ripclap/rm520n-carrier/manufacturing/rev-a/requirements/FAB_CURRENT_HOLE_COVER_REQUIREMENTS1248.txt

RM520N Carrier Rev A — fabrication/assembly requirements for the current physical board

Physical PCB SHA256: 1e1c08f8d13c7cdec4f65c9a95c2adc67a2a7758db29563f2e71c7588dd6bd23
Source: hardware/rev-a/carrier.kicad_pro
Use FAB_ALL1161_HOLE_SITE_SCHEDULE1243.csv, factory-site-schedule1248.json and mask-cover-owner1248.json with the matching Gerbers, drills, stack, assembly outputs and exact BOM. These are requested job/CAM acceptance conditions. No supplier has accepted the complete job. Final source-policy, finished-copper power and commissioning sign-off are separate from this physical schedule.

1. Actual drilling and covering
The current board contains 1,161 drilled sites: 1,124 vias, 24 solderable component PTHs, nine NPTHs, and four U10 EP49 thermal PTHs. The vias comprise 158 Type VII nonconductive filled holes with copper caps on both faces and 966 ordinary unfilled/uncapped continuous bilateral soldermask tents. The four U10 thermal PTHs separately require Type VII closed bilateral caps, 625 µm lands/300 µm nominal holes, their existing front EP49 solder interface, closed back mask and no back paste. KiCad pad metadata does not encode the thermal PTH fill/cap process. Do not treat component slots or NPTHs as ordinary vias, or resize/shift any site without a reviewed job revision.

2. Site-specific finished bores
The 81 nominal 150 µm vias are differentiated: 25 have 400 µm lands and requested finished bores 70–170 µm; 55 have 460 µm lands and 70–230 µm; one OE site has a 450 µm land and 70–220 µm. Retain the named ordinary 450/200 µm site profiles of finished 120–220 µm in the schedule. The sole new direct-V12 550/200 µm site 9ee37410-49af-5bbc-b978-d716eac22bde at (52.7,46.0) mm requests finished 120–280 µm. That bound does not apply to other nominal 200 µm sites.
For sites without a separately qualified interval, propose and record an exact compatible finished-bore, drilling, registration, etch and plating recipe. The public nominal ±80 µm values and the calculated 26 µm radial etch/35 µm registration corners are diagnostics, not an accepted blanket process or simultaneous supplier guarantee. Require actual finished annulus at least 50 µm on every copper layer, no breakout, and minimum LOCAL barrel plating wall 20 µm. Average wall thickness is insufficient. The electrical 18 µm sensitivity calculation is not the default fabrication requirement. Use representative microsections/coupons and complete electrical test. Preserve actual source conductors and return/reference planes when compensating artwork.

3. Coupled U4 VIN pair — mandatory exact local CAM recipe
Both sites remain Type VII filled and capped. First: 0b2860c5-bf78-44cb-b484-aeb19c71f110 at (60.20,72.85) mm, 450 µm land/200 µm nominal drill, requested finished 120–220 µm. Second: 1fd58c91-691e-4cd1-8f90-30b6df1de5e5 at (60.70,72.75) mm, 400 µm land/150 µm nominal drill, requested finished 70–170 µm.
The engineering coupled process witness requests each drill-position error ≤30 µm independently in X/Y, raw before-plating maximum diameters 250/200 µm respectively, and minimum local wall 20 µm. Achieved finished maximum diameters are then 210/160 µm, inside the requested intervals. Worst relative centre spacing is 441.815 µm; subtracting 225 µm raw radii leaves 216.815 µm raw web, above the 206 µm local guard. Obtain explicit supplier CAM/coupon acceptance of this complete coupled box and all-six-layer measured annuli. Generic doubled raw-tool envelopes overlap this pair and remain diagnostic; they are not the accepted witness. Preserve the U4 VIN6 front mask/paste interface and no back paste. TI RPU0010A has no positive minimum A1 standoff; qualify actual flat-cap solder seal, mask and underside seating rather than assuming 45 µm package clearance.

4. Actual mask, paste and underside interfaces
The four actual exported mask/paste layers are checked for all 1,124 vias. The 966 ordinary lands are nominally closed on both faces and paste-free. The 158 capped sites allow only their listed exact same-net owner-terminal apertures; there are no standalone via stencil windows or unowned apertures. Keep all existing solderable component apertures. Nominal Gerber closure is not proof of sealed covering after actual registration and reflow.
Type VII caps must be bilaterally closed, with qualified flatness/proudness at most 10 µm. Ordinary mask peaks and mask above caps must be at most 25 µm above the corresponding adjacent finished copper/cap. For a listed underbody cover, retain at least 10 µm actual clearance to the cover; an unknown/zero-standoff non-owner body requires measured underside clearance of at least 35 µm for ordinary mask or 45 µm for a 10 µm cap plus 25 µm mask. An actual solder-owner terminal instead requires its exact qualified flat-cap/solder-seal/stencil/seating contract, including the U4 pair above. Confirm actual front/back plastic, leads, seating and mask integrity. A body/courtyard projection is not itself a foreign-metal collision; mask or caps cannot waive foreign pad/copper/raw-bore gaps, annuli or source/reference conditions.

5. Ordinary large bores and raw-tool diagnostics
Exactly 155 of the original 166 prelisted ordinary Type VI fallback sites remain on this board; eleven were retired. All Type VI overrides remain INACTIVE. Accept ordinary tenting only with documented continuous bilateral cover under the actual bore, land, registration and reflow conditions. If the selected supplier cannot qualify a listed ordinary site, only an explicitly recorded UUID/job change may activate its nonconductive fill plus bilateral mask fallback; it does not add copper caps. Record the exact process/metadata change, preserve all physical/source constraints, re-export/review mask and paste, and verify flatness/underside seating. The original special large-bore Type VII sites retain their caps.
The seven ancestral special doubled raw-growth diagnostic pairs are listed in seven-raw-tool-rebind1248.json. Rebind their exact unchanged site/neighbor geometry to this board. Their nominal bores are distinct; the conservative envelope result is not a measured fabricated defect. Obtain actual correlated raw-drill/web and annular CAM/microsection acceptance. Covering does not remove this requirement. The U4 coupled pair has the separate explicit local recipe in section 3. Do not use the seven-row list as a census of every possible whole-board raw-tool diagnostic.

6. Meaningful retained copper and the two native warnings
Preserve all seven reinstated 1.5 mm In2 V12 force tracks from (40.75,44.25) through the existing chain to (11.15,45.9) mm. They maintain the required finished-copper input path under etch/bore limits; nominal connectivity through other layers does not replace that low-loss path.
The current native board has two warnings and zero errors/opens. The PASSIVE_BUCK_IN track 25bdecc5-6998-5fe8-9286-4277a934723d remains a real R727 damping collector. Its nominal hole-clipped overlap with the R727.1 PTH annulus is 0.301931584 mm², with two retained backbone contacts. The endpoint-centre warning is not an open circuit. Preserve its exact collector and the qualified R727 pulse/RC/hot-case commissioning requirements.
The second warning is an attached B.Cu OOB_VDD_SPI cleft near (76.316229,9.139837) mm, guarded by the exact three conductors in warning-dispositions1248.json. It is not a detached copper fragment or demonstrated limiting neck. Review final CAM/AOI for an unintended bridged cleft or foreign short, and test flash startup/ripple/firmware. Do not delete a relied conductor or treat the nominal geometry assessment as supplier etch acceptance.

7. Stack, controlled geometry and first article
Use the specified JLC06161H-3313 six-layer nominal 1.6 mm ENIG stack, preserving layer separation and actual reference planes. Main outer-layer geometry is USB 90 Ω width/gap 0.136/0.150 mm; PCIe/REFCLK 85 Ω 0.154/0.150 mm; MDI 100 Ω 0.104/0.150 mm. The exact CABLE48 cohort uses 0.2906 mm front-source width and 0.4483 mm inner/J1-terminal width with 0.5999 mm gap, assigned to its reviewed layers/groups. Keep actual launch and transition geometries. Requested ±10% impedance-coupon acceptance is not a current supplier guarantee. Do not substitute a stack or compensate geometry without review.
Use the matching FABRICATION_AND_ASSEMBLY and FIRST_ARTICLE_TEST instructions for exact fitted MPNs, H1/mechanical assembly, the passive-input contract, power/current/RMS/thermal qualification, modem recovery, USB/2.5G Ethernet/RF tests and firmware. Native DRC, nominal/reference continuity and qualified package spacing do not establish impedance/eye/BER/compliance, dynamic modem voltage, factory process capability or final functional survival.
