ripclap/rm520n-carrier/manufacturing/rev-a/assembly/Factory-BOM-unpriced.csv

MPN | Manufacturer | Qty per board | Design value | References | Side | Assembly | Native footprint | LCSC in design
GRM155R71C104KA88D | Murata | 5 | 100nF 16V X7R 10% | C36, C38, C42, C101, C102 | B, F | SMT | Capacitor_SMD:C_0402_1005Metric
CL10B225KP8NNNC | Samsung Electro-Mechanics | 18 | 2.2uF10V X7R10% | C32, C37, C39, C44, C45, C46, C47, C48, C49, C50, C51, C52, C54, C55, C56, C118, C119, C210 | B, F | SMT | Capacitor_SMD:C_0603_1608Metric; carrier:Samsung_CL10_0603_Dense100_50_890 | C100082
GRM1555C1H270JA01D | Murata | 2 | 27pF 50V C0G 5% | C40, C41 | F | SMT | Capacitor_SMD:C_0402_1005Metric
C0402C391J5GACTU | KEMET | 1 | 390pF 50V C0G 5% | C58 | B | SMT | Capacitor_SMD:C_0402_1005Metric
C0805C102JAGACTU | KEMET | 2 | 1nF250V C0G5% | C59, C414 | B, F | SMT | Capacitor_SMD:C_0805_2012Metric
RHA0J471MCN1GS | Nichicon | 1 | 470uF 6.3V polymer | C100 | F | SMT | carrier:Nichicon_RHA_8x6.7_FPCAP
25SVPK82M | Panasonic | 1 | 82uF 25V polymer | C201 | F | SMT | Capacitor_SMD:CP_Elec_6.3x5.9
CL21B105KBFNNNF | Samsung Electro-Mechanics | 4 | 1uF50V10%X7R | C203, C710, C713, C986 | F | SMT | Capacitor_SMD:C_0805_2012Metric | C16195091
C0805C103K1RACTU | KEMET | 2 | 10nF 100V X7R 10% | C202, C205 | B, F | SMT | Capacitor_SMD:C_0805_2012Metric; carrier:C_0805_2012Metric_DenseRevA_C205
C0402C102K5RACTU | KEMET | 2 | 1nF 50V X7R 10% | C206, C987 | B, F | SMT | Capacitor_SMD:C_0402_1005Metric
C0402C332K5RACTU | KEMET | 1 | 3.3nF 50V X7R 10% | C207 | F | SMT | Capacitor_SMD:C_0402_1005Metric
C0402C222K5RACTU | KEMET | 1 | 2.2nF 50V X7R 10% | C208 | F | SMT | Capacitor_SMD:C_0402_1005Metric
CL32B106KBJZW6E | Samsung Electro-Mechanics | 2 | 10uF 50V | C217, C218 | B | SMT | Capacitor_SMD:C_1210_3225Metric
CL32B476KPJNNWE | Samsung Electro-Mechanics | 2 | 47uF10V X7R10% | C219, C983 | B | SMT | Capacitor_SMD:C_1210_3225Metric; carrier:RevA_Dense100_50_C983
C0603C224K4RACTU | KEMET | 1 | 220nF 16V X7R 10% | C221 | B | SMT | Capacitor_SMD:C_0603_1608Metric
C0402C330J5GACTU | KEMET | 1 | 33pF 50V C0G 5% | C222 | F | SMT | Capacitor_SMD:C_0402_1005Metric
C0805C223K1RACTU | KEMET / YAGEO | 4 | 22nF 100V X7R 10% | C410, C411, C412, C413 | B | SMT | Capacitor_SMD:C_0805_2012Metric | C2178056
GRM188R72A104KA35D | Murata | 3 | 100nF100V | C541, C560, C720 | B, F | SMT | Capacitor_SMD:C_0603_1608Metric
GRM155R71E222KA01D | Murata | 3 | 2.2nF 25V | C19, C25, C563 | B, F | SMT | Capacitor_SMD:C_0402_1005Metric
CGA6N3X7R2A225K230AB | TDK | 6 | 2.2uF100V X7R10% | C700, C701, C702, C703, C704, C718 | B, F | SMT | Capacitor_SMD:C_1210_3225Metric
CL32B226KAJNNNE | Samsung Electro-Mechanics | 25 | 22uF25V X7R10% | C18, C22, C23, C24, C28, C29, C30, C31, C33, C43, C53, C57, C220, C223, C550, C551, C553, C554, C555, C561, C705, C706, C707, C708, C709 | B, F | SMT | Capacitor_SMD:C_1210_3225Metric | C309062
C0805C475K4RACTU | KEMET | 2 | 4.7uF16V10%X7R | C711, C982 | B, F | SMT | Capacitor_SMD:C_0805_2012Metric
C0402C220J5GACTU | KEMET | 1 | 22pF50V5%C0G | C716 | F | SMT | Capacitor_SMD:C_0402_1005Metric
GRM31C5C1H224JE02L | Murata | 1 | 220nF50VC0G5% | C721 | F | SMT | Input187:C1206
UHW2A330MPD | Nichicon | 1 | 33uF100V20%950mArms | C725 | F | THT | carrier:Nichicon_UHW2A330MPD_Radial_D8_P3.5
885012206026 | Wurth Elektronik | 3 | 1uF 10V X7R | C800, C805, C808 | B | SMT | Capacitor_SMD:C_0603_1608Metric
885012207026 | Wurth Elektronik | 3 | 10uF 10V X7R | C558, C806, C810 | B, F | SMT | Capacitor_SMD:C_0805_2012Metric
CL05B104KB5NNNC | Samsung Electro-Mechanics | 59 | 100nF 50V X7R10% | C20, C21, C26, C27, C34, C35, C110, C114, C115, C116, C117, C120, C121, C122, C123, C124, C125, C204, C209, C216, C225, C226, C552, C712, C741, C742, C745, C746, C747, C750, C751, C753, C760, C761, C762, C763, C764, C765, C766, C767, C801, C802, C803, C804, C807, C809, C811, C812, C813, C814, C817, C840, C902, C903, C906, C908, C984, C985, C989 | B, F | SMT | Capacitor_SMD:C_0402_1005Metric; carrier:C_0402_1005Metric_DenseRevA_C809; carrier:RevA_Dense100_50_C120 | C960916
KGM05ACG1H150FH | KYOCERA AVX | 2 | 15pF C0G 1% | C815, C816 | B | SMT | Capacitor_SMD:C_0402_1005Metric
GRM31C5C2A683JA01L | Murata | 1 | 68nF100VC0G5% | C988 | B | SMT | Input187:C1206
DABS2100-13 | Diodes Incorporated | 2 | DABS2100-13 100V2A Schottkybridge | D1, D2 | B | SMT | carrier:Diodes_DABS2100_ABS_4_SMD
SMBJ13A | Littelfuse | 1 | SMBJ13A | D6 | F | SMT | Diode_SMD:D_SMB
LTST-C190KGKT | Lite-On | 2 | LTST-C190KGKT green | D7, D210 | B, F | SMT | LED_SMD:LED_0603_1608Metric
MMSZ5240B-7-F | Diodes Incorporated | 1 | 10V gate clamp | D80 | F | SMT | Diode_SMD:D_SOD-123
LTST-C190KSKT | Lite-On | 1 | LTST-C190KSKT yellow | D211 | B | SMT | LED_SMD:LED_0603_1608Metric
SMCJ51A-E3/57T | Vishay | 2 | SMCJ51A51Vstandoff1500Wpulse | D700, D706 | B | SMT | Diode_SMD:D_SMC
BZT52C6V2-7-F | Diodes Incorporated | 1 | 6.2V Zener500mW | D701 | F | SMT | Diode_SMD:D_SOD-123
TVS0500DRVR | Texas Instruments | 1 | 5Vfloatinggate-sourceclamp | D704 | F | SMT | Input187:TI_DRV0006A_TVS0500_PRIMARY
S1B-13-F | Diodes Incorporated | 1 | 100V1AsiliconOUTnegativeclamp | D705 | F | SMT | carrier:Diodes_S1B_SMA_PRIMARY
F1206HI4000V032TM | AEM | 1 | 4A 32VDC high-inrush fuse | F1 | F | SMT | carrier:AEM_F1206HI_1206 | C246771
0451002.MRL | Littelfuse | 1 | 2A125V fast fuse | F700 | F | SMT | carrier:Littelfuse_451_6.1x2.69
BLM18PG330SN1D | Murata | 1 | 33R@100MHz 3A | FB1 | B | SMT | Inductor_SMD:L_0603_1608Metric
9774025243R | Würth Elektronik | 1 | M2 SMT support 2.5mm 9774025243R | H1 | F | SMT | carrier:Wurth_9774025243R_M2_H2p5
SS-7188S-A-NF | Stewart Connector / Cinch Connectivity Solutions | 1 | SS-7188S-A-NF shielded8P8C Cat5e | J1 | F | THT | carrier:Stewart_SS_7188S_A_NF_ComponentSideCorrected
B2B-XH-A(LF)(SN) | JST | 1 | DC 12V +/-5% 3A | J2 | F | THT | Connector_JST:JST_XH_B2B-XH-A_1x02_P2.50mm_Vertical
123A-42B02 | ATTEND Technology | 1 | 123A-42B02 KeyB4.2mm1A | J3 | F | SMT | carrier:M2_ATTEND_123A_42B02_CardMinusY
SIM8066-6-1-14-01-A | GCT | 1 | SIM8066-6-1-14-01-A | J4 | B | SMT | carrier:nanoSIM_GCT_SIM8066-6-1-14-01-A_RevB
TYPE-C-31-M-12 | HRO | 1 | TYPE-C-31-M-12 | J5 | F | SMT | carrier:USB_C_HRO_TYPE-C-31-M-12_20201208
U.FL-R-SMT-1(80) | Hirose | 1 | 915MHz antenna | J801 | F | SMT | carrier:UFL_HIROSE_DenseRevA_J801
DLW5BTM102TQ2L | Murata | 1 | DLW5BTM102TQ2L100V2Ahot | L700 | F | SMT | carrier:Murata_DLW5BTM102TQ2L_4_SMD
SRP1265A-220M | Bourns | 1 | 22uH20% shielded9Arms12AIsat | L701 | F | SMT | carrier:BOURNS_SRP1265A_LEAD_FRAME
SRP5030TA-2R2M | Bourns | 4 | 2.2uH 5.5A | L3, L4, L520, L702 | F | SMT | Inductor_SMD:L_Bourns_SRP5030T
LQW15AN24NH00D | Murata | 1 | 24nH ±3% | L800 | B | SMT | carrier:Murata_LQW15AN_0402_Manufacturer_DenseRevA_L800
SRP6030CA-2R2M | Bourns | 1 | 2.2uH 20% | L981 | B | SMT | carrier:RevA_Dense100_50_L981
DMPH3010LK3-13 | Diodes Incorporated | 1 | DMPH3010LK3-13 | Q1 | F | SMT | carrier:Diodes_TO252_DMPH3010LK3
PSMN015-100YLX | Nexperia | 1 | 100V5VlogicSOA_LFPAK56 | Q702 | F | SMT | Input187:NEXPERIA_LFPAK56_PRIMARY_AUDITED
NX3008NBK,215 | Nexperia | 3 | NX3008NBK,215 | Q740, Q742, Q746 | B | SMT | Package_TO_SOT_SMD:SOT-23; carrier:SOT-23_DenseRevA_Q746
RG1608N-682-W-T1 | Susumu | 1 | 6.8k 0.05% 10ppm | R18 | B | SMT | Resistor_SMD:R_0603_1608Metric
RN73R1ETTP9650B25 | KOA Speer Electronics | 1 | 965R 0.1% | R22 | B | SMT | Resistor_SMD:R_0402_1005Metric
TNPW04024K87BEED | Vishay | 1 | 4.87k 0.1% | R23 | B | SMT | Resistor_SMD:R_0402_1005Metric
CRCW0402100KFKED | Vishay | 17 | 100k | R24, R25, R39, R111, R118, R135, R231, R735, R736, R746, R750, R757, R777, R778, R808, R811, R812 | B, F | SMT | Resistor_SMD:R_0402_1005Metric
CRCW04021K00FKED | Vishay | 11 | 1k | R28, R40, R221, R740, R744, R766, R779, R780, R783, R840, R841 | B, F | SMT | Resistor_SMD:R_0402_1005Metric; carrier:RevA_Dense100_50_R779
CRCW040220K0FKED | Vishay | 3 | 20k | R32, R36, R800 | B, F | SMT | Resistor_SMD:R_0402_1005Metric
CRCW04025K10FKED | Vishay | 2 | 5.1k | R37, R38 | F | SMT | Resistor_SMD:R_0402_1005Metric
CRCW040215K0FKED | Vishay | 1 | 15k | R41 | B | SMT | Resistor_SMD:R_0402_1005Metric
CRCW04024K70FKED | Vishay | 4 | 4.7k | R42, R43, R44, R50 | F | SMT | Resistor_SMD:R_0402_1005Metric
CRCW0402510RFKED | Vishay | 2 | 510R | R47, R48 | B | SMT | Resistor_SMD:R_0402_1005Metric
RC1206FR-071ML | Yageo | 1 | 1M | R49 | F | SMT | Resistor_SMD:R_1206_3216Metric | C108083
RT0402BRD0711K3L | YAGEO | 1 | 11.3k0.1%25ppm | R112 | B | SMT | Resistor_SMD:R_0402_1005Metric
CRCW040210K0FKED | Vishay | 27 | 10k 1% | R26, R110, R116, R117, R126, R127, R128, R130, R131, R132, R136, R227, R228, R565, R566, R741, R745, R752, R755, R784, R801, R803, R804, R805, R806, R807, R809 | B, F | SMT | Resistor_SMD:R_0402_1005Metric; carrier:R_0402_1005Metric_DenseRevA_R784
RT0402BRD0764K9L | YAGEO | 1 | 64.9k 0.1% 25ppm | R119 | F | SMT | Resistor_SMD:R_0402_1005Metric | C852880
TNPW040210K0BEED | Vishay | 18 | 10k 0.1% | R21, R113, R120, R203, R205, R207, R210, R212, R214, R223, R552, R564, R761, R763, R765, R769, R781, R782 | B, F | SMT | Resistor_SMD:R_0402_1005Metric; carrier:RevA_Dense100_50_R769
CRCW04020000Z0ED | Vishay | 6 | 0R | R46, R121, R122, R123, R124, R125 | B, F | SMT | Resistor_SMD:R_0402_1005Metric
RC0402FR-073K6L | YAGEO | 1 | 3.6k 1% | R129 | B | SMT | Resistor_SMD:R_0402_1005Metric | C137990
RC0402FR-07130KL | YAGEO | 1 | 130k 1% | R134 | B | SMT | Resistor_SMD:R_0402_1005Metric | C93946
RT0402BRD07107KL | YAGEO | 2 | 107k 0.1% | R204, R211 | F | SMT | Resistor_SMD:R_0402_1005Metric
RT0402BRD0780K6L | YAGEO | 2 | 80.6k0.1%25ppm | R202, R206 | F | SMT | Resistor_SMD:R_0402_1005Metric; carrier:R_0402_1005Metric_DenseRevA_R206
RT0603BRD07953RL | YAGEO | 2 | 953ohm0.1%25ppm | R208, R747 | B, F | SMT | Resistor_SMD:R_0603_1608Metric; carrier:RevA_Dense100_50_R747
RT0402BRD0776K8L | YAGEO | 3 | 76.8k0.1%25ppm | R209, R213, R572 | B, F | SMT | Resistor_SMD:R_0402_1005Metric | C852913
TNPW04021K24BEED | Vishay | 1 | 1.24k 0.1% | R215 | F | SMT | Resistor_SMD:R_0402_1005Metric
RG1608N-392-W-T1 | Susumu | 1 | 3.9k 0.05% 10ppm | R216 | F | SMT | Resistor_SMD:R_0603_1608Metric
RG1608N-222-W-T1 | Susumu | 2 | 2.2k 0.05% 10ppm | R19, R217 | B, F | SMT | Resistor_SMD:R_0603_1608Metric
RC0402FR-07240RL | YAGEO | 1 | 240ohm 1% | R218 | B | SMT | Resistor_SMD:R_0402_1005Metric
CRCW04021M00FKED | Vishay | 2 | 1M 1% | R220, R756 | B, F | SMT | Resistor_SMD:R_0402_1005Metric
RT0402BRD0757K6L | YAGEO | 1 | 57.6k 0.1% 25ppm | R222 | F | SMT | Resistor_SMD:R_0402_1005Metric
CRCW040218K2FKED | Vishay | 2 | 18.2k 1% | R225, R226 | B, F | SMT | Resistor_SMD:R_0402_1005Metric
CRCW0402150KFKED | Vishay | 1 | 150k 1% | R229 | F | SMT | Resistor_SMD:R_0402_1005Metric
CRCW080575R0FKEA | Vishay | 4 | 75R 1% | R410, R411, R412, R413 | B | SMT | Resistor_SMD:R_0805_2012Metric
RT0402BRD0717K4L | YAGEO | 1 | 17.4k 0.1% 25ppm | R551 | B | SMT | Resistor_SMD:R_0402_1005Metric
RT0603BRD072K26L | YAGEO | 1 | 2.26k0.1%25ppm | R553 | B | SMT | Resistor_SMD:R_0603_1608Metric
RC0603FR-0718K2L | YAGEO | 1 | 18.2k 1% | R560 | B | SMT | Resistor_SMD:R_0603_1608Metric
RC0603FR-071KL | YAGEO | 1 | 1k1% | R700 | F | SMT | Resistor_SMD:R_0603_1608Metric
RC0603FR-0716KL | YAGEO | 1 | 16k1%100ppm | R702 | F | SMT | Resistor_SMD:R_0603_1608Metric
RT0603BRD07140KL | YAGEO | 1 | 140k0.1%25ppm | R703 | F | SMT | Resistor_SMD:R_0603_1608Metric
RT0603BRD0793K1L | YAGEO | 1 | 93.1k0.1%25ppm | R708 | F | SMT | Resistor_SMD:R_0603_1608Metric
RT0603BRD074K99L | YAGEO | 1 | 4.99k0.1%25ppm | R709 | F | SMT | Resistor_SMD:R_0603_1608Metric
L4CL1206LR050DNR-A | Littelfuse | 1 | 50mOhm0.5%four-terminal1206 | R720 | B | SMT | carrier:Littelfuse_L4CL1206_A_PRIMARY
RT0603BRD0768KL | YAGEO | 1 | 68k0.1%25ppm | R721 | F | SMT | Resistor_SMD:R_0603_1608Metric
RT0402BRD07301RL | YAGEO | 1 | 301ohm0.1%25ppm | R722 | F | SMT | Resistor_SMD:R_0402_1005Metric
TNPW0603100KBEEA | Vishay | 1 | 100k0.1%25ppm75V | R723 | B | SMT | Resistor_SMD:R_0603_1608Metric
RT0402BRD071KL | YAGEO | 1 | 1k0.1%25ppm | R724 | F | SMT | Resistor_SMD:R_0402_1005Metric
RT0603BRD0710KL | YAGEO | 3 | 10k0.1%25ppm | R562, R704, R725 | B, F | SMT | Resistor_SMD:R_0603_1608Metric
RC0603FR-0710RL | YAGEO | 1 | 10ohm1% | R726 | F | SMT | Resistor_SMD:R_0603_1608Metric
AC01000004708JA100 | Vishay | 1 | 4.7ohm5%1Wpulsewirewound | R727 | F | THT | carrier:Vishay_AC01_P17_8_PRIMARY
RT0603BRD0732K4L | YAGEO | 2 | 32.4k0.1%25ppm | R561, R730 | B, F | SMT | Resistor_SMD:R_0603_1608Metric | C861323
CRCW0402100RFKED | Vishay | 4 | 100ohm1% | R731, R767, R786, R987 | B, F | SMT | Resistor_SMD:R_0402_1005Metric; carrier:R_0402_1005Metric_DenseRevA_R731; carrier:RevA_Dense100_50_R786; carrier:RevA_Dense100_50_R987
RC0603FR-0710KL | YAGEO | 4 | 10k 1% | R554, R563, R573, R734 | B, F | SMT | Resistor_SMD:R_0603_1608Metric
CRCW12063K30FKEAHP | Vishay | 1 | 3.3k1%HP1206 | R737 | B | SMT | Input187:R1206
RT0402BRD0782K5L | YAGEO | 2 | 82.5k0.1%25ppm | R20, R754 | B | SMT | Resistor_SMD:R_0402_1005Metric
TNPW0402100KBEED | Vishay | 3 | 100k | R760, R762, R764 | B, F | SMT | Resistor_SMD:R_0402_1005Metric
RT0603BRD0727KL | YAGEO | 1 | 27k 0.1% 25ppm | R768 | B | SMT | carrier:RevA_Dense100_50_R768
CRCW04022K49FKED | Vishay | 3 | 2.49k 1% 0402 | R45, R775, R776 | B | SMT | Resistor_SMD:R_0402_1005Metric
CRCW0402499RFKED | Vishay | 1 | 499 | R802 | B | SMT | Resistor_SMD:R_0402_1005Metric
RC0402FR-071K8L | Yageo | 1 | 1.8k 1% | R814 | B | SMT | Resistor_SMD:R_0402_1005Metric | C163481
CRCW0402150RFKED | Vishay Dale | 1 | 150ohm 1% 100ppm MISO source damping | R825 | B | SMT | Resistor_SMD:R_0402_1005Metric
CRCW040222R0FKED | Vishay | 9 | 22R | R29, R30, R31, R33, R34, R35, R826, R827, R828 | B, F | SMT | Resistor_SMD:R_0402_1005Metric; carrier:R_0402_1005Metric_DenseRevA_R34; carrier:RevA_DensePrimary100_PIN50_R826
B3U-1000P | Omron | 2 | RESET 400ms | SW1, SW2 | F | SMT | Button_Switch_SMD:SW_SPST_B3U-1000P
MP4583GQVE-Z | Monolithic Power Systems | 1 | MP4583GQVE-Z 100V 3A synchronous 12V buck | U1 | F | SMT | carrier:MPS_MP4583_QFN19_3x5_PRIMARY
MP2329GG-P | Monolithic Power Systems | 1 | MP2329GG-P 24V 6.5A buck, 4.056V REG | U3 | B | SMT | carrier:MPS_MP2386_QFN11_2x2
TPS62912RPUR | Texas Instruments | 3 | TPS62912RPUR | U4, U5, U520 | F | SMT | carrier:TI_RPU0010A_TPS62912
TPD4E1U06DBVR | Texas Instruments | 1 | TPD4E1U06DBVR | U7 | B | SMT | Package_TO_SOT_SMD:SOT-23-6
ST4SI3M004600HFW | STMicroelectronics | 1 | ST4SIM-300M SGP.32 experimental population | U8 | F | SMT | carrier:ST_ST4SI3M004600HFW_MFF2_ETSI
USBLC6-2P6 | STMicroelectronics | 1 | USBLC6-2P6 | U9 | F | SMT | carrier:USBLC6-2P6_ST_SOT666 | C15999
RTL8125BG-CG | Realtek | 1 | RTL8125BG-CG | U10 | F | SMT | carrier:TQFN-48_L6.0-W6.0-P0.40-BL-EP4.5_RevA_EP625_890_Heatsink1090 | C3013605
TPS3808G01DBVR | Texas Instruments | 2 | TPS3808G01DBVR | U12, U16 | B | SMT | Package_TO_SOT_SMD:SOT-23-6
AT93C46DN-SH-T | Microchip | 1 | AT93C46DN-SH-T | U13 | F | SMT | Package_SO:SOIC-8_3.9x4.9mm_P1.27mm
SN74LVC1G97DBVR | Texas Instruments | 3 | SN74LVC1G97DBVR | U15, U26, U33 | B, F | SMT | Package_TO_SOT_SMD:SOT-23-6
SN74LVC1G08DBVR | Texas Instruments | 2 | SN74LVC1G08DBVR | U17, U36 | B, F | SMT | Package_TO_SOT_SMD:SOT-23-5
TPD1E05U06DPYR | Texas Instruments | 3 | TPD1E05U06DPYR | U14, U19, U20 | B, F | SMT | Package_SON:Texas_DPY0002A_0.6x1mm_P0.65mm
TPS259474LRPWR | Texas Instruments | 2 | TPS259474LRPWR | U21, U986 | B, F | SMT | carrier:TI_RPW0010A_TPS25947
TPS259474ARPWR | Texas Instruments | 1 | TPS259474ARPWR | U22 | F | SMT | carrier:TI_RPW0010A_TPS25947
TPS389001DSER | Texas Instruments | 1 | TPS389001DSER | U29 | F | SMT | carrier:TI_DSE6_TPS3890_1p5x1p5_Manufacturer
SN74AUP1G17DBVR | Texas Instruments | 1 | SN74AUP1G17DBVR | U30 | F | SMT | Package_TO_SOT_SMD:SOT-23-5
TPS7A2033PDBVR | Texas Instruments | 1 | TPS7A2033PDBVR | U31 | B | SMT | Package_TO_SOT_SMD:SOT-23-5
TMUX1511PWR | Texas Instruments | 3 | TMUX1511PWR | U32, U34, U748 | B, F | SMT | Package_SO:TSSOP-14_4.4x5mm_P0.65mm
TLV7011DBVR | Texas Instruments | 1 | TLV7011DBVR | U35 | B | SMT | Package_TO_SOT_SMD:SOT-23-5
H2414QR | E-NETTR (Dongguan Xiangxing Electronics) | 1 | H2414QR 2.5/5G 1A PoE capability, engineering prototype | U40 | F | SMT | carrier:ENETTR_H2414QR_24_SMD_Manufacturer | C4155001
TPS2553DBVR-1 | Texas Instruments | 1 | TPS2553DBVR-1 latched radio power | U523 | B | SMT | Package_TO_SOT_SMD:SOT-23-6 | C111738
TPS2490DGSR | Texas Instruments | 1 | TPS2490 latched high-voltage hot-swap | U700 | F | SMT | carrier:TI_DGS0010A_TPS2490_PRIMARY
SN74LVC1G00DBVR | Texas Instruments | 2 | SN74LVC1G00DBVR radio OE guard | U742, U774 | B | SMT | Package_TO_SOT_SMD:SOT-23-5 | C7826
SN74LVC3G17DCUR | Texas Instruments | 1 | SN74LVC3G17DCUR | U749 | B | SMT | carrier:TI_DCU8_LVC3G17
TMP102AIDRLR | Texas Instruments | 1 | TMP102AIDRLR | U752 | B | SMT | carrier:SOT563_TMP102
TPS3808G33DBVR | Texas Instruments | 1 | TPS3808G33DBVR radio PG | U756 | B | SMT | Package_TO_SOT_SMD:SOT-23-6 | C43698
SN74LVC1G04DBVR | Texas Instruments | 1 | SN74LVC1G04DBVR | U770 | B | SMT | Package_TO_SOT_SMD:SOT-23-5
SN74LVC1G11DBVR | Texas Instruments | 3 | SN74LVC1G11DBVR | U522, U531, U771 | B | SMT | Package_TO_SOT_SMD:SOT-23-6
SN74LVC1G32DBVR | Texas Instruments | 1 | SN74LVC1G32DBVR | U776 | B | SMT | Package_TO_SOT_SMD:SOT-23-5
ESP32-S3FN8 | Espressif | 1 | ESP32-S3FN8 USB FS host | U800 | B | SMT | carrier:ESP32_S3FN8_QFN56
E22-900MM22S | Chengdu Ebyte Electronic Technology | 1 | E22-900MM22S SPI 850-930MHz crystal | U801 | F | SMT | carrier:Ebyte_E22_900MM22S_10x10_20Pad_DenseRevA_U801 | C5333985
SN74AXC8T245PWR | Texas Instruments | 1 | SN74AXC8T245PWR dual-rail radio isolation | U802 | F | SMT | carrier:RevA_DensePrimary100_PIN50_Flash_U802 | C882718
FSUSB42UMX | onsemi | 1 | FSUSB42UMX USB2 service/OOB ownership mux | U803 | B | SMT | carrier:FSUSB42_UQFN10_1p4x1p8 | C11145
TPS3435CAKAGDDFR | Texas Instruments | 1 | Independent1.6s watchdog200msreset | U804 | B | SMT | carrier:TI_DDF8_TPS3435 | C6339182
SN74LVC2G125DCUR | Texas Instruments | 1 | OOB UART powered-off-safe dual buffer | U805 | B | SMT | carrier:TI_DCU8_LVC2G125
NCA9536DQJ | Nexperia | 1 | NCA9536DQJ I2C status | U840 | B | SMT | carrier:Nexperia_SOT505_3_Primary
TPS3700DDCR | Texas Instruments | 1 | Precise UV/OV window detector | U987 | F | SMT | carrier:TI_DDC0006A_PRIMARY | C33002
ABM8-25.000MHZ-D1X-T | Abracon | 1 | 25MHz CL18pF 10/20ppm | Y1 | F | SMT | carrier:Crystal_ABM8_Abracon_3.2x2.5
ABM8-40.000MHZ-10-D1G-T | Abracon | 1 | 40MHz CL10pF35ohm | Y800 | B | SMT | carrier:Abracon_ABM8_3225_DenseRevA_Y800 | C1986736
