ripclap/rm520n-carrier/manufacturing/rev-a/requirements/FAB_ALL1161_HOLE_SITE_SCHEDULE1243.csv

UUID | kind | Ref | Pin | Net | X_mm | Y_mm | Nominal_hole_x_mm | Nominal_hole_y_mm | Land_x_mm | Land_y_mm | Plated | Default_cover | Native_front_tent | Native_back_tent | Native_fill | Native_cap | Exact_named_finished_bounds_mm | Finished_bounds_basis | All_six_measured_annulus_min_um | Minimum_local_plated_wall_um | TypeVI_fallback_eligible | TypeVI_override_active | Cap_or_fill_proudness_max_um | Mask_peak_above_copper_or_cap_max_um | Required_actual_underside_above_adjacentCu_um | Required_remaining_underside_gap_um | Actual_mask_owner_and_stencil_requirements | Factory_accepted
000fbebc-b84a-4751-981c-541ab52dd05d | VIA |  |  | GND | 20.25 | 72.625 | 0.3 | 0.3 | 0.55 | 0.55 | True | Ordinary_continuous_bilateral_soldermask_tent_unfilled_uncapped | yes | yes | no | no |  | No blanket selected job; supplier must propose compatible exact finished-bore/ring/web profile and obtain recorded job acceptance | 50 | 20 | True | False | 10 | 25 | 35 | 10 | Final actual four mask/paste exports; closed bore seal required, no independent via stencil; only exact qualified same-terminal apertures may overlap TypeVII caps | False
001c628c-2e7e-5275-b3de-595716c1cfc6 | VIA |  |  | GND | 64.5 | 68.85 | 0.4 | 0.4 | 0.8 | 0.8 | True | Ordinary_continuous_bilateral_soldermask_tent_unfilled_uncapped | yes | yes | no | no |  | No blanket selected job; supplier must propose compatible exact finished-bore/ring/web profile and obtain recorded job acceptance | 50 | 20 | True | False | 10 | 25 | 35 | 10 | Final actual four mask/paste exports; closed bore seal required, no independent via stencil; only exact qualified same-terminal apertures may overlap TypeVII caps | False
0047f12d-db32-5cc8-8f5d-c2d3e408a79c | VIA |  |  | OOB_USB_MUX_DISABLE | 5.55 | 69.6 | 0.15 | 0.15 | 0.46 | 0.46 | True | Ordinary_continuous_bilateral_soldermask_tent_unfilled_uncapped | yes | yes | no | no | [0.07,0.23] | Actual81 differentiated nominal150 cohort: land400 max170, land460 max230, OE450 max220; measured all-six ring/no breakout and exact CAM acceptance required | 50 | 20 | False | False |  | 25 |  |  | Final actual four mask/paste exports; closed bore seal required, no independent via stencil; only exact qualified same-terminal apertures may overlap TypeVII caps | False
0090d851-3b8d-5924-b448-6feb09b4d793 | VIA |  |  | GND | 56.95 | 38.74 | 0.2 | 0.2 | 0.45 | 0.45 | True | Ordinary_continuous_bilateral_soldermask_tent_unfilled_uncapped | yes | yes | no | no |  | No blanket selected job; supplier must propose compatible exact finished-bore/ring/web profile and obtain recorded job acceptance | 50 | 20 | False | False |  | 25 | 35 | 10 | Final actual four mask/paste exports; closed bore seal required, no independent via stencil; only exact qualified same-terminal apertures may overlap TypeVII caps | False
01783f63-f96d-5b7b-ab28-b04bfb808d14 | VIA |  |  | GND | 70.51 | 48.7 | 0.3 | 0.3 | 0.6 | 0.6 | True | Ordinary_continuous_bilateral_soldermask_tent_unfilled_uncapped | yes | yes | no | no |  | No blanket selected job; supplier must propose compatible exact finished-bore/ring/web profile and obtain recorded job acceptance | 50 | 20 | True | False | 10 | 25 | 35 | 10 | Final actual four mask/paste exports; closed bore seal required, no independent via stencil; only exact qualified same-terminal apertures may overlap TypeVII caps | False
01a03bb2-a3cd-5df0-bf77-50cff7916a8c | VIA |  |  | GND | 60.725 | 60.75 | 0.3 | 0.3 | 0.6 | 0.6 | True | Ordinary_continuous_bilateral_soldermask_tent_unfilled_uncapped | yes | yes | no | no |  | No blanket selected job; supplier must propose compatible exact finished-bore/ring/web profile and obtain recorded job acceptance | 50 | 20 | False | False |  | 25 |  |  | Final actual four mask/paste exports; closed bore seal required, no independent via stencil; only exact qualified same-terminal apertures may overlap TypeVII caps | False
01af4902-4b6b-56b5-a70c-650402054faa | VIA |  |  | EE_VDD | 57.18 | 69.52 | 0.2 | 0.2 | 0.45 | 0.45 | True | Ordinary_continuous_bilateral_soldermask_tent_unfilled_uncapped | yes | yes | no | no | [0.12,0.22] | Retained discrete bounded ordinary200 profile: EE717; fab acceptance required | 50 | 20 | False | False |  | 25 | 35 | 10 | Final actual four mask/paste exports; closed bore seal required, no independent via stencil; only exact qualified same-terminal apertures may overlap TypeVII caps | False
01bad5a4-8d41-5af8-8fc7-c24572d932ab | VIA |  |  | OOB_USB_SESSION_VALID | 22.0278 | 86.0153 | 0.2 | 0.2 | 0.45 | 0.45 | True | Ordinary_continuous_bilateral_soldermask_tent_unfilled_uncapped | yes | yes | no | no |  | No blanket selected job; supplier must propose compatible exact finished-bore/ring/web profile and obtain recorded job acceptance | 50 | 20 | False | False |  | 25 |  |  | Final actual four mask/paste exports; closed bore seal required, no independent via stencil; only exact qualified same-terminal apertures may overlap TypeVII caps | False
02a1a064-2da4-4691-9920-c1c9ad54220f | VIA |  |  | VDC_IN | 51.65 | 8.199999 | 0.25 | 0.25 | 0.5 | 0.5 | True | Ordinary_continuous_bilateral_soldermask_tent_unfilled_uncapped | yes | yes | no | no |  | No blanket selected job; supplier must propose compatible exact finished-bore/ring/web profile and obtain recorded job acceptance | 50 | 20 | True | False | 10 | 25 |  |  | Final actual four mask/paste exports; closed bore seal required, no independent via stencil; only exact qualified same-terminal apertures may overlap TypeVII caps | False
02f0de56-3f43-5857-9972-8bf27dbf8ea5 | VIA |  |  | OOB_AUX12_SCALED | 55.45 | 30.4 | 0.2 | 0.2 | 0.45 | 0.45 | True | Ordinary_continuous_bilateral_soldermask_tent_unfilled_uncapped | yes | yes | no | no |  | No blanket selected job; supplier must propose compatible exact finished-bore/ring/web profile and obtain recorded job acceptance | 50 | 20 | False | False |  | 25 |  |  | Final actual four mask/paste exports; closed bore seal required, no independent via stencil; only exact qualified same-terminal apertures may overlap TypeVII caps | False
031433fb-306b-5dfb-b312-501556b445ec | VIA |  |  | OOB_USB_MUX_SELECT | 38.35 | 63.9 | 0.3 | 0.3 | 0.625 | 0.625 | True | Ordinary_continuous_bilateral_soldermask_tent_unfilled_uncapped | yes | yes | no | no |  | No blanket selected job; supplier must propose compatible exact finished-bore/ring/web profile and obtain recorded job acceptance | 50 | 20 | False | False |  | 25 |  |  | Final actual four mask/paste exports; closed bore seal required, no independent via stencil; only exact qualified same-terminal apertures may overlap TypeVII caps | False
03199b17-0a25-5950-9f69-e2742c3602d5 | VIA |  |  | BUCK_UVLO | 81.5 | 60.0 | 0.2 | 0.2 | 0.4 | 0.4 | True | Ordinary_continuous_bilateral_soldermask_tent_unfilled_uncapped | yes | yes | no | no |  | No blanket selected job; supplier must propose compatible exact finished-bore/ring/web profile and obtain recorded job acceptance | 50 | 20 | False | False |  | 25 | 35 | 10 | Final actual four mask/paste exports; closed bore seal required, no independent via stencil; only exact qualified same-terminal apertures may overlap TypeVII caps | False
0369a606-4dd3-556d-83ab-7a7463615342 | VIA |  |  | EE_CS | 40.4427 | 54.4314 | 0.2 | 0.2 | 0.45 | 0.45 | True | Ordinary_continuous_bilateral_soldermask_tent_unfilled_uncapped | yes | yes | no | no |  | No blanket selected job; supplier must propose compatible exact finished-bore/ring/web profile and obtain recorded job acceptance | 50 | 20 | False | False |  | 25 | 35 | 10 | Final actual four mask/paste exports; closed bore seal required, no independent via stencil; only exact qualified same-terminal apertures may overlap TypeVII caps | False
038179bd-7378-5e60-95e8-40223a4c6c5c | VIA |  |  | BUCK_UVLO | 80.1 | 40.1 | 0.2 | 0.2 | 0.4 | 0.4 | True | Ordinary_continuous_bilateral_soldermask_tent_unfilled_uncapped | yes | yes | no | no |  | No blanket selected job; supplier must propose compatible exact finished-bore/ring/web profile and obtain recorded job acceptance | 50 | 20 | False | False |  | 25 |  |  | Final actual four mask/paste exports; closed bore seal required, no independent via stencil; only exact qualified same-terminal apertures may overlap TypeVII caps | False
03ac9e27-e8ac-5740-a422-52281d2affb4 | VIA |  |  | VC4 | 101.2 | 88.0 | 0.2 | 0.2 | 0.45 | 0.45 | True | Ordinary_continuous_bilateral_soldermask_tent_unfilled_uncapped | yes | yes | no | no |  | No blanket selected job; supplier must propose compatible exact finished-bore/ring/web profile and obtain recorded job acceptance | 50 | 20 | False | False |  | 25 | 35 | 10 | Final actual four mask/paste exports; closed bore seal required, no independent via stencil; only exact qualified same-terminal apertures may overlap TypeVII caps | False
03f21859-37f8-5d06-b794-a7ffc21a5aa4 | VIA |  |  | RTL_TX_N | 49.4 | 84.5 | 0.2 | 0.2 | 0.4 | 0.4 | True | Ordinary_continuous_bilateral_soldermask_tent_unfilled_uncapped | yes | yes | no | no |  | No blanket selected job; supplier must propose compatible exact finished-bore/ring/web profile and obtain recorded job acceptance | 50 | 20 | False | False |  | 25 |  |  | Final actual four mask/paste exports; closed bore seal required, no independent via stencil; only exact qualified same-terminal apertures may overlap TypeVII caps | False
041c7147-62e9-5025-92ad-6fe28042242a | VIA |  |  | LEDY_K | 63.8 | 57.0 | 0.2 | 0.2 | 0.45 | 0.45 | True | Ordinary_continuous_bilateral_soldermask_tent_unfilled_uncapped | yes | yes | no | no |  | No blanket selected job; supplier must propose compatible exact finished-bore/ring/web profile and obtain recorded job acceptance | 50 | 20 | False | False |  | 25 |  |  | Final actual four mask/paste exports; closed bore seal required, no independent via stencil; only exact qualified same-terminal apertures may overlap TypeVII caps | False
045577a4-2745-424b-899e-bc0574867567 | VIA |  |  | GND | 60.537219 | 74.764702 | 0.3 | 0.3 | 0.55 | 0.55 | True | Ordinary_continuous_bilateral_soldermask_tent_unfilled_uncapped | yes | yes | no | no |  | No blanket selected job; supplier must propose compatible exact finished-bore/ring/web profile and obtain recorded job acceptance | 50 | 20 | True | False | 10 | 25 | 35 | 10 | Final actual four mask/paste exports; closed bore seal required, no independent via stencil; only exact qualified same-terminal apertures may overlap TypeVII caps | False
047bf3af-5124-5f20-bb47-56d08c69e3ec | VIA |  |  | VC1 | 100.2 | 76.6 | 0.2 | 0.2 | 0.45 | 0.45 | True | Ordinary_continuous_bilateral_soldermask_tent_unfilled_uncapped | yes | yes | no | no |  | No blanket selected job; supplier must propose compatible exact finished-bore/ring/web profile and obtain recorded job acceptance | 50 | 20 | False | False |  | 25 |  |  | Final actual four mask/paste exports; closed bore seal required, no independent via stencil; only exact qualified same-terminal apertures may overlap TypeVII caps | False
049c253f-943d-512e-bc24-b7981480242d | VIA |  |  | AON_PG | 104.45 | 24.525 | 0.2 | 0.2 | 0.45 | 0.45 | True | Ordinary_continuous_bilateral_soldermask_tent_unfilled_uncapped | yes | yes | no | no |  | No blanket selected job; supplier must propose compatible exact finished-bore/ring/web profile and obtain recorded job acceptance | 50 | 20 | False | False |  | 25 | 35 | 10 | Final actual four mask/paste exports; closed bore seal required, no independent via stencil; only exact qualified same-terminal apertures may overlap TypeVII caps | False
04a52fc2-15aa-575d-bfb1-0087f74d8f26 | VIA |  |  | OOB_ADC_MODEM_VCC | 56.4625 | 33.65 | 0.2 | 0.2 | 0.45 | 0.45 | True | Ordinary_continuous_bilateral_soldermask_tent_unfilled_uncapped | yes | yes | no | no |  | No blanket selected job; supplier must propose compatible exact finished-bore/ring/web profile and obtain recorded job acceptance | 50 | 20 | False | False |  | 25 |  |  | Final actual four mask/paste exports; closed bore seal required, no independent via stencil; only exact qualified same-terminal apertures may overlap TypeVII caps | False
04e6464d-af7d-432a-9115-3a876301ad81 | VIA |  |  | EE_VDD | 54.45 | 66.344999 | 0.3 | 0.3 | 0.55 | 0.55 | True | Ordinary_continuous_bilateral_soldermask_tent_unfilled_uncapped | yes | yes | no | no |  | No blanket selected job; supplier must propose compatible exact finished-bore/ring/web profile and obtain recorded job acceptance | 50 | 20 | True | False | 10 | 25 | 35 | 10 | Final actual four mask/paste exports; closed bore seal required, no independent via stencil; only exact qualified same-terminal apertures may overlap TypeVII caps | False
0566482a-63c2-5bdf-947b-8090f8628a66 | VIA |  |  | MODEM_PG | 13.6 | 60.95 | 0.2 | 0.2 | 0.55 | 0.55 | True | Ordinary_continuous_bilateral_soldermask_tent_unfilled_uncapped | yes | yes | no | no |  | No blanket selected job; supplier must propose compatible exact finished-bore/ring/web profile and obtain recorded job acceptance | 50 | 20 | False | False |  | 25 |  |  | Final actual four mask/paste exports; closed bore seal required, no independent via stencil; only exact qualified same-terminal apertures may overlap TypeVII caps | False
05829d2f-a3e7-5ed1-9371-f316fa358817 | VIA |  |  | PCIE_TX_N | 24.5 | 75.7 | 0.2 | 0.2 | 0.45 | 0.45 | True | Ordinary_continuous_bilateral_soldermask_tent_unfilled_uncapped | yes | yes | no | no |  | No blanket selected job; supplier must propose compatible exact finished-bore/ring/web profile and obtain recorded job acceptance | 50 | 20 | False | False |  | 25 |  |  | Final actual four mask/paste exports; closed bore seal required, no independent via stencil; only exact qualified same-terminal apertures may overlap TypeVII caps | False
05fe3131-5799-5107-a974-3c80ecdea752 | VIA |  |  | POWER_OK | 19.3 | 12.3 | 0.2 | 0.2 | 0.45 | 0.45 | True | Ordinary_continuous_bilateral_soldermask_tent_unfilled_uncapped | yes | yes | no | no | [0.12,0.22] | Exact five POWER976 ordinary450/200 profile: finished120..220um/localwall20um; selected factory CAM/coupon acceptance required, not a blanket200 profile | 50 | 20 | False | False |  | 25 | 35 | 10 | Final actual four mask/paste exports; closed bore seal required, no independent via stencil; only exact qualified same-terminal apertures may overlap TypeVII caps | False
06fba0d0-480a-5a7d-919c-f9b28ba410c2 | VIA |  |  | OOB_SCONF | 105.9 | 21.9 | 0.2 | 0.2 | 0.4 | 0.4 | True | TypeVII_full_nonconductive_fill_bilateral_copper_cap | inherit | inherit | yes | yes |  | No blanket selected job; supplier must propose compatible exact finished-bore/ring/web profile and obtain recorded job acceptance | 50 | 20 | False | False | 10 | 25 | 45 | 10 | Final actual four mask/paste exports; closed bore seal required, no independent via stencil; only exact qualified same-terminal apertures may overlap TypeVII caps | False
07465415-783a-5368-b702-76ea3a53af33 | VIA |  |  | GND | 4.7 | 52.7 | 0.3 | 0.3 | 0.6 | 0.6 | True | Ordinary_continuous_bilateral_soldermask_tent_unfilled_uncapped | yes | yes | no | no |  | No blanket selected job; supplier must propose compatible exact finished-bore/ring/web profile and obtain recorded job acceptance | 50 | 20 | True | False | 10 | 25 | 35 | 10 | Final actual four mask/paste exports; closed bore seal required, no independent via stencil; only exact qualified same-terminal apertures may overlap TypeVII caps | False
0750ba48-38fb-5c64-b5b4-323b617d3f4b | VIA |  |  | CABLE_PWR_N | 98.43 | 88.16 | 0.3 | 0.3 | 0.6 | 0.6 | True | Ordinary_continuous_bilateral_soldermask_tent_unfilled_uncapped | yes | yes | no | no |  | No blanket selected job; supplier must propose compatible exact finished-bore/ring/web profile and obtain recorded job acceptance | 50 | 20 | True | False | 10 | 25 | 35 | 10 | Final actual four mask/paste exports; closed bore seal required, no independent via stencil; only exact qualified same-terminal apertures may overlap TypeVII caps | False
0766acd2-add2-5a9f-93e9-1d00d3c39772 | VIA |  |  | MODEM_EFUSE_DVDT | 14.5 | 63.7 | 0.15 | 0.15 | 0.4 | 0.4 | True | TypeVII_full_nonconductive_fill_bilateral_copper_cap | inherit | inherit | yes | yes | [0.07,0.17] | Actual81 differentiated nominal150 cohort: land400 max170, land460 max230, OE450 max220; measured all-six ring/no breakout and exact CAM acceptance required | 50 | 20 | False | False | 10 | 25 | 45 | 10 | Final actual four mask/paste exports; closed bore seal required, no independent via stencil; only exact qualified same-terminal apertures may overlap TypeVII caps | False
0794cc06-0eec-43dc-bcc1-8e98aafe907c | VIA |  |  | GND | 58.11 | 80.55 | 0.2 | 0.2 | 0.4 | 0.4 | True | TypeVII_full_nonconductive_fill_bilateral_copper_cap | inherit | inherit | yes | yes |  | No blanket selected job; supplier must propose compatible exact finished-bore/ring/web profile and obtain recorded job acceptance | 50 | 20 | False | False | 10 | 25 | 45 | 10 | Final actual four mask/paste exports; closed bore seal required, no independent via stencil; only exact qualified same-terminal apertures may overlap TypeVII caps | False
07cdb2e4-9146-5839-bdb8-a2f4ec83a37e | VIA |  |  | RTL_ISOLATE | 49.8 | 94.3 | 0.2 | 0.2 | 0.45 | 0.45 | True | Ordinary_continuous_bilateral_soldermask_tent_unfilled_uncapped | yes | yes | no | no |  | No blanket selected job; supplier must propose compatible exact finished-bore/ring/web profile and obtain recorded job acceptance | 50 | 20 | False | False |  | 25 |  |  | Final actual four mask/paste exports; closed bore seal required, no independent via stencil; only exact qualified same-terminal apertures may overlap TypeVII caps | False
07fff03d-2256-5b98-bfa2-9ce441caac32 | VIA |  |  | GND | 20.45 | 43.55 | 0.2 | 0.2 | 0.45 | 0.45 | True | Ordinary_continuous_bilateral_soldermask_tent_unfilled_uncapped | yes | yes | no | no |  | No blanket selected job; supplier must propose compatible exact finished-bore/ring/web profile and obtain recorded job acceptance | 50 | 20 | False | False |  | 25 |  |  | Final actual four mask/paste exports; closed bore seal required, no independent via stencil; only exact qualified same-terminal apertures may overlap TypeVII caps | False
080ee3f5-e24b-5bf7-8051-7f002d848847 | VIA |  |  | GND | 96.95 | 51.0 | 0.2 | 0.2 | 0.4 | 0.4 | True | Ordinary_continuous_bilateral_soldermask_tent_unfilled_uncapped | yes | yes | no | no |  | No blanket selected job; supplier must propose compatible exact finished-bore/ring/web profile and obtain recorded job acceptance | 50 | 20 | False | False |  | 25 |  |  | Final actual four mask/paste exports; closed bore seal required, no independent via stencil; only exact qualified same-terminal apertures may overlap TypeVII caps | False
081a5e56-2964-59b1-bc9a-1c3c6aebc5dd | VIA |  |  | GND | 84.5 | 51.75 | 0.3 | 0.3 | 0.6 | 0.6 | True | Ordinary_continuous_bilateral_soldermask_tent_unfilled_uncapped | yes | yes | no | no |  | No blanket selected job; supplier must propose compatible exact finished-bore/ring/web profile and obtain recorded job acceptance | 50 | 20 | False | False |  | 25 |  |  | Final actual four mask/paste exports; closed bore seal required, no independent via stencil; only exact qualified same-terminal apertures may overlap TypeVII caps | False
0888120d-e241-547b-9a9f-a1dc399b6287 | VIA |  |  | OOB_USB_MUX_DISABLE | 10.015192 | 81.806352 | 0.15 | 0.15 | 0.45 | 0.45 | True | TypeVII_full_nonconductive_fill_bilateral_copper_cap | yes | yes | yes | yes | [0.07,0.22] | Actual81 differentiated nominal150 cohort: land400 max170, land460 max230, OE450 max220; measured all-six ring/no breakout and exact CAM acceptance required | 50 | 20 | False | False | 10 | 25 | 45 | 10 | Final actual four mask/paste exports; closed bore seal required, no independent via stencil; only exact qualified same-terminal apertures may overlap TypeVII caps | False
08fb2d65-c74b-50d6-85d5-287d7a14f4a0 | VIA |  |  | OOB_USB_MUX_SELECT | 17.95 | 78.8 | 0.3 | 0.3 | 0.625 | 0.625 | True | Ordinary_continuous_bilateral_soldermask_tent_unfilled_uncapped | yes | yes | no | no |  | No blanket selected job; supplier must propose compatible exact finished-bore/ring/web profile and obtain recorded job acceptance | 50 | 20 | False | False |  | 25 |  |  | Final actual four mask/paste exports; closed bore seal required, no independent via stencil; only exact qualified same-terminal apertures may overlap TypeVII caps | False
09380c88-f114-5bff-afd0-f513397e73db | VIA |  |  | MODEM_START_OK | 19.1014 | 84.9424 | 0.2 | 0.2 | 0.45 | 0.45 | True | Ordinary_continuous_bilateral_soldermask_tent_unfilled_uncapped | yes | yes | no | no |  | No blanket selected job; supplier must propose compatible exact finished-bore/ring/web profile and obtain recorded job acceptance | 50 | 20 | False | False |  | 25 | 35 | 10 | Final actual four mask/paste exports; closed bore seal required, no independent via stencil; only exact qualified same-terminal apertures may overlap TypeVII caps | False
0950afe1-eff5-553e-a456-1f054bdb19e5 | VIA |  |  | UIM1_RST | 19.9382 | 44.1452 | 0.2 | 0.2 | 0.45 | 0.45 | True | Ordinary_continuous_bilateral_soldermask_tent_unfilled_uncapped | yes | yes | no | no |  | No blanket selected job; supplier must propose compatible exact finished-bore/ring/web profile and obtain recorded job acceptance | 50 | 20 | False | False |  | 25 |  |  | Final actual four mask/paste exports; closed bore seal required, no independent via stencil; only exact qualified same-terminal apertures may overlap TypeVII caps | False
098a9b96-60dc-4e5a-9920-48d857960f9b | VIA |  |  | GND | 52.8 | 39.0 | 0.2 | 0.2 | 0.8 | 0.8 | True | TypeVII_full_nonconductive_fill_bilateral_copper_cap | inherit | inherit | yes | yes |  | No blanket selected job; supplier must propose compatible exact finished-bore/ring/web profile and obtain recorded job acceptance | 50 | 20 | False | False | 10 | 25 | 45 | 10 | Final actual four mask/paste exports; closed bore seal required, no independent via stencil; only exact qualified same-terminal apertures may overlap TypeVII caps | False
0a381bb9-644e-5d84-9565-12702b14232d | VIA |  |  | GND | 15.4 | 47.15 | 0.3 | 0.3 | 0.6 | 0.6 | True | Ordinary_continuous_bilateral_soldermask_tent_unfilled_uncapped | yes | yes | no | no |  | No blanket selected job; supplier must propose compatible exact finished-bore/ring/web profile and obtain recorded job acceptance | 50 | 20 | False | False |  | 25 | 35 | 10 | Final actual four mask/paste exports; closed bore seal required, no independent via stencil; only exact qualified same-terminal apertures may overlap TypeVII caps | False
0acfe5b2-3fc1-5fae-ab40-59380ba157cd | VIA |  |  | OOB_RADIO_SCK_MCU_DRV | 70.2 | 7.85 | 0.2 | 0.2 | 0.45 | 0.45 | True | Ordinary_continuous_bilateral_soldermask_tent_unfilled_uncapped | yes | yes | no | no |  | No blanket selected job; supplier must propose compatible exact finished-bore/ring/web profile and obtain recorded job acceptance | 50 | 20 | False | False |  | 25 |  |  | Final actual four mask/paste exports; closed bore seal required, no independent via stencil; only exact qualified same-terminal apertures may overlap TypeVII caps | False
0ad16fdb-119e-53ae-93e4-4d6b61a21ca8 | VIA |  |  | PASSIVE_FILTER_P | 75.8 | 65.5 | 0.3 | 0.3 | 0.625 | 0.625 | True | Ordinary_continuous_bilateral_soldermask_tent_unfilled_uncapped | yes | yes | no | no |  | No blanket selected job; supplier must propose compatible exact finished-bore/ring/web profile and obtain recorded job acceptance | 50 | 20 | False | False |  | 25 |  |  | Final actual four mask/paste exports; closed bore seal required, no independent via stencil; only exact qualified same-terminal apertures may overlap TypeVII caps | False
0ad4064f-2770-456d-a51e-8a80ab52b29e | VIA |  |  | GND | 53.11 | 5.8 | 0.2 | 0.2 | 0.4 | 0.4 | True | TypeVII_full_nonconductive_fill_bilateral_copper_cap | inherit | inherit | yes | yes |  | No blanket selected job; supplier must propose compatible exact finished-bore/ring/web profile and obtain recorded job acceptance | 50 | 20 | False | False | 10 | 25 | 45 | 10 | Final actual four mask/paste exports; closed bore seal required, no independent via stencil; only exact qualified same-terminal apertures may overlap TypeVII caps | False
0b2860c5-bf78-44cb-b484-aeb19c71f110 | VIA |  |  | V12 | 60.2 | 72.85 | 0.2 | 0.2 | 0.45 | 0.45 | True | TypeVII_full_nonconductive_fill_bilateral_copper_cap | inherit | inherit | yes | yes | [0.12,0.22] | Exact coupled U4 pair1190: first450/200 finished120..220 and second400/150 finished70..170, with narrower coupled-tool witness achieved210/160 maxima; local20um wall/ring50 and source-owner flat-cap acceptance remain mandatory | 50 | 20 | False | False | 10 | 25 |  |  | Final actual four mask/paste exports; closed bore seal required, no independent via stencil; only exact qualified same-terminal apertures may overlap TypeVII caps | False
0bb48f7d-95ad-5e1d-9b30-46245a6c434c | VIA |  |  | OOB_AON_EN | 87.9376 | 28.9662 | 0.2 | 0.2 | 0.45 | 0.45 | True | Ordinary_continuous_bilateral_soldermask_tent_unfilled_uncapped | yes | yes | no | no |  | No blanket selected job; supplier must propose compatible exact finished-bore/ring/web profile and obtain recorded job acceptance | 50 | 20 | False | False |  | 25 |  |  | Final actual four mask/paste exports; closed bore seal required, no independent via stencil; only exact qualified same-terminal apertures may overlap TypeVII caps | False
0c0f8f66-0e6c-5a28-9cf5-b766abe444a1 | VIA |  |  | AON_3V3 | 61.65 | 12.35 | 0.2 | 0.2 | 0.4 | 0.4 | True | Ordinary_continuous_bilateral_soldermask_tent_unfilled_uncapped | yes | yes | no | no |  | No blanket selected job; supplier must propose compatible exact finished-bore/ring/web profile and obtain recorded job acceptance | 50 | 20 | False | False |  | 25 | 35 | 10 | Final actual four mask/paste exports; closed bore seal required, no independent via stencil; only exact qualified same-terminal apertures may overlap TypeVII caps | False
0c143368-d946-4f90-962d-b3e13c35691a | VIA |  |  | VDC_IN | 49.85 | 7.9 | 0.4 | 0.4 | 0.8 | 0.8 | True | Ordinary_continuous_bilateral_soldermask_tent_unfilled_uncapped | yes | yes | no | no |  | No blanket selected job; supplier must propose compatible exact finished-bore/ring/web profile and obtain recorded job acceptance | 50 | 20 | True | False | 10 | 25 | 35 | 10 | Final actual four mask/paste exports; closed bore seal required, no independent via stencil; only exact qualified same-terminal apertures may overlap TypeVII caps | False
0c1a5fdf-71ba-4e00-9383-145917d8b4a1 | VIA |  |  | RTL_GPI | 38.1844 | 83.3154 | 0.2 | 0.2 | 0.45 | 0.45 | True | Ordinary_continuous_bilateral_soldermask_tent_unfilled_uncapped | yes | yes | no | no |  | No blanket selected job; supplier must propose compatible exact finished-bore/ring/web profile and obtain recorded job acceptance | 50 | 20 | False | False |  | 25 | 35 | 10 | Final actual four mask/paste exports; closed bore seal required, no independent via stencil; only exact qualified same-terminal apertures may overlap TypeVII caps | False
0c402a12-73ab-5415-adee-145ab9778f6e | VIA |  |  | GND | 108.1 | 9.45 | 0.3 | 0.3 | 0.625 | 0.625 | True | Ordinary_continuous_bilateral_soldermask_tent_unfilled_uncapped | yes | yes | no | no |  | No blanket selected job; supplier must propose compatible exact finished-bore/ring/web profile and obtain recorded job acceptance | 50 | 20 | True | False | 10 | 25 |  |  | Final actual four mask/paste exports; closed bore seal required, no independent via stencil; only exact qualified same-terminal apertures may overlap TypeVII caps | False
0c791e6a-51f9-5553-9b3e-4dd036b6cfb5 | VIA |  |  | AON_3V3 | 73.525 | 14.575 | 0.15 | 0.15 | 0.4 | 0.4 | True | TypeVII_full_nonconductive_fill_bilateral_copper_cap | yes | yes | yes | yes | [0.07,0.17] | Actual81 differentiated nominal150 cohort: land400 max170, land460 max230, OE450 max220; measured all-six ring/no breakout and exact CAM acceptance required | 50 | 20 | False | False | 10 | 25 | 45 | 10 | Final actual four mask/paste exports; closed bore seal required, no independent via stencil; only exact qualified same-terminal apertures may overlap TypeVII caps | False
0ce73c86-0275-5c2b-8c8e-49873afeaf28 | VIA |  |  | V0V95 | 55.0 | 82.3 | 0.2 | 0.2 | 0.45 | 0.45 | True | Ordinary_continuous_bilateral_soldermask_tent_unfilled_uncapped | yes | yes | no | no |  | No blanket selected job; supplier must propose compatible exact finished-bore/ring/web profile and obtain recorded job acceptance | 50 | 20 | False | False |  | 25 | 35 | 10 | Final actual four mask/paste exports; closed bore seal required, no independent via stencil; only exact qualified same-terminal apertures may overlap TypeVII caps | False
0cfa7115-85c5-52fb-a3df-8631b60c6be3 | VIA |  |  | AON_3V3 | 71.173883 | 27.183883 | 0.3 | 0.3 | 0.625 | 0.625 | True | Ordinary_continuous_bilateral_soldermask_tent_unfilled_uncapped | yes | yes | no | no |  | No blanket selected job; supplier must propose compatible exact finished-bore/ring/web profile and obtain recorded job acceptance | 50 | 20 | True | False | 10 | 25 |  |  | Final actual four mask/paste exports; closed bore seal required, no independent via stencil; only exact qualified same-terminal apertures may overlap TypeVII caps | False
0d168bdc-47f2-5cfc-8128-fc7289c17931 | VIA |  |  | GND | 3.7 | 75.12 | 0.2 | 0.2 | 0.4 | 0.4 | True | Ordinary_continuous_bilateral_soldermask_tent_unfilled_uncapped | yes | yes | no | no |  | No blanket selected job; supplier must propose compatible exact finished-bore/ring/web profile and obtain recorded job acceptance | 50 | 20 | False | False |  | 25 |  |  | Final actual four mask/paste exports; closed bore seal required, no independent via stencil; only exact qualified same-terminal apertures may overlap TypeVII caps | False
0d259e39-66af-57a6-9a79-ce8460c38630 | VIA |  |  | PASSIVE_PWR | 80.4 | 58.3 | 0.2 | 0.2 | 0.45 | 0.45 | True | Ordinary_continuous_bilateral_soldermask_tent_unfilled_uncapped | yes | yes | no | no |  | No blanket selected job; supplier must propose compatible exact finished-bore/ring/web profile and obtain recorded job acceptance | 50 | 20 | False | False |  | 25 |  |  | Final actual four mask/paste exports; closed bore seal required, no independent via stencil; only exact qualified same-terminal apertures may overlap TypeVII caps | False
0dadbc0a-ed60-4b55-bb0f-5039b954c65f | VIA |  |  | GND | 4.609999 | 88.4 | 0.3 | 0.3 | 0.55 | 0.55 | True | Ordinary_continuous_bilateral_soldermask_tent_unfilled_uncapped | yes | yes | no | no |  | No blanket selected job; supplier must propose compatible exact finished-bore/ring/web profile and obtain recorded job acceptance | 50 | 20 | True | False | 10 | 25 | 35 | 10 | Final actual four mask/paste exports; closed bore seal required, no independent via stencil; only exact qualified same-terminal apertures may overlap TypeVII caps | False
0de16782-4533-552f-bbf6-98a071b86d6e | VIA |  |  | GND | 16.0 | 46.5 | 0.3 | 0.3 | 0.6 | 0.6 | True | Ordinary_continuous_bilateral_soldermask_tent_unfilled_uncapped | yes | yes | no | no |  | No blanket selected job; supplier must propose compatible exact finished-bore/ring/web profile and obtain recorded job acceptance | 50 | 20 | False | False |  | 25 |  |  | Final actual four mask/paste exports; closed bore seal required, no independent via stencil; only exact qualified same-terminal apertures may overlap TypeVII caps | False
0de94cde-c6a2-5383-bcd0-b521a436ec8d | VIA |  |  | OOB_BOOT_N | 66.2634 | 8.7534 | 0.2 | 0.2 | 0.45 | 0.45 | True | Ordinary_continuous_bilateral_soldermask_tent_unfilled_uncapped | yes | yes | no | no |  | No blanket selected job; supplier must propose compatible exact finished-bore/ring/web profile and obtain recorded job acceptance | 50 | 20 | False | False |  | 25 |  |  | Final actual four mask/paste exports; closed bore seal required, no independent via stencil; only exact qualified same-terminal apertures may overlap TypeVII caps | False
0dee0d1f-54a8-51a7-8200-679277fc5826 | VIA |  |  | UIM1_CLK | 27.6491 | 50.6292 | 0.2 | 0.2 | 0.45 | 0.45 | True | Ordinary_continuous_bilateral_soldermask_tent_unfilled_uncapped | yes | yes | no | no |  | No blanket selected job; supplier must propose compatible exact finished-bore/ring/web profile and obtain recorded job acceptance | 50 | 20 | False | False |  | 25 |  |  | Final actual four mask/paste exports; closed bore seal required, no independent via stencil; only exact qualified same-terminal apertures may overlap TypeVII caps | False
0df26ac5-f09b-5176-9123-6e583b3b7c4c | VIA |  |  | GND | 72.22 | 30.3 | 0.2 | 0.2 | 0.45 | 0.45 | True | Ordinary_continuous_bilateral_soldermask_tent_unfilled_uncapped | yes | yes | no | no |  | No blanket selected job; supplier must propose compatible exact finished-bore/ring/web profile and obtain recorded job acceptance | 50 | 20 | False | False |  | 25 | 35 | 10 | Final actual four mask/paste exports; closed bore seal required, no independent via stencil; only exact qualified same-terminal apertures may overlap TypeVII caps | False
0e193ae2-c176-5b73-ba20-2613e0daa912 | VIA |  |  | EE_SK | 64.7739 | 53.6313 | 0.2 | 0.2 | 0.45 | 0.45 | True | Ordinary_continuous_bilateral_soldermask_tent_unfilled_uncapped | yes | yes | no | no |  | No blanket selected job; supplier must propose compatible exact finished-bore/ring/web profile and obtain recorded job acceptance | 50 | 20 | False | False |  | 25 | 35 | 10 | Final actual four mask/paste exports; closed bore seal required, no independent via stencil; only exact qualified same-terminal apertures may overlap TypeVII caps | False
0e420c64-a579-470b-802a-d84eb32d1a27 | VIA |  |  | GND | 26.25 | 74.925 | 0.3 | 0.3 | 0.55 | 0.55 | True | Ordinary_continuous_bilateral_soldermask_tent_unfilled_uncapped | yes | yes | no | no |  | No blanket selected job; supplier must propose compatible exact finished-bore/ring/web profile and obtain recorded job acceptance | 50 | 20 | True | False | 10 | 25 | 35 | 10 | Final actual four mask/paste exports; closed bore seal required, no independent via stencil; only exact qualified same-terminal apertures may overlap TypeVII caps | False
0e618dd3-e5a6-5c05-a47c-a3714f7139f7 | VIA |  |  | AON_3V3 | 46.842215 | 67.219414 | 0.2 | 0.2 | 0.45 | 0.45 | True | Ordinary_continuous_bilateral_soldermask_tent_unfilled_uncapped | yes | yes | no | no |  | No blanket selected job; supplier must propose compatible exact finished-bore/ring/web profile and obtain recorded job acceptance | 50 | 20 | False | False |  | 25 | 35 | 10 | Final actual four mask/paste exports; closed bore seal required, no independent via stencil; only exact qualified same-terminal apertures may overlap TypeVII caps | False
0e704e86-8cca-4923-9b9d-69b62a618c0d | VIA |  |  | u21_PGTH | 64.65 | 30.85 | 0.2 | 0.2 | 0.4 | 0.4 | True | TypeVII_full_nonconductive_fill_bilateral_copper_cap | inherit | inherit | yes | yes |  | No blanket selected job; supplier must propose compatible exact finished-bore/ring/web profile and obtain recorded job acceptance | 50 | 20 | False | False | 10 | 25 | 45 | 10 | Final actual four mask/paste exports; closed bore seal required, no independent via stencil; only exact qualified same-terminal apertures may overlap TypeVII caps | False
0e720492-3d44-4a1c-b6df-ecd8711f3b4c | VIA |  |  | RTL_SWR_EN | 45.9799 | 83.6405 | 0.2 | 0.2 | 0.45 | 0.45 | True | Ordinary_continuous_bilateral_soldermask_tent_unfilled_uncapped | yes | yes | no | no |  | No blanket selected job; supplier must propose compatible exact finished-bore/ring/web profile and obtain recorded job acceptance | 50 | 20 | False | False |  | 25 |  |  | Final actual four mask/paste exports; closed bore seal required, no independent via stencil; only exact qualified same-terminal apertures may overlap TypeVII caps | False
0f1e68e2-3e5b-5409-a0c3-c3fde0b4c1d2 | VIA |  |  | OOB_ADC_AUX12 | 57.05 | 14.8 | 0.2 | 0.2 | 0.45 | 0.45 | True | Ordinary_continuous_bilateral_soldermask_tent_unfilled_uncapped | yes | yes | no | no |  | No blanket selected job; supplier must propose compatible exact finished-bore/ring/web profile and obtain recorded job acceptance | 50 | 20 | False | False |  | 25 |  |  | Final actual four mask/paste exports; closed bore seal required, no independent via stencil; only exact qualified same-terminal apertures may overlap TypeVII caps | False
0f590886-f724-5bd1-83c7-158e0d49d1e5 | VIA |  |  | GND | 69.583883 | 24.858883 | 0.3 | 0.3 | 0.6 | 0.6 | True | Ordinary_continuous_bilateral_soldermask_tent_unfilled_uncapped | yes | yes | no | no |  | No blanket selected job; supplier must propose compatible exact finished-bore/ring/web profile and obtain recorded job acceptance | 50 | 20 | True | False | 10 | 25 | 35 | 10 | Final actual four mask/paste exports; closed bore seal required, no independent via stencil; only exact qualified same-terminal apertures may overlap TypeVII caps | False
0fd16c1b-f053-53e9-a4ea-2ad2699198d8 | VIA |  |  | AON_3V3 | 62.0 | 9.0 | 0.2 | 0.2 | 0.4 | 0.4 | True | Ordinary_continuous_bilateral_soldermask_tent_unfilled_uncapped | yes | yes | no | no |  | No blanket selected job; supplier must propose compatible exact finished-bore/ring/web profile and obtain recorded job acceptance | 50 | 20 | False | False |  | 25 | 35 | 10 | Final actual four mask/paste exports; closed bore seal required, no independent via stencil; only exact qualified same-terminal apertures may overlap TypeVII caps | False
0fda90c9-400c-4d95-960b-660b35bb9504 | VIA |  |  | FCPO_CTRL_N | 23.7 | 54.75 | 0.2 | 0.2 | 0.4 | 0.4 | True | Ordinary_continuous_bilateral_soldermask_tent_unfilled_uncapped | yes | yes | no | no |  | No blanket selected job; supplier must propose compatible exact finished-bore/ring/web profile and obtain recorded job acceptance | 50 | 20 | False | False |  | 25 | 35 | 10 | Final actual four mask/paste exports; closed bore seal required, no independent via stencil; only exact qualified same-terminal apertures may overlap TypeVII caps | False
10066077-71fa-5cc5-a4ef-7758a6ec861f | VIA |  |  | GND | 46.7 | 66.12 | 0.2 | 0.2 | 0.55 | 0.55 | True | Ordinary_continuous_bilateral_soldermask_tent_unfilled_uncapped | yes | yes | no | no |  | No blanket selected job; supplier must propose compatible exact finished-bore/ring/web profile and obtain recorded job acceptance | 50 | 20 | False | False |  | 25 |  |  | Final actual four mask/paste exports; closed bore seal required, no independent via stencil; only exact qualified same-terminal apertures may overlap TypeVII caps | False
10790b1e-6e3d-55b6-b8bd-20a35d687d13 | VIA |  |  | OOB_ADC_MODEM_CURRENT | 57.799999 | 45.0 | 0.2 | 0.2 | 0.55 | 0.55 | True | Ordinary_continuous_bilateral_soldermask_tent_unfilled_uncapped | yes | yes | no | no |  | No blanket selected job; supplier must propose compatible exact finished-bore/ring/web profile and obtain recorded job acceptance | 50 | 20 | False | False |  | 25 |  |  | Final actual four mask/paste exports; closed bore seal required, no independent via stencil; only exact qualified same-terminal apertures may overlap TypeVII caps | False
109c6555-cc25-52be-acab-77c86aedadcc | VIA |  |  | GND | 63.6 | 12.25 | 0.2 | 0.2 | 0.4 | 0.4 | True | Ordinary_continuous_bilateral_soldermask_tent_unfilled_uncapped | yes | yes | no | no |  | No blanket selected job; supplier must propose compatible exact finished-bore/ring/web profile and obtain recorded job acceptance | 50 | 20 | False | False |  | 25 | 35 | 10 | Final actual four mask/paste exports; closed bore seal required, no independent via stencil; only exact qualified same-terminal apertures may overlap TypeVII caps | False
10a1dc40-5213-5ff8-b8e4-964aa5bb0dc8 | VIA |  |  | OOB_RADIO_MOSI_MCU | 73.7836 | 28.2094 | 0.2 | 0.2 | 0.45 | 0.45 | True | Ordinary_continuous_bilateral_soldermask_tent_unfilled_uncapped | yes | yes | no | no |  | No blanket selected job; supplier must propose compatible exact finished-bore/ring/web profile and obtain recorded job acceptance | 50 | 20 | False | False |  | 25 |  |  | Final actual four mask/paste exports; closed bore seal required, no independent via stencil; only exact qualified same-terminal apertures may overlap TypeVII caps | False
111add55-b9f5-5d15-a18a-3d12312afdb5 | VIA |  |  | OOB_RADIO_POWER_GOOD | 56.425 | 55.825 | 0.15 | 0.15 | 0.46 | 0.46 | True | Ordinary_continuous_bilateral_soldermask_tent_unfilled_uncapped | yes | yes | no | no | [0.07,0.23] | Actual81 differentiated nominal150 cohort: land400 max170, land460 max230, OE450 max220; measured all-six ring/no breakout and exact CAM acceptance required | 50 | 20 | False | False |  | 25 |  |  | Final actual four mask/paste exports; closed bore seal required, no independent via stencil; only exact qualified same-terminal apertures may overlap TypeVII caps | False
114e5308-c4b5-55de-937b-d51fa794382c | VIA |  |  | BUCK_UVLO | 72.3 | 57.8 | 0.2 | 0.2 | 0.45 | 0.45 | True | Ordinary_continuous_bilateral_soldermask_tent_unfilled_uncapped | yes | yes | no | no |  | No blanket selected job; supplier must propose compatible exact finished-bore/ring/web profile and obtain recorded job acceptance | 50 | 20 | False | False |  | 25 | 35 | 10 | Final actual four mask/paste exports; closed bore seal required, no independent via stencil; only exact qualified same-terminal apertures may overlap TypeVII caps | False
116ba58b-fb72-5da2-ac28-5c9a7e6e3f4c | VIA |  |  | M2_RESET_N | 16.0978 | 75.0977 | 0.2 | 0.2 | 0.45 | 0.45 | True | Ordinary_continuous_bilateral_soldermask_tent_unfilled_uncapped | yes | yes | no | no |  | No blanket selected job; supplier must propose compatible exact finished-bore/ring/web profile and obtain recorded job acceptance | 50 | 20 | False | False |  | 25 | 35 | 10 | Final actual four mask/paste exports; closed bore seal required, no independent via stencil; only exact qualified same-terminal apertures may overlap TypeVII caps | False
11907ba0-bfcb-5503-80ff-0dfa6d3771fd | VIA |  |  | OOB_RADIO_NSS_MCU | 69.2432 | 30.9464 | 0.2 | 0.2 | 0.45 | 0.45 | True | Ordinary_continuous_bilateral_soldermask_tent_unfilled_uncapped | yes | yes | no | no |  | No blanket selected job; supplier must propose compatible exact finished-bore/ring/web profile and obtain recorded job acceptance | 50 | 20 | False | False |  | 25 |  |  | Final actual four mask/paste exports; closed bore seal required, no independent via stencil; only exact qualified same-terminal apertures may overlap TypeVII caps | False
11f9da01-2b38-483f-be0c-b08158f5a005 | VIA |  |  | GND | 7.699999 | 87.39 | 0.3 | 0.3 | 0.55 | 0.55 | True | Ordinary_continuous_bilateral_soldermask_tent_unfilled_uncapped | yes | yes | no | no |  | No blanket selected job; supplier must propose compatible exact finished-bore/ring/web profile and obtain recorded job acceptance | 50 | 20 | True | False | 10 | 25 |  |  | Final actual four mask/paste exports; closed bore seal required, no independent via stencil; only exact qualified same-terminal apertures may overlap TypeVII caps | False
1284c2ae-f0ee-570a-acd0-2a9ad3cb4809 | VIA |  |  | OOB_I2C_SDA | 71.9 | 9.375 | 0.15 | 0.15 | 0.46 | 0.46 | True | TypeVII_full_nonconductive_fill_bilateral_copper_cap | yes | yes | yes | yes | [0.07,0.23] | Actual81 differentiated nominal150 cohort: land400 max170, land460 max230, OE450 max220; measured all-six ring/no breakout and exact CAM acceptance required | 50 | 20 | False | False | 10 | 25 | 45 | 10 | Final actual four mask/paste exports; closed bore seal required, no independent via stencil; only exact qualified same-terminal apertures may overlap TypeVII caps | False
12a00108-0df8-5f83-a225-58cff682c124 | VIA |  |  | PASSIVE_HS_OUT | 81.4 | 61.8 | 0.2 | 0.2 | 0.45 | 0.45 | True | TypeVII_full_nonconductive_fill_bilateral_copper_cap | yes | yes | yes | yes |  | No blanket selected job; supplier must propose compatible exact finished-bore/ring/web profile and obtain recorded job acceptance | 50 | 20 | False | False | 10 | 25 | 45 | 10 | Final actual four mask/paste exports; closed bore seal required, no independent via stencil; only exact qualified same-terminal apertures may overlap TypeVII caps | False
12a297c7-16f3-5b25-94f4-1e3c1b03165b | VIA |  |  | OOB_RADIO_NRESET | 89.95 | 17.0 | 0.2 | 0.2 | 0.45 | 0.45 | True | Ordinary_continuous_bilateral_soldermask_tent_unfilled_uncapped | yes | yes | no | no |  | No blanket selected job; supplier must propose compatible exact finished-bore/ring/web profile and obtain recorded job acceptance | 50 | 20 | False | False |  | 25 |  |  | Final actual four mask/paste exports; closed bore seal required, no independent via stencil; only exact qualified same-terminal apertures may overlap TypeVII caps | False
12afaf05-5f40-5dcb-b4c9-65728862d4f7 | VIA |  |  | OOB_RADIO_NSS | 78.25 | 23.5 | 0.2 | 0.2 | 0.45 | 0.45 | True | Ordinary_continuous_bilateral_soldermask_tent_unfilled_uncapped | yes | yes | no | no |  | No blanket selected job; supplier must propose compatible exact finished-bore/ring/web profile and obtain recorded job acceptance | 50 | 20 | False | False |  | 25 |  |  | Final actual four mask/paste exports; closed bore seal required, no independent via stencil; only exact qualified same-terminal apertures may overlap TypeVII caps | False
13370067-e4ae-4e40-a9ef-3d93fcaefecc | VIA |  |  | RTL_GPI | 51.3143 | 91.7679 | 0.2 | 0.2 | 0.45 | 0.45 | True | Ordinary_continuous_bilateral_soldermask_tent_unfilled_uncapped | yes | yes | no | no |  | No blanket selected job; supplier must propose compatible exact finished-bore/ring/web profile and obtain recorded job acceptance | 50 | 20 | False | False |  | 25 | 35 | 10 | Final actual four mask/paste exports; closed bore seal required, no independent via stencil; only exact qualified same-terminal apertures may overlap TypeVII caps | False
1362da6b-51b6-5d93-bfd2-29edb971566f | VIA |  |  | GND | 72.7 | 17.6 | 0.2 | 0.2 | 0.4 | 0.4 | True | Ordinary_continuous_bilateral_soldermask_tent_unfilled_uncapped | yes | yes | no | no |  | No blanket selected job; supplier must propose compatible exact finished-bore/ring/web profile and obtain recorded job acceptance | 50 | 20 | False | False |  | 25 |  |  | Final actual four mask/paste exports; closed bore seal required, no independent via stencil; only exact qualified same-terminal apertures may overlap TypeVII caps | False
13633a1c-2aa5-5387-9d79-caecc8430249 | VIA |  |  | V3V3 | 57.8423 | 85.8244 | 0.2 | 0.2 | 0.45 | 0.45 | True | Ordinary_continuous_bilateral_soldermask_tent_unfilled_uncapped | yes | yes | no | no |  | No blanket selected job; supplier must propose compatible exact finished-bore/ring/web profile and obtain recorded job acceptance | 50 | 20 | False | False |  | 25 | 35 | 10 | Final actual four mask/paste exports; closed bore seal required, no independent via stencil; only exact qualified same-terminal apertures may overlap TypeVII caps | False
140bf97a-547c-448b-b52b-173af3ec4f5c | VIA |  |  | GND | 45.905025 | 88.045025 | 0.2 | 0.2 | 0.4 | 0.4 | True | Ordinary_continuous_bilateral_soldermask_tent_unfilled_uncapped | yes | yes | no | no |  | No blanket selected job; supplier must propose compatible exact finished-bore/ring/web profile and obtain recorded job acceptance | 50 | 20 | False | False |  | 25 |  |  | Final actual four mask/paste exports; closed bore seal required, no independent via stencil; only exact qualified same-terminal apertures may overlap TypeVII caps | False
1423ddd8-cc93-5ae4-84a3-471bfc0ae0aa | VIA |  |  | AON_3V3 | 53.57798 | 16.560307 | 0.2 | 0.2 | 0.45 | 0.45 | True | Ordinary_continuous_bilateral_soldermask_tent_unfilled_uncapped | yes | yes | no | no |  | No blanket selected job; supplier must propose compatible exact finished-bore/ring/web profile and obtain recorded job acceptance | 50 | 20 | False | False |  | 25 |  |  | Final actual four mask/paste exports; closed bore seal required, no independent via stencil; only exact qualified same-terminal apertures may overlap TypeVII caps | False
1502351c-f9df-55c2-a22a-9c105798df2d | VIA |  |  | V3V7 | 23.737437 | 68.712437 | 0.4 | 0.4 | 0.8 | 0.8 | True | TypeVII_full_nonconductive_fill_bilateral_copper_cap | yes | yes | yes | yes |  | No blanket selected job; supplier must propose compatible exact finished-bore/ring/web profile and obtain recorded job acceptance | 50 | 20 | False | False | 10 | 25 | 45 | 10 | Final actual four mask/paste exports; closed bore seal required, no independent via stencil; only exact qualified same-terminal apertures may overlap TypeVII caps | False
1511ac38-9c72-5e6a-b1a1-4d0fe957f5e4 | VIA |  |  | OOB_I2C_SCL | 62.1 | 46.7 | 0.2 | 0.2 | 0.45 | 0.45 | True | Ordinary_continuous_bilateral_soldermask_tent_unfilled_uncapped | yes | yes | no | no |  | No blanket selected job; supplier must propose compatible exact finished-bore/ring/web profile and obtain recorded job acceptance | 50 | 20 | False | False |  | 25 |  |  | Final actual four mask/paste exports; closed bore seal required, no independent via stencil; only exact qualified same-terminal apertures may overlap TypeVII caps | False
153526d9-e26a-51c2-a491-85fe08f4e7b5 | VIA |  |  | M2_WDIS1_N | 22.7225 | 57.737 | 0.2 | 0.2 | 0.45 | 0.45 | True | Ordinary_continuous_bilateral_soldermask_tent_unfilled_uncapped | yes | yes | no | no |  | No blanket selected job; supplier must propose compatible exact finished-bore/ring/web profile and obtain recorded job acceptance | 50 | 20 | False | False |  | 25 | 35 | 10 | Final actual four mask/paste exports; closed bore seal required, no independent via stencil; only exact qualified same-terminal apertures may overlap TypeVII caps | False
15ae37b1-74db-5f22-9c71-551e72746c8f | VIA |  |  | VPOE_P | 87.4 | 68.2 | 0.3 | 0.3 | 0.93 | 0.93 | True | Ordinary_continuous_bilateral_soldermask_tent_unfilled_uncapped | yes | yes | no | no |  | No blanket selected job; supplier must propose compatible exact finished-bore/ring/web profile and obtain recorded job acceptance | 50 | 20 | True | False | 10 | 25 |  |  | Final actual four mask/paste exports; closed bore seal required, no independent via stencil; only exact qualified same-terminal apertures may overlap TypeVII caps | False
15c05133-4c32-4ba5-a1f4-e4df5733bc95 | VIA |  |  | GND | 18.5 | 82.65 | 0.2 | 0.2 | 0.4 | 0.4 | True | Ordinary_continuous_bilateral_soldermask_tent_unfilled_uncapped | yes | yes | no | no |  | No blanket selected job; supplier must propose compatible exact finished-bore/ring/web profile and obtain recorded job acceptance | 50 | 20 | False | False |  | 25 | 35 | 10 | Final actual four mask/paste exports; closed bore seal required, no independent via stencil; only exact qualified same-terminal apertures may overlap TypeVII caps | False
160c4588-bdbf-52a4-a237-b78a69b9988c | VIA |  |  | GND | 16.0 | 45.7 | 0.3 | 0.3 | 0.6 | 0.6 | True | Ordinary_continuous_bilateral_soldermask_tent_unfilled_uncapped | yes | yes | no | no |  | No blanket selected job; supplier must propose compatible exact finished-bore/ring/web profile and obtain recorded job acceptance | 50 | 20 | False | False |  | 25 | 35 | 10 | Final actual four mask/paste exports; closed bore seal required, no independent via stencil; only exact qualified same-terminal apertures may overlap TypeVII caps | False
1628608b-4d82-4400-b1ed-b532f18033f4 | VIA |  |  | GND | 30.45 | 55.7375 | 0.3 | 0.3 | 0.55 | 0.55 | True | TypeVII_full_nonconductive_fill_bilateral_copper_cap | yes | yes | yes | yes |  | No blanket selected job; supplier must propose compatible exact finished-bore/ring/web profile and obtain recorded job acceptance | 50 | 20 | False | False | 10 | 25 | 45 | 10 | Final actual four mask/paste exports; closed bore seal required, no independent via stencil; only exact qualified same-terminal apertures may overlap TypeVII caps | False
168061c3-d984-4a96-8642-3fe1376ef331 | VIA |  |  | GND | 61.07362 | 50.740455 | 0.2 | 0.2 | 0.4 | 0.4 | True | Ordinary_continuous_bilateral_soldermask_tent_unfilled_uncapped | yes | yes | no | no |  | No blanket selected job; supplier must propose compatible exact finished-bore/ring/web profile and obtain recorded job acceptance | 50 | 20 | False | False |  | 25 |  |  | Final actual four mask/paste exports; closed bore seal required, no independent via stencil; only exact qualified same-terminal apertures may overlap TypeVII caps | False
168e8014-ab2c-5444-9745-fc5b93016d55 | VIA |  |  | V0V95 | 54.45 | 89.75 | 0.2 | 0.2 | 0.45 | 0.45 | True | Ordinary_continuous_bilateral_soldermask_tent_unfilled_uncapped | yes | yes | no | no |  | No blanket selected job; supplier must propose compatible exact finished-bore/ring/web profile and obtain recorded job acceptance | 50 | 20 | False | False |  | 25 | 35 | 10 | Final actual four mask/paste exports; closed bore seal required, no independent via stencil; only exact qualified same-terminal apertures may overlap TypeVII caps | False
1692f8e6-e869-5005-8690-3dd30b2bbad6 | VIA |  |  | VC1 | 81.2 | 89.445 | 0.3 | 0.3 | 0.93 | 0.93 | True | Ordinary_continuous_bilateral_soldermask_tent_unfilled_uncapped | yes | yes | no | no |  | No blanket selected job; supplier must propose compatible exact finished-bore/ring/web profile and obtain recorded job acceptance | 50 | 20 | True | False | 10 | 25 | 35 | 10 | Final actual four mask/paste exports; closed bore seal required, no independent via stencil; only exact qualified same-terminal apertures may overlap TypeVII caps | False
16bd0438-e513-594f-b4af-9adb911eafed | VIA |  |  | OOB_WATCHDOG_WDI | 76.45 | 12.0 | 0.2 | 0.2 | 0.45 | 0.45 | True | Ordinary_continuous_bilateral_soldermask_tent_unfilled_uncapped | yes | yes | no | no |  | No blanket selected job; supplier must propose compatible exact finished-bore/ring/web profile and obtain recorded job acceptance | 50 | 20 | False | False |  | 25 |  |  | Final actual four mask/paste exports; closed bore seal required, no independent via stencil; only exact qualified same-terminal apertures may overlap TypeVII caps | False
16c4bd19-6d9a-587b-9421-3f270d989e67 | VIA |  |  | PCIE_TX_N | 49.3 | 85.8 | 0.2 | 0.2 | 0.4 | 0.4 | True | Ordinary_continuous_bilateral_soldermask_tent_unfilled_uncapped | yes | yes | no | no |  | No blanket selected job; supplier must propose compatible exact finished-bore/ring/web profile and obtain recorded job acceptance | 50 | 20 | False | False |  | 25 |  |  | Final actual four mask/paste exports; closed bore seal required, no independent via stencil; only exact qualified same-terminal apertures may overlap TypeVII caps | False
17278383-6dac-594d-b473-2cb75ab87ae3 | VIA |  |  | GND | 62.6 | 61.35 | 0.2 | 0.2 | 0.4 | 0.4 | True | Ordinary_continuous_bilateral_soldermask_tent_unfilled_uncapped | yes | yes | no | no |  | No blanket selected job; supplier must propose compatible exact finished-bore/ring/web profile and obtain recorded job acceptance | 50 | 20 | False | False |  | 25 |  |  | Final actual four mask/paste exports; closed bore seal required, no independent via stencil; only exact qualified same-terminal apertures may overlap TypeVII caps | False
1787a2cc-1ff1-5979-8c51-31c16b7254e4 | VIA |  |  | OOB_MODEM_VCC_SCALED | 57.2061 | 42.9612 | 0.2 | 0.2 | 0.45 | 0.45 | True | Ordinary_continuous_bilateral_soldermask_tent_unfilled_uncapped | yes | yes | no | no |  | No blanket selected job; supplier must propose compatible exact finished-bore/ring/web profile and obtain recorded job acceptance | 50 | 20 | False | False |  | 25 | 35 | 10 | Final actual four mask/paste exports; closed bore seal required, no independent via stencil; only exact qualified same-terminal apertures may overlap TypeVII caps | False
17b7cdb1-9f3d-4097-8342-17554535cc6b | VIA |  |  | V3V3 | 61.9 | 43.0 | 0.3 | 0.3 | 0.55 | 0.55 | True | TypeVII_full_nonconductive_fill_bilateral_copper_cap | yes | yes | yes | yes |  | No blanket selected job; supplier must propose compatible exact finished-bore/ring/web profile and obtain recorded job acceptance | 50 | 20 | False | False | 10 | 25 | 45 | 10 | Final actual four mask/paste exports; closed bore seal required, no independent via stencil; only exact qualified same-terminal apertures may overlap TypeVII caps | False
17bfc5b4-934a-5951-86be-a2d175c694f3 | VIA |  |  | OOB_RADIO_NRESET | 98.3 | 25.3 | 0.2 | 0.2 | 0.45 | 0.45 | True | Ordinary_continuous_bilateral_soldermask_tent_unfilled_uncapped | yes | yes | no | no |  | No blanket selected job; supplier must propose compatible exact finished-bore/ring/web profile and obtain recorded job acceptance | 50 | 20 | False | False |  | 25 |  |  | Final actual four mask/paste exports; closed bore seal required, no independent via stencil; only exact qualified same-terminal apertures may overlap TypeVII caps | False
17f5210a-6720-4036-b7c2-46b760a302f7 | VIA |  |  | GND | 13.75 | 45.86 | 0.3 | 0.3 | 0.55 | 0.55 | True | Ordinary_continuous_bilateral_soldermask_tent_unfilled_uncapped | yes | yes | no | no |  | No blanket selected job; supplier must propose compatible exact finished-bore/ring/web profile and obtain recorded job acceptance | 50 | 20 | True | False | 10 | 25 |  |  | Final actual four mask/paste exports; closed bore seal required, no independent via stencil; only exact qualified same-terminal apertures may overlap TypeVII caps | False
180ee5e1-f44c-52e8-894a-bce95e927e83 | VIA |  |  | OOB_I2C_SCL | 59.075 | 35.525 | 0.15 | 0.15 | 0.46 | 0.46 | True | Ordinary_continuous_bilateral_soldermask_tent_unfilled_uncapped | yes | yes | no | no | [0.07,0.23] | Actual81 differentiated nominal150 cohort: land400 max170, land460 max230, OE450 max220; measured all-six ring/no breakout and exact CAM acceptance required | 50 | 20 | False | False |  | 25 |  |  | Final actual four mask/paste exports; closed bore seal required, no independent via stencil; only exact qualified same-terminal apertures may overlap TypeVII caps | False
181a332d-adc4-59b2-a38d-2dae2a9a2fd4 | VIA |  |  | OOB_ADC_MODEM_CURRENT | 45.299999 | 66.7 | 0.2 | 0.2 | 0.55 | 0.55 | True | Ordinary_continuous_bilateral_soldermask_tent_unfilled_uncapped | yes | yes | no | no |  | No blanket selected job; supplier must propose compatible exact finished-bore/ring/web profile and obtain recorded job acceptance | 50 | 20 | False | False |  | 25 |  |  | Final actual four mask/paste exports; closed bore seal required, no independent via stencil; only exact qualified same-terminal apertures may overlap TypeVII caps | False
184af288-398d-5593-9171-e69a973b048b | VIA |  |  | OOB_USB_DP | 9.476446 | 76.272678 | 0.2 | 0.2 | 0.45 | 0.45 | True | Ordinary_continuous_bilateral_soldermask_tent_unfilled_uncapped | yes | yes | no | no |  | No blanket selected job; supplier must propose compatible exact finished-bore/ring/web profile and obtain recorded job acceptance | 50 | 20 | False | False |  | 25 |  |  | Final actual four mask/paste exports; closed bore seal required, no independent via stencil; only exact qualified same-terminal apertures may overlap TypeVII caps | False
18544279-5917-541e-9dad-e21ce2b3ad2e | VIA |  |  | CABLE0_N | 83.4 | 90.595 | 0.4 | 0.4 | 0.9 | 0.9 | True | Ordinary_continuous_bilateral_soldermask_tent_unfilled_uncapped | yes | yes | no | no |  | No blanket selected job; supplier must propose compatible exact finished-bore/ring/web profile and obtain recorded job acceptance | 50 | 20 | False | False |  | 25 | 35 | 10 | Final actual four mask/paste exports; closed bore seal required, no independent via stencil; only exact qualified same-terminal apertures may overlap TypeVII caps | False
187d0e64-02e8-5e12-96a3-299007887374 | VIA |  |  | UIM1_DATA | 25.5 | 49.4 | 0.2 | 0.2 | 0.45 | 0.45 | True | Ordinary_continuous_bilateral_soldermask_tent_unfilled_uncapped | yes | yes | no | no |  | No blanket selected job; supplier must propose compatible exact finished-bore/ring/web profile and obtain recorded job acceptance | 50 | 20 | False | False |  | 25 |  |  | Final actual four mask/paste exports; closed bore seal required, no independent via stencil; only exact qualified same-terminal apertures may overlap TypeVII caps | False
18a95275-8a92-5e30-8370-c24b59285f7c | VIA |  |  | GND | 90.5 | 58.0 | 0.4 | 0.4 | 0.8 | 0.8 | True | Ordinary_continuous_bilateral_soldermask_tent_unfilled_uncapped | yes | yes | no | no |  | No blanket selected job; supplier must propose compatible exact finished-bore/ring/web profile and obtain recorded job acceptance | 50 | 20 | False | False |  | 25 | 35 | 10 | Final actual four mask/paste exports; closed bore seal required, no independent via stencil; only exact qualified same-terminal apertures may overlap TypeVII caps | False
18e294ac-90be-5a97-b32f-f87aae117413 | VIA |  |  | AON_3V3 | 68.1 | 15.4 | 0.2 | 0.2 | 0.4 | 0.4 | True | Ordinary_continuous_bilateral_soldermask_tent_unfilled_uncapped | yes | yes | no | no |  | No blanket selected job; supplier must propose compatible exact finished-bore/ring/web profile and obtain recorded job acceptance | 50 | 20 | False | False |  | 25 | 35 | 10 | Final actual four mask/paste exports; closed bore seal required, no independent via stencil; only exact qualified same-terminal apertures may overlap TypeVII caps | False
1937c92d-4523-56ae-ab99-b1a56ae67ec8 | VIA |  |  | GND | 93.9 | 21.1 | 0.3 | 0.3 | 0.625 | 0.625 | True | Ordinary_continuous_bilateral_soldermask_tent_unfilled_uncapped | yes | yes | no | no |  | No blanket selected job; supplier must propose compatible exact finished-bore/ring/web profile and obtain recorded job acceptance | 50 | 20 | True | False | 10 | 25 |  |  | Final actual four mask/paste exports; closed bore seal required, no independent via stencil; only exact qualified same-terminal apertures may overlap TypeVII caps | False
19898a4c-7ef0-479a-bef3-e5b14f5e5b60 | VIA |  |  | GND | 22.0 | 78.6 | 0.2 | 0.2 | 0.4 | 0.4 | True | Ordinary_continuous_bilateral_soldermask_tent_unfilled_uncapped | yes | yes | no | no |  | No blanket selected job; supplier must propose compatible exact finished-bore/ring/web profile and obtain recorded job acceptance | 50 | 20 | False | False |  | 25 |  |  | Final actual four mask/paste exports; closed bore seal required, no independent via stencil; only exact qualified same-terminal apertures may overlap TypeVII caps | False
19abed6a-0016-4e94-8d6e-59431d4ded63 | VIA |  |  | V3V3 | 19.23 | 13.25 | 0.3 | 0.3 | 0.55 | 0.55 | True | Ordinary_continuous_bilateral_soldermask_tent_unfilled_uncapped | yes | yes | no | no |  | No blanket selected job; supplier must propose compatible exact finished-bore/ring/web profile and obtain recorded job acceptance | 50 | 20 | True | False | 10 | 25 | 35 | 10 | Final actual four mask/paste exports; closed bore seal required, no independent via stencil; only exact qualified same-terminal apertures may overlap TypeVII caps | False
1a931362-b535-55f7-86e1-803fedc8c58e | VIA |  |  | USB_DN | 16.0 | 81.5 | 0.2 | 0.2 | 0.45 | 0.45 | True | Ordinary_continuous_bilateral_soldermask_tent_unfilled_uncapped | yes | yes | no | no |  | No blanket selected job; supplier must propose compatible exact finished-bore/ring/web profile and obtain recorded job acceptance | 50 | 20 | False | False |  | 25 |  |  | Final actual four mask/paste exports; closed bore seal required, no independent via stencil; only exact qualified same-terminal apertures may overlap TypeVII caps | False
1a97581b-b6fe-5b80-925d-5580a75b248e | VIA |  |  | GND | 24.9 | 11.55 | 0.2 | 0.2 | 0.45 | 0.45 | True | Ordinary_continuous_bilateral_soldermask_tent_unfilled_uncapped | yes | yes | no | no |  | No blanket selected job; supplier must propose compatible exact finished-bore/ring/web profile and obtain recorded job acceptance | 50 | 20 | False | False |  | 25 | 35 | 10 | Final actual four mask/paste exports; closed bore seal required, no independent via stencil; only exact qualified same-terminal apertures may overlap TypeVII caps | False
1ab8254f-0c04-59cb-8d1e-cbd6af2fea14 | VIA |  |  | u21_UV | 57.69 | 28.75 | 0.2 | 0.2 | 0.4 | 0.4 | True | Ordinary_continuous_bilateral_soldermask_tent_unfilled_uncapped | yes | yes | no | no |  | No blanket selected job; supplier must propose compatible exact finished-bore/ring/web profile and obtain recorded job acceptance | 50 | 20 | False | False |  | 25 | 35 | 10 | Final actual four mask/paste exports; closed bore seal required, no independent via stencil; only exact qualified same-terminal apertures may overlap TypeVII caps | False
1b580dd5-16e9-5e00-a5e3-b17e9d5c352d | VIA |  |  | POWER_OK | 64.9 | 56.6 | 0.2 | 0.2 | 0.45 | 0.45 | True | Ordinary_continuous_bilateral_soldermask_tent_unfilled_uncapped | yes | yes | no | no | [0.12,0.22] | Exact five POWER976 ordinary450/200 profile: finished120..220um/localwall20um; selected factory CAM/coupon acceptance required, not a blanket200 profile | 50 | 20 | False | False |  | 25 |  |  | Final actual four mask/paste exports; closed bore seal required, no independent via stencil; only exact qualified same-terminal apertures may overlap TypeVII caps | False
1b5f39a5-687c-5329-9f2f-0d4de276f5fb | VIA |  |  | V3V3 | 58.4473 | 59.636 | 0.2 | 0.2 | 0.45 | 0.45 | True | Ordinary_continuous_bilateral_soldermask_tent_unfilled_uncapped | yes | yes | no | no |  | No blanket selected job; supplier must propose compatible exact finished-bore/ring/web profile and obtain recorded job acceptance | 50 | 20 | False | False |  | 25 |  |  | Final actual four mask/paste exports; closed bore seal required, no independent via stencil; only exact qualified same-terminal apertures may overlap TypeVII caps | False
1b60e2a0-a864-5643-a388-ea6fe49097dd | VIA |  |  | OOB_USB_DP | 75.05 | 8.11 | 0.2 | 0.2 | 0.4 | 0.4 | True | Ordinary_continuous_bilateral_soldermask_tent_unfilled_uncapped | yes | yes | no | no |  | No blanket selected job; supplier must propose compatible exact finished-bore/ring/web profile and obtain recorded job acceptance | 50 | 20 | False | False |  | 25 | 35 | 10 | Final actual four mask/paste exports; closed bore seal required, no independent via stencil; only exact qualified same-terminal apertures may overlap TypeVII caps | False
1b793082-1b11-42ad-bc20-fb60d7ec9709 | VIA |  |  | GND | 16.153879 | 37.222684 | 0.3 | 0.3 | 0.55 | 0.55 | True | Ordinary_continuous_bilateral_soldermask_tent_unfilled_uncapped | yes | yes | no | no |  | No blanket selected job; supplier must propose compatible exact finished-bore/ring/web profile and obtain recorded job acceptance | 50 | 20 | True | False | 10 | 25 | 35 | 10 | Final actual four mask/paste exports; closed bore seal required, no independent via stencil; only exact qualified same-terminal apertures may overlap TypeVII caps | False
1b8a9364-0530-5b75-8ca8-a1a4bfba4738 | VIA |  |  | AON_3V3 | 76.85 | 14.925 | 0.2 | 0.2 | 0.45 | 0.45 | True | Ordinary_continuous_bilateral_soldermask_tent_unfilled_uncapped | yes | yes | no | no |  | No blanket selected job; supplier must propose compatible exact finished-bore/ring/web profile and obtain recorded job acceptance | 50 | 20 | False | False |  | 25 |  |  | Final actual four mask/paste exports; closed bore seal required, no independent via stencil; only exact qualified same-terminal apertures may overlap TypeVII caps | False
1bf84e18-0c24-549a-8d43-79d6ccab4142 | VIA |  |  | V3V7 | 43.2 | 59.51 | 0.2 | 0.2 | 0.45 | 0.45 | True | Ordinary_continuous_bilateral_soldermask_tent_unfilled_uncapped | yes | yes | no | no |  | No blanket selected job; supplier must propose compatible exact finished-bore/ring/web profile and obtain recorded job acceptance | 50 | 20 | False | False |  | 25 |  |  | Final actual four mask/paste exports; closed bore seal required, no independent via stencil; only exact qualified same-terminal apertures may overlap TypeVII caps | False
1c2ebff6-95f2-5f84-877a-7df4fcddd666 | VIA |  |  | ESIM_RST | 36.0686 | 61.154 | 0.2 | 0.2 | 0.45 | 0.45 | True | Ordinary_continuous_bilateral_soldermask_tent_unfilled_uncapped | yes | yes | no | no |  | No blanket selected job; supplier must propose compatible exact finished-bore/ring/web profile and obtain recorded job acceptance | 50 | 20 | False | False |  | 25 | 35 | 10 | Final actual four mask/paste exports; closed bore seal required, no independent via stencil; only exact qualified same-terminal apertures may overlap TypeVII caps | False
1c3b611b-ccde-529c-8f1f-fd6e7aecb6fc | VIA |  |  | OOB_RADIO_RUN_ALLOWED | 92.4 | 34.8 | 0.2 | 0.2 | 0.45 | 0.45 | True | Ordinary_continuous_bilateral_soldermask_tent_unfilled_uncapped | yes | yes | no | no |  | No blanket selected job; supplier must propose compatible exact finished-bore/ring/web profile and obtain recorded job acceptance | 50 | 20 | False | False |  | 25 |  |  | Final actual four mask/paste exports; closed bore seal required, no independent via stencil; only exact qualified same-terminal apertures may overlap TypeVII caps | False
1ca1e756-b39f-5b41-b389-3f41aa5c802a | VIA |  |  | OOB_I2C_SDA | 43.975 | 40.875 | 0.15 | 0.15 | 0.46 | 0.46 | True | Ordinary_continuous_bilateral_soldermask_tent_unfilled_uncapped | yes | yes | no | no | [0.07,0.23] | Actual81 differentiated nominal150 cohort: land400 max170, land460 max230, OE450 max220; measured all-six ring/no breakout and exact CAM acceptance required | 50 | 20 | False | False |  | 25 |  |  | Final actual four mask/paste exports; closed bore seal required, no independent via stencil; only exact qualified same-terminal apertures may overlap TypeVII caps | False
1d441493-b9d3-41a5-a790-5170e82651c6 | VIA |  |  | GND | 11.3 | 74.9 | 0.3 | 0.3 | 0.55 | 0.55 | True | Ordinary_continuous_bilateral_soldermask_tent_unfilled_uncapped | yes | yes | no | no |  | No blanket selected job; supplier must propose compatible exact finished-bore/ring/web profile and obtain recorded job acceptance | 50 | 20 | True | False | 10 | 25 | 35 | 10 | Final actual four mask/paste exports; closed bore seal required, no independent via stencil; only exact qualified same-terminal apertures may overlap TypeVII caps | False
1d5fb954-8426-54c7-83e4-d23dc4bc0e2d | VIA |  |  | V0V95 | 50.375 | 88.225 | 0.2 | 0.2 | 0.45 | 0.45 | True | Ordinary_continuous_bilateral_soldermask_tent_unfilled_uncapped | yes | yes | no | no |  | No blanket selected job; supplier must propose compatible exact finished-bore/ring/web profile and obtain recorded job acceptance | 50 | 20 | False | False |  | 25 | 35 | 10 | Final actual four mask/paste exports; closed bore seal required, no independent via stencil; only exact qualified same-terminal apertures may overlap TypeVII caps | False
1d63094a-282d-4952-8de2-8a54fdc933b1 | VIA |  |  | GND | 84.025 | 24.5 | 0.2 | 0.2 | 0.8 | 0.8 | True | Ordinary_continuous_bilateral_soldermask_tent_unfilled_uncapped | yes | yes | no | no |  | No blanket selected job; supplier must propose compatible exact finished-bore/ring/web profile and obtain recorded job acceptance | 50 | 20 | False | False |  | 25 |  |  | Final actual four mask/paste exports; closed bore seal required, no independent via stencil; only exact qualified same-terminal apertures may overlap TypeVII caps | False
1dd25574-30e4-588e-a4c8-977b9b7c5c2e | VIA |  |  | OOB_AON_EN | 51.1731 | 34.8285 | 0.2 | 0.2 | 0.45 | 0.45 | True | Ordinary_continuous_bilateral_soldermask_tent_unfilled_uncapped | yes | yes | no | no |  | No blanket selected job; supplier must propose compatible exact finished-bore/ring/web profile and obtain recorded job acceptance | 50 | 20 | False | False |  | 25 | 35 | 10 | Final actual four mask/paste exports; closed bore seal required, no independent via stencil; only exact qualified same-terminal apertures may overlap TypeVII caps | False
1ddc7b0d-5f34-4ce8-b2f1-81e1d25d8a8e | VIA |  |  | MODEM_ENABLE_MR | 28.05 | 54.226 | 0.2 | 0.2 | 0.4 | 0.4 | True | TypeVII_full_nonconductive_fill_bilateral_copper_cap | inherit | inherit | yes | yes |  | No blanket selected job; supplier must propose compatible exact finished-bore/ring/web profile and obtain recorded job acceptance | 50 | 20 | False | False | 10 | 25 | 45 | 10 | Final actual four mask/paste exports; closed bore seal required, no independent via stencil; only exact qualified same-terminal apertures may overlap TypeVII caps | False
1e0bf675-1040-4b95-bd85-73c69c506e1b | VIA |  |  | GND | 18.731255 | 87.200521 | 0.2 | 0.2 | 0.4 | 0.4 | True | TypeVII_full_nonconductive_fill_bilateral_copper_cap | yes | yes | yes | yes |  | No blanket selected job; supplier must propose compatible exact finished-bore/ring/web profile and obtain recorded job acceptance | 50 | 20 | False | False | 10 | 25 | 45 | 10 | Final actual four mask/paste exports; closed bore seal required, no independent via stencil; only exact qualified same-terminal apertures may overlap TypeVII caps | False
1e41c040-1342-503f-b5c6-37e912caccaa | VIA |  |  | OOB_RADIO_SCK_MCU | 67.1475 | 5.0796 | 0.2 | 0.2 | 0.45 | 0.45 | True | Ordinary_continuous_bilateral_soldermask_tent_unfilled_uncapped | yes | yes | no | no |  | No blanket selected job; supplier must propose compatible exact finished-bore/ring/web profile and obtain recorded job acceptance | 50 | 20 | False | False |  | 25 |  |  | Final actual four mask/paste exports; closed bore seal required, no independent via stencil; only exact qualified same-terminal apertures may overlap TypeVII caps | False
1e56959e-b07d-57da-82a3-035b2f2dd54c | VIA |  |  | V12 | 45.75 | 48.25 | 0.3 | 0.3 | 0.6 | 0.6 | True | Ordinary_continuous_bilateral_soldermask_tent_unfilled_uncapped | yes | yes | no | no |  | No blanket selected job; supplier must propose compatible exact finished-bore/ring/web profile and obtain recorded job acceptance | 50 | 20 | True | False | 10 | 25 |  |  | Final actual four mask/paste exports; closed bore seal required, no independent via stencil; only exact qualified same-terminal apertures may overlap TypeVII caps | False
1eae87cd-e106-5e64-88a8-e65d26c16e9d | VIA |  |  | OOB_USB_MUX_DISABLE | 61.6436 | 22.9485 | 0.2 | 0.2 | 0.45 | 0.45 | True | Ordinary_continuous_bilateral_soldermask_tent_unfilled_uncapped | yes | yes | no | no |  | No blanket selected job; supplier must propose compatible exact finished-bore/ring/web profile and obtain recorded job acceptance | 50 | 20 | False | False |  | 25 |  |  | Final actual four mask/paste exports; closed bore seal required, no independent via stencil; only exact qualified same-terminal apertures may overlap TypeVII caps | False
1ec9f73c-1a89-5161-85f0-f7b69e00fadf | VIA |  |  | GND | 5.0 | 84.3 | 0.2 | 0.2 | 0.45 | 0.45 | True | Ordinary_continuous_bilateral_soldermask_tent_unfilled_uncapped | yes | yes | no | no |  | No blanket selected job; supplier must propose compatible exact finished-bore/ring/web profile and obtain recorded job acceptance | 50 | 20 | False | False |  | 25 |  |  | Final actual four mask/paste exports; closed bore seal required, no independent via stencil; only exact qualified same-terminal apertures may overlap TypeVII caps | False
1ed3d3d7-4798-5664-b59c-b6ce7a8e2b47 | VIA |  |  | GND | 82.9 | 51.75 | 0.3 | 0.3 | 0.6 | 0.6 | True | Ordinary_continuous_bilateral_soldermask_tent_unfilled_uncapped | yes | yes | no | no |  | No blanket selected job; supplier must propose compatible exact finished-bore/ring/web profile and obtain recorded job acceptance | 50 | 20 | False | False |  | 25 |  |  | Final actual four mask/paste exports; closed bore seal required, no independent via stencil; only exact qualified same-terminal apertures may overlap TypeVII caps | False
1ef9b5ac-b361-4616-a9c1-11578a469840 | VIA |  |  | V3V3 | 51.0 | 64.06 | 0.3 | 0.3 | 0.55 | 0.55 | True | Ordinary_continuous_bilateral_soldermask_tent_unfilled_uncapped | yes | yes | no | no |  | No blanket selected job; supplier must propose compatible exact finished-bore/ring/web profile and obtain recorded job acceptance | 50 | 20 | True | False | 10 | 25 |  |  | Final actual four mask/paste exports; closed bore seal required, no independent via stencil; only exact qualified same-terminal apertures may overlap TypeVII caps | False
1f0a10a0-7762-59dd-8fd8-55ded5c2bfd9 | VIA |  |  | POWER_OK | 48.9 | 47.8 | 0.2 | 0.2 | 0.45 | 0.45 | True | Ordinary_continuous_bilateral_soldermask_tent_unfilled_uncapped | yes | yes | no | no | [0.12,0.22] | Exact five POWER976 ordinary450/200 profile: finished120..220um/localwall20um; selected factory CAM/coupon acceptance required, not a blanket200 profile | 50 | 20 | False | False |  | 25 |  |  | Final actual four mask/paste exports; closed bore seal required, no independent via stencil; only exact qualified same-terminal apertures may overlap TypeVII caps | False
1f0a37b9-a5bf-55a1-afe7-a268fd6a27bc | VIA |  |  | GND | 61.0 | 80.8 | 0.2 | 0.2 | 0.45 | 0.45 | True | Ordinary_continuous_bilateral_soldermask_tent_unfilled_uncapped | yes | yes | no | no |  | No blanket selected job; supplier must propose compatible exact finished-bore/ring/web profile and obtain recorded job acceptance | 50 | 20 | False | False |  | 25 |  |  | Final actual four mask/paste exports; closed bore seal required, no independent via stencil; only exact qualified same-terminal apertures may overlap TypeVII caps | False
1f176a88-986d-5985-bd0e-5cd01065effe | VIA |  |  | OOB_ADC_MODEM_CURRENT | 32.999999 | 76.9 | 0.2 | 0.2 | 0.55 | 0.55 | True | Ordinary_continuous_bilateral_soldermask_tent_unfilled_uncapped | yes | yes | no | no |  | No blanket selected job; supplier must propose compatible exact finished-bore/ring/web profile and obtain recorded job acceptance | 50 | 20 | False | False |  | 25 |  |  | Final actual four mask/paste exports; closed bore seal required, no independent via stencil; only exact qualified same-terminal apertures may overlap TypeVII caps | False
1f33d82d-f329-5047-ad68-7c516bb51ca2 | VIA |  |  | GND | 16.8 | 45.7 | 0.3 | 0.3 | 0.6 | 0.6 | True | Ordinary_continuous_bilateral_soldermask_tent_unfilled_uncapped | yes | yes | no | no |  | No blanket selected job; supplier must propose compatible exact finished-bore/ring/web profile and obtain recorded job acceptance | 50 | 20 | False | False |  | 25 |  |  | Final actual four mask/paste exports; closed bore seal required, no independent via stencil; only exact qualified same-terminal apertures may overlap TypeVII caps | False
1f3fddfd-7630-5181-ba0c-09a7e39d1adb | VIA |  |  | OOB_USB_SESSION_VALID | 47.2009 | 28.3661 | 0.2 | 0.2 | 0.45 | 0.45 | True | Ordinary_continuous_bilateral_soldermask_tent_unfilled_uncapped | yes | yes | no | no |  | No blanket selected job; supplier must propose compatible exact finished-bore/ring/web profile and obtain recorded job acceptance | 50 | 20 | False | False |  | 25 | 35 | 10 | Final actual four mask/paste exports; closed bore seal required, no independent via stencil; only exact qualified same-terminal apertures may overlap TypeVII caps | False
1f8f1bb5-0857-5bec-a0cd-89e412a4f8ca | VIA |  |  | EN_3V3 | 58.3 | 76.25 | 0.15 | 0.15 | 0.4 | 0.4 | True | TypeVII_full_nonconductive_fill_bilateral_copper_cap | inherit | inherit | yes | yes | [0.07,0.17] | Actual81 differentiated nominal150 cohort: land400 max170, land460 max230, OE450 max220; measured all-six ring/no breakout and exact CAM acceptance required | 50 | 20 | False | False | 10 | 25 | 45 | 10 | Final actual four mask/paste exports; closed bore seal required, no independent via stencil; only exact qualified same-terminal apertures may overlap TypeVII caps | False
1fd58c91-691e-4cd1-8f90-30b6df1de5e5 | VIA |  |  | V12 | 60.7 | 72.75 | 0.15 | 0.15 | 0.4 | 0.4 | True | TypeVII_full_nonconductive_fill_bilateral_copper_cap | inherit | inherit | yes | yes | [0.07,0.17] | Exact coupled U4 pair1190: first450/200 finished120..220 and second400/150 finished70..170, with narrower coupled-tool witness achieved210/160 maxima; local20um wall/ring50 and source-owner flat-cap acceptance remain mandatory | 50 | 20 | False | False | 10 | 25 |  |  | Final actual four mask/paste exports; closed bore seal required, no independent via stencil; only exact qualified same-terminal apertures may overlap TypeVII caps | False
1fd750ad-17ab-5ee6-b7df-3d5b12ff9017 | VIA |  |  | OOB_MODEM_STOP | 56.4162 | 27.3914 | 0.2 | 0.2 | 0.45 | 0.45 | True | Ordinary_continuous_bilateral_soldermask_tent_unfilled_uncapped | yes | yes | no | no |  | No blanket selected job; supplier must propose compatible exact finished-bore/ring/web profile and obtain recorded job acceptance | 50 | 20 | False | False |  | 25 |  |  | Final actual four mask/paste exports; closed bore seal required, no independent via stencil; only exact qualified same-terminal apertures may overlap TypeVII caps | False
1fe42f0e-cf1b-5e81-a633-7904ab08ac33 | VIA |  |  | GND | 101.875 | 21.8 | 0.3 | 0.3 | 0.625 | 0.625 | True | Ordinary_continuous_bilateral_soldermask_tent_unfilled_uncapped | yes | yes | no | no |  | No blanket selected job; supplier must propose compatible exact finished-bore/ring/web profile and obtain recorded job acceptance | 50 | 20 | True | False | 10 | 25 |  |  | Final actual four mask/paste exports; closed bore seal required, no independent via stencil; only exact qualified same-terminal apertures may overlap TypeVII caps | False
2010784d-01db-5fa2-ae2b-126b0ca75bfc | VIA |  |  | LEDY_A | 69.7605 | 78.0576 | 0.2 | 0.2 | 0.45 | 0.45 | True | Ordinary_continuous_bilateral_soldermask_tent_unfilled_uncapped | yes | yes | no | no |  | No blanket selected job; supplier must propose compatible exact finished-bore/ring/web profile and obtain recorded job acceptance | 50 | 20 | False | False |  | 25 | 35 | 10 | Final actual four mask/paste exports; closed bore seal required, no independent via stencil; only exact qualified same-terminal apertures may overlap TypeVII caps | False
2010d364-bbb8-406c-8f23-335c31f15245 | VIA |  |  | V0V95 | 38.8 | 87.5 | 0.3 | 0.3 | 0.55 | 0.55 | True | TypeVII_full_nonconductive_fill_bilateral_copper_cap | yes | yes | yes | yes |  | No blanket selected job; supplier must propose compatible exact finished-bore/ring/web profile and obtain recorded job acceptance | 50 | 20 | False | False | 10 | 25 | 45 | 10 | Final actual four mask/paste exports; closed bore seal required, no independent via stencil; only exact qualified same-terminal apertures may overlap TypeVII caps | False
2051ec2c-915a-4229-bd88-436f3afbf693 | VIA |  |  | PCIE_WAKE_N | 33.8176 | 77.0064 | 0.2 | 0.2 | 0.45 | 0.45 | True | Ordinary_continuous_bilateral_soldermask_tent_unfilled_uncapped | yes | yes | no | no |  | No blanket selected job; supplier must propose compatible exact finished-bore/ring/web profile and obtain recorded job acceptance | 50 | 20 | False | False |  | 25 | 35 | 10 | Final actual four mask/paste exports; closed bore seal required, no independent via stencil; only exact qualified same-terminal apertures may overlap TypeVII caps | False
20b3cdac-aeb4-58a1-8bf9-550c7475c5c8 | VIA |  |  | AON_3V3 | 73.540586 | 29.742215 | 0.2 | 0.2 | 0.45 | 0.45 | True | Ordinary_continuous_bilateral_soldermask_tent_unfilled_uncapped | yes | yes | no | no |  | No blanket selected job; supplier must propose compatible exact finished-bore/ring/web profile and obtain recorded job acceptance | 50 | 20 | False | False |  | 25 | 35 | 10 | Final actual four mask/paste exports; closed bore seal required, no independent via stencil; only exact qualified same-terminal apertures may overlap TypeVII caps | False
20d2fcd8-3d9a-4bac-bc2e-223b17a65448 | VIA |  |  | u5_FB | 46.75 | 79.55 | 0.2 | 0.2 | 0.4 | 0.4 | True | TypeVII_full_nonconductive_fill_bilateral_copper_cap | yes | yes | yes | yes |  | No blanket selected job; supplier must propose compatible exact finished-bore/ring/web profile and obtain recorded job acceptance | 50 | 20 | False | False | 10 | 25 | 45 | 10 | Final actual four mask/paste exports; closed bore seal required, no independent via stencil; only exact qualified same-terminal apertures may overlap TypeVII caps | False
2134c9cf-7212-508d-9b57-fb7878ce8bd7 | VIA |  |  | V3V3 | 61.7946 | 74.3033 | 0.2 | 0.2 | 0.45 | 0.45 | True | Ordinary_continuous_bilateral_soldermask_tent_unfilled_uncapped | yes | yes | no | no |  | No blanket selected job; supplier must propose compatible exact finished-bore/ring/web profile and obtain recorded job acceptance | 50 | 20 | False | False |  | 25 | 35 | 10 | Final actual four mask/paste exports; closed bore seal required, no independent via stencil; only exact qualified same-terminal apertures may overlap TypeVII caps | False
21363af1-da8e-4000-943a-7e7e94129762 | VIA |  |  | GND | 55.55 | 9.29 | 0.2 | 0.2 | 0.4 | 0.4 | True | TypeVII_full_nonconductive_fill_bilateral_copper_cap | inherit | inherit | yes | yes |  | No blanket selected job; supplier must propose compatible exact finished-bore/ring/web profile and obtain recorded job acceptance | 50 | 20 | False | False | 10 | 25 | 45 | 10 | Final actual four mask/paste exports; closed bore seal required, no independent via stencil; only exact qualified same-terminal apertures may overlap TypeVII caps | False
216a0935-5096-5868-89cb-5083d0f928d6 | VIA |  |  | USB_PORT_DP | 6.7 | 86.7 | 0.2 | 0.2 | 0.45 | 0.45 | True | Ordinary_continuous_bilateral_soldermask_tent_unfilled_uncapped | yes | yes | no | no |  | No blanket selected job; supplier must propose compatible exact finished-bore/ring/web profile and obtain recorded job acceptance | 50 | 20 | False | False |  | 25 | 35 | 10 | Final actual four mask/paste exports; closed bore seal required, no independent via stencil; only exact qualified same-terminal apertures may overlap TypeVII caps | False
21fc0c0a-54f7-406f-9837-f2a58e4c0c7a | VIA |  |  | GND | 22.15 | 76.05 | 0.2 | 0.2 | 0.4 | 0.4 | True | Ordinary_continuous_bilateral_soldermask_tent_unfilled_uncapped | yes | yes | no | no |  | No blanket selected job; supplier must propose compatible exact finished-bore/ring/web profile and obtain recorded job acceptance | 50 | 20 | False | False |  | 25 |  |  | Final actual four mask/paste exports; closed bore seal required, no independent via stencil; only exact qualified same-terminal apertures may overlap TypeVII caps | False
2200b8ab-08f1-5066-b670-d32ed2d1dece | VIA |  |  | AON_PG | 86.068 | 31.7723 | 0.2 | 0.2 | 0.45 | 0.45 | True | Ordinary_continuous_bilateral_soldermask_tent_unfilled_uncapped | yes | yes | no | no |  | No blanket selected job; supplier must propose compatible exact finished-bore/ring/web profile and obtain recorded job acceptance | 50 | 20 | False | False |  | 25 | 35 | 10 | Final actual four mask/paste exports; closed bore seal required, no independent via stencil; only exact qualified same-terminal apertures may overlap TypeVII caps | False
22011d48-1590-41b3-a82d-074ccc0a592b | VIA |  |  | VDC_IN | 52.5 | 12.5 | 0.2 | 0.2 | 0.4 | 0.4 | True | TypeVII_full_nonconductive_fill_bilateral_copper_cap | inherit | inherit | yes | yes |  | No blanket selected job; supplier must propose compatible exact finished-bore/ring/web profile and obtain recorded job acceptance | 50 | 20 | False | False | 10 | 25 | 45 | 10 | Final actual four mask/paste exports; closed bore seal required, no independent via stencil; only exact qualified same-terminal apertures may overlap TypeVII caps | False
2240f818-d9da-5903-a785-b5bfa94a5b7a | VIA |  |  | M2_RESET_N | 4.2545 | 81.9 | 0.2 | 0.2 | 0.45 | 0.45 | True | Ordinary_continuous_bilateral_soldermask_tent_unfilled_uncapped | yes | yes | no | no |  | No blanket selected job; supplier must propose compatible exact finished-bore/ring/web profile and obtain recorded job acceptance | 50 | 20 | False | False |  | 25 | 35 | 10 | Final actual four mask/paste exports; closed bore seal required, no independent via stencil; only exact qualified same-terminal apertures may overlap TypeVII caps | False
22456255-d321-548b-902d-a6841a5573e0 | VIA |  |  | PCIE_REFCLK_P | 46.4 | 89.4 | 0.2 | 0.2 | 0.45 | 0.45 | True | Ordinary_continuous_bilateral_soldermask_tent_unfilled_uncapped | yes | yes | no | no |  | No blanket selected job; supplier must propose compatible exact finished-bore/ring/web profile and obtain recorded job acceptance | 50 | 20 | False | False |  | 25 | 35 | 10 | Final actual four mask/paste exports; closed bore seal required, no independent via stencil; only exact qualified same-terminal apertures may overlap TypeVII caps | False
225f78b5-afec-5225-a3f5-ced53fbca7f0 | VIA |  |  | PCIE_RESET_MR | 65.4 | 77.7 | 0.2 | 0.2 | 0.45 | 0.45 | True | Ordinary_continuous_bilateral_soldermask_tent_unfilled_uncapped | yes | yes | no | no |  | No blanket selected job; supplier must propose compatible exact finished-bore/ring/web profile and obtain recorded job acceptance | 50 | 20 | False | False |  | 25 |  |  | Final actual four mask/paste exports; closed bore seal required, no independent via stencil; only exact qualified same-terminal apertures may overlap TypeVII caps | False
227ac79d-fcf2-49d2-a581-9ca5381b28e6 | VIA |  |  | V0V95 | 38.45 | 81.0 | 0.3 | 0.3 | 0.6 | 0.6 | True | TypeVII_full_nonconductive_fill_bilateral_copper_cap | inherit | inherit | yes | yes |  | No blanket selected job; supplier must propose compatible exact finished-bore/ring/web profile and obtain recorded job acceptance | 50 | 20 | False | False | 10 | 25 | 45 | 10 | Final actual four mask/paste exports; closed bore seal required, no independent via stencil; only exact qualified same-terminal apertures may overlap TypeVII caps | False
22a6c90d-8dff-5444-89db-378760317517 | VIA |  |  | GND | 80.55 | 38.3 | 0.2 | 0.2 | 0.4 | 0.4 | True | Ordinary_continuous_bilateral_soldermask_tent_unfilled_uncapped | yes | yes | no | no |  | No blanket selected job; supplier must propose compatible exact finished-bore/ring/web profile and obtain recorded job acceptance | 50 | 20 | False | False |  | 25 |  |  | Final actual four mask/paste exports; closed bore seal required, no independent via stencil; only exact qualified same-terminal apertures may overlap TypeVII caps | False
22ca3af7-c4e9-5c77-bfb3-7fa394062d96 | VIA |  |  | GND | 89.95 | 18.05 | 0.2 | 0.2 | 0.45 | 0.45 | True | Ordinary_continuous_bilateral_soldermask_tent_unfilled_uncapped | yes | yes | no | no |  | No blanket selected job; supplier must propose compatible exact finished-bore/ring/web profile and obtain recorded job acceptance | 50 | 20 | False | False |  | 25 |  |  | Final actual four mask/paste exports; closed bore seal required, no independent via stencil; only exact qualified same-terminal apertures may overlap TypeVII caps | False
22f8f6ca-97b9-5e20-a6cd-943ec51b36df | VIA |  |  | GND | 108.575 | 18.5 | 0.3 | 0.3 | 0.6 | 0.6 | True | TypeVII_full_nonconductive_fill_bilateral_copper_cap | inherit | inherit | yes | yes |  | No blanket selected job; supplier must propose compatible exact finished-bore/ring/web profile and obtain recorded job acceptance | 50 | 20 | False | False | 10 | 25 | 45 | 10 | Final actual four mask/paste exports; closed bore seal required, no independent via stencil; only exact qualified same-terminal apertures may overlap TypeVII caps | False
2321c706-5fae-5402-b91e-7c8c0ca20154 | VIA |  |  | OOB_I2C_SDA | 46.975 | 32.775 | 0.15 | 0.15 | 0.46 | 0.46 | True | Ordinary_continuous_bilateral_soldermask_tent_unfilled_uncapped | yes | yes | no | no | [0.07,0.23] | Actual81 differentiated nominal150 cohort: land400 max170, land460 max230, OE450 max220; measured all-six ring/no breakout and exact CAM acceptance required | 50 | 20 | False | False |  | 25 |  |  | Final actual four mask/paste exports; closed bore seal required, no independent via stencil; only exact qualified same-terminal apertures may overlap TypeVII caps | False
2359b6e5-5c14-54d2-995e-6842fa13bea2 | VIA |  |  | OOB_RADIO_BUSY | 76.9 | 14.14 | 0.2 | 0.2 | 0.45 | 0.45 | True | Ordinary_continuous_bilateral_soldermask_tent_unfilled_uncapped | yes | yes | no | no |  | No blanket selected job; supplier must propose compatible exact finished-bore/ring/web profile and obtain recorded job acceptance | 50 | 20 | False | False |  | 25 |  |  | Final actual four mask/paste exports; closed bore seal required, no independent via stencil; only exact qualified same-terminal apertures may overlap TypeVII caps | False
23cc3744-4173-583c-9289-a3f9e033717a | VIA |  |  | V3V3_PLL | 58.9 | 87.3 | 0.2 | 0.2 | 0.45 | 0.45 | True | Ordinary_continuous_bilateral_soldermask_tent_unfilled_uncapped | yes | yes | no | no |  | No blanket selected job; supplier must propose compatible exact finished-bore/ring/web profile and obtain recorded job acceptance | 50 | 20 | False | False |  | 25 |  |  | Final actual four mask/paste exports; closed bore seal required, no independent via stencil; only exact qualified same-terminal apertures may overlap TypeVII caps | False
256dfb0a-2bce-4d66-9201-ff14d598e6bc | VIA |  |  | GND | 56.06 | 14.25 | 0.2 | 0.2 | 0.4 | 0.4 | True | TypeVII_full_nonconductive_fill_bilateral_copper_cap | inherit | inherit | yes | yes |  | No blanket selected job; supplier must propose compatible exact finished-bore/ring/web profile and obtain recorded job acceptance | 50 | 20 | False | False | 10 | 25 | 45 | 10 | Final actual four mask/paste exports; closed bore seal required, no independent via stencil; only exact qualified same-terminal apertures may overlap TypeVII caps | False
259bc01b-eeab-5625-a489-d6ae120af85f | VIA |  |  | PASSIVE_HS_OUT | 79.575 | 52.0 | 0.2 | 0.2 | 0.4 | 0.4 | True | Ordinary_continuous_bilateral_soldermask_tent_unfilled_uncapped | yes | yes | no | no |  | No blanket selected job; supplier must propose compatible exact finished-bore/ring/web profile and obtain recorded job acceptance | 50 | 20 | False | False |  | 25 |  |  | Final actual four mask/paste exports; closed bore seal required, no independent via stencil; only exact qualified same-terminal apertures may overlap TypeVII caps | False
25d4dcda-d2fd-5be3-9a17-9f99fc5fd87e | VIA |  |  | GND | 80.4 | 34.6 | 0.2 | 0.2 | 0.45 | 0.45 | True | Ordinary_continuous_bilateral_soldermask_tent_unfilled_uncapped | yes | yes | no | no |  | No blanket selected job; supplier must propose compatible exact finished-bore/ring/web profile and obtain recorded job acceptance | 50 | 20 | False | False |  | 25 |  |  | Final actual four mask/paste exports; closed bore seal required, no independent via stencil; only exact qualified same-terminal apertures may overlap TypeVII caps | False
25d6a054-7bfb-5396-b52d-cac5644754f1 | VIA |  |  | CABLE0_P | 83.4 | 92.104999 | 0.4 | 0.4 | 0.9 | 0.9 | True | Ordinary_continuous_bilateral_soldermask_tent_unfilled_uncapped | yes | yes | no | no |  | No blanket selected job; supplier must propose compatible exact finished-bore/ring/web profile and obtain recorded job acceptance | 50 | 20 | False | False |  | 25 | 35 | 10 | Final actual four mask/paste exports; closed bore seal required, no independent via stencil; only exact qualified same-terminal apertures may overlap TypeVII caps | False
2606826a-59f8-5a3c-b731-7581c0430c86 | VIA |  |  | OOB_RADIO_BUSY | 80.15 | 23.1 | 0.2 | 0.2 | 0.45 | 0.45 | True | Ordinary_continuous_bilateral_soldermask_tent_unfilled_uncapped | yes | yes | no | no |  | No blanket selected job; supplier must propose compatible exact finished-bore/ring/web profile and obtain recorded job acceptance | 50 | 20 | False | False |  | 25 |  |  | Final actual four mask/paste exports; closed bore seal required, no independent via stencil; only exact qualified same-terminal apertures may overlap TypeVII caps | False
26cd8c3a-bf5f-5b1b-ae77-2a01e6cb1625 | VIA |  |  | GND | 87.4 | 22.9 | 0.2 | 0.2 | 0.45 | 0.45 | True | Ordinary_continuous_bilateral_soldermask_tent_unfilled_uncapped | yes | yes | no | no |  | No blanket selected job; supplier must propose compatible exact finished-bore/ring/web profile and obtain recorded job acceptance | 50 | 20 | False | False |  | 25 |  |  | Final actual four mask/paste exports; closed bore seal required, no independent via stencil; only exact qualified same-terminal apertures may overlap TypeVII caps | False
26de92cd-c5cd-5b75-b6b0-f5c3fb7ea6a6 | VIA |  |  | GND | 65.65 | 13.925 | 0.2 | 0.2 | 0.4 | 0.4 | True | Ordinary_continuous_bilateral_soldermask_tent_unfilled_uncapped | yes | yes | no | no |  | No blanket selected job; supplier must propose compatible exact finished-bore/ring/web profile and obtain recorded job acceptance | 50 | 20 | False | False |  | 25 |  |  | Final actual four mask/paste exports; closed bore seal required, no independent via stencil; only exact qualified same-terminal apertures may overlap TypeVII caps | False
2728c675-848a-58b6-9805-bc03752fe071 | VIA |  |  | GND | 102.021611 | 34.310583 | 0.3 | 0.3 | 0.55 | 0.55 | True | Ordinary_continuous_bilateral_soldermask_tent_unfilled_uncapped | yes | yes | no | no |  | No blanket selected job; supplier must propose compatible exact finished-bore/ring/web profile and obtain recorded job acceptance | 50 | 20 | True | False | 10 | 25 |  |  | Final actual four mask/paste exports; closed bore seal required, no independent via stencil; only exact qualified same-terminal apertures may overlap TypeVII caps | False
274c1bce-2578-43e5-bd7c-42148a156eb9 | VIA |  |  | UIM1_VDD | 17.4424 | 39.4744 | 0.2 | 0.2 | 0.4 | 0.4 | True | Ordinary_continuous_bilateral_soldermask_tent_unfilled_uncapped | yes | yes | no | no |  | No blanket selected job; supplier must propose compatible exact finished-bore/ring/web profile and obtain recorded job acceptance | 50 | 20 | False | False |  | 25 | 35 | 10 | Final actual four mask/paste exports; closed bore seal required, no independent via stencil; only exact qualified same-terminal apertures may overlap TypeVII caps | False
275e1369-7b98-533f-9445-891aaee4d958 | VIA |  |  | GND | 46.25 | 32.1 | 0.2 | 0.2 | 0.45 | 0.45 | True | Ordinary_continuous_bilateral_soldermask_tent_unfilled_uncapped | yes | yes | no | no | [0.12,0.22] | Retained discrete bounded ordinary200 profile: C908OE1104; fab acceptance required | 50 | 20 | False | False |  | 25 |  |  | Final actual four mask/paste exports; closed bore seal required, no independent via stencil; only exact qualified same-terminal apertures may overlap TypeVII caps | False
280e509d-58bf-4720-b540-67375990efb8 | VIA |  |  | GND | 61.62 | 72.1 | 0.2 | 0.2 | 0.4 | 0.4 | True | TypeVII_full_nonconductive_fill_bilateral_copper_cap | inherit | inherit | yes | yes |  | No blanket selected job; supplier must propose compatible exact finished-bore/ring/web profile and obtain recorded job acceptance | 50 | 20 | False | False | 10 | 25 | 45 | 10 | Final actual four mask/paste exports; closed bore seal required, no independent via stencil; only exact qualified same-terminal apertures may overlap TypeVII caps | False
2810fd05-707c-4685-96c1-666c40c8dd0e | VIA |  |  | M2_LED_N | 26.3069 | 64.3088 | 0.2 | 0.2 | 0.45 | 0.45 | True | Ordinary_continuous_bilateral_soldermask_tent_unfilled_uncapped | yes | yes | no | no |  | No blanket selected job; supplier must propose compatible exact finished-bore/ring/web profile and obtain recorded job acceptance | 50 | 20 | False | False |  | 25 | 35 | 10 | Final actual four mask/paste exports; closed bore seal required, no independent via stencil; only exact qualified same-terminal apertures may overlap TypeVII caps | False
284ad3f6-e05d-5867-9457-871897249932 | VIA |  |  | AON_3V3 | 54.861081 | 50.767846 | 0.2 | 0.2 | 0.45 | 0.45 | True | Ordinary_continuous_bilateral_soldermask_tent_unfilled_uncapped | yes | yes | no | no |  | No blanket selected job; supplier must propose compatible exact finished-bore/ring/web profile and obtain recorded job acceptance | 50 | 20 | False | False |  | 25 |  |  | Final actual four mask/paste exports; closed bore seal required, no independent via stencil; only exact qualified same-terminal apertures may overlap TypeVII caps | False
284dc41c-31f1-5a86-9a69-837eebd04de9 | VIA |  |  | PCIE_PERST_N | 51.3279 | 77.6227 | 0.2 | 0.2 | 0.45 | 0.45 | True | Ordinary_continuous_bilateral_soldermask_tent_unfilled_uncapped | yes | yes | no | no |  | No blanket selected job; supplier must propose compatible exact finished-bore/ring/web profile and obtain recorded job acceptance | 50 | 20 | False | False |  | 25 | 35 | 10 | Final actual four mask/paste exports; closed bore seal required, no independent via stencil; only exact qualified same-terminal apertures may overlap TypeVII caps | False
28550044-8e69-5222-a7cf-265ce86671e0 | VIA |  |  | PCIE_PERST_N | 37.4913 | 49.8455 | 0.2 | 0.2 | 0.45 | 0.45 | True | Ordinary_continuous_bilateral_soldermask_tent_unfilled_uncapped | yes | yes | no | no |  | No blanket selected job; supplier must propose compatible exact finished-bore/ring/web profile and obtain recorded job acceptance | 50 | 20 | False | False |  | 25 | 35 | 10 | Final actual four mask/paste exports; closed bore seal required, no independent via stencil; only exact qualified same-terminal apertures may overlap TypeVII caps | False
289b01f8-f25f-51d6-8f4a-22448edd1f22 | VIA |  |  | AON_3V3 | 10.52 | 80.5 | 0.15 | 0.15 | 0.46 | 0.46 | True | TypeVII_full_nonconductive_fill_bilateral_copper_cap | yes | yes | yes | yes | [0.07,0.23] | Actual81 differentiated nominal150 cohort: land400 max170, land460 max230, OE450 max220; measured all-six ring/no breakout and exact CAM acceptance required | 50 | 20 | False | False | 10 | 25 | 45 | 10 | Final actual four mask/paste exports; closed bore seal required, no independent via stencil; only exact qualified same-terminal apertures may overlap TypeVII caps | False
29020bae-b559-50d3-b891-16e721d549ac | VIA |  |  | BUCK_PG | 82.8 | 38.2 | 0.2 | 0.2 | 0.4 | 0.4 | True | Ordinary_continuous_bilateral_soldermask_tent_unfilled_uncapped | yes | yes | no | no |  | No blanket selected job; supplier must propose compatible exact finished-bore/ring/web profile and obtain recorded job acceptance | 50 | 20 | False | False |  | 25 |  |  | Final actual four mask/paste exports; closed bore seal required, no independent via stencil; only exact qualified same-terminal apertures may overlap TypeVII caps | False
29384945-a176-593c-b019-316f4d845187 | VIA |  |  | OOB_USB_SELECT_INTERNAL | 76.55 | 4.3 | 0.15 | 0.15 | 0.46 | 0.46 | True | Ordinary_continuous_bilateral_soldermask_tent_unfilled_uncapped | yes | yes | no | no | [0.07,0.23] | Actual81 differentiated nominal150 cohort: land400 max170, land460 max230, OE450 max220; measured all-six ring/no breakout and exact CAM acceptance required | 50 | 20 | False | False |  | 25 |  |  | Final actual four mask/paste exports; closed bore seal required, no independent via stencil; only exact qualified same-terminal apertures may overlap TypeVII caps | False
293e91c9-833e-5bcc-86e0-3d304bc1b6d6 | VIA |  |  | AON_3V3 | 69.15 | 38.1125 | 0.3 | 0.3 | 0.6 | 0.6 | True | Ordinary_continuous_bilateral_soldermask_tent_unfilled_uncapped | yes | yes | no | no |  | No blanket selected job; supplier must propose compatible exact finished-bore/ring/web profile and obtain recorded job acceptance | 50 | 20 | True | False | 10 | 25 | 35 | 10 | Final actual four mask/paste exports; closed bore seal required, no independent via stencil; only exact qualified same-terminal apertures may overlap TypeVII caps | False
297904c7-d71f-5f6c-a189-926ecf3b20a2 | VIA |  |  | GND | 12.7 | 66.4 | 0.2 | 0.2 | 0.4 | 0.4 | True | TypeVII_full_nonconductive_fill_bilateral_copper_cap | yes | yes | yes | yes |  | No blanket selected job; supplier must propose compatible exact finished-bore/ring/web profile and obtain recorded job acceptance | 50 | 20 | False | False | 10 | 25 |  |  | Final actual four mask/paste exports; closed bore seal required, no independent via stencil; only exact qualified same-terminal apertures may overlap TypeVII caps | False
2a4b34b0-f7a2-59f4-807b-0e7fc686d662 | VIA |  |  | GND | 51.4375 | 41.3 | 0.3 | 0.3 | 0.6 | 0.6 | True | Ordinary_continuous_bilateral_soldermask_tent_unfilled_uncapped | yes | yes | no | no |  | No blanket selected job; supplier must propose compatible exact finished-bore/ring/web profile and obtain recorded job acceptance | 50 | 20 | True | False | 10 | 25 | 35 | 10 | Final actual four mask/paste exports; closed bore seal required, no independent via stencil; only exact qualified same-terminal apertures may overlap TypeVII caps | False
2a95aea8-bb95-5212-9d5f-808d154505e2 | VIA |  |  | GND | 68.7 | 8.15 | 0.2 | 0.2 | 0.45 | 0.45 | True | Ordinary_continuous_bilateral_soldermask_tent_unfilled_uncapped | yes | yes | no | no |  | No blanket selected job; supplier must propose compatible exact finished-bore/ring/web profile and obtain recorded job acceptance | 50 | 20 | False | False |  | 25 | 35 | 10 | Final actual four mask/paste exports; closed bore seal required, no independent via stencil; only exact qualified same-terminal apertures may overlap TypeVII caps | False
2b0cf7fa-3a5e-43c8-8b96-6c0117b8ecba | VIA |  |  | V3V3 | 32.862499 | 55.95 | 0.2 | 0.2 | 0.4 | 0.4 | True | TypeVII_full_nonconductive_fill_bilateral_copper_cap | inherit | inherit | yes | yes |  | No blanket selected job; supplier must propose compatible exact finished-bore/ring/web profile and obtain recorded job acceptance | 50 | 20 | False | False | 10 | 25 | 45 | 10 | Final actual four mask/paste exports; closed bore seal required, no independent via stencil; only exact qualified same-terminal apertures may overlap TypeVII caps | False
2b334a52-8e7a-5217-9e35-014938585d53 | VIA |  |  | MDI_CT | 71.365 | 77.5 | 0.2 | 0.2 | 0.5 | 0.5 | True | TypeVII_full_nonconductive_fill_bilateral_copper_cap | yes | yes | yes | yes |  | No blanket selected job; supplier must propose compatible exact finished-bore/ring/web profile and obtain recorded job acceptance | 50 | 20 | False | False | 10 | 25 | 45 | 10 | Final actual four mask/paste exports; closed bore seal required, no independent via stencil; only exact qualified same-terminal apertures may overlap TypeVII caps | False
2bf78789-54f3-5f5d-b4fb-d28e887b547c | VIA |  |  | GND | 45.3625 | 40.75 | 0.3 | 0.3 | 0.6 | 0.6 | True | Ordinary_continuous_bilateral_soldermask_tent_unfilled_uncapped | yes | yes | no | no |  | No blanket selected job; supplier must propose compatible exact finished-bore/ring/web profile and obtain recorded job acceptance | 50 | 20 | True | False | 10 | 25 |  |  | Final actual four mask/paste exports; closed bore seal required, no independent via stencil; only exact qualified same-terminal apertures may overlap TypeVII caps | False
2c14b2aa-2dbf-4c04-aae7-0c97c6f4b40d | VIA |  |  | V0V95 | 32.025 | 78.399999 | 0.3 | 0.3 | 0.6 | 0.6 | True | TypeVII_full_nonconductive_fill_bilateral_copper_cap | inherit | inherit | yes | yes |  | No blanket selected job; supplier must propose compatible exact finished-bore/ring/web profile and obtain recorded job acceptance | 50 | 20 | False | False | 10 | 25 | 45 | 10 | Final actual four mask/paste exports; closed bore seal required, no independent via stencil; only exact qualified same-terminal apertures may overlap TypeVII caps | False
2c2f65c6-7f63-5666-8cde-baeacd6f1617 | VIA |  |  | V12 | 49.5 | 60.0 | 0.2 | 0.2 | 0.4 | 0.4 | True | Ordinary_continuous_bilateral_soldermask_tent_unfilled_uncapped | yes | yes | no | no |  | No blanket selected job; supplier must propose compatible exact finished-bore/ring/web profile and obtain recorded job acceptance | 50 | 20 | False | False |  | 25 |  |  | Final actual four mask/paste exports; closed bore seal required, no independent via stencil; only exact qualified same-terminal apertures may overlap TypeVII caps | False
2c30b586-1975-5aed-a659-abf31e6a2391 | VIA |  |  | OOB_RADIO_RXEN_MCU | 104.9004 | 31.0507 | 0.2 | 0.2 | 0.45 | 0.45 | True | Ordinary_continuous_bilateral_soldermask_tent_unfilled_uncapped | yes | yes | no | no |  | No blanket selected job; supplier must propose compatible exact finished-bore/ring/web profile and obtain recorded job acceptance | 50 | 20 | False | False |  | 25 | 35 | 10 | Final actual four mask/paste exports; closed bore seal required, no independent via stencil; only exact qualified same-terminal apertures may overlap TypeVII caps | False
2ca4ec77-f0bb-5dde-88a1-440c0f08d9f4 | VIA |  |  | Q742_G | 56.268 | 29.7363 | 0.2 | 0.2 | 0.45 | 0.45 | True | Ordinary_continuous_bilateral_soldermask_tent_unfilled_uncapped | yes | yes | no | no |  | No blanket selected job; supplier must propose compatible exact finished-bore/ring/web profile and obtain recorded job acceptance | 50 | 20 | False | False |  | 25 | 35 | 10 | Final actual four mask/paste exports; closed bore seal required, no independent via stencil; only exact qualified same-terminal apertures may overlap TypeVII caps | False
2cfb9c6b-126e-59bd-8a65-aa985cda6593 | VIA |  |  | AON_3V3 | 102.4 | 12.75 | 0.3 | 0.3 | 0.6 | 0.6 | True | Ordinary_continuous_bilateral_soldermask_tent_unfilled_uncapped | yes | yes | no | no |  | No blanket selected job; supplier must propose compatible exact finished-bore/ring/web profile and obtain recorded job acceptance | 50 | 20 | True | False | 10 | 25 | 35 | 10 | Final actual four mask/paste exports; closed bore seal required, no independent via stencil; only exact qualified same-terminal apertures may overlap TypeVII caps | False
2cfe0936-0494-47ab-9458-357a75ed5330 | VIA |  |  | u22_DVDT | 54.2 | 11.0 | 0.2 | 0.2 | 0.4 | 0.4 | True | TypeVII_full_nonconductive_fill_bilateral_copper_cap | inherit | inherit | yes | yes |  | No blanket selected job; supplier must propose compatible exact finished-bore/ring/web profile and obtain recorded job acceptance | 50 | 20 | False | False | 10 | 25 | 45 | 10 | Final actual four mask/paste exports; closed bore seal required, no independent via stencil; only exact qualified same-terminal apertures may overlap TypeVII caps | False
2d08e422-1e5b-552e-bd5f-b8f74102adb5 | VIA |  |  | OOB_USB_DN | 75.05 | 7.46 | 0.2 | 0.2 | 0.4 | 0.4 | True | Ordinary_continuous_bilateral_soldermask_tent_unfilled_uncapped | yes | yes | no | no |  | No blanket selected job; supplier must propose compatible exact finished-bore/ring/web profile and obtain recorded job acceptance | 50 | 20 | False | False |  | 25 |  |  | Final actual four mask/paste exports; closed bore seal required, no independent via stencil; only exact qualified same-terminal apertures may overlap TypeVII caps | False
2db40a6a-2401-4421-a6f5-cd8469154790 | VIA |  |  | RTL_SWR_EN | 41.4896 | 86.3417 | 0.2 | 0.2 | 0.45 | 0.45 | True | Ordinary_continuous_bilateral_soldermask_tent_unfilled_uncapped | yes | yes | no | no |  | No blanket selected job; supplier must propose compatible exact finished-bore/ring/web profile and obtain recorded job acceptance | 50 | 20 | False | False |  | 25 |  |  | Final actual four mask/paste exports; closed bore seal required, no independent via stencil; only exact qualified same-terminal apertures may overlap TypeVII caps | False
2de78d7f-3831-5572-8946-1e6c891f3511 | VIA |  |  | OOB_UART_RXD | 71.25 | 16.4 | 0.2 | 0.2 | 0.45 | 0.45 | True | Ordinary_continuous_bilateral_soldermask_tent_unfilled_uncapped | yes | yes | no | no |  | No blanket selected job; supplier must propose compatible exact finished-bore/ring/web profile and obtain recorded job acceptance | 50 | 20 | False | False |  | 25 |  |  | Final actual four mask/paste exports; closed bore seal required, no independent via stencil; only exact qualified same-terminal apertures may overlap TypeVII caps | False
2e3b3609-c8dd-50ee-b4cb-4dccccd55d14 | VIA |  |  | OOB_ADC_MODEM_CURRENT | 67.9 | 29.9 | 0.2 | 0.2 | 0.55 | 0.55 | True | Ordinary_continuous_bilateral_soldermask_tent_unfilled_uncapped | yes | yes | no | no |  | No blanket selected job; supplier must propose compatible exact finished-bore/ring/web profile and obtain recorded job acceptance | 50 | 20 | False | False |  | 25 |  |  | Final actual four mask/paste exports; closed bore seal required, no independent via stencil; only exact qualified same-terminal apertures may overlap TypeVII caps | False
2e3d8be8-0ed4-5e76-b80d-c22f27413b21 | VIA |  |  | GND | 15.2 | 45.7 | 0.3 | 0.3 | 0.6 | 0.6 | True | Ordinary_continuous_bilateral_soldermask_tent_unfilled_uncapped | yes | yes | no | no |  | No blanket selected job; supplier must propose compatible exact finished-bore/ring/web profile and obtain recorded job acceptance | 50 | 20 | False | False |  | 25 | 35 | 10 | Final actual four mask/paste exports; closed bore seal required, no independent via stencil; only exact qualified same-terminal apertures may overlap TypeVII caps | False
2e4e13ee-f02c-55de-ac2c-12902a8e8a4b | VIA |  |  | OOB_USB_MUX_DISABLE | 56.9146 | 23.2348 | 0.2 | 0.2 | 0.45 | 0.45 | True | Ordinary_continuous_bilateral_soldermask_tent_unfilled_uncapped | yes | yes | no | no |  | No blanket selected job; supplier must propose compatible exact finished-bore/ring/web profile and obtain recorded job acceptance | 50 | 20 | False | False |  | 25 |  |  | Final actual four mask/paste exports; closed bore seal required, no independent via stencil; only exact qualified same-terminal apertures may overlap TypeVII caps | False
2ecc5a17-ff21-5152-af36-4feeb19290e6 | VIA |  |  | OOB_MODEM_RESET | 57.6 | 12.75 | 0.2 | 0.2 | 0.45 | 0.45 | True | Ordinary_continuous_bilateral_soldermask_tent_unfilled_uncapped | yes | yes | no | no |  | No blanket selected job; supplier must propose compatible exact finished-bore/ring/web profile and obtain recorded job acceptance | 50 | 20 | False | False |  | 25 |  |  | Final actual four mask/paste exports; closed bore seal required, no independent via stencil; only exact qualified same-terminal apertures may overlap TypeVII caps | False
2edf9c9b-6f18-4ab6-bebf-f6b3cc2bb14e | VIA |  |  | GND | 17.234702 | 72.42528 | 0.3 | 0.3 | 0.55 | 0.55 | True | Ordinary_continuous_bilateral_soldermask_tent_unfilled_uncapped | yes | yes | no | no |  | No blanket selected job; supplier must propose compatible exact finished-bore/ring/web profile and obtain recorded job acceptance | 50 | 20 | True | False | 10 | 25 | 35 | 10 | Final actual four mask/paste exports; closed bore seal required, no independent via stencil; only exact qualified same-terminal apertures may overlap TypeVII caps | False
2f1da0eb-8aff-46c6-b485-3bd6c15a3910 | VIA |  |  | FCPO_CTRL_N | 32.0 | 56.7375 | 0.2 | 0.2 | 0.4 | 0.4 | True | TypeVII_full_nonconductive_fill_bilateral_copper_cap | yes | yes | yes | yes |  | No blanket selected job; supplier must propose compatible exact finished-bore/ring/web profile and obtain recorded job acceptance | 50 | 20 | False | False | 10 | 25 | 45 | 10 | Final actual four mask/paste exports; closed bore seal required, no independent via stencil; only exact qualified same-terminal apertures may overlap TypeVII caps | False
2f58ecc0-ea32-465e-9f3f-e3a4391ff924 | VIA |  |  | GND | 46.471704 | 86.232121 | 0.2 | 0.2 | 0.4 | 0.4 | True | Ordinary_continuous_bilateral_soldermask_tent_unfilled_uncapped | yes | yes | no | no |  | No blanket selected job; supplier must propose compatible exact finished-bore/ring/web profile and obtain recorded job acceptance | 50 | 20 | False | False |  | 25 |  |  | Final actual four mask/paste exports; closed bore seal required, no independent via stencil; only exact qualified same-terminal apertures may overlap TypeVII caps | False
2f81326c-c49f-5092-bc04-7163e4c9d448 | VIA |  |  | V3V7 | 16.5 | 67.5 | 0.4 | 0.4 | 0.8 | 0.8 | True | Ordinary_continuous_bilateral_soldermask_tent_unfilled_uncapped | yes | yes | no | no |  | No blanket selected job; supplier must propose compatible exact finished-bore/ring/web profile and obtain recorded job acceptance | 50 | 20 | False | False |  | 25 | 35 | 10 | Final actual four mask/paste exports; closed bore seal required, no independent via stencil; only exact qualified same-terminal apertures may overlap TypeVII caps | False
2fa7dd70-6300-43d1-b4bb-fabb1d2e641a | VIA |  |  | UIM2_VDD | 33.7247 | 53.8163 | 0.2 | 0.2 | 0.45 | 0.45 | True | Ordinary_continuous_bilateral_soldermask_tent_unfilled_uncapped | yes | yes | no | no |  | No blanket selected job; supplier must propose compatible exact finished-bore/ring/web profile and obtain recorded job acceptance | 50 | 20 | False | False |  | 25 |  |  | Final actual four mask/paste exports; closed bore seal required, no independent via stencil; only exact qualified same-terminal apertures may overlap TypeVII caps | False
2fd0475b-5935-538e-ac8c-1873ea2b8c3e | VIA |  |  | GND | 16.8 | 46.5 | 0.3 | 0.3 | 0.6 | 0.6 | True | Ordinary_continuous_bilateral_soldermask_tent_unfilled_uncapped | yes | yes | no | no |  | No blanket selected job; supplier must propose compatible exact finished-bore/ring/web profile and obtain recorded job acceptance | 50 | 20 | False | False |  | 25 |  |  | Final actual four mask/paste exports; closed bore seal required, no independent via stencil; only exact qualified same-terminal apertures may overlap TypeVII caps | False
2fd1476d-95c5-59a6-992c-02ec1b3ad878 | VIA |  |  | OOB_USB_SESSION_VALID | 35.2178 | 45.958 | 0.2 | 0.2 | 0.45 | 0.45 | True | Ordinary_continuous_bilateral_soldermask_tent_unfilled_uncapped | yes | yes | no | no |  | No blanket selected job; supplier must propose compatible exact finished-bore/ring/web profile and obtain recorded job acceptance | 50 | 20 | False | False |  | 25 |  |  | Final actual four mask/paste exports; closed bore seal required, no independent via stencil; only exact qualified same-terminal apertures may overlap TypeVII caps | False
2fdf3f83-fb17-5c57-b8de-a33fd94cf98a | VIA |  |  | OOB_EN | 60.2297 | 8.4001 | 0.2 | 0.2 | 0.45 | 0.45 | True | Ordinary_continuous_bilateral_soldermask_tent_unfilled_uncapped | yes | yes | no | no |  | No blanket selected job; supplier must propose compatible exact finished-bore/ring/web profile and obtain recorded job acceptance | 50 | 20 | False | False |  | 25 | 35 | 10 | Final actual four mask/paste exports; closed bore seal required, no independent via stencil; only exact qualified same-terminal apertures may overlap TypeVII caps | False
2ff446af-17bc-58ba-b631-c4a140d1c8fe | VIA |  |  | USB_PROTECT_DP | 7.55 | 82.4 | 0.2 | 0.2 | 0.45 | 0.45 | True | Ordinary_continuous_bilateral_soldermask_tent_unfilled_uncapped | yes | yes | no | no |  | No blanket selected job; supplier must propose compatible exact finished-bore/ring/web profile and obtain recorded job acceptance | 50 | 20 | False | False |  | 25 | 35 | 10 | Final actual four mask/paste exports; closed bore seal required, no independent via stencil; only exact qualified same-terminal apertures may overlap TypeVII caps | False
302df963-93ab-5cbb-a308-ef6775691af5 | VIA |  |  | AON_3V3 | 106.1 | 19.9 | 0.3 | 0.3 | 0.6 | 0.6 | True | Ordinary_continuous_bilateral_soldermask_tent_unfilled_uncapped | yes | yes | no | no |  | No blanket selected job; supplier must propose compatible exact finished-bore/ring/web profile and obtain recorded job acceptance | 50 | 20 | True | False | 10 | 25 | 35 | 10 | Final actual four mask/paste exports; closed bore seal required, no independent via stencil; only exact qualified same-terminal apertures may overlap TypeVII caps | False
3035ab25-e149-4d20-8608-9e50faa17a0b | VIA |  |  | V0V95 | 55.8 | 89.9 | 0.2 | 0.2 | 0.45 | 0.45 | True | Ordinary_continuous_bilateral_soldermask_tent_unfilled_uncapped | yes | yes | no | no |  | No blanket selected job; supplier must propose compatible exact finished-bore/ring/web profile and obtain recorded job acceptance | 50 | 20 | False | False |  | 25 |  |  | Final actual four mask/paste exports; closed bore seal required, no independent via stencil; only exact qualified same-terminal apertures may overlap TypeVII caps | False
3069847d-50df-5be2-93a6-114df553da42 | VIA |  |  | AON_3V3 | 74.05 | 6.1 | 0.2 | 0.2 | 0.4 | 0.4 | True | Ordinary_continuous_bilateral_soldermask_tent_unfilled_uncapped | yes | yes | no | no |  | No blanket selected job; supplier must propose compatible exact finished-bore/ring/web profile and obtain recorded job acceptance | 50 | 20 | False | False |  | 25 | 35 | 10 | Final actual four mask/paste exports; closed bore seal required, no independent via stencil; only exact qualified same-terminal apertures may overlap TypeVII caps | False
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
