ripclap/rm520n-carrier/hardware/assembly-preview/models/37b74fdce2fc6bc4-37b74fdce2fc6bc4-LFPAK56.step

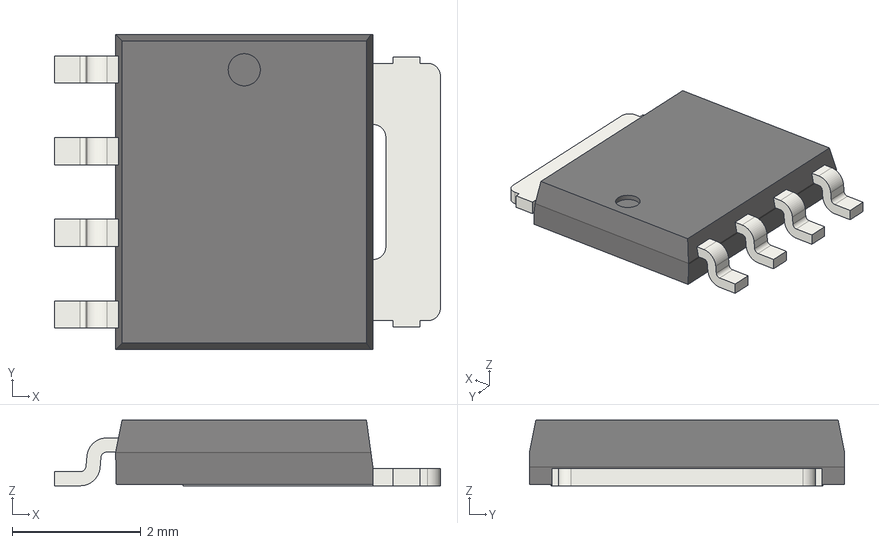
[picture p3: CAD file, 2026-10-13]
hardware/assembly-preview/models/37b74fdce2fc6bc4-37b74fdce2fc6bc4-LFPAK56.step
6.00 x 4.90 x 1.02 mm
adbeea53-9c39-11ed-93f0-dde97e994e83_part
adbeea54-9c39-11ed-93f0-dde97e994e83_part
adbeea55-9c39-11ed-93f0-dde97e994e83_part
