ripclap/rm520n-carrier/hardware/assembly-preview/models/f5d1ea5c47935091-f5d1ea5c47935091-R_1206_3216Metric.step

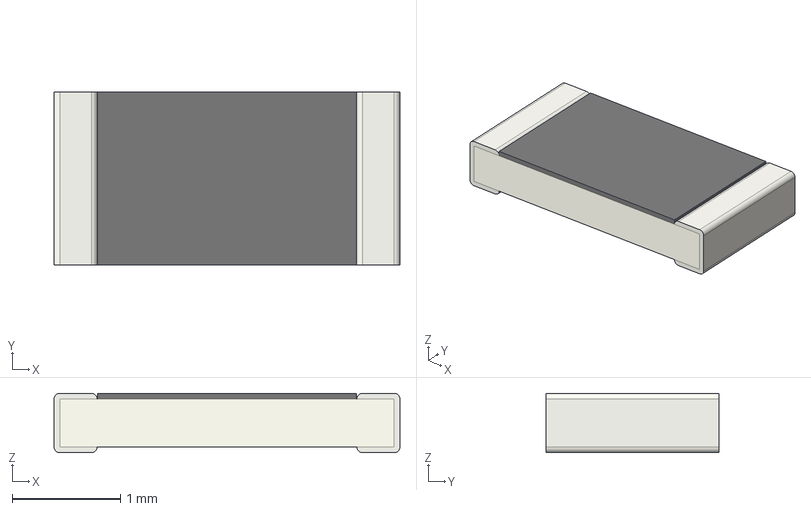
[picture p4: CAD file, 2026-10-13]
hardware/assembly-preview/models/f5d1ea5c47935091-f5d1ea5c47935091-R_1206_3216Metric.step
3.20 x 1.60 x 0.55 mm
