ripclap/rm520n-carrier/hardware/assembly-preview/models/9a669c1a2f1ea25b-9a669c1a2f1ea25b-9a669c1a2f1ea25b-9a669c1a2f1ea25b-9a669c1a2f1ea25b-9a669c1a2f1ea25b-9a669c1a2f1ea25b-C_0805_2012Metric.step

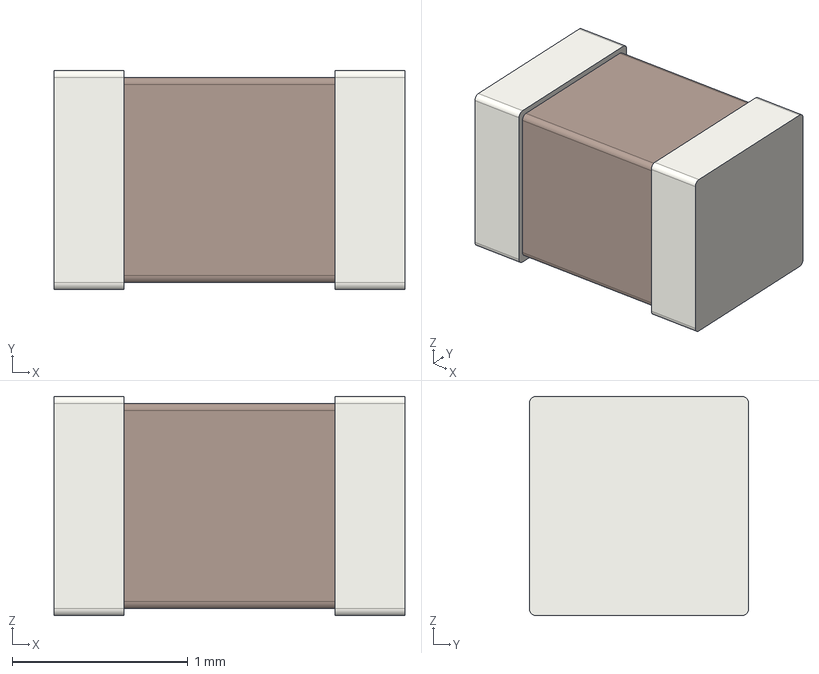
[picture p5: CAD file, 2026-10-13]
hardware/assembly-preview/models/9a669c1a2f1ea25b-9a669c1a2f1ea25b-9a669c1a2f1ea25b-9a669c1a2f1ea25b-9a669c1a2f1ea25b-9a669c1a2f1ea25b-9a669c1a2f1ea25b-C_0805_2012Metric.step
2.00 x 1.25 x 1.25 mm
