ripclap/rm520n-carrier/hardware/assembly-preview/models/b3dc4065573abc72-b3dc4065573abc72-b3dc4065573abc72-b3dc4065573abc72-b3dc4065573abc72-b3dc4065573abc72-b3dc4065573abc72-D_SOD-123.step

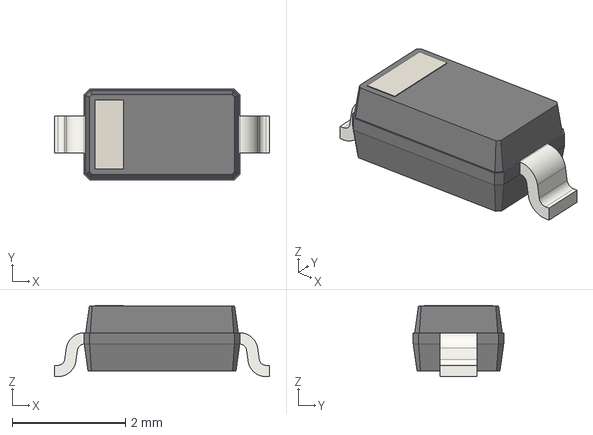
[picture p6: CAD file, 2026-10-13]
hardware/assembly-preview/models/b3dc4065573abc72-b3dc4065573abc72-b3dc4065573abc72-b3dc4065573abc72-b3dc4065573abc72-b3dc4065573abc72-b3dc4065573abc72-D_SOD-123.step
3.80 x 1.60 x 1.26 mm
