ripclap/rm520n-carrier/hardware/assembly-preview/models/30dab4c2e22239b7-30dab4c2e22239b7-30dab4c2e22239b7-30dab4c2e22239b7-30dab4c2e22239b7-30dab4c2e22239b7-30dab4c2e22239b7-D_SMC.step

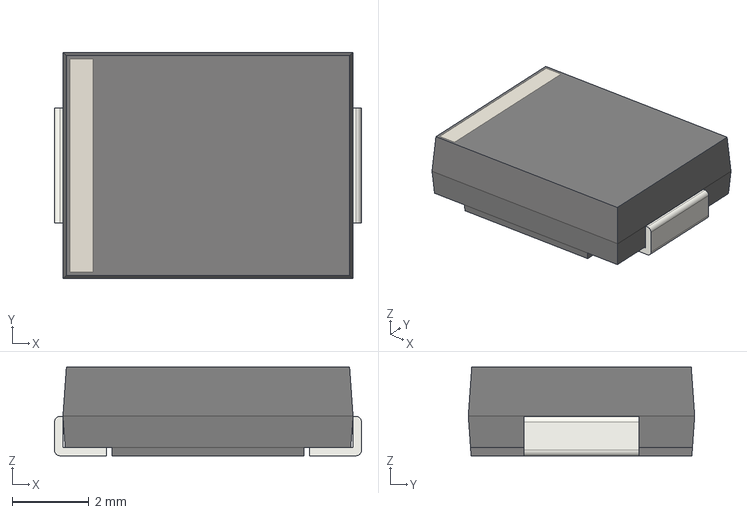
[picture p7: CAD file, 2026-10-13]
hardware/assembly-preview/models/30dab4c2e22239b7-30dab4c2e22239b7-30dab4c2e22239b7-30dab4c2e22239b7-30dab4c2e22239b7-30dab4c2e22239b7-30dab4c2e22239b7-D_SMC.step
8.00 x 5.90 x 2.31 mm
