ripclap/rm520n-carrier/hardware/assembly-preview/models/4b5ee4da023d7603-4b5ee4da023d7603-4b5ee4da023d7603-4b5ee4da023d7603-4b5ee4da023d7603-4b5ee4da023d7603-4b5ee4da023d7603-SW_SPST_B3U-1000P.step

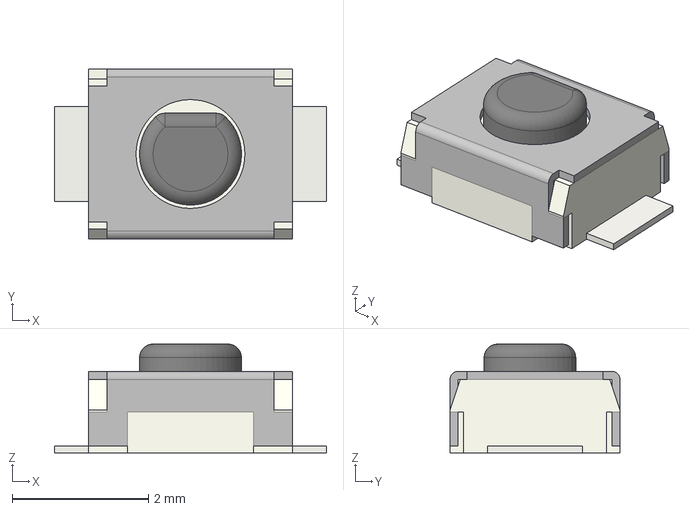
[picture p8: CAD file, 2026-10-13]
hardware/assembly-preview/models/4b5ee4da023d7603-4b5ee4da023d7603-4b5ee4da023d7603-4b5ee4da023d7603-4b5ee4da023d7603-4b5ee4da023d7603-4b5ee4da023d7603-SW_SPST_B3U-1000P.step
4.00 x 2.50 x 1.60 mm
