ripclap/rm520n-carrier/hardware/assembly-preview/models/db9f56772f8759b9-db9f56772f8759b9-db9f56772f8759b9-db9f56772f8759b9-db9f56772f8759b9-db9f56772f8759b9-db9f56772f8759b9-CP_Elec_6.3x5.9.step

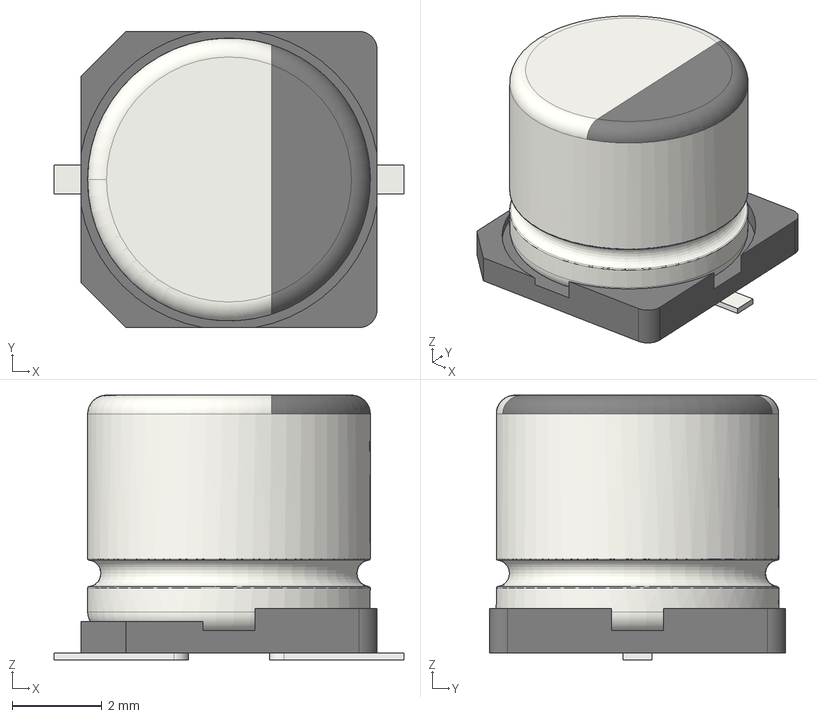
[picture p9: CAD file, 2026-10-13]
hardware/assembly-preview/models/db9f56772f8759b9-db9f56772f8759b9-db9f56772f8759b9-db9f56772f8759b9-db9f56772f8759b9-db9f56772f8759b9-db9f56772f8759b9-CP_Elec_6.3x5.9.step
7.80 x 6.60 x 5.90 mm
