ripclap/rm520n-carrier/hardware/assembly-preview/models/ded342cdb394fb45-ded342cdb394fb45-ded342cdb394fb45-ded342cdb394fb45-ded342cdb394fb45-ded342cdb394fb45-ded342cdb394fb45-R_0805_2012Metric.step

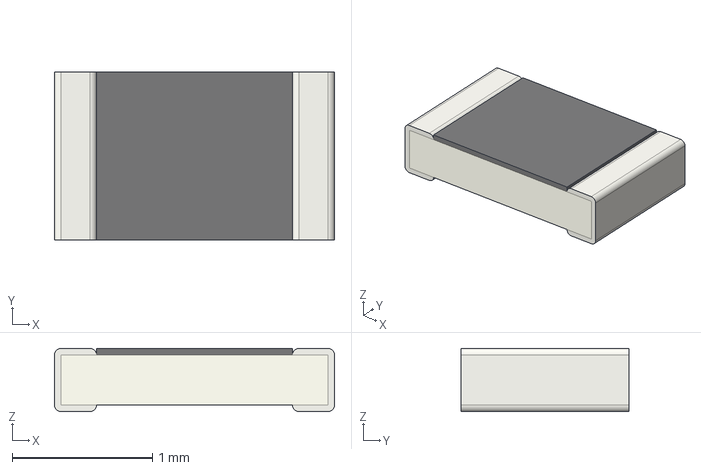
[picture p10: CAD file, 2026-10-13]
hardware/assembly-preview/models/ded342cdb394fb45-ded342cdb394fb45-ded342cdb394fb45-ded342cdb394fb45-ded342cdb394fb45-ded342cdb394fb45-ded342cdb394fb45-R_0805_2012Metric.step
2.00 x 1.20 x 0.45 mm
