ripclap/rm520n-carrier/hardware/assembly-preview/models/c9fe686b4d1b5692-c9fe686b4d1b5692-c9fe686b4d1b5692-c9fe686b4d1b5692-c9fe686b4d1b5692-c9fe686b4d1b5692-c9fe686b4d1b5692-SOT-23-6.step

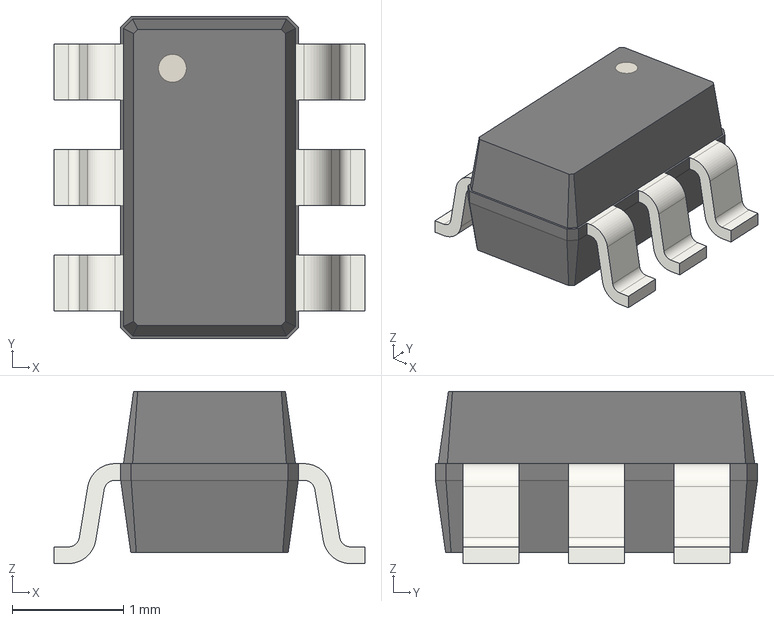
[picture p11: CAD file, 2026-10-13]
hardware/assembly-preview/models/c9fe686b4d1b5692-c9fe686b4d1b5692-c9fe686b4d1b5692-c9fe686b4d1b5692-c9fe686b4d1b5692-c9fe686b4d1b5692-c9fe686b4d1b5692-SOT-23-6.step
2.80 x 2.90 x 1.55 mm
