ripclap/rm520n-carrier/hardware/assembly-preview/models/03e44c4b2b727b8d-03e44c4b2b727b8d-03e44c4b2b727b8d-03e44c4b2b727b8d-03e44c4b2b727b8d-03e44c4b2b727b8d-03e44c4b2b727b8d-C_0402_1005Metric.step

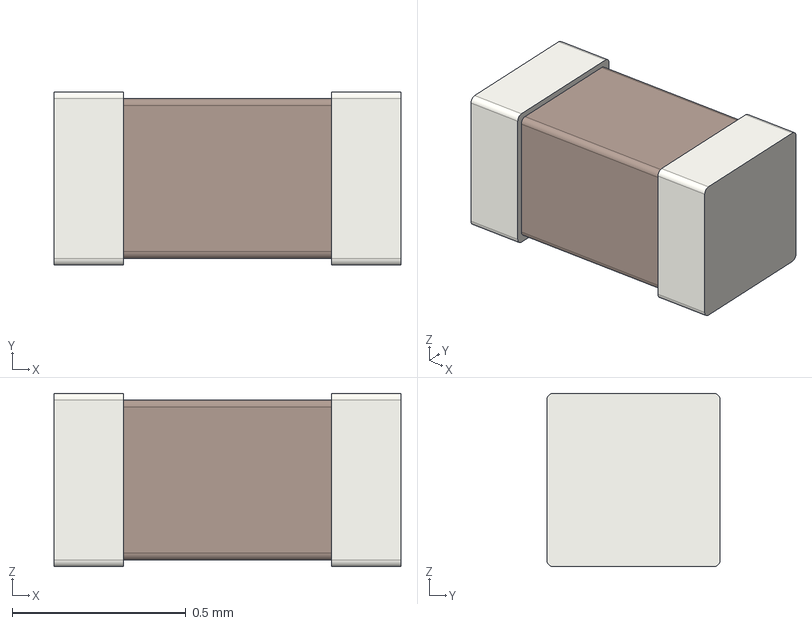
[picture p12: CAD file, 2026-10-13]
hardware/assembly-preview/models/03e44c4b2b727b8d-03e44c4b2b727b8d-03e44c4b2b727b8d-03e44c4b2b727b8d-03e44c4b2b727b8d-03e44c4b2b727b8d-03e44c4b2b727b8d-C_0402_1005Metric.step
1.00 x 0.5 x 0.5 mm
