ripclap/rm520n-carrier/hardware/assembly-preview/models/07f46cff378d30e6-07f46cff378d30e6-07f46cff378d30e6-07f46cff378d30e6-07f46cff378d30e6-07f46cff378d30e6-07f46cff378d30e6-SOIC-8_3.9x4.9mm_P1.27mm.step

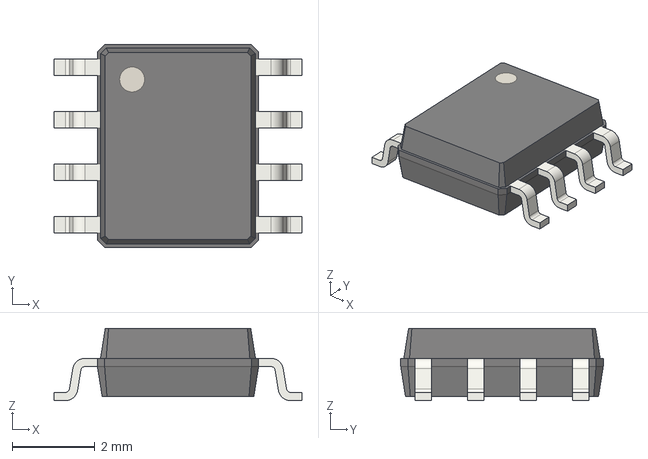
[picture p13: CAD file, 2026-10-13]
hardware/assembly-preview/models/07f46cff378d30e6-07f46cff378d30e6-07f46cff378d30e6-07f46cff378d30e6-07f46cff378d30e6-07f46cff378d30e6-07f46cff378d30e6-SOIC-8_3.9x4.9mm_P1.27mm.step
6.00 x 4.90 x 1.75 mm
