ripclap/rm520n-carrier/hardware/assembly-preview/models/ebf3894bb261351d-ebf3894bb261351d-ebf3894bb261351d-ebf3894bb261351d-ebf3894bb261351d-ebf3894bb261351d-ebf3894bb261351d-L_Bourns_SRP5030T.step

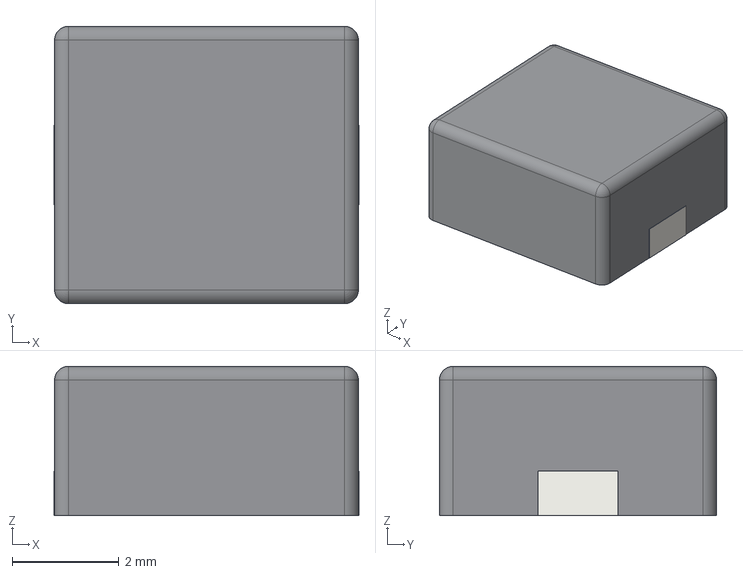
[picture p14: CAD file, 2026-10-13]
hardware/assembly-preview/models/ebf3894bb261351d-ebf3894bb261351d-ebf3894bb261351d-ebf3894bb261351d-ebf3894bb261351d-ebf3894bb261351d-ebf3894bb261351d-L_Bourns_SRP5030T.step
5.72 x 5.20 x 2.80 mm
