ripclap/rm520n-carrier/hardware/assembly-preview/models/29a492be6ffb3c44-29a492be6ffb3c44-29a492be6ffb3c44-29a492be6ffb3c44-29a492be6ffb3c44-29a492be6ffb3c44-29a492be6ffb3c44-Mounting_Wuerth_WA-SMSI-M2_H2.5mm_9774025243.step

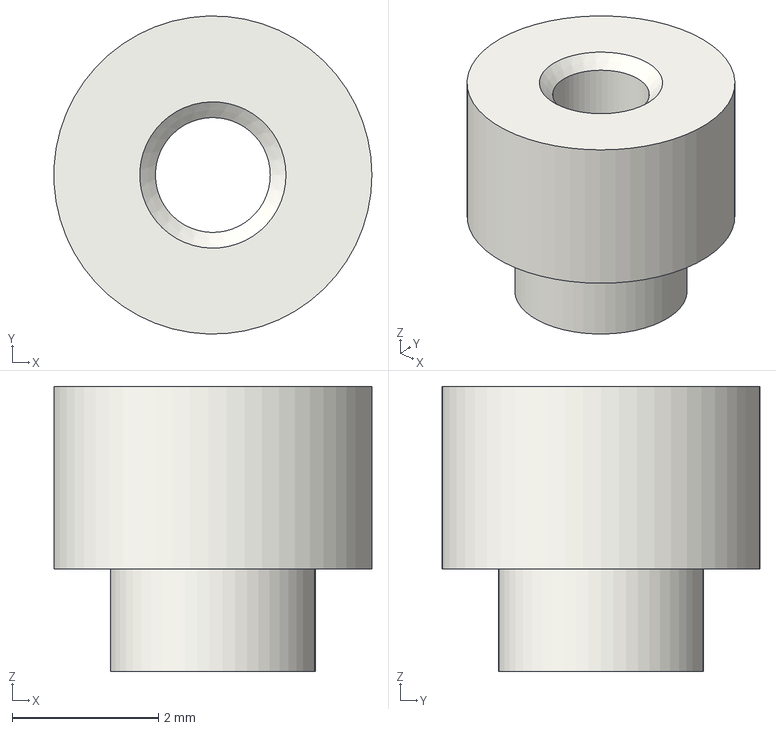
[picture p15: CAD file, 2026-10-13]
hardware/assembly-preview/models/29a492be6ffb3c44-29a492be6ffb3c44-29a492be6ffb3c44-29a492be6ffb3c44-29a492be6ffb3c44-29a492be6ffb3c44-29a492be6ffb3c44-Mounting_Wuerth_WA-SMSI-M2_H2.5mm_9774025243.st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
4.35 x 4.35 x 3.90 mm
