ripclap/rm520n-carrier/hardware/assembly-preview/models/bb861ac13b1fa370-bb861ac13b1fa370-bb861ac13b1fa370-bb861ac13b1fa370-bb861ac13b1fa370-bb861ac13b1fa370-bb861ac13b1fa370-U.FL_Hirose_U.FL-R-SMT-1_Vertical.step

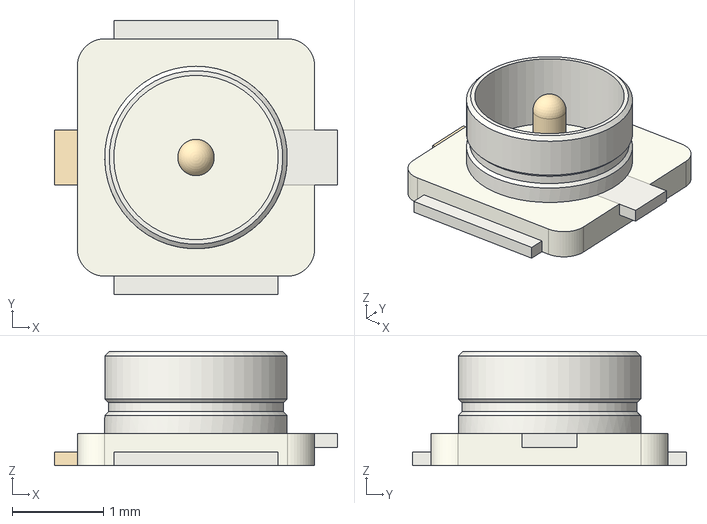
[picture p16: CAD file, 2026-10-13]
hardware/assembly-preview/models/bb861ac13b1fa370-bb861ac13b1fa370-bb861ac13b1fa370-bb861ac13b1fa370-bb861ac13b1fa370-bb861ac13b1fa370-bb861ac13b1fa370-U.FL_Hirose_U.FL-R-SMT-1_Vertical.step
3.10 x 3.00 x 1.25 mm
