ripclap/rm520n-carrier/hardware/assembly-preview/models/4857b3dc717675bf-4857b3dc717675bf-4857b3dc717675bf-4857b3dc717675bf-4857b3dc717675bf-4857b3dc717675bf-4857b3dc717675bf-C_0603_1608Metric.step

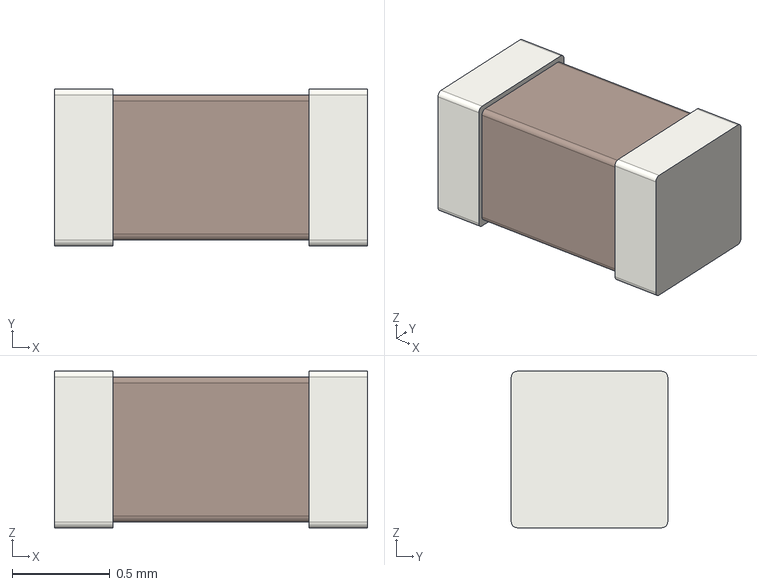
[picture p17: CAD file, 2026-10-13]
hardware/assembly-preview/models/4857b3dc717675bf-4857b3dc717675bf-4857b3dc717675bf-4857b3dc717675bf-4857b3dc717675bf-4857b3dc717675bf-4857b3dc717675bf-C_0603_1608Metric.step
1.60 x 0.8 x 0.8 mm
