ripclap/rm520n-carrier/hardware/assembly-preview/models/1a2107eecea604a6-1a2107eecea604a6-1a2107eecea604a6-1a2107eecea604a6-1a2107eecea604a6-1a2107eecea604a6-1a2107eecea604a6-CP_Elec_8x6.7.step

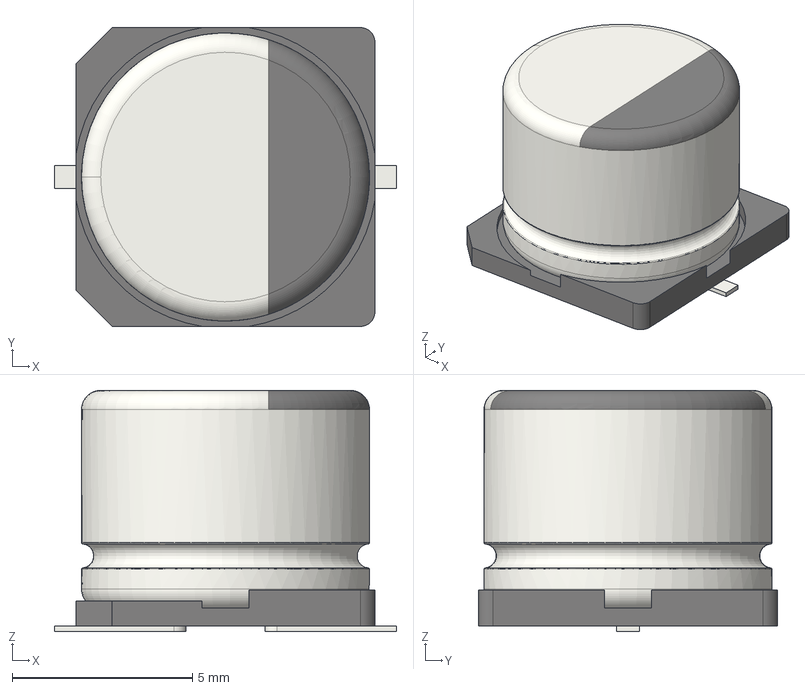
[picture p18: CAD file, 2026-10-13]
hardware/assembly-preview/models/1a2107eecea604a6-1a2107eecea604a6-1a2107eecea604a6-1a2107eecea604a6-1a2107eecea604a6-1a2107eecea604a6-1a2107eecea604a6-CP_Elec_8x6.7.step
9.50 x 8.30 x 6.70 mm
