ripclap/rm520n-carrier/hardware/assembly-preview/models/720a6eab0024069b-720a6eab0024069b-720a6eab0024069b-720a6eab0024069b-720a6eab0024069b-720a6eab0024069b-720a6eab0024069b-SOT-23-5.step

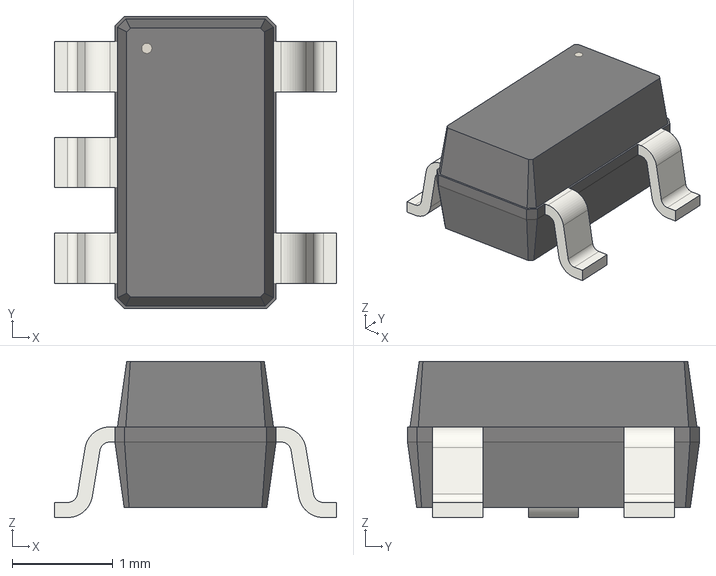
[picture p19: CAD file, 2026-10-13]
hardware/assembly-preview/models/720a6eab0024069b-720a6eab0024069b-720a6eab0024069b-720a6eab0024069b-720a6eab0024069b-720a6eab0024069b-720a6eab0024069b-SOT-23-5.step
2.80 x 2.90 x 1.55 mm
