ripclap/rm520n-carrier/hardware/assembly-preview/models/dd5d1711204e1d8d-dd5d1711204e1d8d-dd5d1711204e1d8d-dd5d1711204e1d8d-dd5d1711204e1d8d-dd5d1711204e1d8d-dd5d1711204e1d8d-SOT-23.step

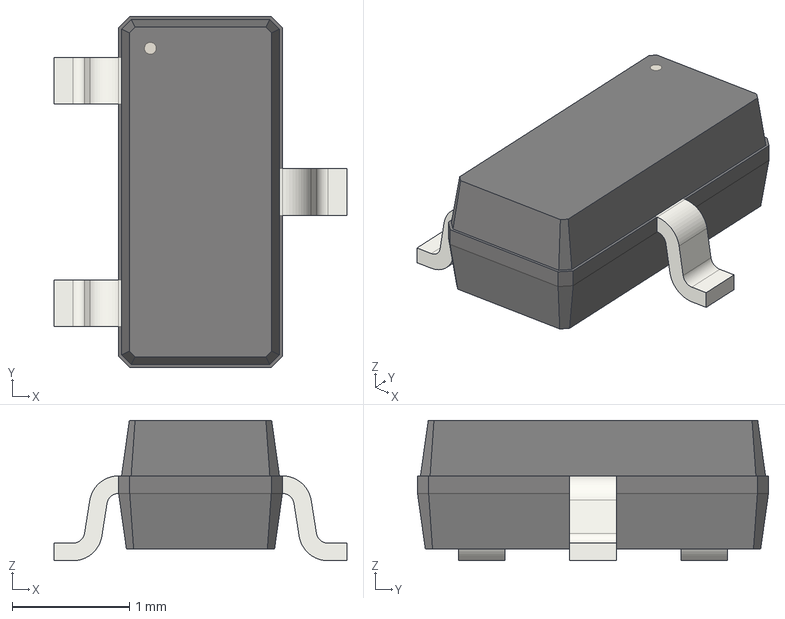
[picture p20: CAD file, 2026-10-13]
hardware/assembly-preview/models/dd5d1711204e1d8d-dd5d1711204e1d8d-dd5d1711204e1d8d-dd5d1711204e1d8d-dd5d1711204e1d8d-dd5d1711204e1d8d-dd5d1711204e1d8d-SOT-23.step
2.50 x 3.00 x 1.20 mm
