ripclap/rm520n-carrier/hardware/assembly-preview/models/cf28a51742b2e310-TSSOP-8_3x3mm_P0.65mm.step

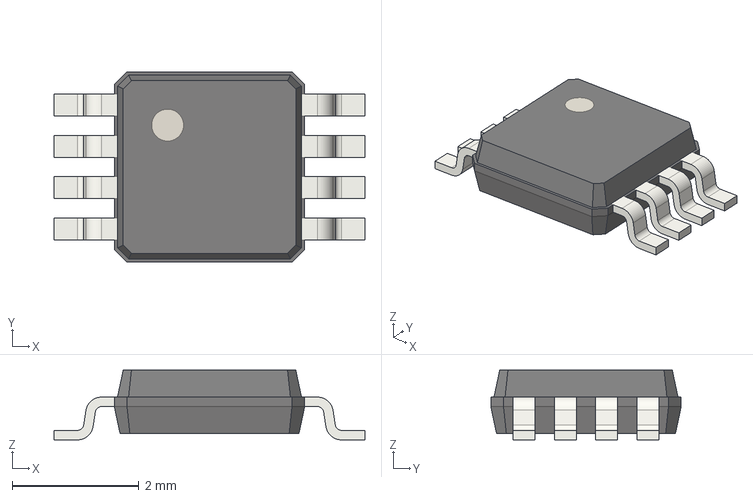
[picture p21: CAD file, 2026-10-13]
hardware/assembly-preview/models/cf28a51742b2e310-TSSOP-8_3x3mm_P0.65mm.step
4.90 x 3.00 x 1.10 mm
