ripclap/rm520n-carrier/hardware/assembly-preview/models/3ee5786aae561909-3ee5786aae561909-3ee5786aae561909-3ee5786aae561909-3ee5786aae561909-3ee5786aae561909-3ee5786aae561909-TSSOP-14_4.4x5mm_P0.65mm.step

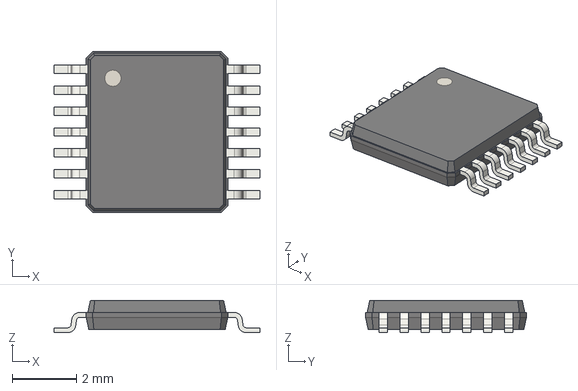
[picture p22: CAD file, 2026-10-13]
hardware/assembly-preview/models/3ee5786aae561909-3ee5786aae561909-3ee5786aae561909-3ee5786aae561909-3ee5786aae561909-3ee5786aae561909-3ee5786aae561909-TSSOP-14_4.4x5mm_P0.65mm.step
6.40 x 5.00 x 1.00 mm
