ripclap/rm520n-carrier/(list of files, cad)

Other CAD files:
hardware/assembly-preview/models/b0136ad7160588d2-b0136ad7160588d2-b0136ad7160588d2-b0136ad7160588d2-b0136ad7160588d2-b0136ad7160588d2-b0136ad7160588d2-L_0603_1608Metric.step
hardware/assembly-preview/models/029466277d91e9f5-029466277d91e9f5-029466277d91e9f5-029466277d91e9f5-029466277d91e9f5-029466277d91e9f5-029466277d91e9f5-D_SMB.step
hardware/assembly-preview/models/1875571c326d0d9e-1875571c326d0d9e-1875571c326d0d9e-1875571c326d0d9e-1875571c326d0d9e-1875571c326d0d9e-1875571c326d0d9e-R_0603_1608Metric.step
hardware/assembly-preview/models/1875571c326d0d9e-1875571c326d0d9e-R_0603_1608Metric.step
hardware/assembly-preview/models/1875571c326d0d9e-R_0603_1608Metric.step
hardware/assembly-preview/models/706322f42d9793eb-706322f42d9793eb-706322f42d9793eb-706322f42d9793eb-706322f42d9793eb-706322f42d9793eb-706322f42d9793eb-TSSOP-24_4.4x7.8mm_P0.65mm.step
hardware/assembly-preview/models/7287616fdad677e9-7287616fdad677e9-7287616fdad677e9-7287616fdad677e9-7287616fdad677e9-7287616fdad677e9-7287616fdad677e9-JST_XH_B2B-XH-A_1x02_P2.50mm_Vertical.step
hardware/assembly-preview/models/91507e5af4251cb4-91507e5af4251cb4-91507e5af4251cb4-91507e5af4251cb4-91507e5af4251cb4-91507e5af4251cb4-91507e5af4251cb4-R_0402_1005Metric.step
hardware/assembly-preview/models/91507e5af4251cb4-91507e5af4251cb4-91507e5af4251cb4-91507e5af4251cb4-91507e5af4251cb4-91507e5af4251cb4-R_0402_1005Metric.step
hardware/assembly-preview/models/91507e5af4251cb4-91507e5af4251cb4-R_0402_1005Metric.step
hardware/assembly-preview/models/91507e5af4251cb4-R_0402_1005Metric.step
hardware/assembly-preview/models/98343205ec260ec1-98343205ec260ec1-98343205ec260ec1-98343205ec260ec1-98343205ec260ec1-98343205ec260ec1-98343205ec260ec1-LED_0603_1608Metric.step
hardware/assembly-preview/models/f8510481c5044113-C_1210_3225Metric.step
