ripclap/rm520n-carrier/manufacturing/rev-a/fabrication/IPC356-net-name-map.csv

IPC-D-356 net token | Full native KiCad net name
(U749-3Y-PAD2) | unconnected-(U749-3Y-Pad2)
(U756-CT-PAD4) | unconnected-(U756-CT-Pad4)
(U770-NC-PAD1) | unconnected-(U770-NC-Pad1)
(U8-SWIO-PAD2) | unconnected-(U8-SWIO-Pad2)
(U801-NC-PAD4) | unconnected-(U801-NC-Pad4)
(U801-NC-PAD5) | unconnected-(U801-NC-Pad5)
(U801-NC-PAD8) | unconnected-(U801-NC-Pad8)
(U840-P2-PAD3) | unconnected-(U840-P2-Pad3)
-(U10-NC-PAD4) | unconnected-(U10-NC-Pad4)
-(U10-NC-PAD5) | unconnected-(U10-NC-Pad5)
-(U10-NC-PAD7) | unconnected-(U10-NC-Pad7)
-(U13-NC-PAD7) | unconnected-(U13-NC-Pad7)
-(U21-PG-PAD3) | unconnected-(U21-PG-Pad3)
-(U22-PG-PAD3) | unconnected-(U22-PG-Pad3)
-(U30-NC-PAD1) | unconnected-(U30-NC-Pad1)
-(U31-NC-PAD4) | unconnected-(U31-NC-Pad4)
-(U8-NC4-PAD4) | unconnected-(U8-NC4-Pad4)
-(U8-NC5-PAD5) | unconnected-(U8-NC5-Pad5)
-GPIO18-PAD24) | unconnected-(U800-GPIO18-Pad24)
-GPIO33-PAD38) | unconnected-(U800-GPIO33-Pad38)
-GPIO34-PAD39) | unconnected-(U800-GPIO34-Pad39)
-GPIO35-PAD40) | unconnected-(U800-GPIO35-Pad40)
-GPIO36-PAD41) | unconnected-(U800-GPIO36-Pad41)
-SPICSB-PAD26) | unconnected-(U10-SPICSB-Pad26)
0-GPIO6-PAD11) | unconnected-(U800-GPIO6-Pad11)
0-LNA_IN-PAD1) | unconnected-(U800-LNA_IN-Pad1)
00-GPIO3-PAD8) | unconnected-(U800-GPIO3-Pad8)
00-PIN_2-PAD2) | unconnected-(J800-Pin_2-Pad2)
01-DIO3-PAD18) | unconnected-(U801-DIO3-Pad18)
2_PCIE_PERST_N | M2_PCIE_PERST_N
4-C6_VPP-PAD6) | unconnected-(J4-C6_VPP-Pad6)
52-ALERT-PAD3) | unconnected-(U752-ALERT-Pad3)
AON_3V3 | AON_3V3
AON_PG | AON_PG
ASSIVE_BUCK_IN | PASSIVE_BUCK_IN
ASSIVE_FUSED_P | PASSIVE_FUSED_P
AUX_GATE | AUX_GATE
BS_BRANCH_1 | BS_BRANCH_1
BS_BRANCH_2 | BS_BRANCH_2
BS_BRANCH_3 | BS_BRANCH_3
BS_BRANCH_4 | BS_BRANCH_4
BS_STAR | BS_STAR
BUCK_BOOT_RC | BUCK_BOOT_RC
BUCK_FB | BUCK_FB
BUCK_MODE | BUCK_MODE
BUCK_PG | BUCK_PG
BUCK_SW | BUCK_SW
BUCK_UVLO | BUCK_UVLO
BUCK_VCC | BUCK_VCC
B_AUX12_SCALED | OOB_AUX12_SCALED
B_POE12_SCALED | OOB_POE12_SCALED
B_RADIO_NRESET | OOB_RADIO_NRESET
B_WATCHDOG_WDI | OOB_WATCHDOG_WDI
CABLE0_N | CABLE0_N
CABLE0_P | CABLE0_P
CABLE1_N | CABLE1_N
CABLE1_P | CABLE1_P
CABLE2_N | CABLE2_N
CABLE2_P | CABLE2_P
CABLE3_N | CABLE3_N
CABLE3_P | CABLE3_P
CABLE_PWR_N | CABLE_PWR_N
CORE_SENSE | CORE_SENSE
CTED-(J3-PAD1) | unconnected-(J3-Pad1)
D-(U1-TM-PAD5) | unconnected-(U1-TM-Pad5)
D-(U3-PG-PAD5) | unconnected-(U3-PG-Pad5)
D-(U7-NC-PAD5) | unconnected-(U7-NC-Pad5)
DEM_EFUSE_DVDT | MODEM_EFUSE_DVDT
DEM_EFUSE_ILIM | MODEM_EFUSE_ILIM
DEM_EFUSE_PGTH | MODEM_EFUSE_PGTH
DEM_EN_ALLOWED | MODEM_EN_ALLOWED
DEM_VCC_SCALED | OOB_MODEM_VCC_SCALED
DIO_IO_DISABLE | OOB_RADIO_IO_DISABLE
DIO_POWER_GOOD | OOB_RADIO_POWER_GOOD
EE_CS | EE_CS
EE_DI | EE_DI
EE_DO | EE_DO
EE_SK | EE_SK
EE_VDD | EE_VDD
ELECT_INTERNAL | OOB_USB_SELECT_INTERNAL
EN_3V3 | EN_3V3
ESIM_CLK | ESIM_CLK
ESIM_IO | ESIM_IO
ESIM_RST | ESIM_RST
E_SENSE_KELVIN | PASSIVE_SENSE_KELVIN
FCPO_CTRL_N | FCPO_CTRL_N
GND | GND
GRANT_CT | GRANT_CT
H}SPIHD-PAD30) | unconnected-(U800-GPIO27{slash}SPIHD-Pad30)
H}SPIWP-PAD31) | unconnected-(U800-GPIO28{slash}SPIWP-Pad31)
IO_RUN_ALLOWED | OOB_RADIO_RUN_ALLOWED
IO_SCK_MCU_DRV | OOB_RADIO_SCK_MCU_DRV
IVE_UV_DIV_TOP | PASSIVE_UV_DIV_TOP
J5-SBU1-PADA8) | unconnected-(J5-SBU1-PadA8)
J5-SBU2-PADB8) | unconnected-(J5-SBU2-PadB8)
LASH}INT-PAD5) | unconnected-(U840-P3{slash}INT-Pad5)
LEDG_A | LEDG_A
LEDG_K | LEDG_K
LEDY_A | LEDY_A
LEDY_K | LEDY_K
LED_WWAN_A | LED_WWAN_A
M2_FCPO_N | M2_FCPO_N
M2_LED_N | M2_LED_N
M2_PCIE_WAKE_N | M2_PCIE_WAKE_N
M2_RESET_N | M2_RESET_N
M2_WDIS1_N | M2_WDIS1_N
MAIN_FB_TOP | MAIN_FB_TOP
MDI0_N | MDI0_N
MDI0_P | MDI0_P
MDI1_N | MDI1_N
MDI1_P | MDI1_P
MDI2_N | MDI2_N
MDI2_P | MDI2_P
MDI3_N | MDI3_N
MDI3_P | MDI3_P
MDI_CT | MDI_CT
MODEM_CT | MODEM_CT
MODEM_PG | MODEM_PG
MODEM_SENSE | MODEM_SENSE
MODEM_START_OK | MODEM_START_OK
M_EFUSE_ITIMER | MODEM_EFUSE_ITIMER
N/C
OB_MODEM_RESET | OOB_MODEM_RESET
OB_MON_MAIN_IN | OOB_MON_MAIN_IN
ODEM_EFUSE_OVP | MODEM_EFUSE_OVP
ODEM_ENABLE_MR | MODEM_ENABLE_MR
ON_MODEM_PG_IN | OOB_MON_MODEM_PG_IN
ON_TO_ISOLATOR | MODEM_IMON_TO_ISOLATOR
OOB_915_ANT | OOB_915_ANT
OOB_ADC_AUX12 | OOB_ADC_AUX12
OOB_ADC_POE12 | OOB_ADC_POE12
OOB_ADC_V12 | OOB_ADC_V12
OOB_AON_EN | OOB_AON_EN
OOB_BOOT_N | OOB_BOOT_N
OOB_EN | OOB_EN
OOB_FB | OOB_FB
OOB_I2C_SCL | OOB_I2C_SCL
OOB_I2C_SDA | OOB_I2C_SDA
OOB_MAIN_OK | OOB_MAIN_OK
OOB_MODEM_OFF | OOB_MODEM_OFF
OOB_MODEM_PG | OOB_MODEM_PG
OOB_MODEM_RUN | OOB_MODEM_RUN
OOB_MODEM_STOP | OOB_MODEM_STOP
OOB_NRSS | OOB_NRSS
OOB_QUAL_REF | OOB_QUAL_REF
OOB_RADIO_3V3 | OOB_RADIO_3V3
OOB_RADIO_BUSY | OOB_RADIO_BUSY
OOB_RADIO_DIO1 | OOB_RADIO_DIO1
OOB_RADIO_ILM | OOB_RADIO_ILM
OOB_RADIO_MISO | OOB_RADIO_MISO
OOB_RADIO_MOSI | OOB_RADIO_MOSI
OOB_RADIO_NSS | OOB_RADIO_NSS
OOB_RADIO_RUN | OOB_RADIO_RUN
OOB_RADIO_RXEN | OOB_RADIO_RXEN
OOB_RADIO_SCK | OOB_RADIO_SCK
OOB_RADIO_TXEN | OOB_RADIO_TXEN
OOB_SCONF | OOB_SCONF
OOB_SW | OOB_SW
OOB_UART_RXD | OOB_UART_RXD
OOB_UART_TXD | OOB_UART_TXD
OOB_USB_DN | OOB_USB_DN
OOB_USB_DP | OOB_USB_DP
OOB_V12_SCALED | OOB_V12_SCALED
OOB_VDD_SPI | OOB_VDD_SPI
OOB_WD_ENABLE | OOB_WD_ENABLE
OOB_WD_RESET_N | OOB_WD_RESET_N
OOB_XTAL_N | OOB_XTAL_N
OOB_XTAL_P | OOB_XTAL_P
O_DIO1_MCU_DRV | OOB_RADIO_DIO1_MCU_DRV
O_RESET_ASSERT | OOB_RADIO_RESET_ASSERT
PASSIVE_EN | PASSIVE_EN
PASSIVE_GATE | PASSIVE_GATE
PASSIVE_HS_OUT | PASSIVE_HS_OUT
PASSIVE_OV | PASSIVE_OV
PASSIVE_PWR | PASSIVE_PWR
PASSIVE_SENSE | PASSIVE_SENSE
PASSIVE_TIMER | PASSIVE_TIMER
PASSIVE_UV | PASSIVE_UV
PASSIVE_VREF | PASSIVE_VREF
PCIE_CLKREQ_N | PCIE_CLKREQ_N
PCIE_CT | PCIE_CT
PCIE_PERST_N | PCIE_PERST_N
PCIE_QUAL_N | PCIE_QUAL_N
PCIE_RAILS_OK | PCIE_RAILS_OK
PCIE_REFCLK_N | PCIE_REFCLK_N
PCIE_REFCLK_P | PCIE_REFCLK_P
PCIE_RESET_MR | PCIE_RESET_MR
PCIE_RX_N | PCIE_RX_N
PCIE_RX_P | PCIE_RX_P
PCIE_TX_N | PCIE_TX_N
PCIE_TX_P | PCIE_TX_P
PCIE_WAKE_N | PCIE_WAKE_N
PERVISOR_SENSE | MAIN_SUPERVISOR_SENSE
POWER_ENABLE | POWER_ENABLE
POWER_OK | POWER_OK
Q740_G | Q740_G
Q742_G | Q742_G
RADIO_BUSY_MCU | OOB_RADIO_BUSY_MCU
RADIO_DIO1_MCU | OOB_RADIO_DIO1_MCU
RADIO_MISO_DRV | OOB_RADIO_MISO_DRV
RADIO_MISO_MCU | OOB_RADIO_MISO_MCU
RADIO_MOSI_MCU | OOB_RADIO_MOSI_MCU
RADIO_RXEN_MCU | OOB_RADIO_RXEN_MCU
RC_PERST_N | RC_PERST_N
RTL_3V3_PG | RTL_3V3_PG
RTL_CORE_PG | RTL_CORE_PG
RTL_EECS | RTL_EECS
RTL_EEDI | RTL_EEDI
RTL_EEDO | RTL_EEDO
RTL_EEPROM_SEL | RTL_EEPROM_SEL
RTL_GPI | RTL_GPI
RTL_ISOLATE | RTL_ISOLATE
RTL_RSET | RTL_RSET
RTL_SWR_EN | RTL_SWR_EN
RTL_TX_N | RTL_TX_N
RTL_TX_P | RTL_TX_P
RT_TX_BUFFERED | OOB_UART_TX_BUFFERED
SB_ISOLATED_DN | MODEM_USB_ISOLATED_DN
SB_ISOLATED_DP | MODEM_USB_ISOLATED_DP
SB_MUX_DISABLE | OOB_USB_MUX_DISABLE
SHIELD | SHIELD
SH}MTCK-PAD44) | unconnected-(U800-GPIO39{slash}MTCK-Pad44)
SH}MTDO-PAD45) | unconnected-(U800-GPIO40{slash}MTDO-Pad45)
SH}MTMS-PAD48) | unconnected-(U800-GPIO42{slash}MTMS-Pad48)
SH}SPID-PAD35) | unconnected-(U800-GPIO32{slash}SPID-Pad35)
SH}SPIQ-PAD34) | unconnected-(U800-GPIO31{slash}SPIQ-Pad34)
SIM1_CLK | SIM1_CLK
SIM1_IO | SIM1_IO
SIM1_RST | SIM1_RST
SIVE_GATE_RAMP | PASSIVE_GATE_RAMP
SSIVE_DAMP_CAP | PASSIVE_DAMP_CAP
SSIVE_FILTER_P | PASSIVE_FILTER_P
SSIVE_GATE_FET | PASSIVE_GATE_FET
TED-(J3-PAD20) | unconnected-(J3-Pad20)
TED-(J3-PAD21) | unconnected-(J3-Pad21)
TED-(J3-PAD22) | unconnected-(J3-Pad22)
TED-(J3-PAD23) | unconnected-(J3-Pad23)
TED-(J3-PAD24) | unconnected-(J3-Pad24)
TED-(J3-PAD25) | unconnected-(J3-Pad25)
TED-(J3-PAD26) | unconnected-(J3-Pad26)
TED-(J3-PAD28) | unconnected-(J3-Pad28)
TED-(J3-PAD29) | unconnected-(J3-Pad29)
TED-(J3-PAD31) | unconnected-(J3-Pad31)
TED-(J3-PAD35) | unconnected-(J3-Pad35)
TED-(J3-PAD37) | unconnected-(J3-Pad37)
TED-(J3-PAD38) | unconnected-(J3-Pad38)
TED-(J3-PAD40) | unconnected-(J3-Pad40)
TED-(J3-PAD56) | unconnected-(J3-Pad56)
TED-(J3-PAD58) | unconnected-(J3-Pad58)
TED-(J3-PAD59) | unconnected-(J3-Pad59)
TED-(J3-PAD60) | unconnected-(J3-Pad60)
TED-(J3-PAD61) | unconnected-(J3-Pad61)
TED-(J3-PAD62) | unconnected-(J3-Pad62)
TED-(J3-PAD63) | unconnected-(J3-Pad63)
TED-(J3-PAD64) | unconnected-(J3-Pad64)
TED-(J3-PAD65) | unconnected-(J3-Pad65)
TED-(J3-PAD68) | unconnected-(J3-Pad68)
TED-(J3-PAD69) | unconnected-(J3-Pad69)
TED-(J3-PAD75) | unconnected-(J3-Pad75)
U21_DVDT | u21_DVDT
U21_DVDT_RC | u21_DVDT_RC
U21_ILM | u21_ILM
U21_ITIMER | u21_ITIMER
U21_OV | u21_OV
U21_PGTH | u21_PGTH
U21_UV | u21_UV
U22_DVDT | u22_DVDT
U22_ILM | u22_ILM
U22_ITIMER | u22_ITIMER
U22_OV | u22_OV
U22_PGTH | u22_PGTH
U22_UV | u22_UV
U3_BST | u3_BST
U3_FB | u3_FB
U3_SW | u3_SW
U3_VCC | u3_VCC
U4_FB | u4_FB
U4_NRSS | u4_NRSS
U4_SCONF | u4_SCONF
U4_SW | u4_SW
U5_FB | u5_FB
U5_NRSS | u5_NRSS
U5_SCONF | u5_SCONF
U5_SW | u5_SW
U801-NC-PAD17) | unconnected-(U801-NC-Pad17)
U802-A8-PAD10) | unconnected-(U802-A8-Pad10)
UART_RX_HEADER | OOB_UART_RX_HEADER
UART_TX_HEADER | OOB_UART_TX_HEADER
UIM1_CLK | UIM1_CLK
UIM1_DATA | UIM1_DATA
UIM1_DET | UIM1_DET
UIM1_RST | UIM1_RST
UIM1_VDD | UIM1_VDD
UIM2_CLK | UIM2_CLK
UIM2_DATA | UIM2_DATA
UIM2_RST | UIM2_RST
UIM2_VDD | UIM2_VDD
USB_CC1 | USB_CC1
USB_CC2 | USB_CC2
USB_DN | USB_DN
USB_DP | USB_DP
USB_EXT_ABSENT | OOB_USB_EXT_ABSENT
USB_GATE | USB_GATE
USB_MUX_SELECT | OOB_USB_MUX_SELECT
USB_PORT_DN | USB_PORT_DN
USB_PORT_DP | USB_PORT_DP
USB_PROTECT_DN | USB_PROTECT_DN
USB_PROTECT_DP | USB_PROTECT_DP
USB_VBUS_SENSE | USB_VBUS_SENSE
V0V95 | V0V95
V12 | V12
V12_PD | V12_PD
V3V3 | V3V3
V3V3_IO | V3V3_IO
V3V3_PLL | V3V3_PLL
V3V7 | V3V7
V3V7_REG | V3V7_REG
VBUS_C | VBUS_C
VC1 | VC1
VC2 | VC2
VC3 | VC3
VC4 | VC4
VDC_FUSED | VDC_FUSED
VDC_IN | VDC_IN
VDC_RAW | VDC_RAW
VE_VREF_FILTER | PASSIVE_VREF_FILTER
VPOE_P | VPOE_P
XTAL_1 | XTAL_1
XTAL_2 | XTAL_2
XTAL_DRV2 | XTAL_DRV2
_ADC_MODEM_VCC | OOB_ADC_MODEM_VCC
_EFUSE_DVDT_RC | MODEM_EFUSE_DVDT_RC
_EFUSE_OVP_TOP | MODEM_EFUSE_OVP_TOP
_FILTER_KELVIN | PASSIVE_FILTER_KELVIN
_MODEM_CURRENT | OOB_ADC_MODEM_CURRENT
_PCIE_CLKREQ_N | M2_PCIE_CLKREQ_N
_RADIO_FAULT_N | OOB_RADIO_FAULT_N
_RADIO_NSS_MCU | OOB_RADIO_NSS_MCU
_RADIO_SCK_DRV | OOB_RADIO_SCK_DRV
_RADIO_SCK_MCU | OOB_RADIO_SCK_MCU
_SESSION_VALID | OOB_USB_SESSION_VALID
_USB_EXT_VALID | OOB_USB_EXT_VALID
_XTAL_P_FILTER | OOB_XTAL_P_FILTER
}SPICLK-PAD33) | unconnected-(U800-GPIO30{slash}SPICLK-Pad33)
}SPICS0-PAD32) | unconnected-(U800-GPIO29{slash}SPICS0-Pad32)
}SPICS1-PAD28) | unconnected-(U800-GPIO26{slash}SPICS1-Pad28)
