ripclap/rm520n-carrier/docs/schematic.pdf

1 | 2 | 3 | 4 | 5 | 6 | 7 | 8 | 9 | 10 | 11

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
## FGH Date: 2026-10-03

Size: A2 | Rev: A
KiCad E.D.A. 10.0.6 | Id: 1/10

# Title: RM520N-GL passive carrier with independent US915 OOB

## File: carrier.kicad_sch

## Sheet: /

## ENGINEERING PROTOTYPE - not a fabrication approval

## Validation: docs/validation.md; BOM and build files: manufacturing/rev-a/

Passive cable-power connections and protected auxiliary DC

File: power-input.kicad_sch | Protected 12 V bus and regulated low-voltage rails File: power-rails.kicad_sch | RM520N-GL primary / RM551E-GL compatible M.2 socket, SIM 1, eUICC (SIM 2), USB-C
File: modem-interfaces.kicad_sch 48 V passive input protection and 12 V synchronous buck File: class6-converter.kicad_sch | Modem current ceiling and always-on supply File: class6-grants.kicad_sch OOB monitoring, power control and modem recovery File: oob-management.kicad_sch | OOB USB ownership and reset fallback File: oob-usb-ownership.kicad_sch

RTL8125BG 2.5 GbE

File: ethernet.kicad_sch OOB controller, US915 radio and recovery interface

File: oob-controller-radio.kicad_sch

# RM520N-GL / RTL8125BG / independent US915 OOB prototype

48 V passive cable power -> protected buck 12 V -> modem / Ethernet rails Auxiliary DC, USB, modem coax and mounting share system GND; no power galvanic isolation. Supplier acceptance and hardware tests: docs/validation.md.

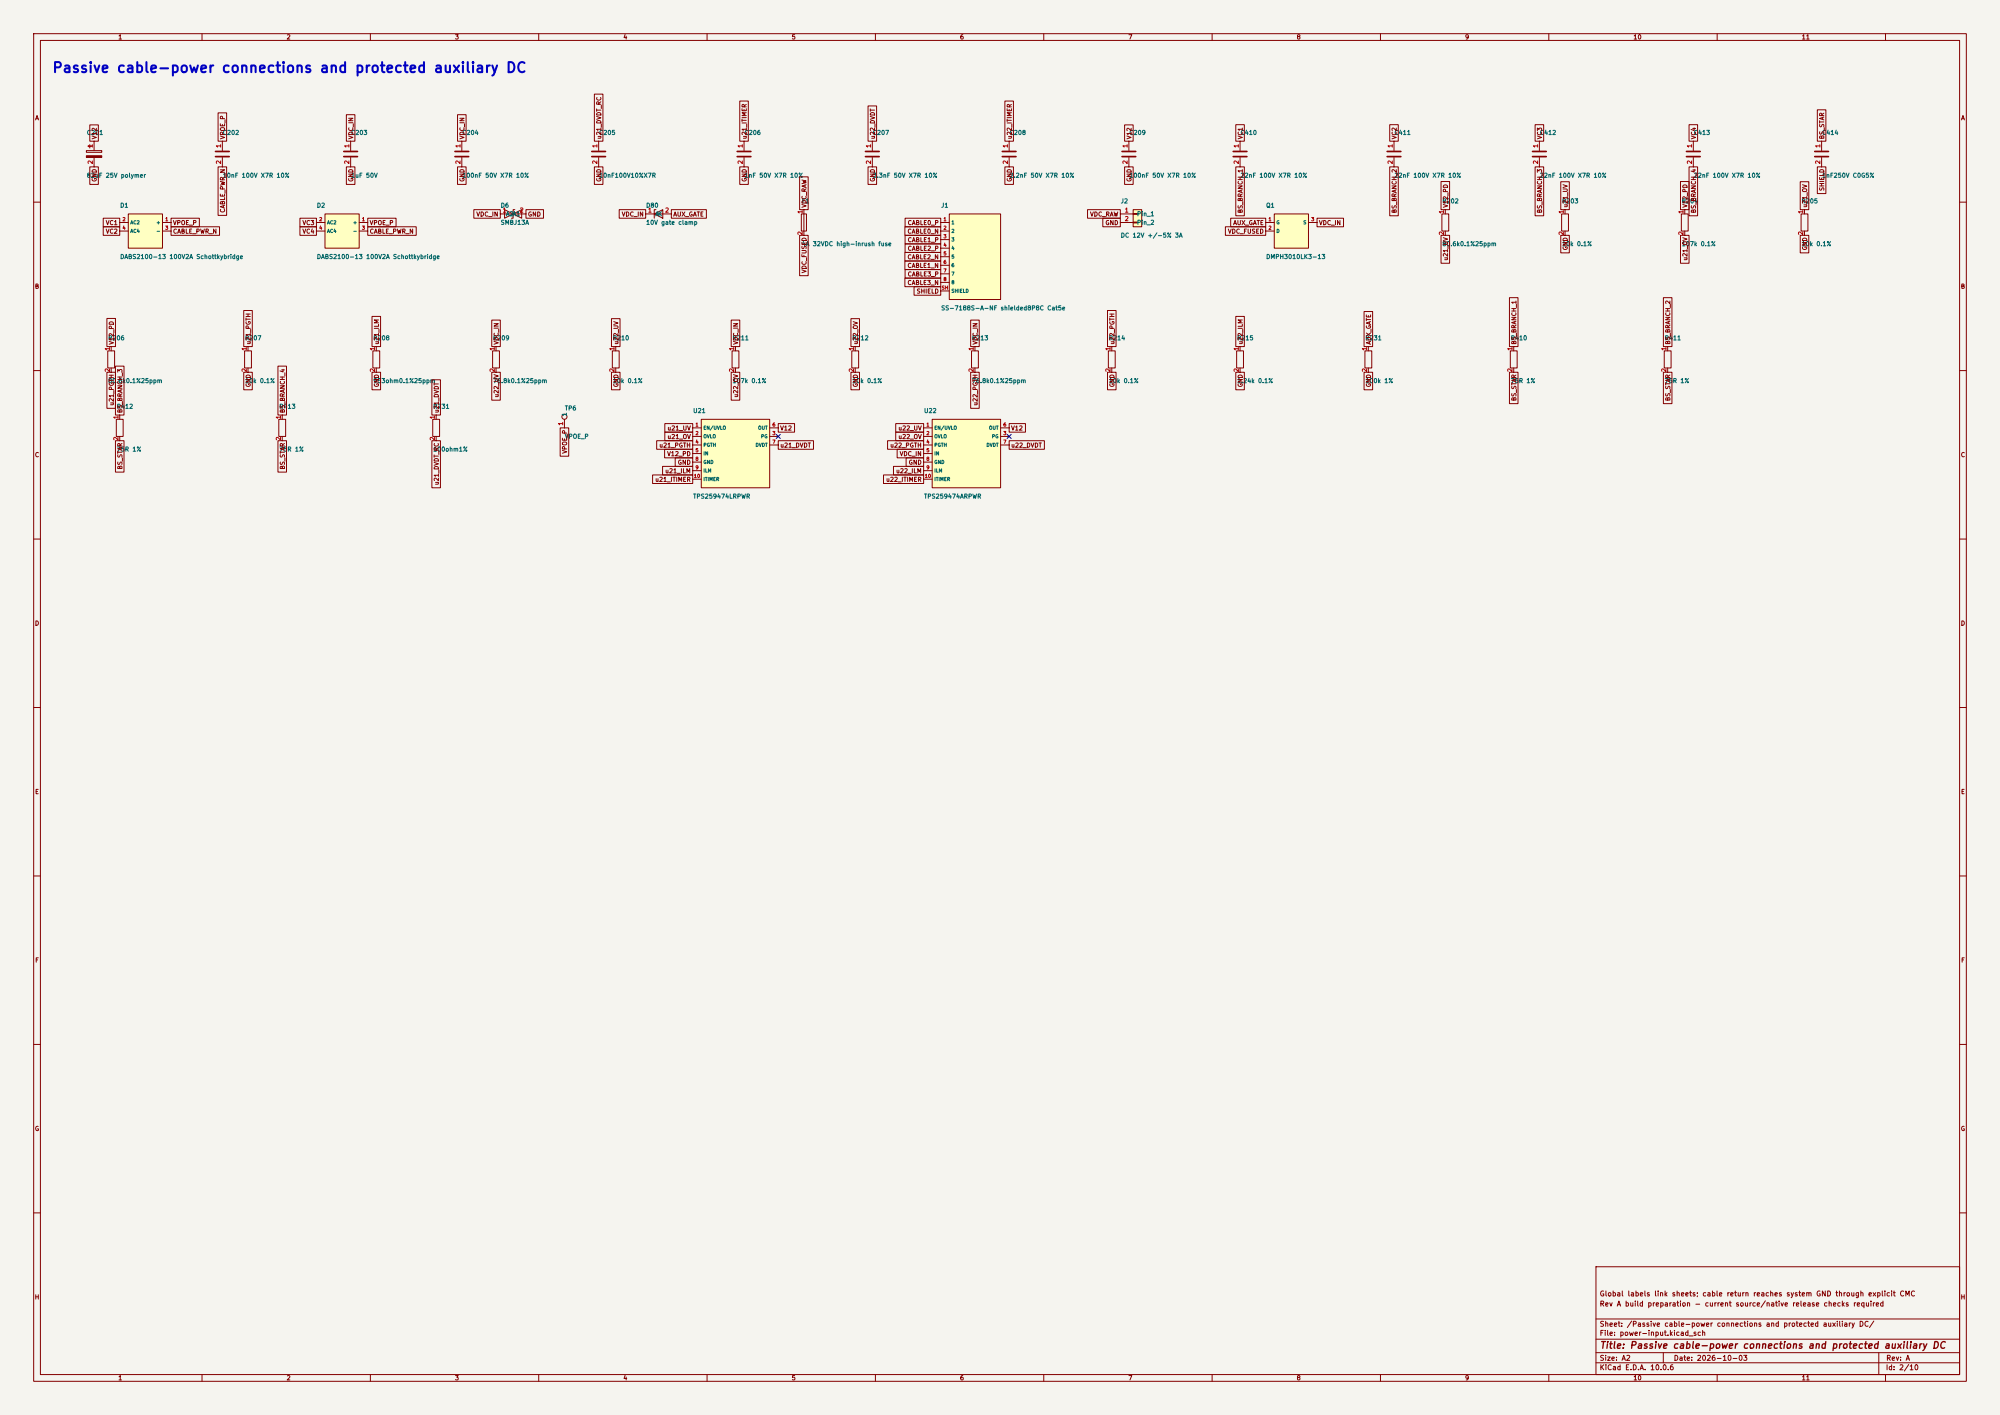
[picture p23: page 2]

Passive cable-power connections and protected auxiliary DC

Global labels link sheets; cable return reaches system GND through explicit CMC
Rev A build preparation - current source/native release checks required

Sheet: /Passive cable-power connections and protected auxiliary DC/
File: power-input.kicad_sch
Title: Passive cable-power connections and protected auxiliary DC

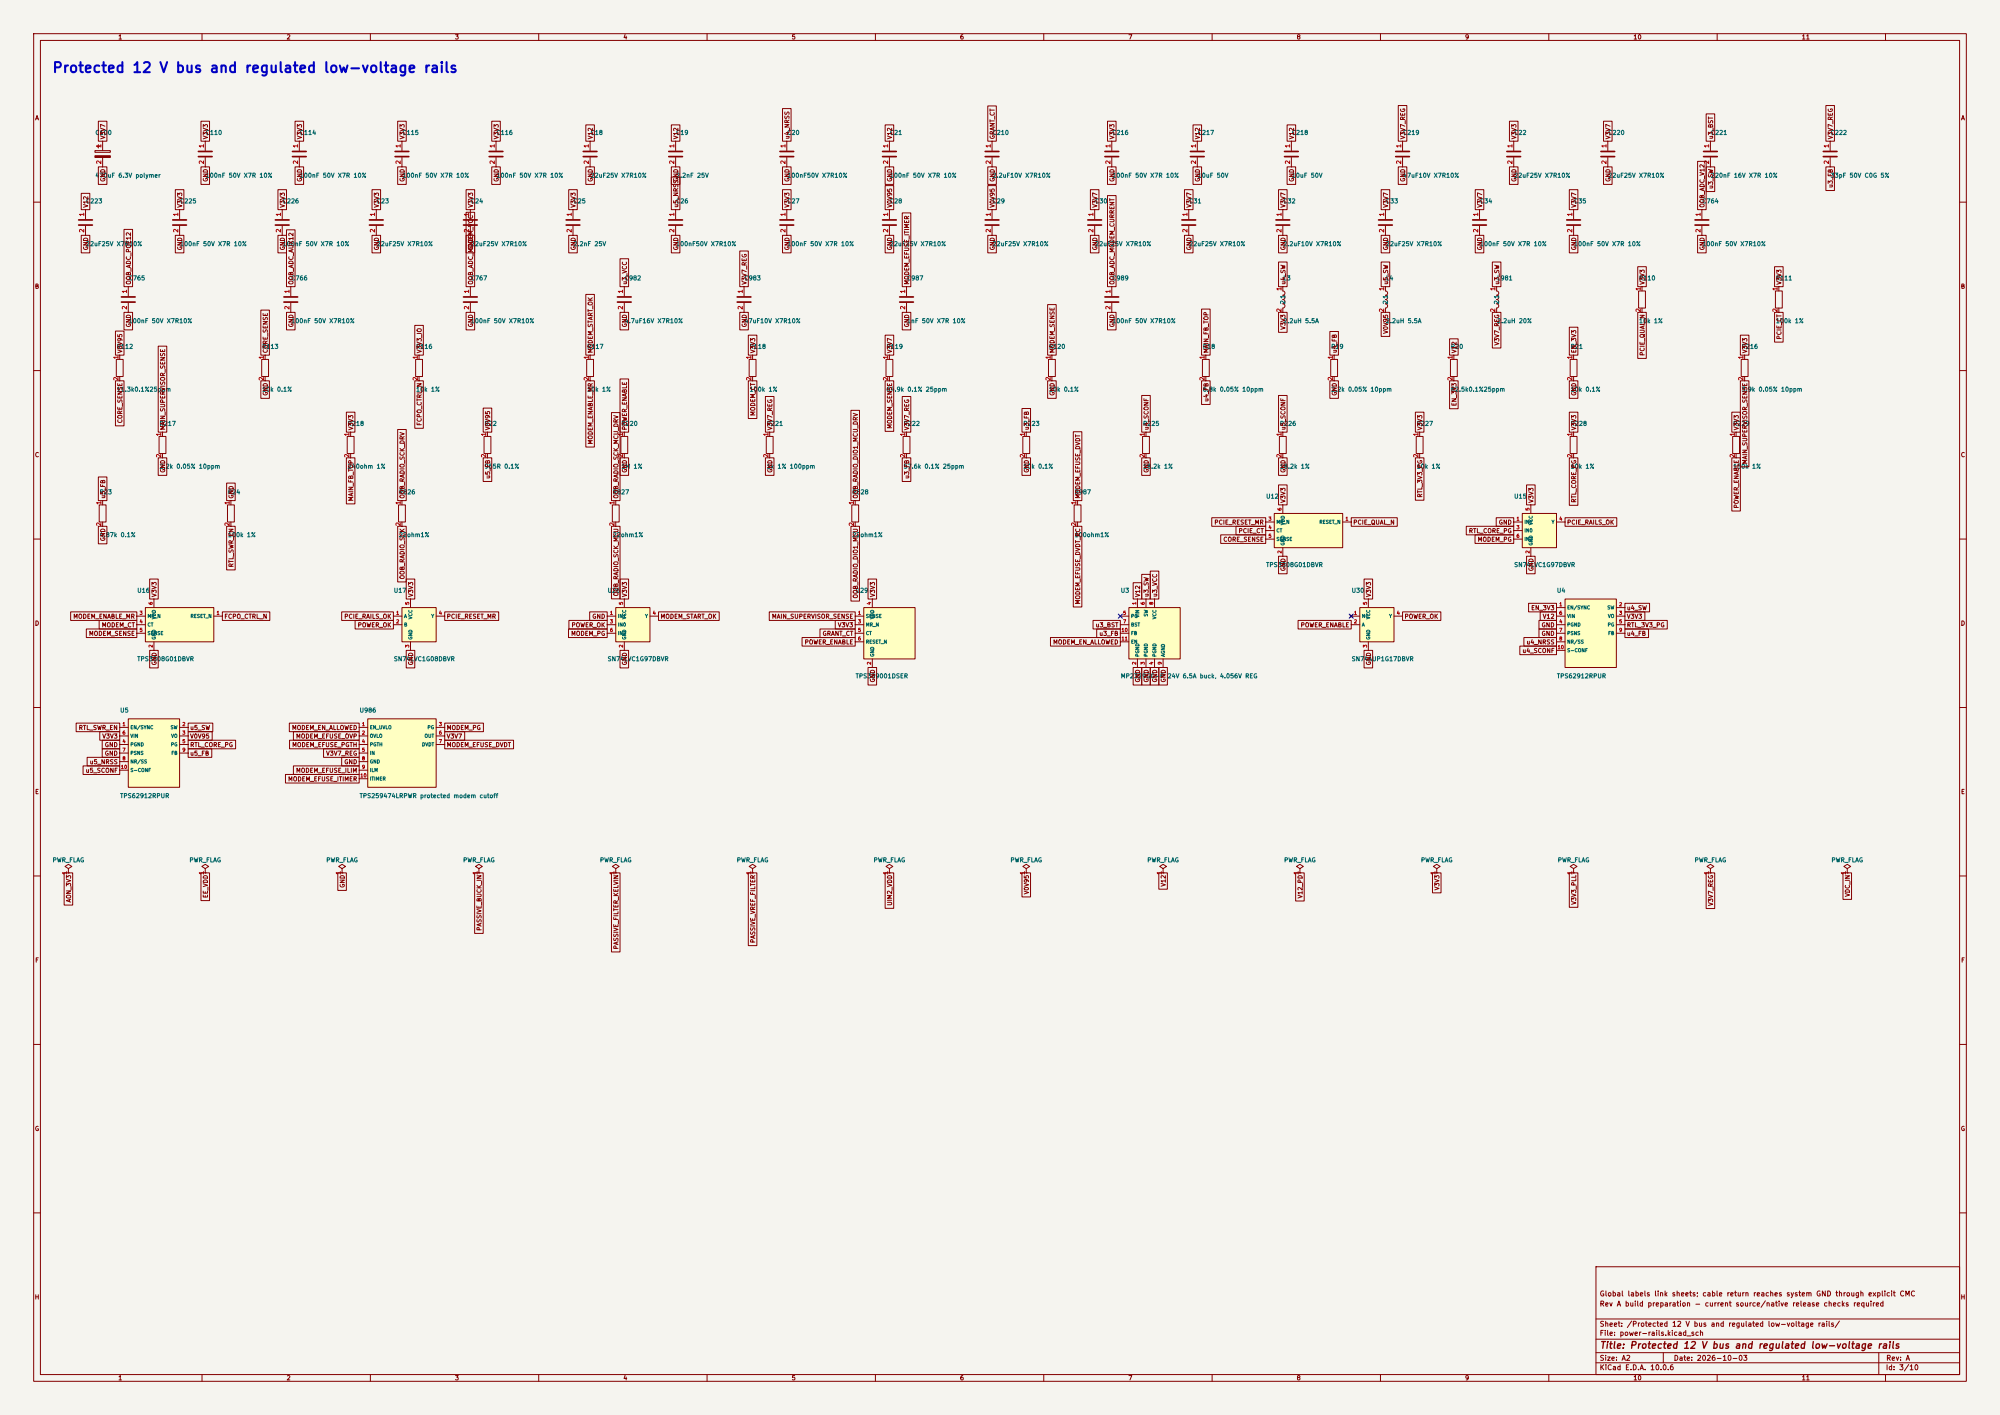
[picture p24: page 3]

Protected 12 V bus and regulated low-voltage rails
470uF 6.3V polymer 1 2 R112

Sheet: /Protected 12 V bus and regulated low-voltage rails/
File: power-rails.kicad_sch
Title: Protected 12 V bus and regulated low-voltage rails

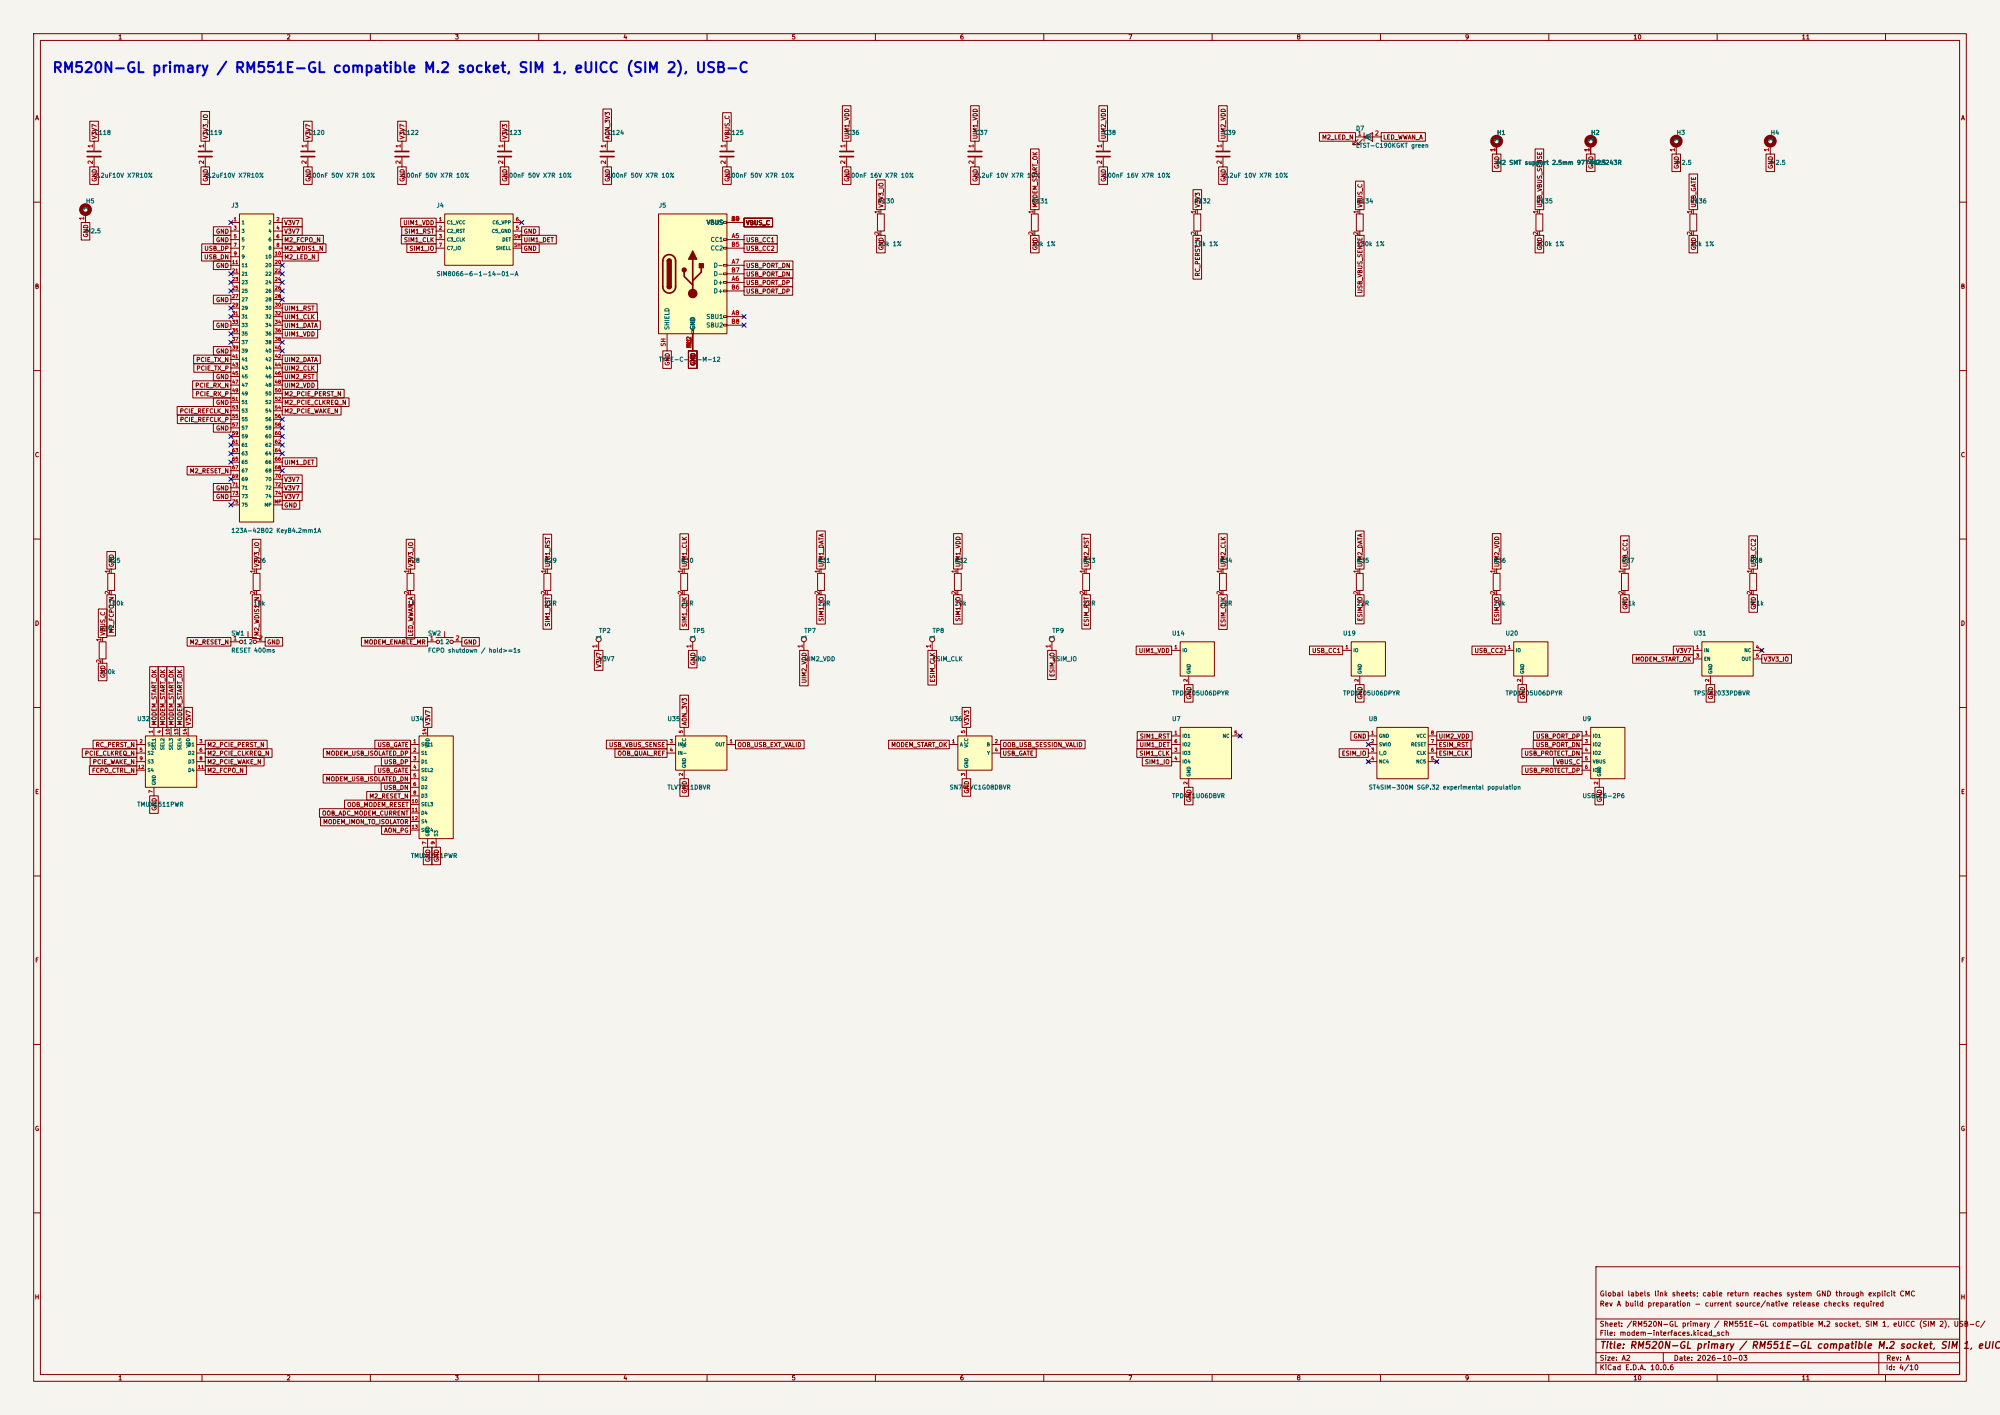
[picture p25: page 4]

GND RM520N-GL primary / RM551E-GL compatible M.2 socket, SIM 1, eUICC (SIM 2), USB-C

Sheet: /RM520N-GL primary / RM551E-GL compatible M.2 socket, SIM 1, eUICC (SIM 2), USB-C/
File: modem-interfaces.kicad_sch
Title: RM520N-GL primary / RM551E-GL compatible M.2 socket, SIM 1, eUICC (SIM 2), USB-C

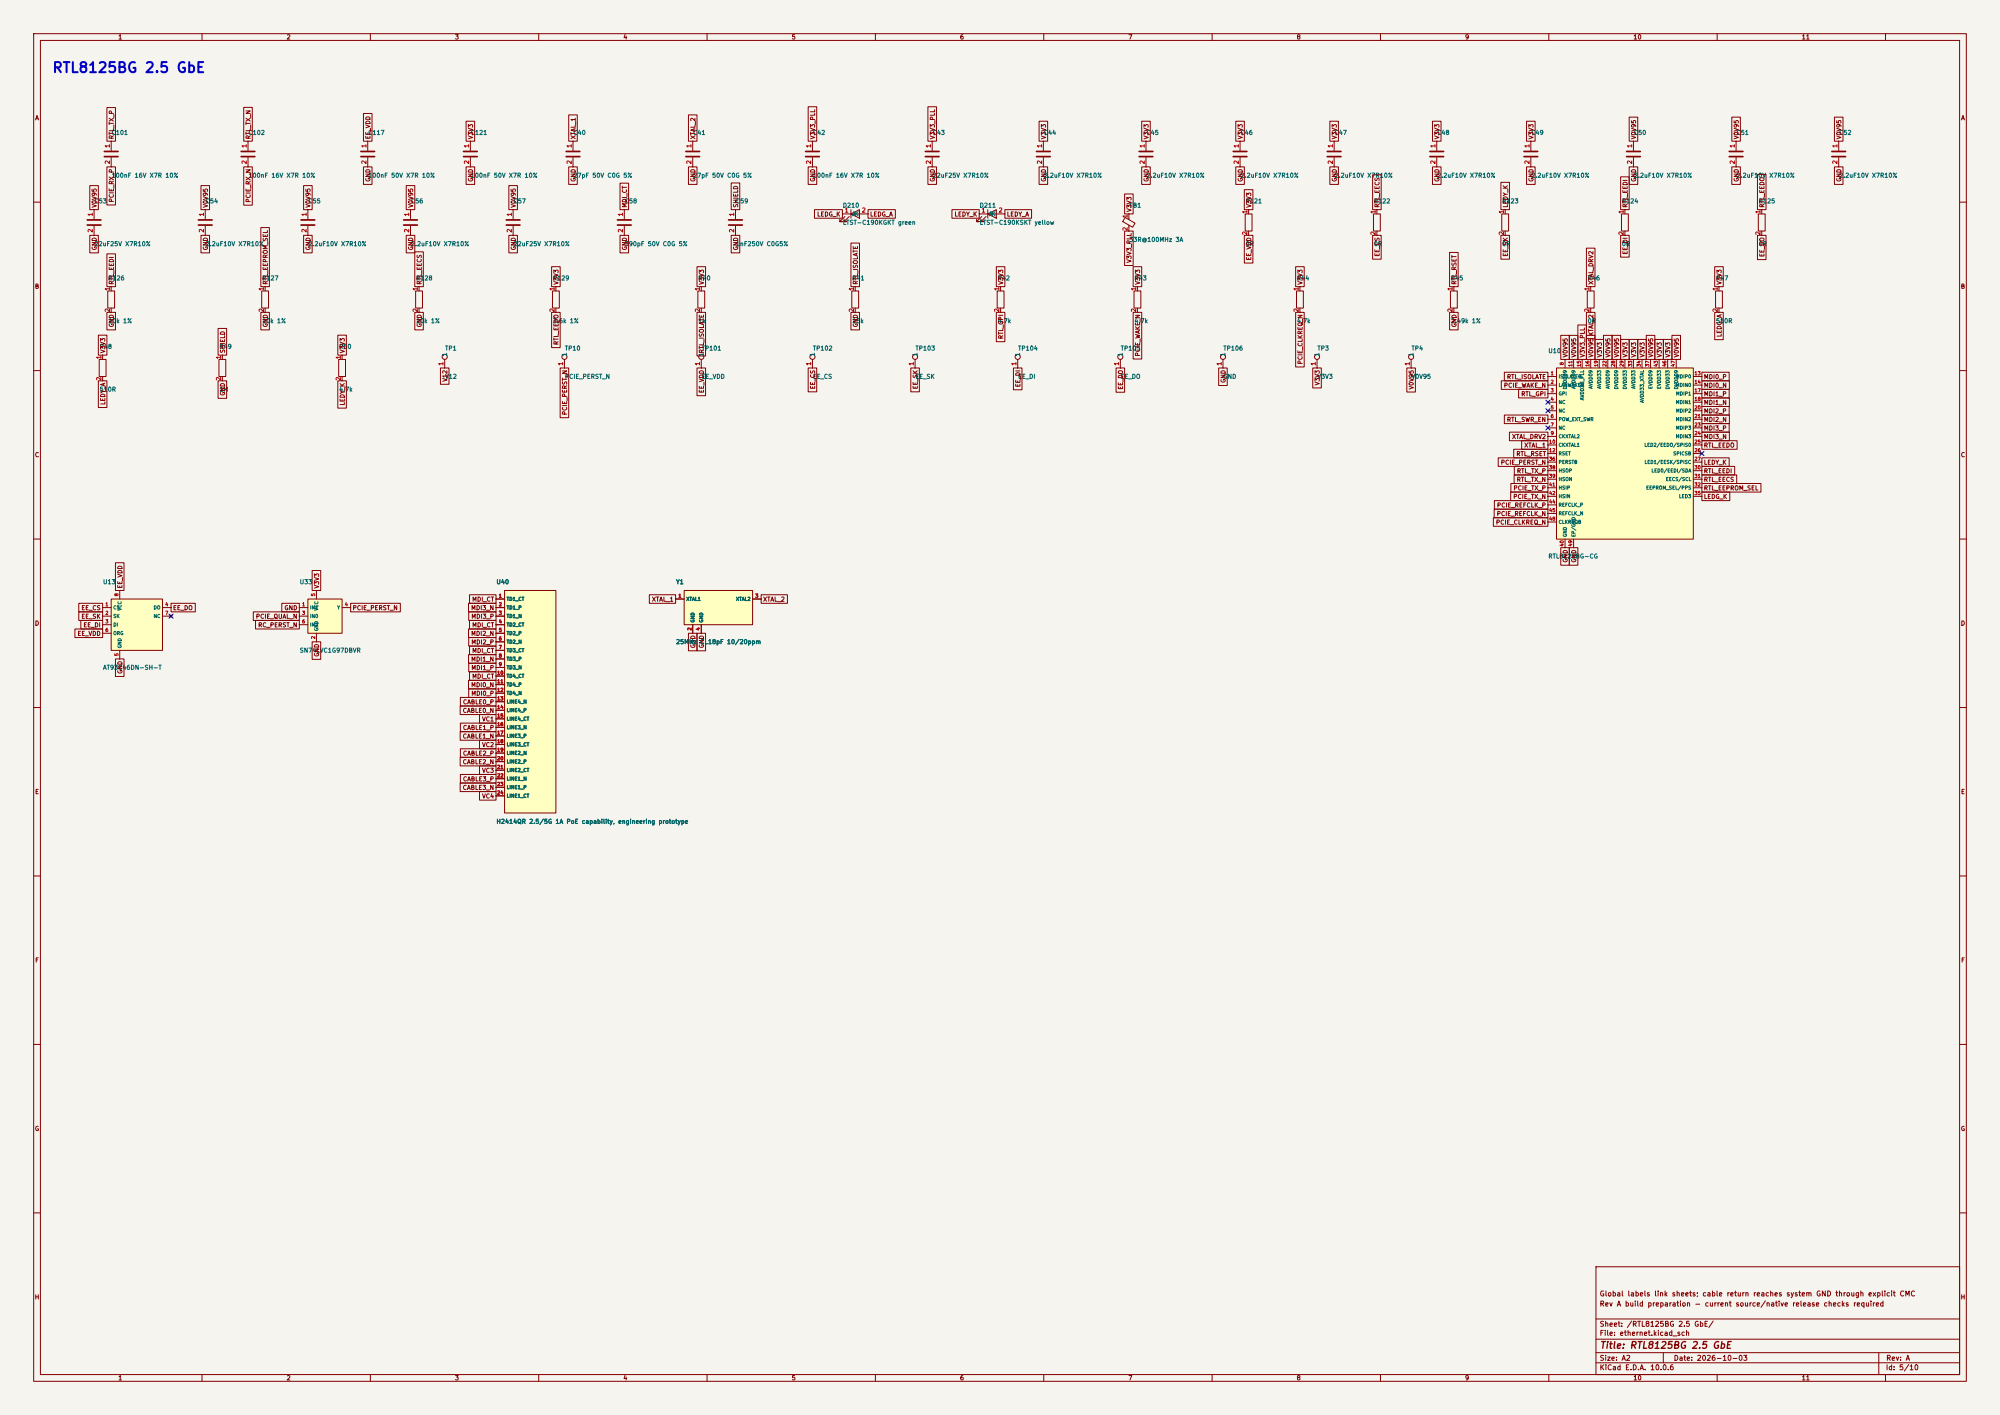
[picture p26: page 5]

LINE1_CT 24 U40 H2414QR 2.5/5G 1A PoE capability, engineering prototype

U40 H2414QR 2.5/5G 1A PoE capability, engineering prototype

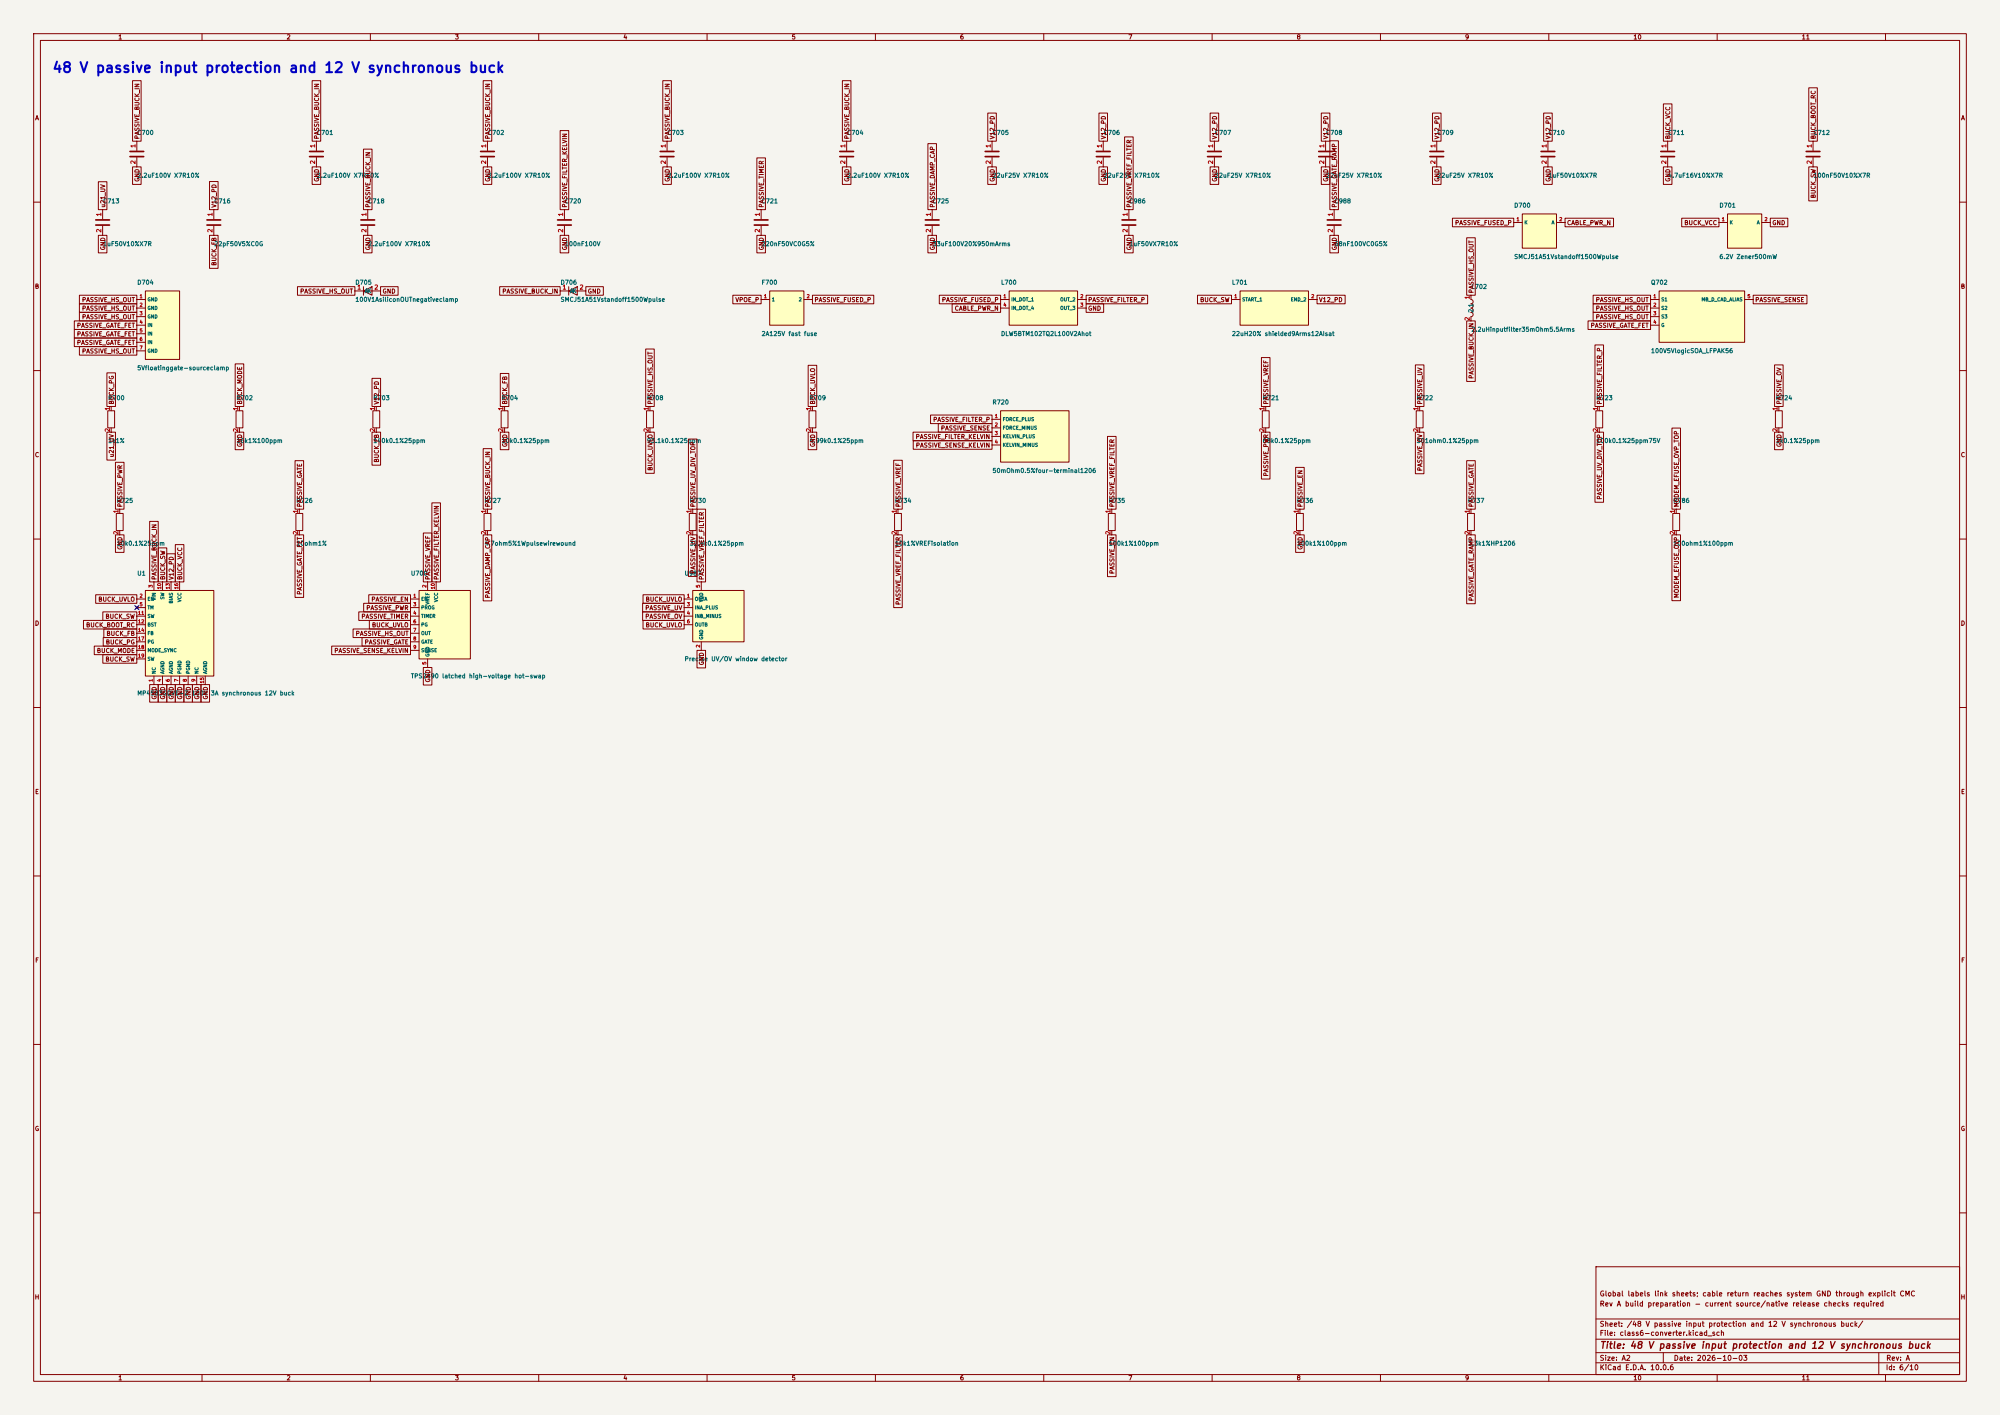
[picture p27: page 6]

48 V passive input protection and 12 V synchronous buck

TPS2490 latched high-voltage hot-swap 1 2 R727

5 OUTB 6U987 Precise UV/OV window detector EN 1 VREF 2 PROG 3

Sheet: /48 V passive input protection and 12 V synchronous buck/
File: class6-converter.kicad_sch
Title: 48 V passive input protection and 12 V synchronous buck

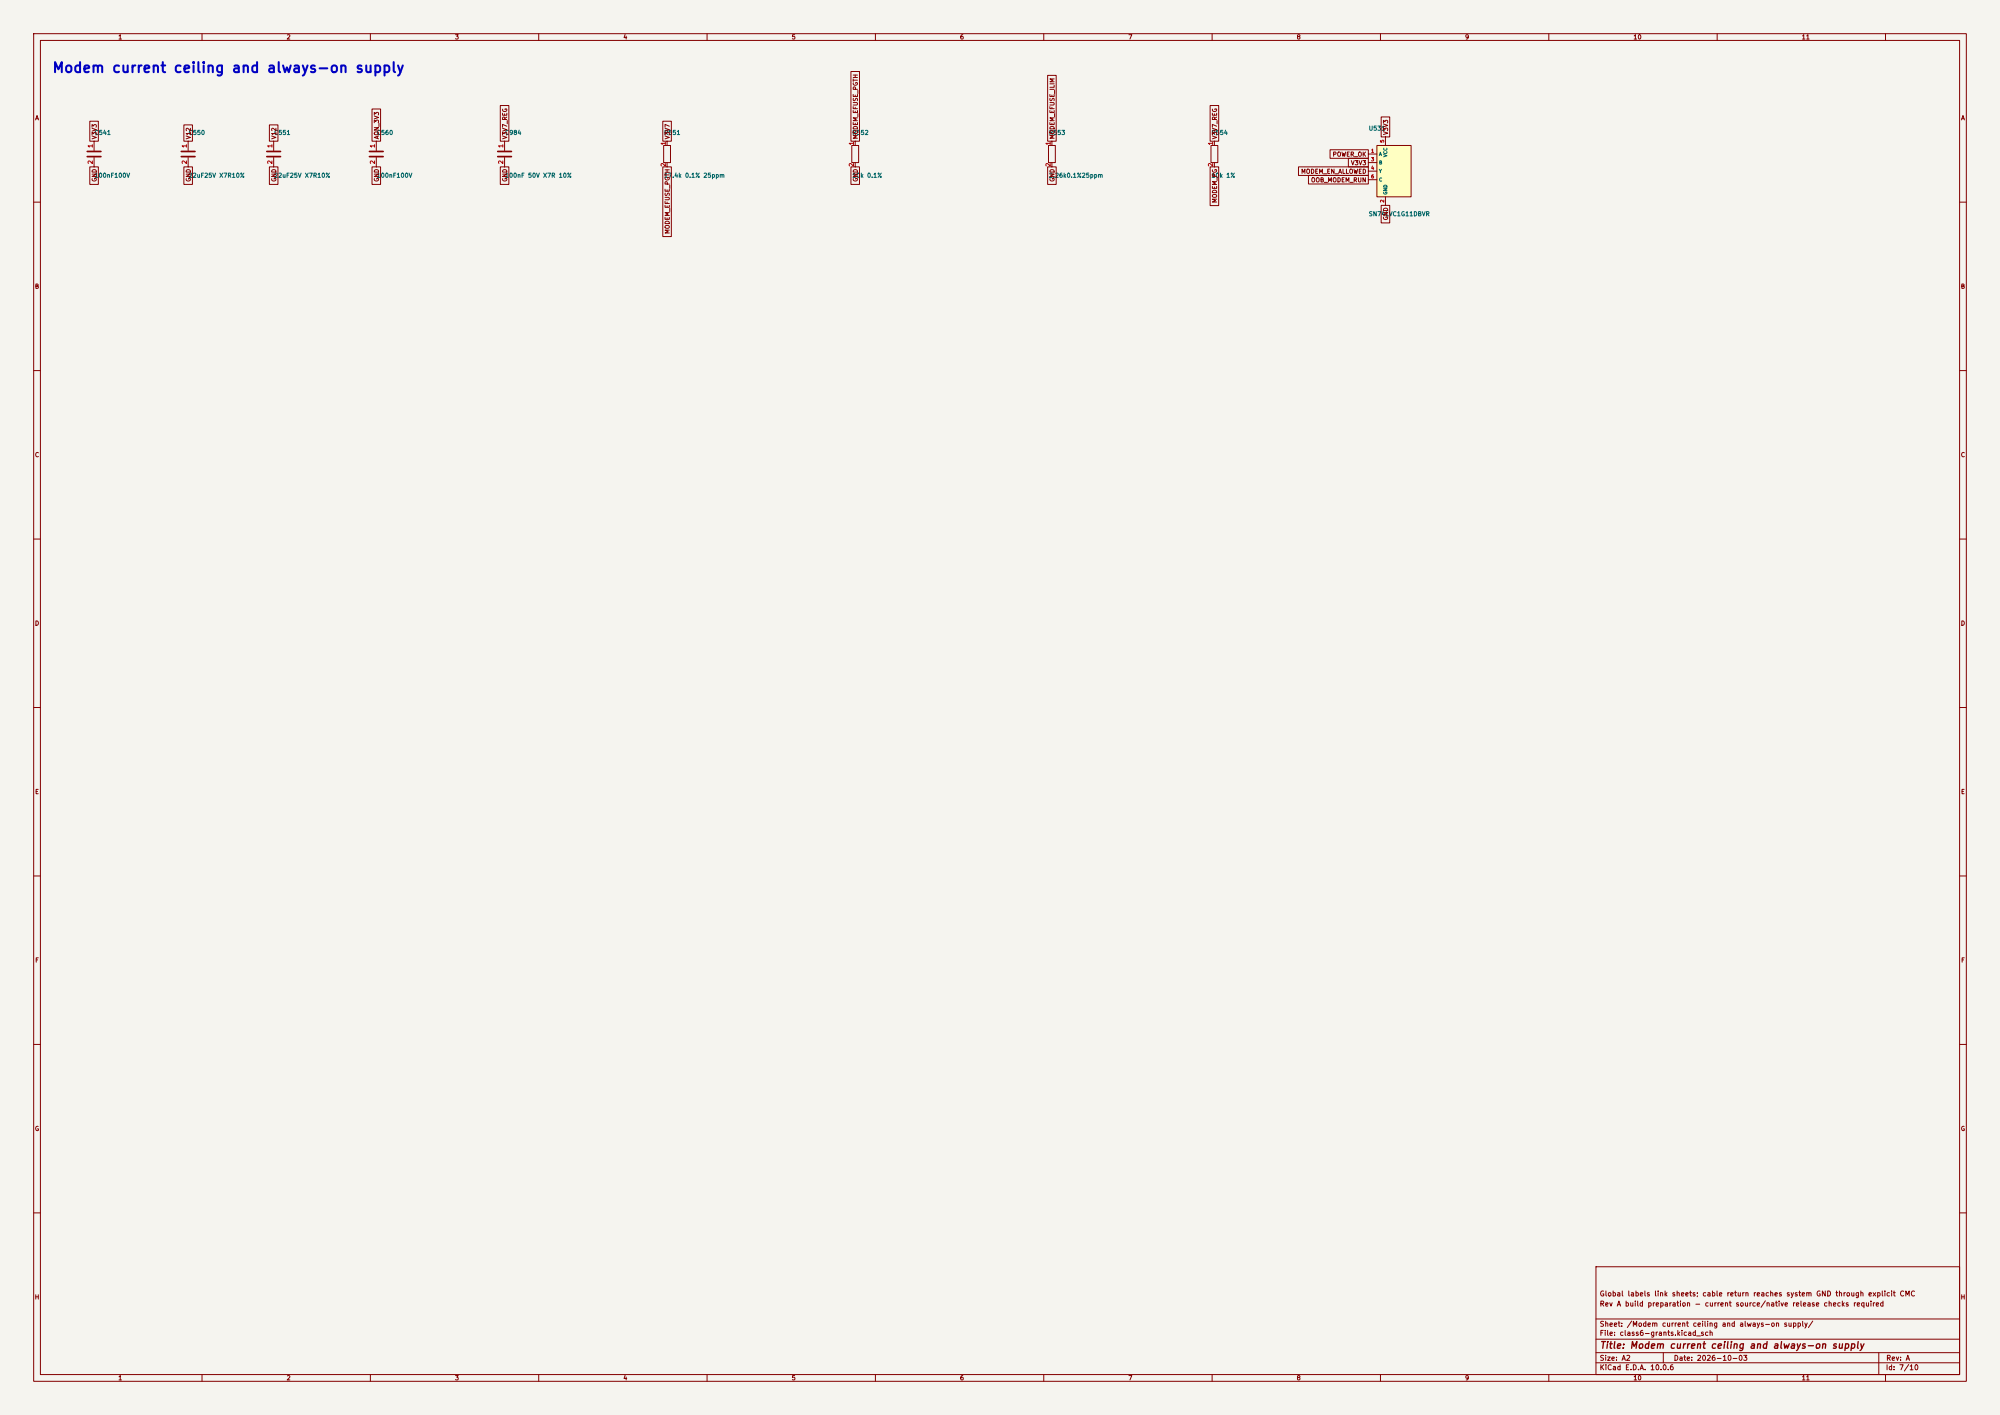
[picture p28: page 7]

Modem current ceiling and always-on supply

Sheet: /Modem current ceiling and always-on supply/
File: class6-grants.kicad_sch
Title: Modem current ceiling and always-on supply

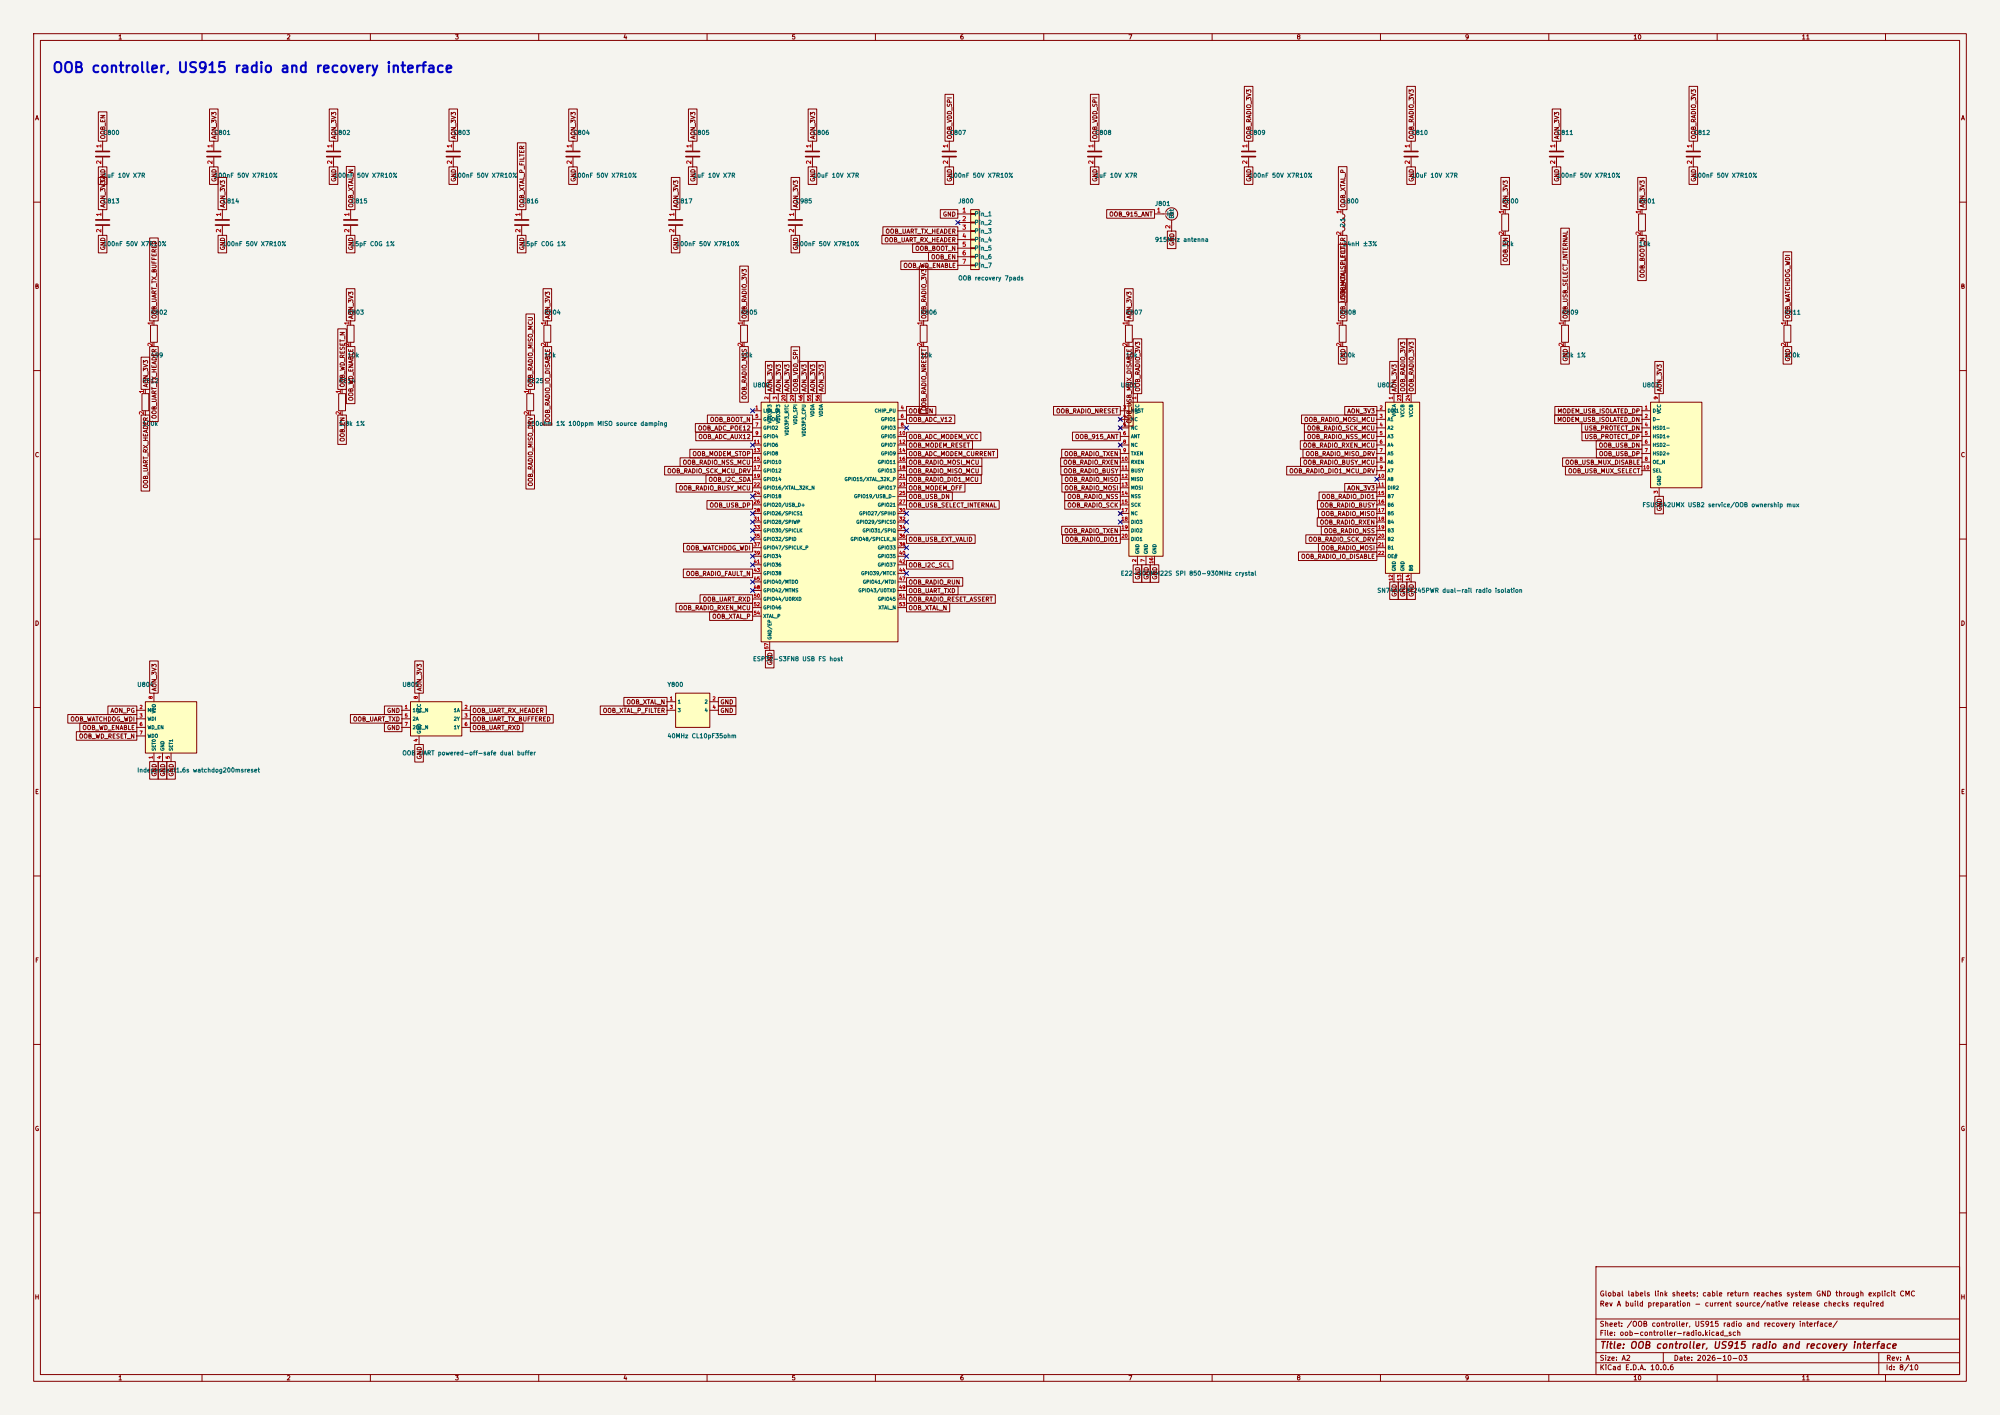
[picture p29: page 8]

OOB_USB_DN OOB controller, US915 radio and recovery interface

FSUSB42UMX USB2 service/OOB ownership mux 1 2 R811

3 CHIP_PU 4 GPIO0 5 GPIO1 6 GPIO2 7 GPIO3 8 GPIO4 9 GPIO5 10 GPIO6 11 GPIO7 12 GPIO8 13 GPIO9 14 GPIO10 15 GPIO11 16 GPIO12 17 GPIO13 18 GPIO14 19 VDD3P3_RTC 20 GPIO15/XTAL_32K_P 21 GPIO16/XTAL_32K_N 22 GPIO17 23 GPIO18 24 GPIO19/USB_D- 25 GPIO20/USB_D+ 26 GPIO21 27 GPIO26/SPICS1 28 VDD_SPI 29 GPIO27/SPIHD 30 GPIO28/SPIWP 31 GPIO29/SPICS0 32 GPIO30/SPICLK 33 GPIO31/SPIQ 34 GPIO32/SPID 35 GPIO48/SPICLK_N 36 GPIO47/SPICLK_P 37 GPIO33 38 GPIO34 39 GPIO35 40 GPIO36 41 GPIO37 42 GPIO38 43 GPIO39/MTCK 44 GPIO40/MTDO 45 VDD3P3_CPU 46 GPIO41/MTDI 47 GPIO42/MTMS 48 GPIO43/U0TXD 49 GPIO44/U0RXD 50 GPIO45 51 GPIO46 52 XTAL_N 53

1 GND
SN74AXC8T245PWR dual-rail radio isolation VCC

8 U805 OOB UART powered-off-safe dual buffer 1

Sheet: /OOB controller, US915 radio and recovery interface/
File: oob-controller-radio.kicad_sch
Title: OOB controller, US915 radio and recovery interface

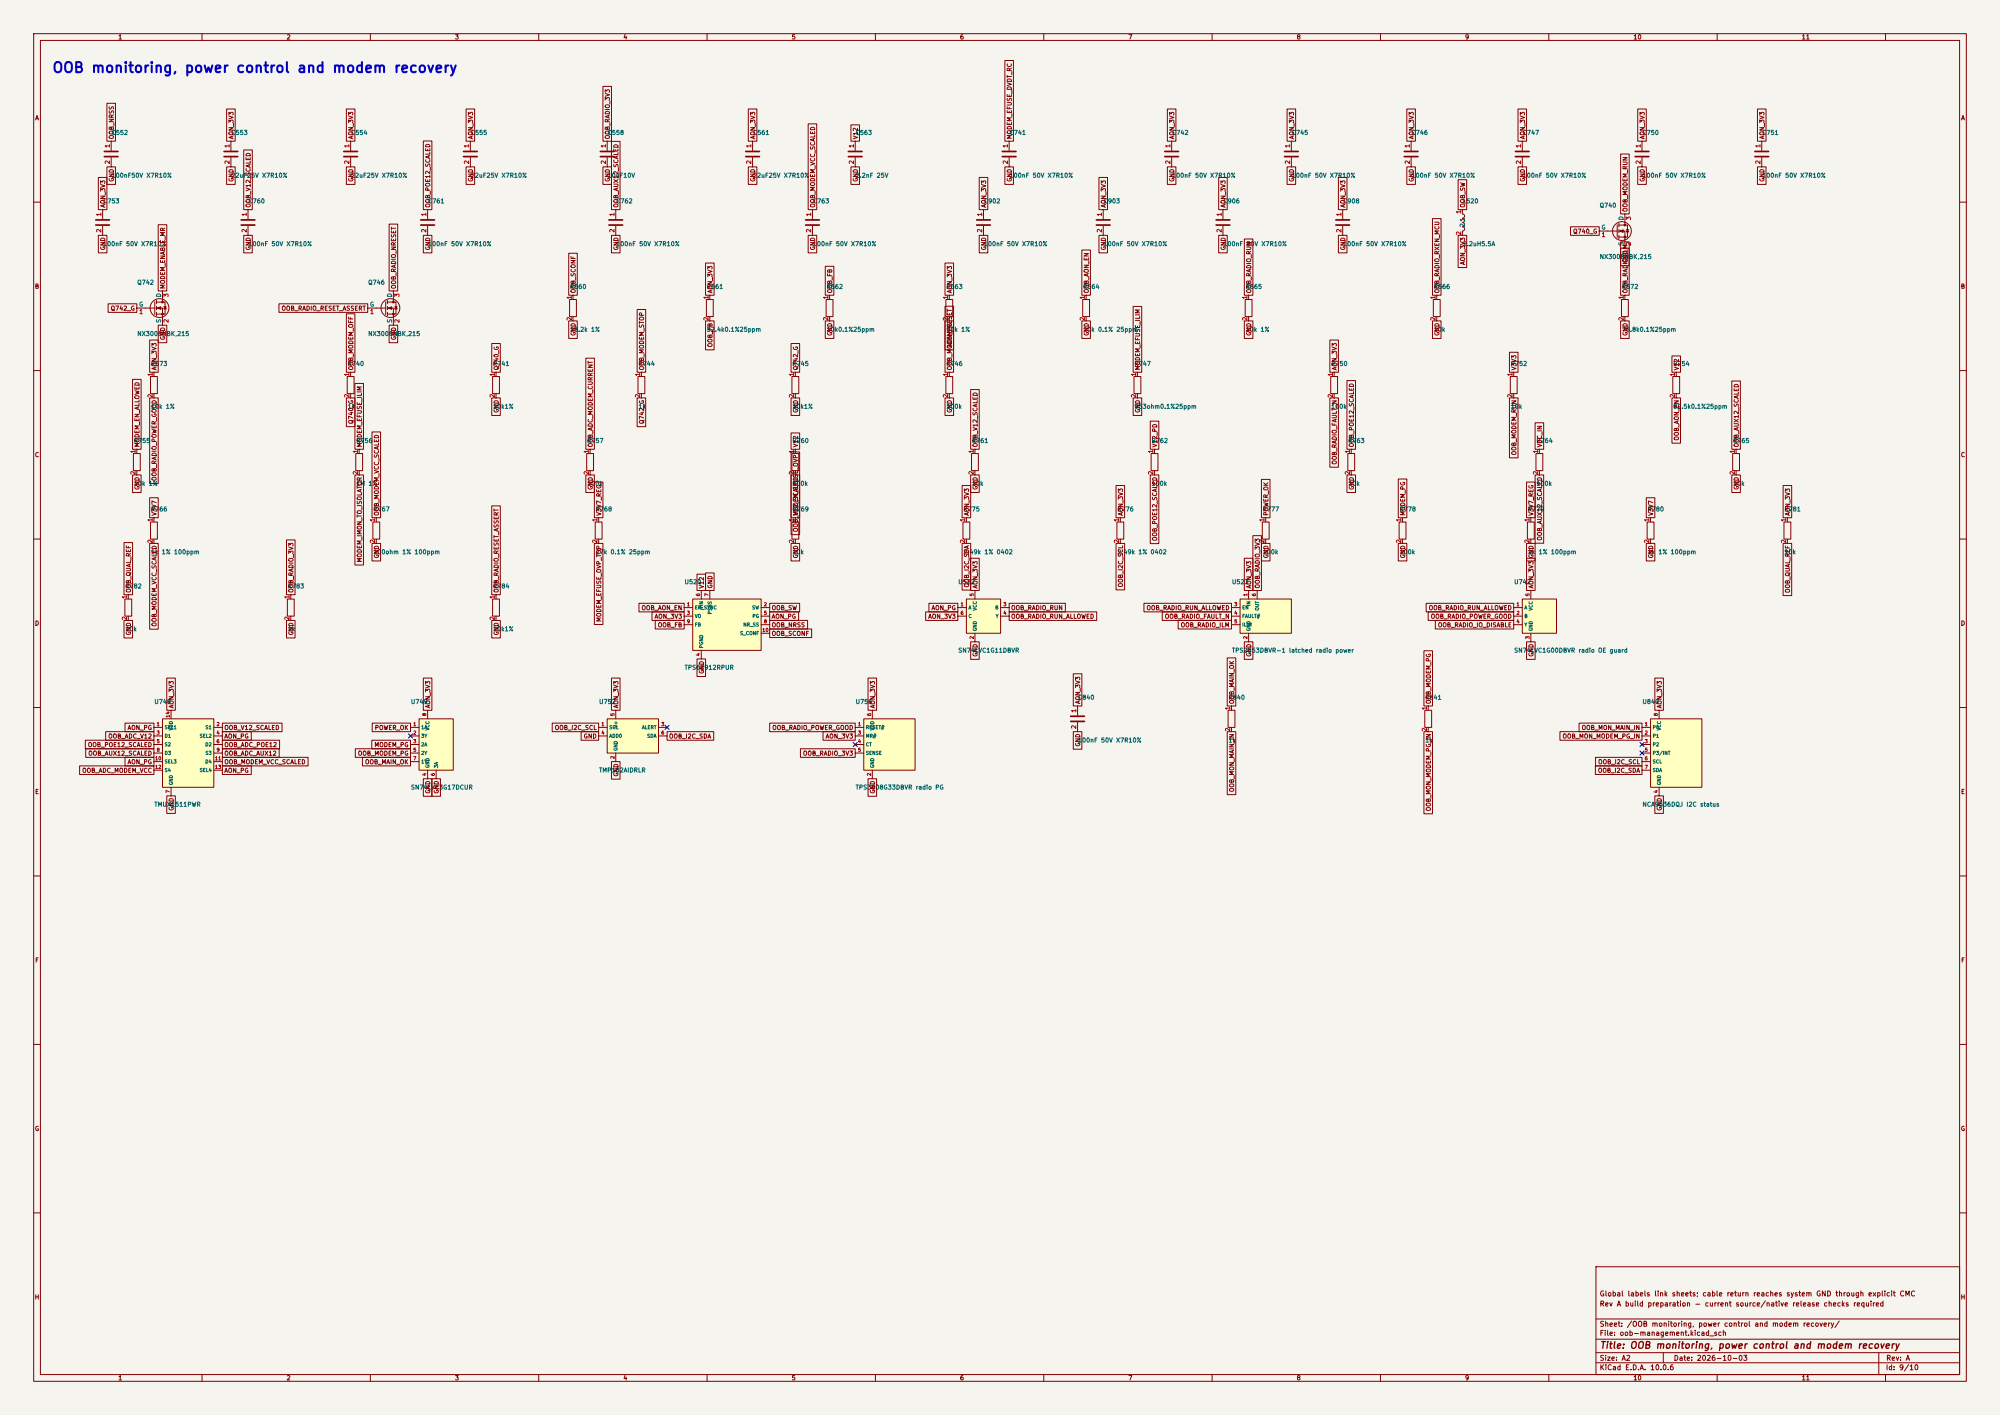
[picture p30: page 9]

OOB monitoring, power control and modem recovery

Sheet: /OOB monitoring, power control and modem recovery/
File: oob-management.kicad_sch
Title: OOB monitoring, power control and modem recovery

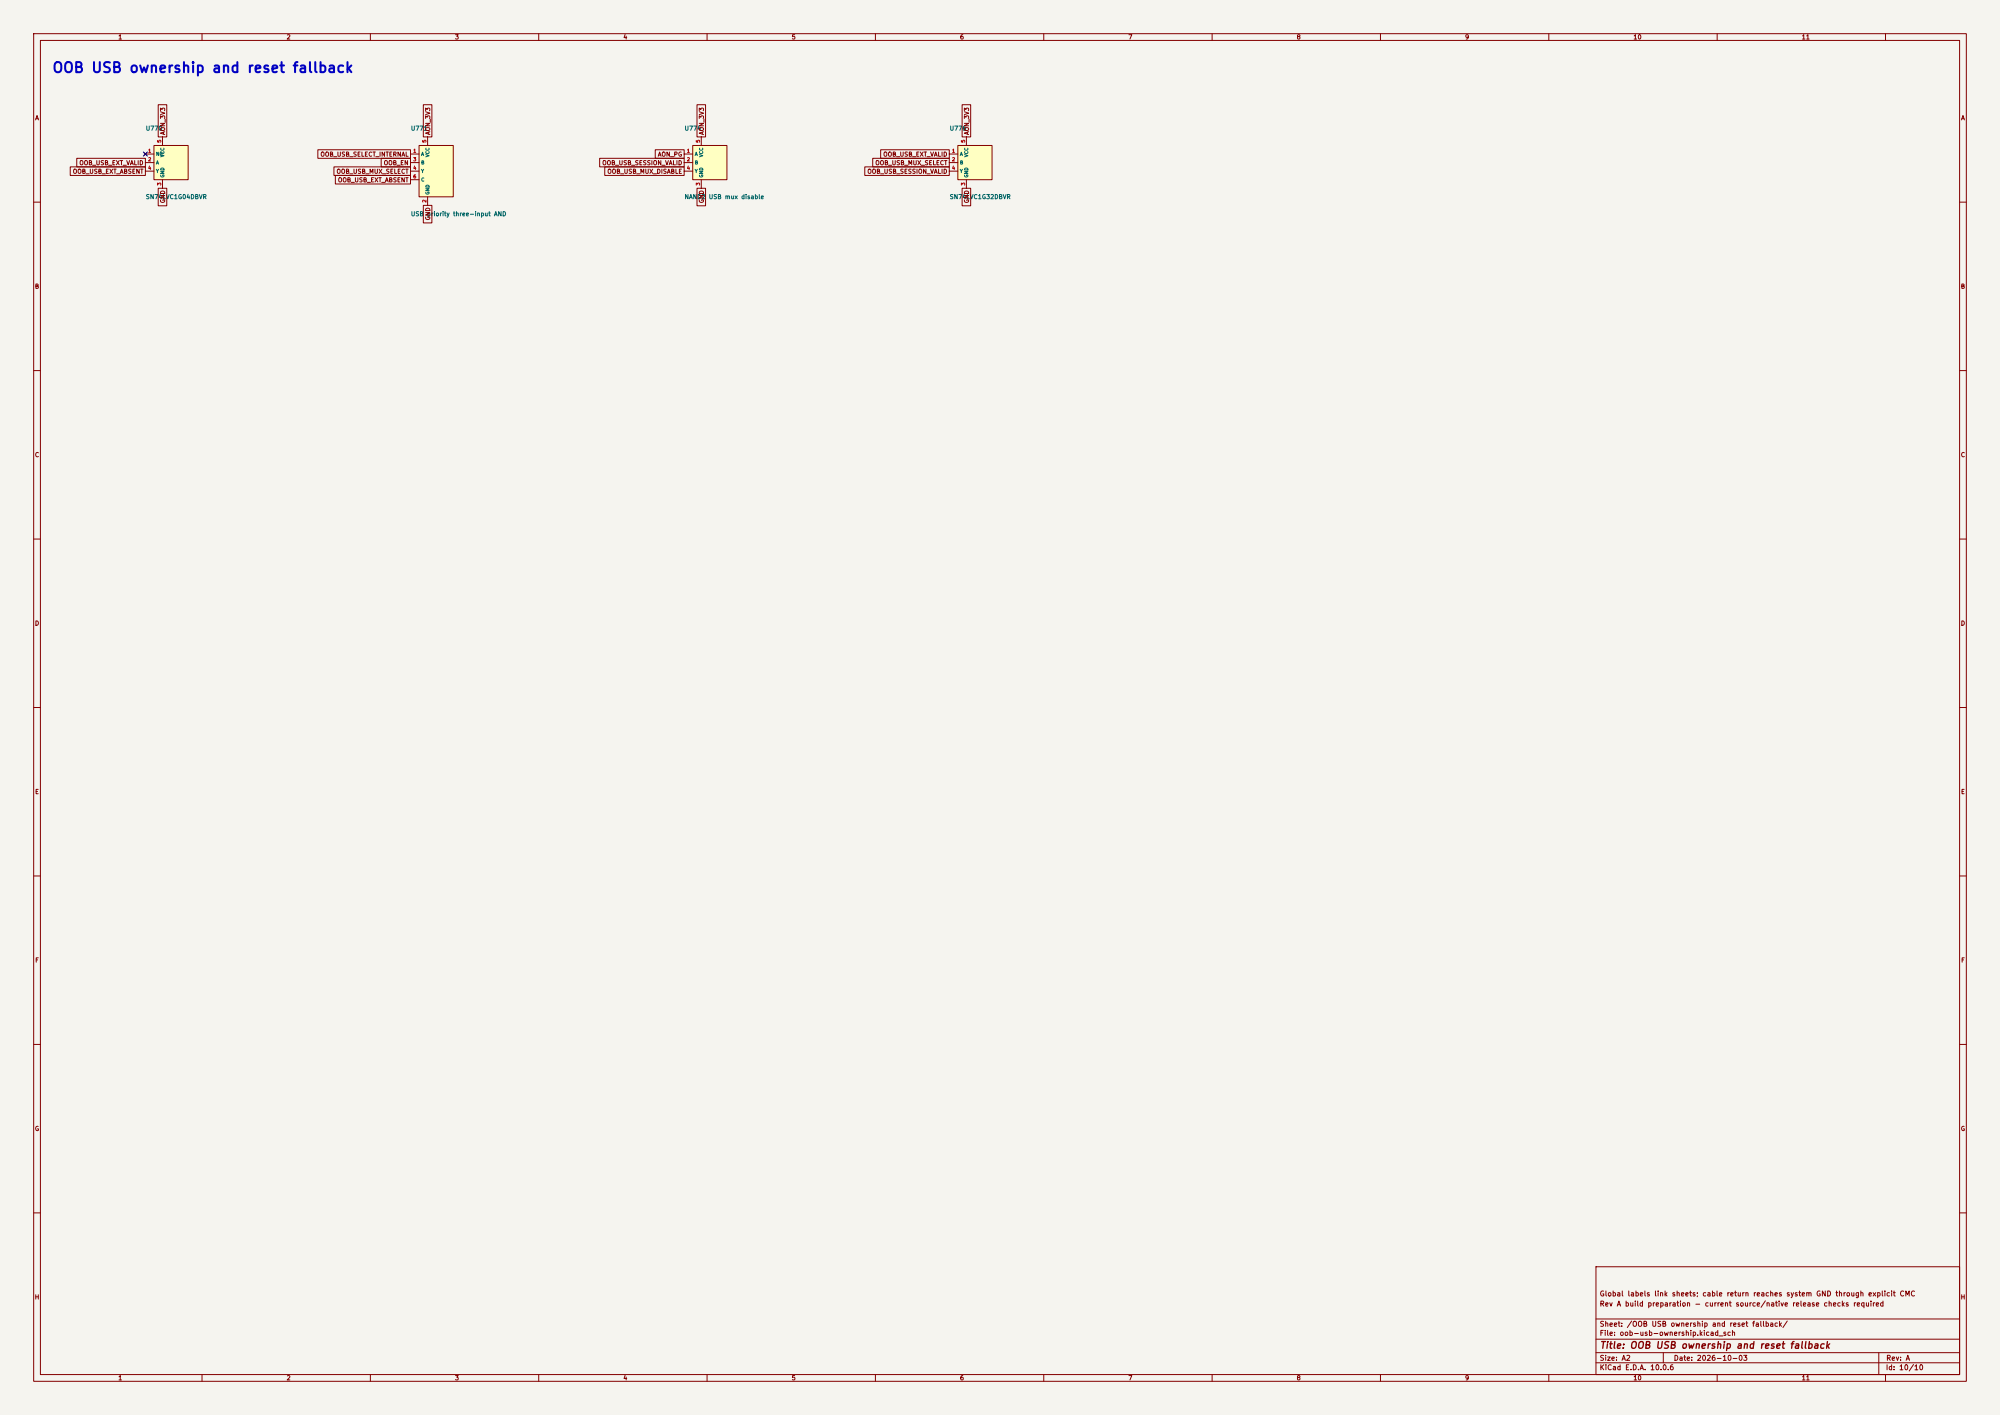
[picture p31: page 10]

Sheet: /OOB USB ownership and reset fallback/
File: oob-usb-ownership.kicad_sch
Title: OOB USB ownership and reset fallback
