ripclap/rm520n-carrier/manufacturing/rev-a/assembly/back.pdf

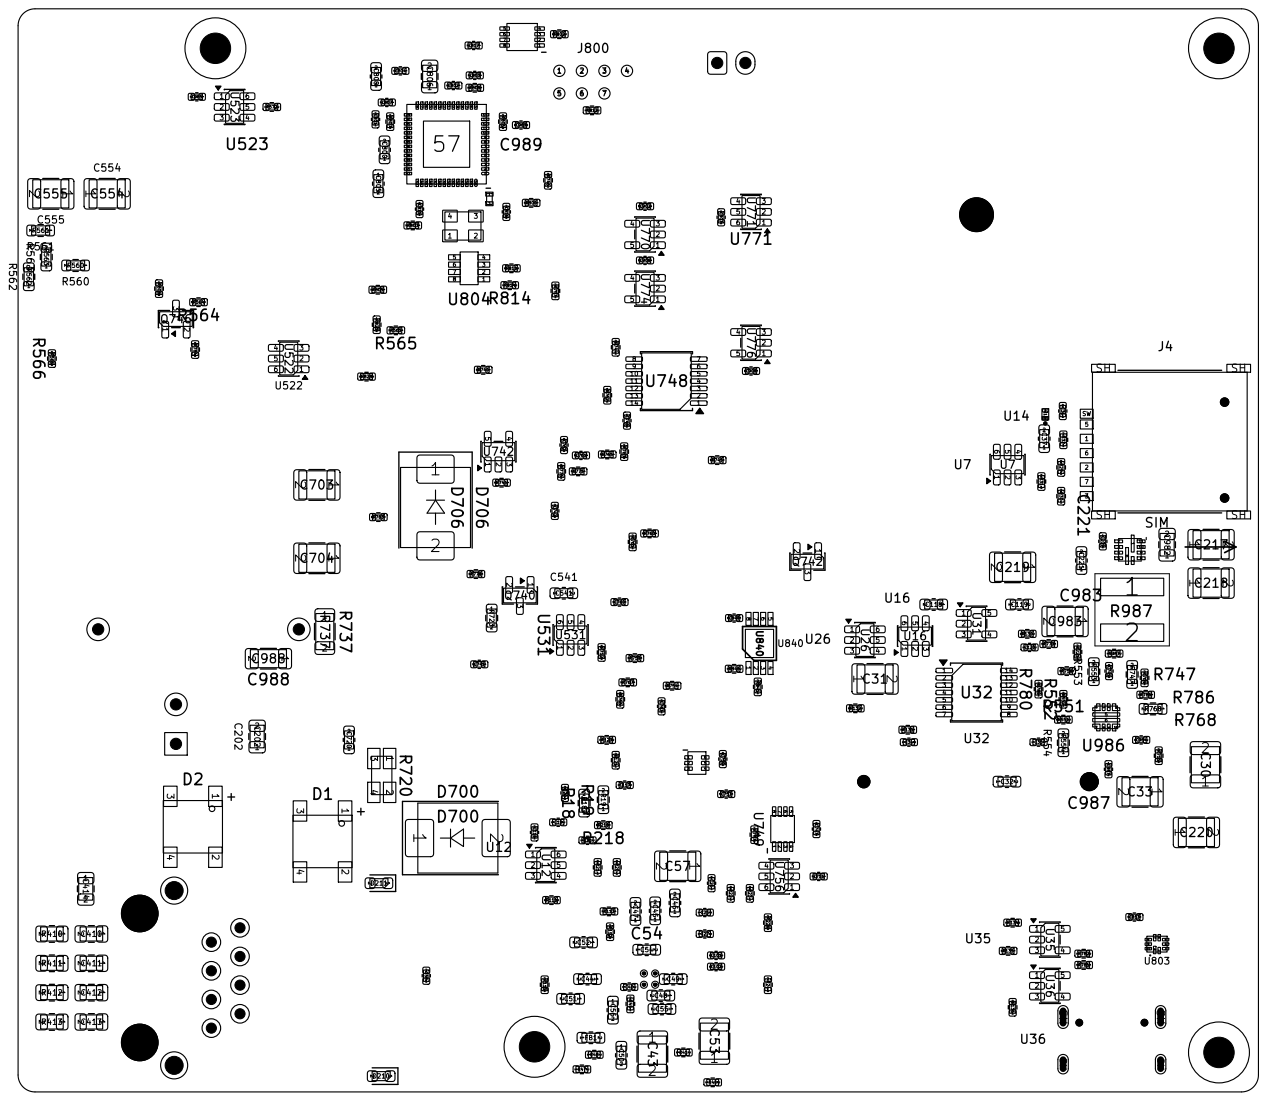
[picture p32: page 1]
