ripclap/rm520n-carrier/manufacturing/rev-a/assembly/front.pdf

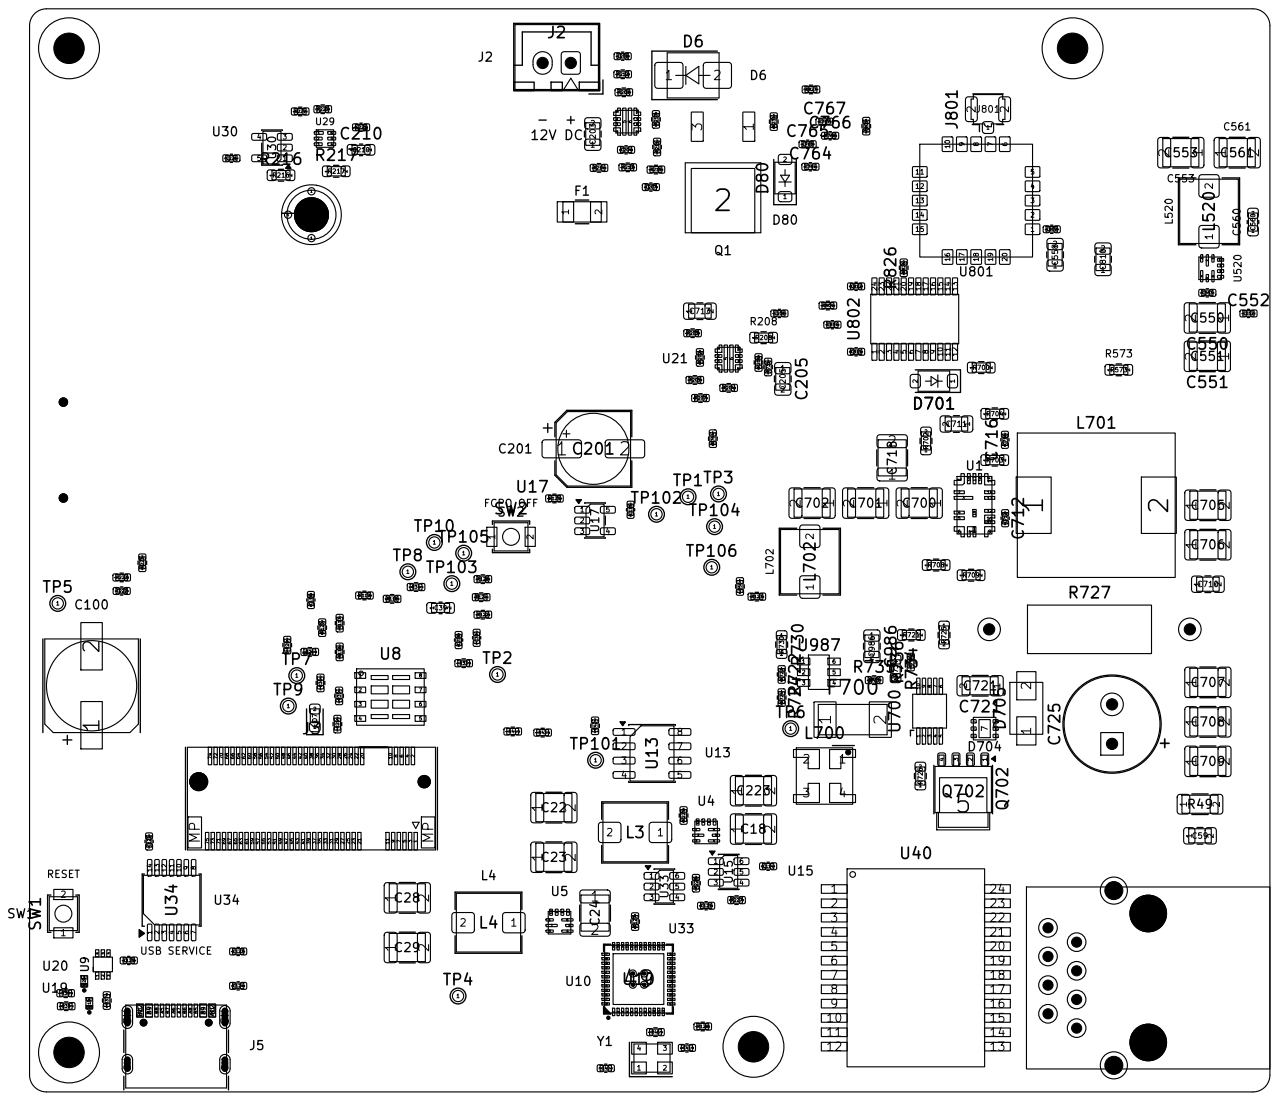
[picture p33: page 1]
