ripclap/rm520n-carrier/hardware/rev-a/carrier.kicad_pcb

## KiCad design hardware/rev-a/carrier.kicad_pcb (2026-10-13)

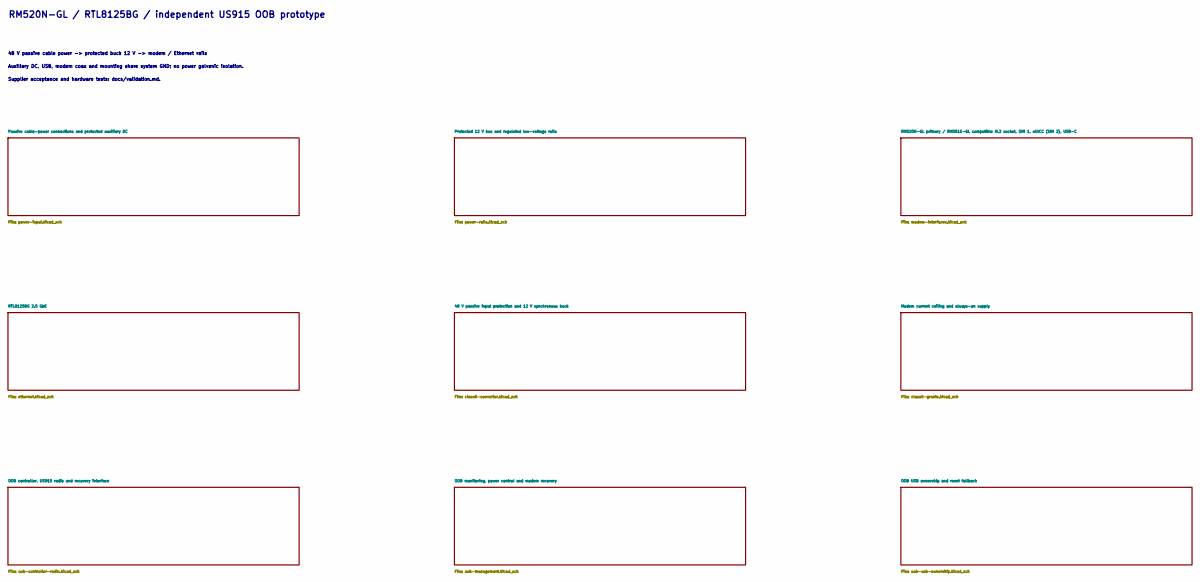
[picture p34: schematic carrier.kicad_sch, RM520N-GL passive carrier with independent US915 OOB]

Notes on the sheet:
RM520N-GL / RTL8125BG / independent US915 OOB prototype
48 V passive cable power -> protected buck 12 V -> modem / Ethernet rails
Auxiliary DC, USB, modem coax and mounting share system GND; no power galvanic isolation.
Supplier acceptance and hardware tests: docs/validation.md.

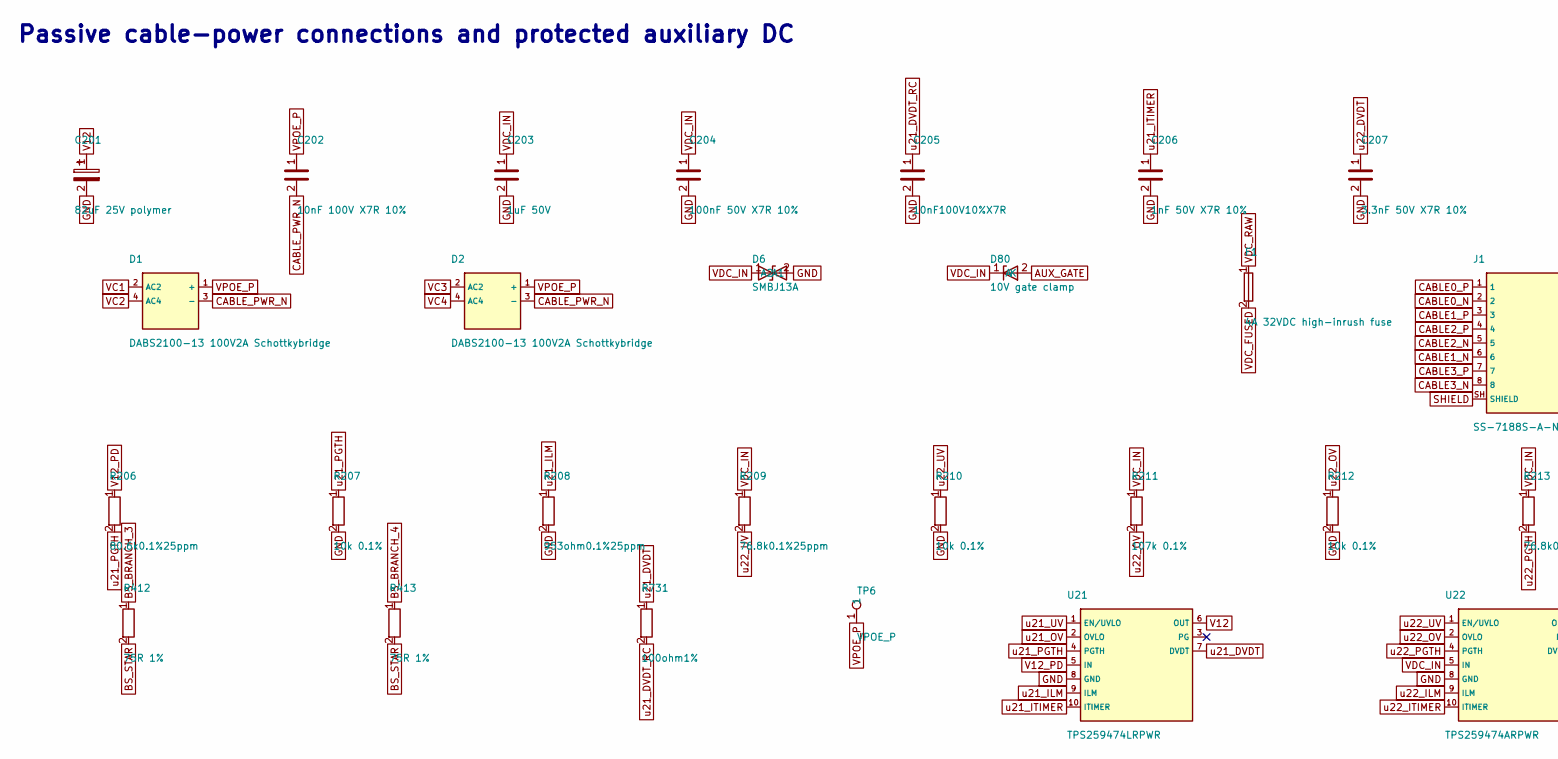
[picture p35: schematic power-input.kicad_sch, Passive cable-power connections and protected auxiliary DC, part in row 1, column 1]

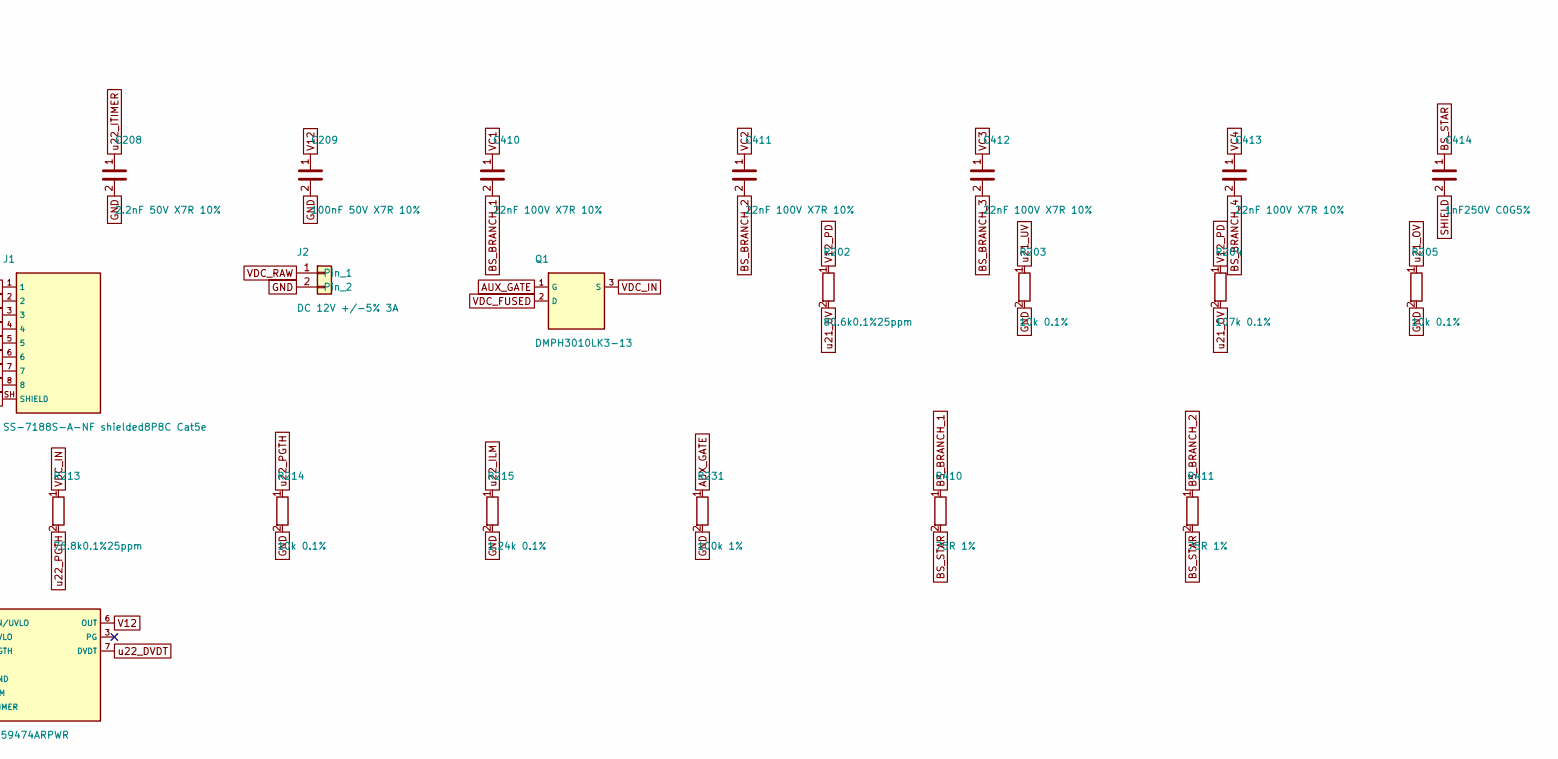
[picture p36: schematic power-input.kicad_sch, Passive cable-power connections and protected auxiliary DC, part in row 1, column 2]

Parts:
C201: 82uF 25V polymer; CP_Elec_6.3x5.9; MPN 25SVPK82M
C202: 10nF 100V X7R 10%; C_0805_2012Metric; MPN C0805C103K1RACTU
C203: 1uF 50V; C_0805_2012Metric; MPN CL21B105KBFNNNF; LCSC C16195091
C204, C209: 100nF 50V X7R 10%; C_0402_1005Metric; MPN CL05B104KB5NNNC; LCSC C960916
C205: 10nF100V10%X7R; C_0805_2012Metric_DenseRevA_C205; MPN C0805C103K1RACTU
C206: 1nF 50V X7R 10%; C_0402_1005Metric; MPN C0402C102K5RACTU
C207: 3.3nF 50V X7R 10%; C_0402_1005Metric; MPN C0402C332K5RACTU
C208: 2.2nF 50V X7R 10%; C_0402_1005Metric; MPN C0402C222K5RACTU
C410, C411, C412, C413: 22nF 100V X7R 10%; C_0805_2012Metric; MPN C0805C223K1RACTU; LCSC C2178056
C414: 1nF250V C0G5%; C_0805_2012Metric; MPN C0805C102JAGACTU
D1, D2: DABS2100-13 100V2A Schottkybridge; Diodes_DABS2100_ABS_4_SMD; MPN DABS2100-13
D6: SMBJ13A; D_SMB; MPN SMBJ13A
D80: 10V gate clamp; D_SOD-123; MPN MMSZ5240B-7-F
F1: 4A 32VDC high-inrush fuse; AEM_F1206HI_1206; MPN F1206HI4000V032TM; LCSC C246771
J1: SS-7188S-A-NF shielded8P8C Cat5e; Stewart_SS_7188S_A_NF_ComponentSideCorrected; MPN SS-7188S-A-NF
J2: DC 12V +/-5% 3A; JST_XH_B2B-XH-A_1x02_P2.50mm_Vertical; MPN B2B-XH-A(LF)(SN)
Q1: DMPH3010LK3-13; Diodes_TO252_DMPH3010LK3; MPN DMPH3010LK3-13
R202: 80.6k0.1%25ppm; R_0402_1005Metric; MPN RT0402BRD0780K6L
R203, R205, R207, R210, R212, R214: 10k 0.1%; R_0402_1005Metric; MPN TNPW040210K0BEED
R204, R211: 107k 0.1%; R_0402_1005Metric; MPN RT0402BRD07107KL
R206: 80.6k0.1%25ppm; R_0402_1005Metric_DenseRevA_R206; MPN RT0402BRD0780K6L
R208: 953ohm0.1%25ppm; R_0603_1608Metric; MPN RT0603BRD07953RL
R209, R213: 76.8k0.1%25ppm; R_0402_1005Metric; MPN RT0402BRD0776K8L; LCSC C852913
R215: 1.24k 0.1%; R_0402_1005Metric; MPN TNPW04021K24BEED
R231: 100k 1%; R_0402_1005Metric; MPN CRCW0402100KFKED
R410, R411, R412, R413: 75R 1%; R_0805_2012Metric; MPN CRCW080575R0FKEA
R731: 100ohm1%; R_0402_1005Metric_DenseRevA_R731; MPN CRCW0402100RFKED
TP6: VPOE_P; TestPoint_Pad_D1.0mm
U21: TPS259474LRPWR; TI_RPW0010A_TPS25947; MPN TPS259474LRPWR
U22: TPS259474ARPWR; TI_RPW0010A_TPS25947; MPN TPS259474ARPWR

Connections:
AUX_GATE: D80.2 (A), Q1.1 (G), R231.1
BS_BRANCH_1: C410.2, R410.1
BS_BRANCH_2: C411.2, R411.1
BS_BRANCH_3: C412.2, R412.1
BS_BRANCH_4: C413.2, R413.1
BS_STAR: C414.1, R410.2, R411.2, R412.2, R413.2
CABLE0_N: J1.2; also elsewhere on the board
CABLE0_P: J1.1; also elsewhere on the board
CABLE1_N: J1.6; also elsewhere on the board
CABLE1_P: J1.3; also elsewhere on the board
CABLE2_N: J1.5; also elsewhere on the board
CABLE2_P: J1.4; also elsewhere on the board
CABLE3_N: J1.8; also elsewhere on the board
CABLE3_P: J1.7; also elsewhere on the board
CABLE_PWR_N: C202.2, D1.3 (-), D2.3 (-); also elsewhere on the board
GND: C201.2, C203.2, C204.2, C205.2, C206.2, C207.2, C208.2, C209.2, D6.2 (A2), J2.2, R203.2, R205.2, R207.2, R208.2, R210.2, R212.2, R214.2, R215.2, R231.2, U21.8 (GND), U22.8 (GND); also elsewhere on the board
SHIELD: C414.2, J1.SH (SHIELD); also elsewhere on the board
V12: C201.1, C209.1, U21.6 (OUT), U22.6 (OUT); also elsewhere on the board
V12_PD: R202.1, R204.1, R206.1, U21.5 (IN); also elsewhere on the board
VC1: C410.1, D1.2 (AC2); also elsewhere on the board
VC2: C411.1, D1.4 (AC4); also elsewhere on the board
VC3: C412.1, D2.2 (AC2); also elsewhere on the board
VC4: C413.1, D2.4 (AC4); also elsewhere on the board
VDC_FUSED: F1.2, Q1.2 (D)
VDC_IN: C203.1, C204.1, D6.1 (A1), D80.1 (K), Q1.3 (S), R209.1, R211.1, R213.1, U22.5 (IN); also elsewhere on the board
VDC_RAW: F1.1, J2.1
VPOE_P: C202.1, D1.1 (+), D2.1 (+), TP6.1 (1_1); also elsewhere on the board
u21_DVDT: R731.1, U21.7 (DVDT)
u21_DVDT_RC: C205.1, R731.2
u21_ILM: R208.1, U21.9 (ILM)
u21_ITIMER: C206.1, U21.10 (ITIMER)
u21_OV: R204.2, R205.1, U21.2 (OVLO)
u21_PGTH: R206.2, R207.1, U21.4 (PGTH)
u21_UV: R202.2, R203.1, U21.1 (EN/UVLO); also elsewhere on the board
u22_DVDT: C207.1, U22.7 (DVDT)
u22_ILM: R215.1, U22.9 (ILM)
u22_ITIMER: C208.1, U22.10 (ITIMER)
u22_OV: R211.2, R212.1, U22.2 (OVLO)
u22_PGTH: R213.2, R214.1, U22.4 (PGTH)
u22_UV: R209.2, R210.1, U22.1 (EN/UVLO)

Notes on the sheet:
Passive cable-power connections and protected auxiliary DC

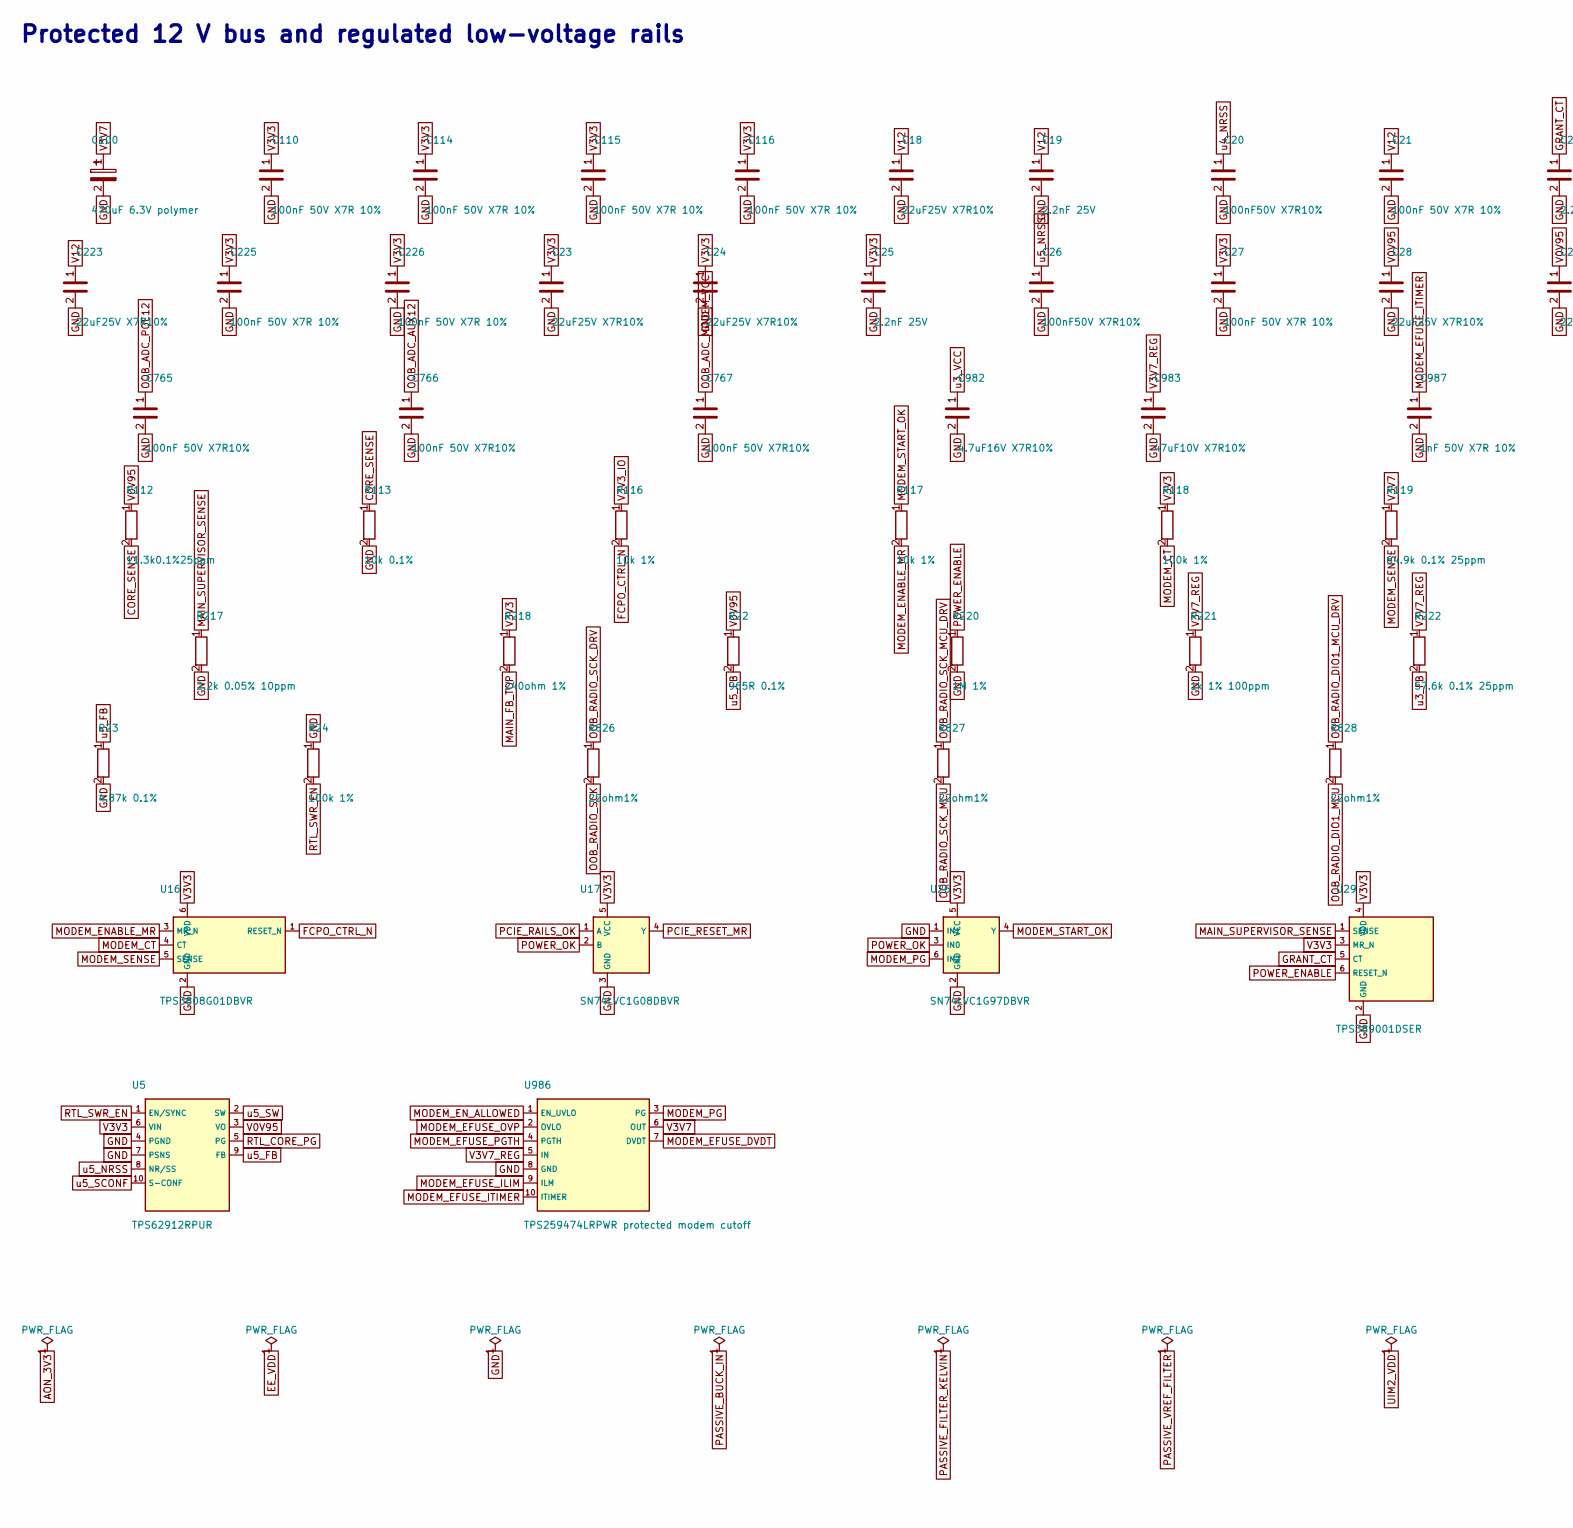
[picture p37: schematic power-rails.kicad_sch, Protected 12 V bus and regulated low-voltage rails, part in row 1, column 1]

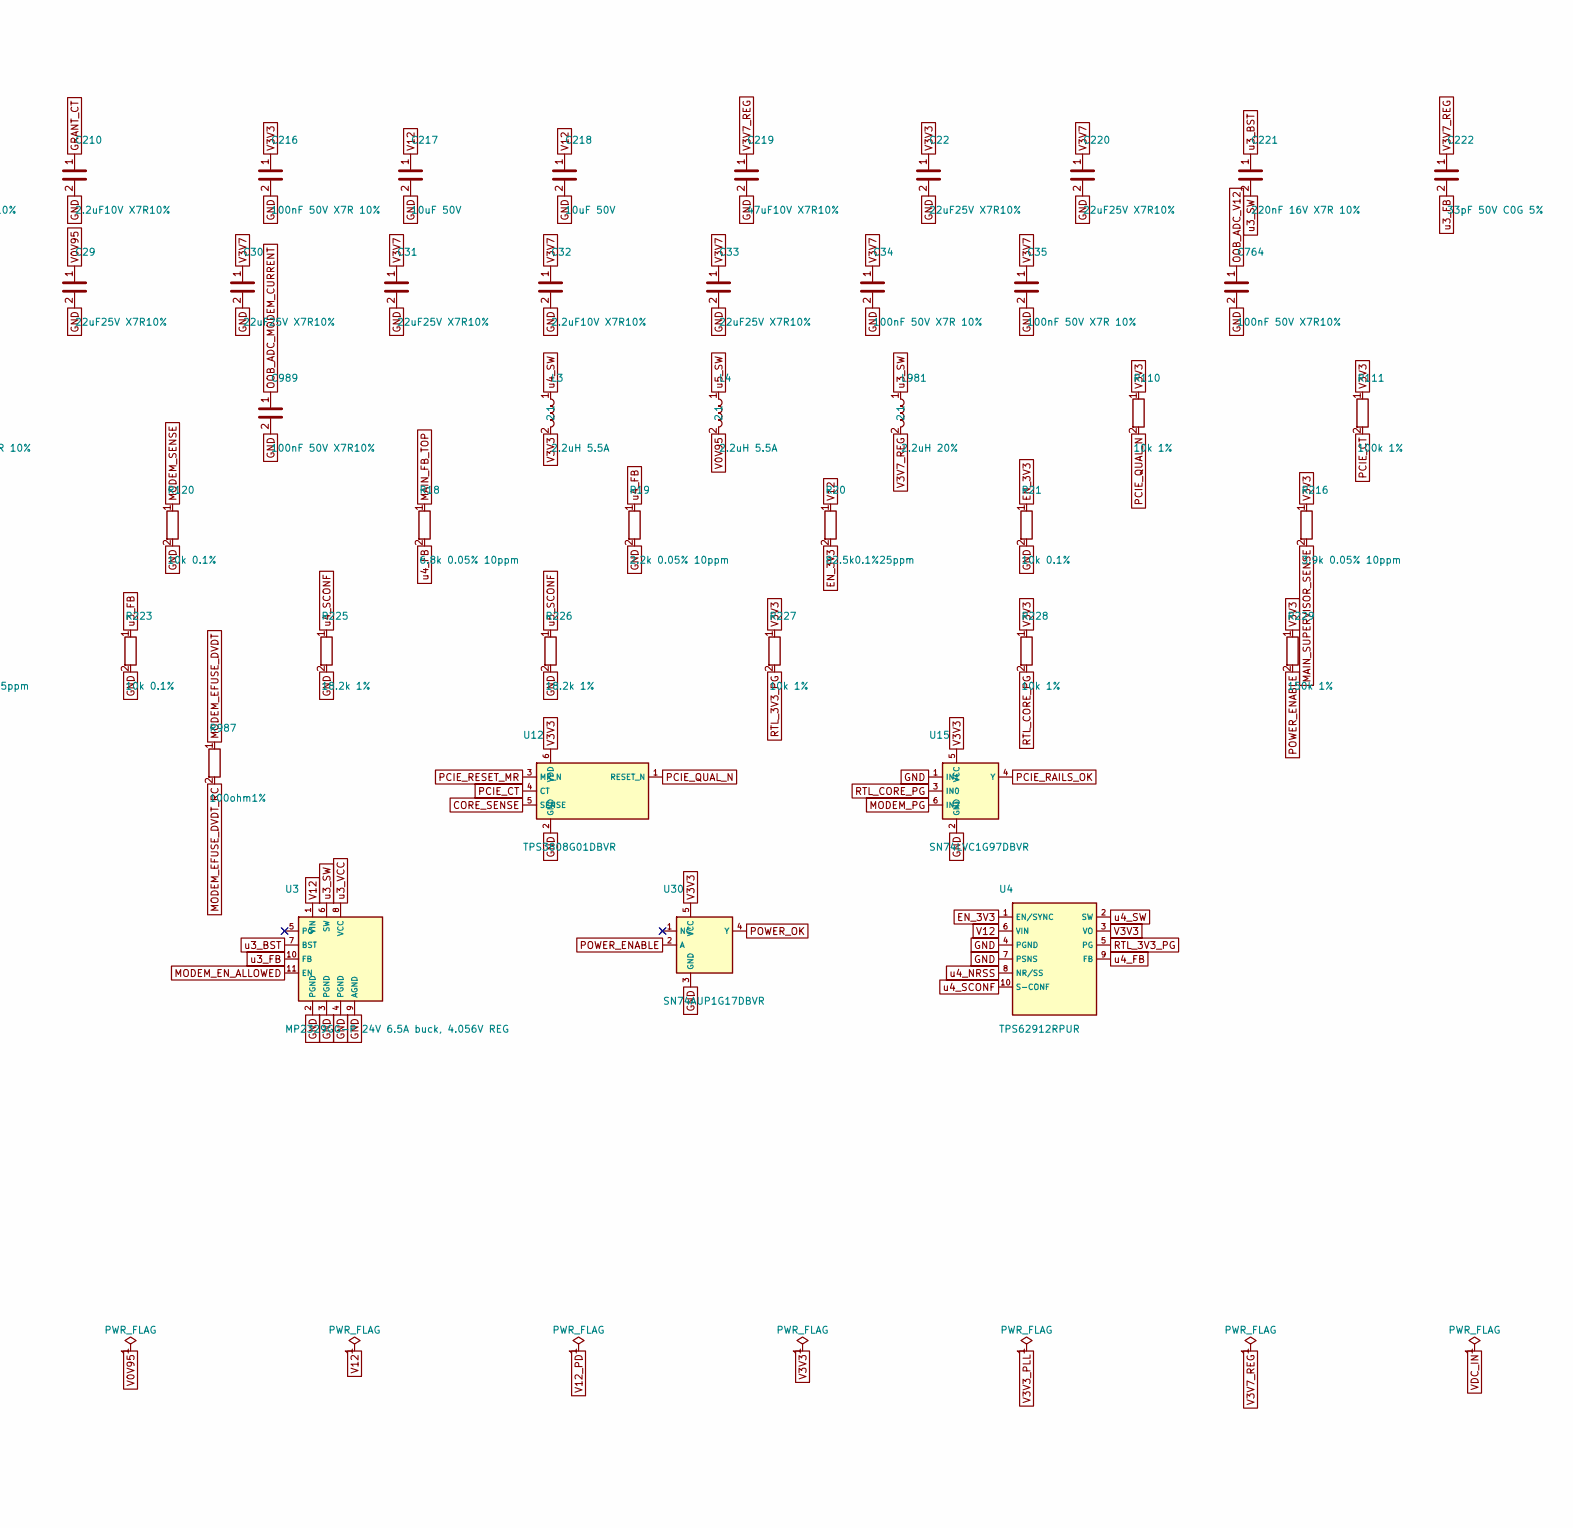
[picture p38: schematic power-rails.kicad_sch, Protected 12 V bus and regulated low-voltage rails, part in row 1, column 2]

Parts:
C18, C22, C23, C24, C28, C29, C30, C31, C33, C220, C223: 22uF25V X7R10%; C_1210_3225Metric; MPN CL32B226KAJNNNE; LCSC C309062
C19, C25: 2.2nF 25V; C_0402_1005Metric; MPN GRM155R71E222KA01D
C20, C26: 100nF50V X7R10%; C_0402_1005Metric; MPN CL05B104KB5NNNC; LCSC C960916
C21, C27, C34, C35, C110, C114, C115, C116, C216, C225, C226: 100nF 50V X7R 10%; C_0402_1005Metric; MPN CL05B104KB5NNNC; LCSC C960916
C32, C210: 2.2uF10V X7R10%; C_0603_1608Metric; MPN CL10B225KP8NNNC; LCSC C100082
C100: 470uF 6.3V polymer; Nichicon_RHA_8x6.7_FPCAP; MPN RHA0J471MCN1GS
C217, C218: 10uF 50V; C_1210_3225Metric; MPN CL32B106KBJZW6E
C219: 47uF10V X7R10%; C_1210_3225Metric; MPN CL32B476KPJNNWE
C221: 220nF 16V X7R 10%; C_0603_1608Metric; MPN C0603C224K4RACTU
C222: 33pF 50V C0G 5%; C_0402_1005Metric; MPN C0402C330J5GACTU
C764, C765, C766, C767, C989: 100nF 50V X7R10%; C_0402_1005Metric; MPN CL05B104KB5NNNC; LCSC C960916
C982: 4.7uF16V X7R10%; C_0805_2012Metric; MPN C0805C475K4RACTU
C983: 47uF10V X7R10%; RevA_Dense100_50_C983; MPN CL32B476KPJNNWE
C987: 1nF 50V X7R 10%; C_0402_1005Metric; MPN C0402C102K5RACTU
L3, L4: 2.2uH 5.5A; L_Bourns_SRP5030T; MPN SRP5030TA-2R2M
L981: 2.2uH 20%; RevA_Dense100_50_L981; MPN SRP6030CA-2R2M
R18: 6.8k 0.05% 10ppm; R_0603_1608Metric; MPN RG1608N-682-W-T1
R19, R217: 2.2k 0.05% 10ppm; R_0603_1608Metric; MPN RG1608N-222-W-T1
R20: 82.5k0.1%25ppm; R_0402_1005Metric; MPN RT0402BRD0782K5L
R21, R113, R120, R223: 10k 0.1%; R_0402_1005Metric; MPN TNPW040210K0BEED
R22: 965R 0.1%; R_0402_1005Metric; MPN RN73R1ETTP9650B25
R23: 4.87k 0.1%; R_0402_1005Metric; MPN TNPW04024K87BEED
R24, R111, R118: 100k 1%; R_0402_1005Metric; MPN CRCW0402100KFKED
R110, R116, R117, R227, R228: 10k 1%; R_0402_1005Metric; MPN CRCW040210K0FKED
R112: 11.3k0.1%25ppm; R_0402_1005Metric; MPN RT0402BRD0711K3L
R119: 64.9k 0.1% 25ppm; R_0402_1005Metric; MPN RT0402BRD0764K9L; LCSC C852880
R216: 3.9k 0.05% 10ppm; R_0603_1608Metric; MPN RG1608N-392-W-T1
R218: 240ohm 1%; R_0402_1005Metric; MPN RC0402FR-07240RL
R220: 1M 1%; R_0402_1005Metric; MPN CRCW04021M00FKED
R221: 1k 1% 100ppm; R_0402_1005Metric; MPN CRCW04021K00FKED
R222: 57.6k 0.1% 25ppm; R_0402_1005Metric; MPN RT0402BRD0757K6L
R225, R226: 18.2k 1%; R_0402_1005Metric; MPN CRCW040218K2FKED
R229: 150k 1%; R_0402_1005Metric; MPN CRCW0402150KFKED
R826: 22ohm1%; RevA_DensePrimary100_PIN50_R826; MPN CRCW040222R0FKED
R827, R828: 22ohm1%; R_0402_1005Metric; MPN CRCW040222R0FKED
R987: 100ohm1%; RevA_Dense100_50_R987; MPN CRCW0402100RFKED
U3: MP2329GG-P 24V 6.5A buck, 4.056V REG; MPS_MP2386_QFN11_2x2; MPN MP2329GG-P
U4, U5: TPS62912RPUR; TI_RPU0010A_TPS62912; MPN TPS62912RPUR
U12, U16: TPS3808G01DBVR; SOT-23-6; MPN TPS3808G01DBVR
U15, U26: SN74LVC1G97DBVR; SOT-23-6; MPN SN74LVC1G97DBVR
U17: SN74LVC1G08DBVR; SOT-23-5; MPN SN74LVC1G08DBVR
U29: TPS389001DSER; TI_DSE6_TPS3890_1p5x1p5_Manufacturer; MPN TPS389001DSER
U30: SN74AUP1G17DBVR; SOT-23-5; MPN SN74AUP1G17DBVR
U986: TPS259474LRPWR protected modem cutoff; TI_RPW0010A_TPS25947; MPN TPS259474LRPWR

Connections:
CORE_SENSE: R112.2, R113.1, U12.5 (SENSE)
EN_3V3: R20.2, R21.1, U4.1 (EN/SYNC)
FCPO_CTRL_N: R116.2, U16.1 (RESET_N); also elsewhere on the board
GND: C18.2, C19.2, C20.2, C21.2, C22.2, C23.2, C24.2, C25.2, C26.2, C27.2, C28.2, C29.2, C30.2, C31.2, C32.2, C33.2, C34.2, C35.2, C100.2, C110.2, C114.2, C115.2, C116.2, C210.2, C216.2, C217.2, C218.2, C219.2, C220.2, C223.2, C225.2, C226.2, C764.2, C765.2, C766.2, C767.2, C982.2, C983.2, C987.2, C989.2, R19.2, R21.2, R23.2, R24.1, R113.2, R120.2, R217.2, R220.2, R221.2, R223.2, R225.2, R226.2, U3.2 (PGND), U3.3 (PGND), U3.4 (PGND), U3.9 (AGND), U4.4 (PGND), U4.7 (PSNS), U5.4 (PGND), U5.7 (PSNS), U12.2 (GND), U15.1 (IN1), U15.2 (GND), U16.2 (GND), U17.3 (GND), U26.1 (IN1), U26.2 (GND), U29.2 (GND), U30.3 (GND), U986.8 (GND); also elsewhere on the board
GRANT_CT: C210.1, U29.5 (CT)
MAIN_FB_TOP: R18.1, R218.2
MAIN_SUPERVISOR_SENSE: R216.2, R217.1, U29.1 (SENSE)
MODEM_CT: R118.2, U16.4 (CT)
MODEM_EFUSE_DVDT: R987.1, U986.7 (DVDT)
MODEM_EFUSE_DVDT_RC: R987.2; also elsewhere on the board
MODEM_EFUSE_ILIM: U986.9 (ILM); also elsewhere on the board
MODEM_EFUSE_ITIMER: C987.1, U986.10 (ITIMER)
MODEM_EFUSE_OVP: U986.2 (OVLO); also elsewhere on the board
MODEM_EFUSE_PGTH: U986.4 (PGTH); also elsewhere on the board
MODEM_ENABLE_MR: R117.2, U16.3 (MR_N); also elsewhere on the board
MODEM_EN_ALLOWED: U3.11 (EN), U986.1 (EN_UVLO); also elsewhere on the board
MODEM_PG: U15.6 (IN2), U26.6 (IN2), U986.3 (PG); also elsewhere on the board
MODEM_SENSE: R119.2, R120.1, U16.5 (SENSE)
MODEM_START_OK: R117.1, U26.4 (Y); also elsewhere on the board
OOB_ADC_AUX12: C766.1; also elsewhere on the board
OOB_ADC_MODEM_CURRENT: C989.1; also elsewhere on the board
OOB_ADC_MODEM_VCC: C767.1; also elsewhere on the board
OOB_ADC_POE12: C765.1; also elsewhere on the board
OOB_ADC_V12: C764.1; also elsewhere on the board
OOB_RADIO_DIO1_MCU: R828.2; also elsewhere on the board
OOB_RADIO_DIO1_MCU_DRV: R828.1; also elsewhere on the board
OOB_RADIO_SCK: R826.2; also elsewhere on the board
OOB_RADIO_SCK_DRV: R826.1; also elsewhere on the board
OOB_RADIO_SCK_MCU: R827.2; also elsewhere on the board
OOB_RADIO_SCK_MCU_DRV: R827.1; also elsewhere on the board
PCIE_CT: R111.2, U12.4 (CT)
PCIE_QUAL_N: R110.2, U12.1 (RESET_N); also elsewhere on the board
PCIE_RAILS_OK: U15.4 (Y), U17.1 (A)
PCIE_RESET_MR: U12.3 (MR_N), U17.4 (Y)
POWER_ENABLE: R220.1, R229.2, U29.6 (RESET_N), U30.2 (A)
POWER_OK: U17.2 (B), U26.3 (IN0), U30.4 (Y); also elsewhere on the board
RTL_3V3_PG: R227.2, U4.5 (PG)
RTL_CORE_PG: R228.2, U5.5 (PG), U15.3 (IN0)
RTL_SWR_EN: R24.2, U5.1 (EN/SYNC); also elsewhere on the board
V0V95: C28.1, C29.1, L4.2, R22.1, R112.1, U5.3 (VO); also elsewhere on the board
V3V3: C22.1, C23.1, C24.1, C25.1, C27.1, C110.1, C114.1, C115.1, C116.1, C216.1, C225.1, C226.1, L3.2, R110.1, R111.1, R118.1, R216.1, R218.1, R227.1, R228.1, R229.1, U4.3 (VO), U5.6 (VIN), U12.6 (VDD), U15.5 (VCC), U16.6 (VDD), U17.5 (VCC), U26.5 (VCC), U29.3 (MR_N), U29.4 (VDD), U30.5 (VCC); also elsewhere on the board
V3V3_IO: R116.1; also elsewhere on the board
V3V7: C30.1, C31.1, C32.1, C33.1, C34.1, C35.1, C100.1, C220.1, R119.1, U986.6 (OUT); also elsewhere on the board
V3V7_REG: C219.1, C222.1, C983.1, L981.2, R221.1, R222.1, U986.5 (IN); also elsewhere on the board
V12: C18.1, C19.1, C21.1, C217.1, C218.1, C223.1, R20.1, U3.1 (VIN), U4.6 (VIN); also elsewhere on the board
u3_BST: C221.1, U3.7 (BST)
u3_FB: C222.2, R222.2, R223.1, U3.10 (FB)
u3_SW: C221.2, L981.1, U3.6 (SW)
u3_VCC: C982.1, U3.8 (VCC)
u4_FB: R18.2, R19.1, U4.9 (FB)
u4_NRSS: C20.1, U4.8 (NR/SS)
u4_SCONF: R225.1, U4.10 (S-CONF)
u4_SW: L3.1, U4.2 (SW)
u5_FB: R22.2, R23.1, U5.9 (FB)
u5_NRSS: C26.1, U5.8 (NR/SS)
u5_SCONF: R226.1, U5.10 (S-CONF)
u5_SW: L4.1, U5.2 (SW)

Notes on the sheet:
Protected 12 V bus and regulated low-voltage rails

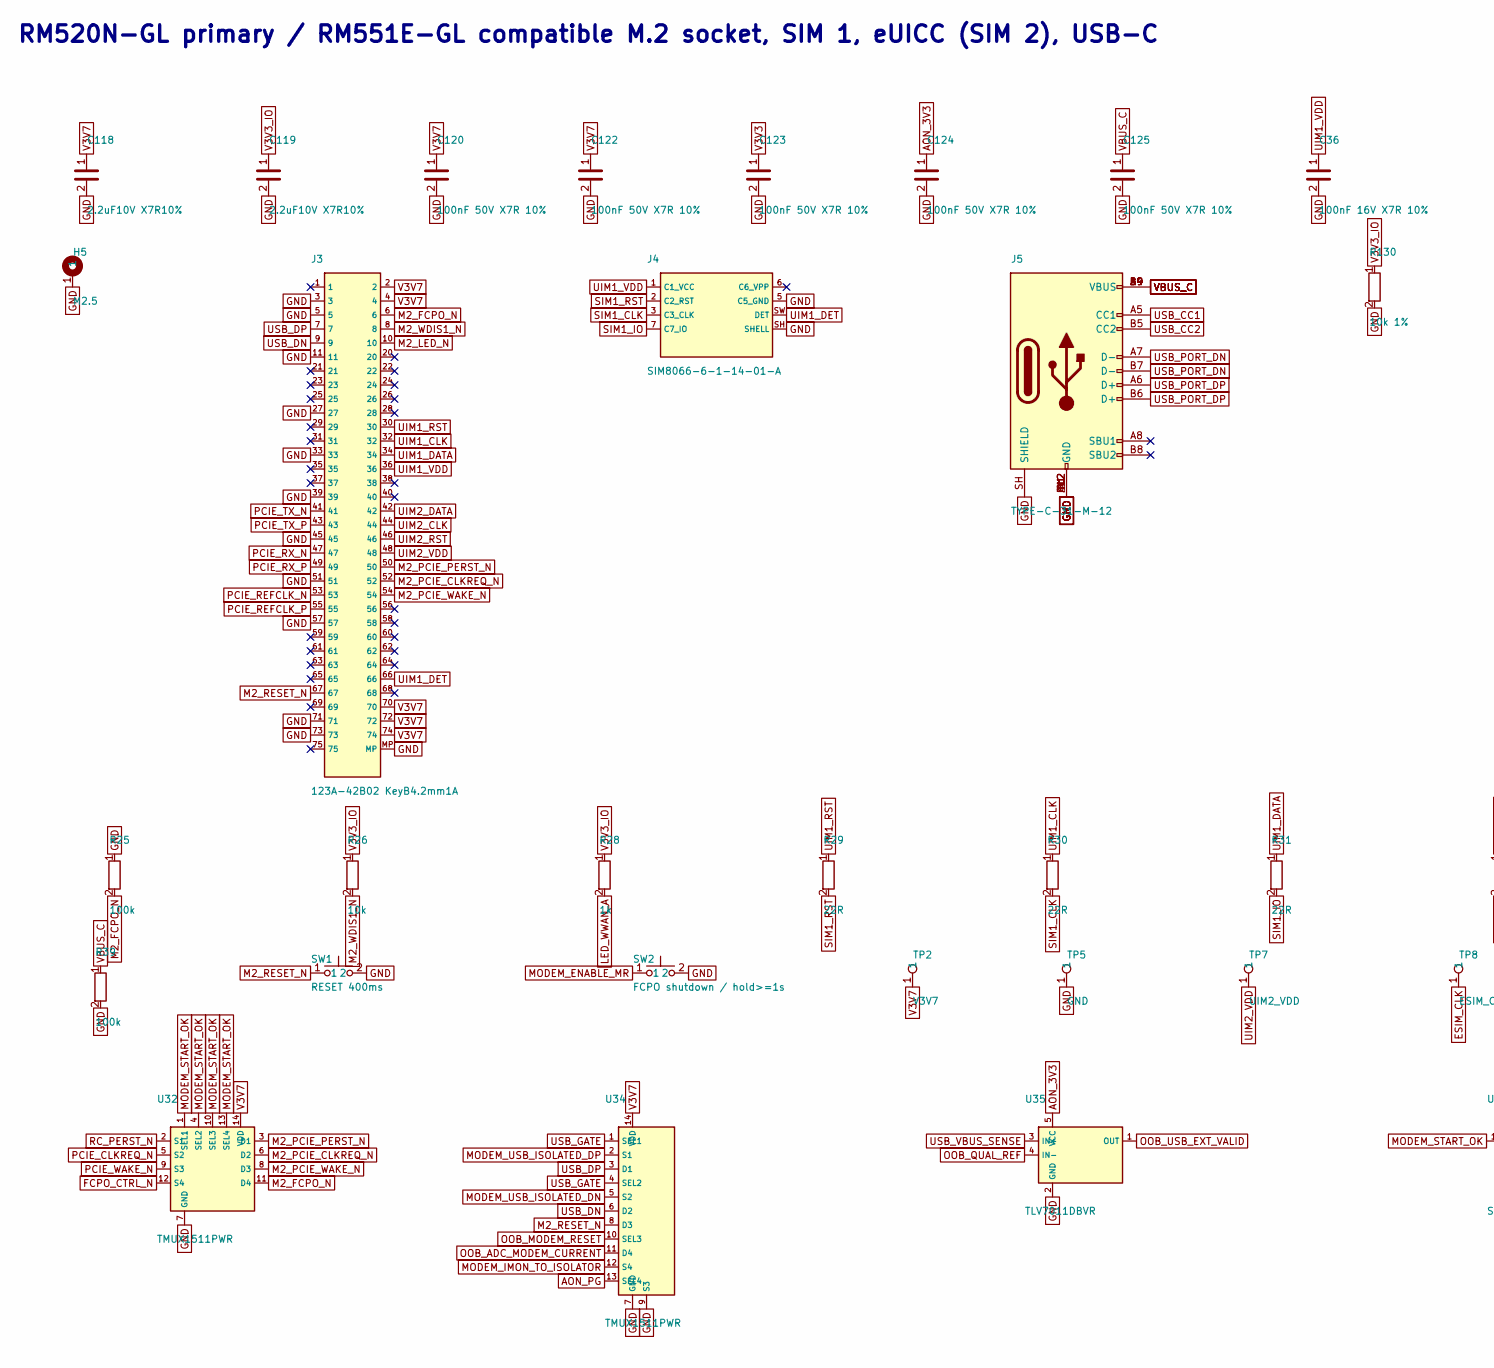
[picture p39: schematic modem-interfaces.kicad_sch, RM520N-GL primary / RM551E-GL compatible M.2 socket, SIM 1,…, part in row 1, column 1]

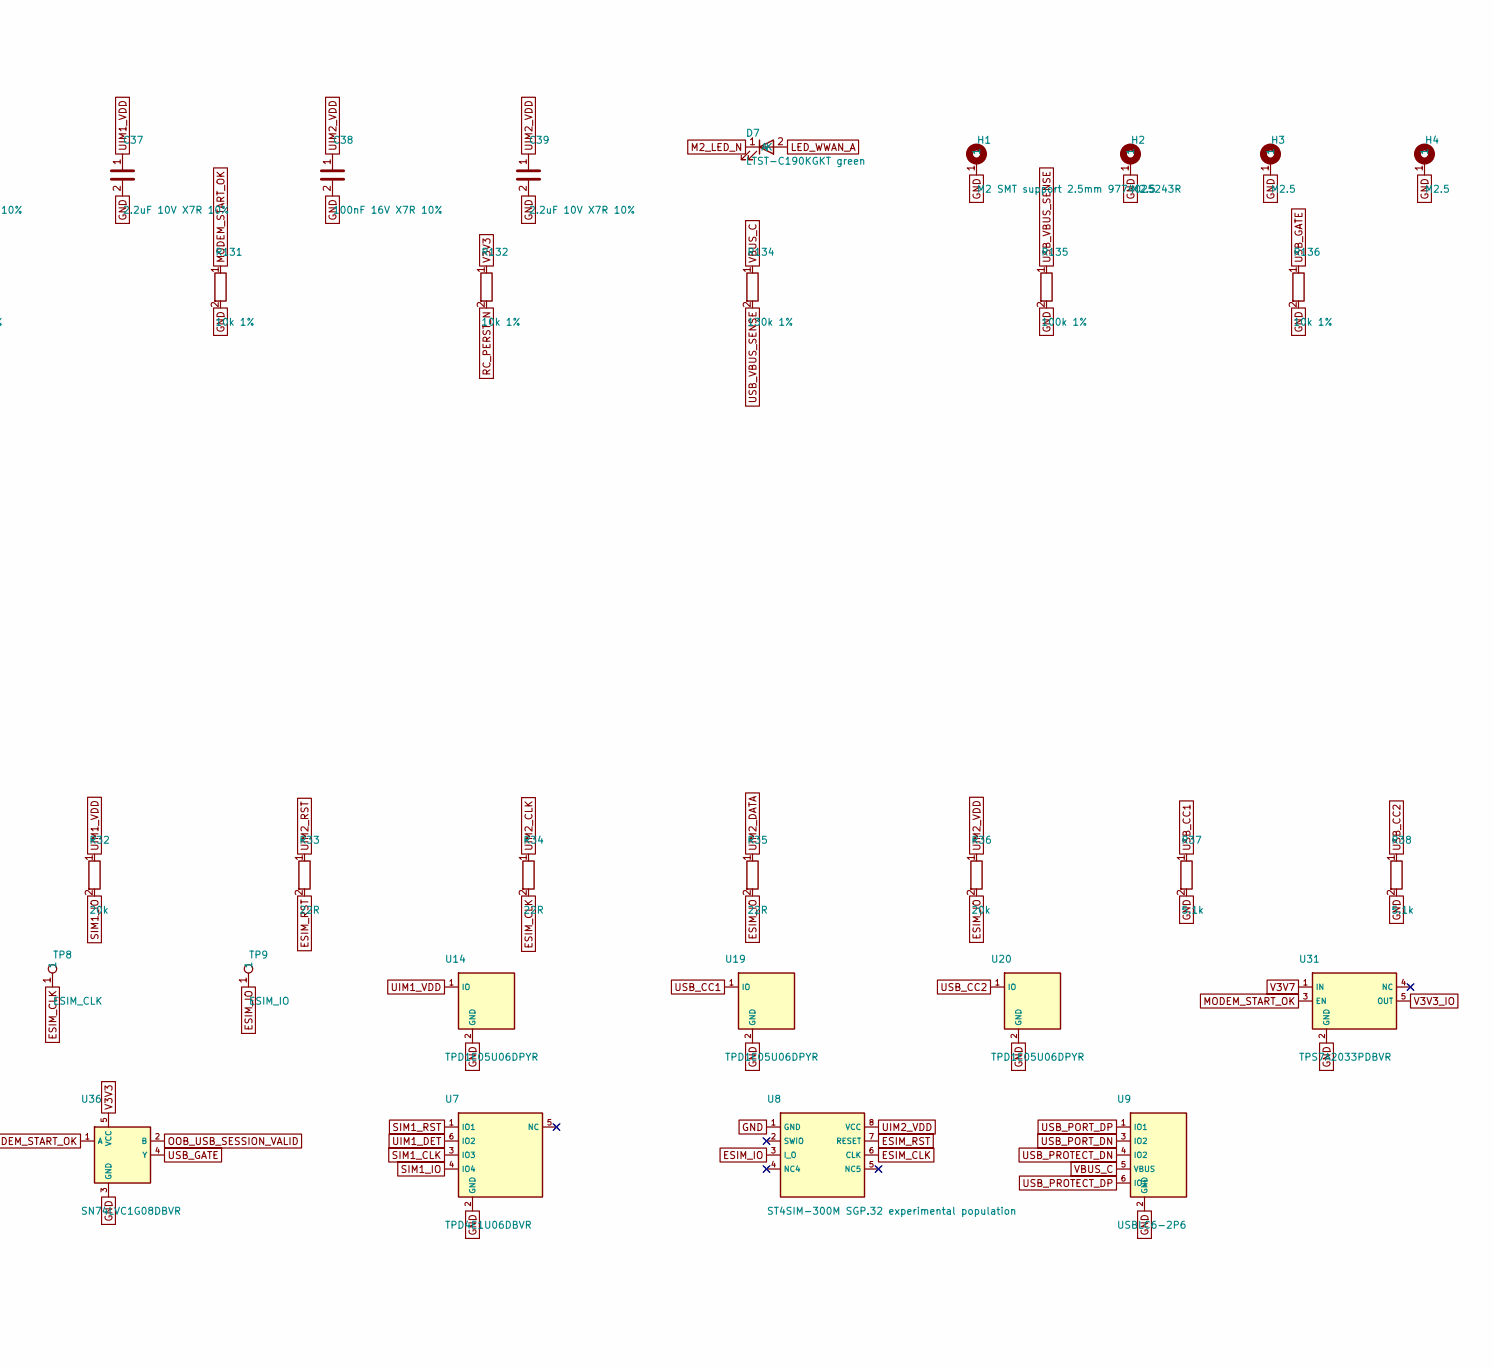
[picture p40: schematic modem-interfaces.kicad_sch, RM520N-GL primary / RM551E-GL compatible M.2 socket, SIM 1,…, part in row 1, column 2]

Parts:
C36, C38: 100nF 16V X7R 10%; C_0402_1005Metric; MPN GRM155R71C104KA88D
C37, C39: 2.2uF 10V X7R 10%; C_0603_1608Metric; MPN CL10B225KP8NNNC
C118, C119: 2.2uF10V X7R10%; C_0603_1608Metric; MPN CL10B225KP8NNNC; LCSC C100082
C120: 100nF 50V X7R 10%; RevA_Dense100_50_C120; MPN CL05B104KB5NNNC; LCSC C960916
C122, C123, C124, C125: 100nF 50V X7R 10%; C_0402_1005Metric; MPN CL05B104KB5NNNC; LCSC C960916
D7: LTST-C190KGKT green; LED_0603_1608Metric; MPN LTST-C190KGKT
H1: M2 SMT support 2.5mm 9774025243R; Wurth_9774025243R_M2_H2p5; MPN 9774025243R
H2, H3, H4, H5: M2.5; MountingHole_2p7_M2p5_GND_SingleBore
J3: 123A-42B02 KeyB4.2mm1A; M2_ATTEND_123A_42B02_CardMinusY; MPN 123A-42B02
J4: SIM8066-6-1-14-01-A; nanoSIM_GCT_SIM8066-6-1-14-01-A_RevB; MPN SIM8066-6-1-14-01-A
J5: TYPE-C-31-M-12; USB_C_HRO_TYPE-C-31-M-12_20201208; MPN TYPE-C-31-M-12
R25, R39: 100k; R_0402_1005Metric; MPN CRCW0402100KFKED
R26: 10k; R_0402_1005Metric; MPN CRCW040210K0FKED
R28: 1k; R_0402_1005Metric; MPN CRCW04021K00FKED
R29, R30, R31, R33, R35: 22R; R_0402_1005Metric; MPN CRCW040222R0FKED
R32, R36: 20k; R_0402_1005Metric; MPN CRCW040220K0FKED
R34: 22R; R_0402_1005Metric_DenseRevA_R34; MPN CRCW040222R0FKED
R37, R38: 5.1k; R_0402_1005Metric; MPN CRCW04025K10FKED
R130, R131, R132, R136: 10k 1%; R_0402_1005Metric; MPN CRCW040210K0FKED
R134: 130k 1%; R_0402_1005Metric; MPN RC0402FR-07130KL; LCSC C93946
R135: 100k 1%; R_0402_1005Metric; MPN CRCW0402100KFKED
SW1: RESET 400ms; SW_SPST_B3U-1000P; MPN B3U-1000P
SW2: FCPO shutdown / hold>=1s; SW_SPST_B3U-1000P; MPN B3U-1000P
TP2: V3V7; TestPoint_Pad_D1.0mm
TP5: GND; TestPoint_Pad_D1.0mm
TP7: UIM2_VDD; TestPoint_Pad_D1.0mm
TP8: ESIM_CLK; TestPoint_Pad_D1.0mm_DenseRevA_TP8
TP9: ESIM_IO; TestPoint_Pad_D1.0mm
U7: TPD4E1U06DBVR; SOT-23-6; MPN TPD4E1U06DBVR
U8: ST4SIM-300M SGP.32 experimental population; ST_ST4SI3M004600HFW_MFF2_ETSI; MPN ST4SI3M004600HFW
U9: USBLC6-2P6; USBLC6-2P6_ST_SOT666; MPN USBLC6-2P6; LCSC C15999
U14, U19, U20: TPD1E05U06DPYR; Texas_DPY0002A_0.6x1mm_P0.65mm; MPN TPD1E05U06DPYR
U31: TPS7A2033PDBVR; SOT-23-5; MPN TPS7A2033PDBVR
U32, U34: TMUX1511PWR; TSSOP-14_4.4x5mm_P0.65mm; MPN TMUX1511PWR
U35: TLV7011DBVR; SOT-23-5; MPN TLV7011DBVR
U36: SN74LVC1G08DBVR; SOT-23-5; MPN SN74LVC1G08DBVR

Connections:
AON_3V3: C124.1, U35.5 (VCC); also elsewhere on the board
AON_PG: U34.13 (SEL4); also elsewhere on the board
ESIM_CLK: R34.2, TP8.1 (1_1), U8.6 (CLK)
ESIM_IO: R35.2, R36.2, TP9.1 (1_1), U8.3 (I_O)
ESIM_RST: R33.2, U8.7 (RESET)
FCPO_CTRL_N: U32.12 (S4); also elsewhere on the board
GND: C36.2, C37.2, C38.2, C39.2, C118.2, C119.2, C120.2, C122.2, C123.2, C124.2, C125.2, H1.1 (1_1), H2.1 (1_1), H3.1 (1_1), H4.1 (1_1), H5.1 (1_1), J3.3, J3.5, J3.11, J3.27, J3.33, J3.39, J3.45, J3.51, J3.57, J3.71, J3.73, J3.MP, J4.5 (C5_GND), J4.SH (SHELL), J5.A1 (GND), J5.A12 (GND), J5.B1 (GND), J5.B12 (GND), J5.SH (SHIELD), R25.1, R37.2, R38.2, R39.2, R130.2, R131.2, R135.2, R136.2, SW1.2, SW2.2, TP5.1 (1_1), U7.2 (GND), U8.1 (GND), U9.2 (GND), U14.2 (GND), U19.2 (GND), U20.2 (GND), U31.2 (GND), U32.7 (GND), U34.7 (GND), U34.9 (S3), U35.2 (GND), U36.3 (GND); also elsewhere on the board
LED_WWAN_A: D7.2 (A), R28.2
M2_FCPO_N: J3.6, R25.2, U32.11 (D4)
M2_LED_N: D7.1 (K), J3.10
M2_PCIE_CLKREQ_N: J3.52, U32.6 (D2)
M2_PCIE_PERST_N: J3.50, U32.3 (D1)
M2_PCIE_WAKE_N: J3.54, U32.8 (D3)
M2_RESET_N: J3.67, SW1.1, U34.8 (D3)
M2_WDIS1_N: J3.8, R26.2
MODEM_ENABLE_MR: SW2.1; also elsewhere on the board
MODEM_IMON_TO_ISOLATOR: U34.12 (S4); also elsewhere on the board
MODEM_START_OK: R131.1, U31.3 (EN), U32.1 (SEL1), U32.4 (SEL2), U32.10 (SEL3), U32.13 (SEL4), U36.1 (A); also elsewhere on the board
MODEM_USB_ISOLATED_DN: U34.5 (S2); also elsewhere on the board
MODEM_USB_ISOLATED_DP: U34.2 (S1); also elsewhere on the board
OOB_ADC_MODEM_CURRENT: U34.11 (D4); also elsewhere on the board
OOB_MODEM_RESET: U34.10 (SEL3); also elsewhere on the board
OOB_QUAL_REF: U35.4 (IN-); also elsewhere on the board
OOB_USB_EXT_VALID: U35.1 (OUT); also elsewhere on the board
OOB_USB_SESSION_VALID: U36.2 (B); also elsewhere on the board
PCIE_CLKREQ_N: U32.5 (S2); also elsewhere on the board
PCIE_REFCLK_N: J3.53; also elsewhere on the board
PCIE_REFCLK_P: J3.55; also elsewhere on the board
PCIE_RX_N: J3.47; also elsewhere on the board
PCIE_RX_P: J3.49; also elsewhere on the board
PCIE_TX_N: J3.41; also elsewhere on the board
PCIE_TX_P: J3.43; also elsewhere on the board
PCIE_WAKE_N: U32.9 (S3); also elsewhere on the board
RC_PERST_N: R132.2, U32.2 (S1); also elsewhere on the board
SIM1_CLK: J4.3 (C3_CLK), R30.2, U7.3 (IO3)
SIM1_IO: J4.7 (C7_IO), R31.2, R32.2, U7.4 (IO4)
SIM1_RST: J4.2 (C2_RST), R29.2, U7.1 (IO1)
UIM1_CLK: J3.32, R30.1
UIM1_DATA: J3.34, R31.1
UIM1_DET: J3.66, J4.SW (DET), U7.6 (IO2)
UIM1_RST: J3.30, R29.1
UIM1_VDD: C36.1, C37.1, J3.36, J4.1 (C1_VCC), R32.1, U14.1 (IO)
UIM2_CLK: J3.44, R34.1
UIM2_DATA: J3.42, R35.1
UIM2_RST: J3.46, R33.1
UIM2_VDD: C38.1, C39.1, J3.48, R36.1, TP7.1 (1_1), U8.8 (VCC)
USB_CC1: J5.A5 (CC1), R37.1, U19.1 (IO)
USB_CC2: J5.B5 (CC2), R38.1, U20.1 (IO)
USB_DN: J3.9, U34.6 (D2)
USB_DP: J3.7, U34.3 (D1)
USB_GATE: R136.1, U34.1 (SEL1), U34.4 (SEL2), U36.4 (Y)
USB_PORT_DN: J5.A7 (D-), J5.B7 (D-), U9.3 (IO2)
USB_PORT_DP: J5.A6 (D+), J5.B6 (D+), U9.1 (IO1)
USB_PROTECT_DN: U9.4 (IO2); also elsewhere on the board
USB_PROTECT_DP: U9.6 (IO1); also elsewhere on the board
USB_VBUS_SENSE: R134.2, R135.1, U35.3 (IN+)
V3V3: C123.1, R132.1, U36.5 (VCC); also elsewhere on the board
V3V3_IO: C119.1, R26.1, R28.1, R130.1, U31.5 (OUT); also elsewhere on the board
V3V7: C118.1, C120.1, C122.1, J3.2, J3.4, J3.70, J3.72, J3.74, TP2.1 (1_1), U31.1 (IN), U32.14 (VDD), U34.14 (VDD); also elsewhere on the board
VBUS_C: C125.1, J5.A4 (VBUS), J5.A9 (VBUS), J5.B4 (VBUS), J5.B9 (VBUS), R39.1, R134.1, U9.5 (VBUS)

Notes on the sheet:
RM520N-GL primary / RM551E-GL compatible M.2 socket, SIM 1, eUICC (SIM 2), USB-C
