ripclap/rm520n-carrier/hardware/rev-a/carrier.kicad_pcb

## KiCad design hardware/rev-a/carrier.kicad_pcb (continued)

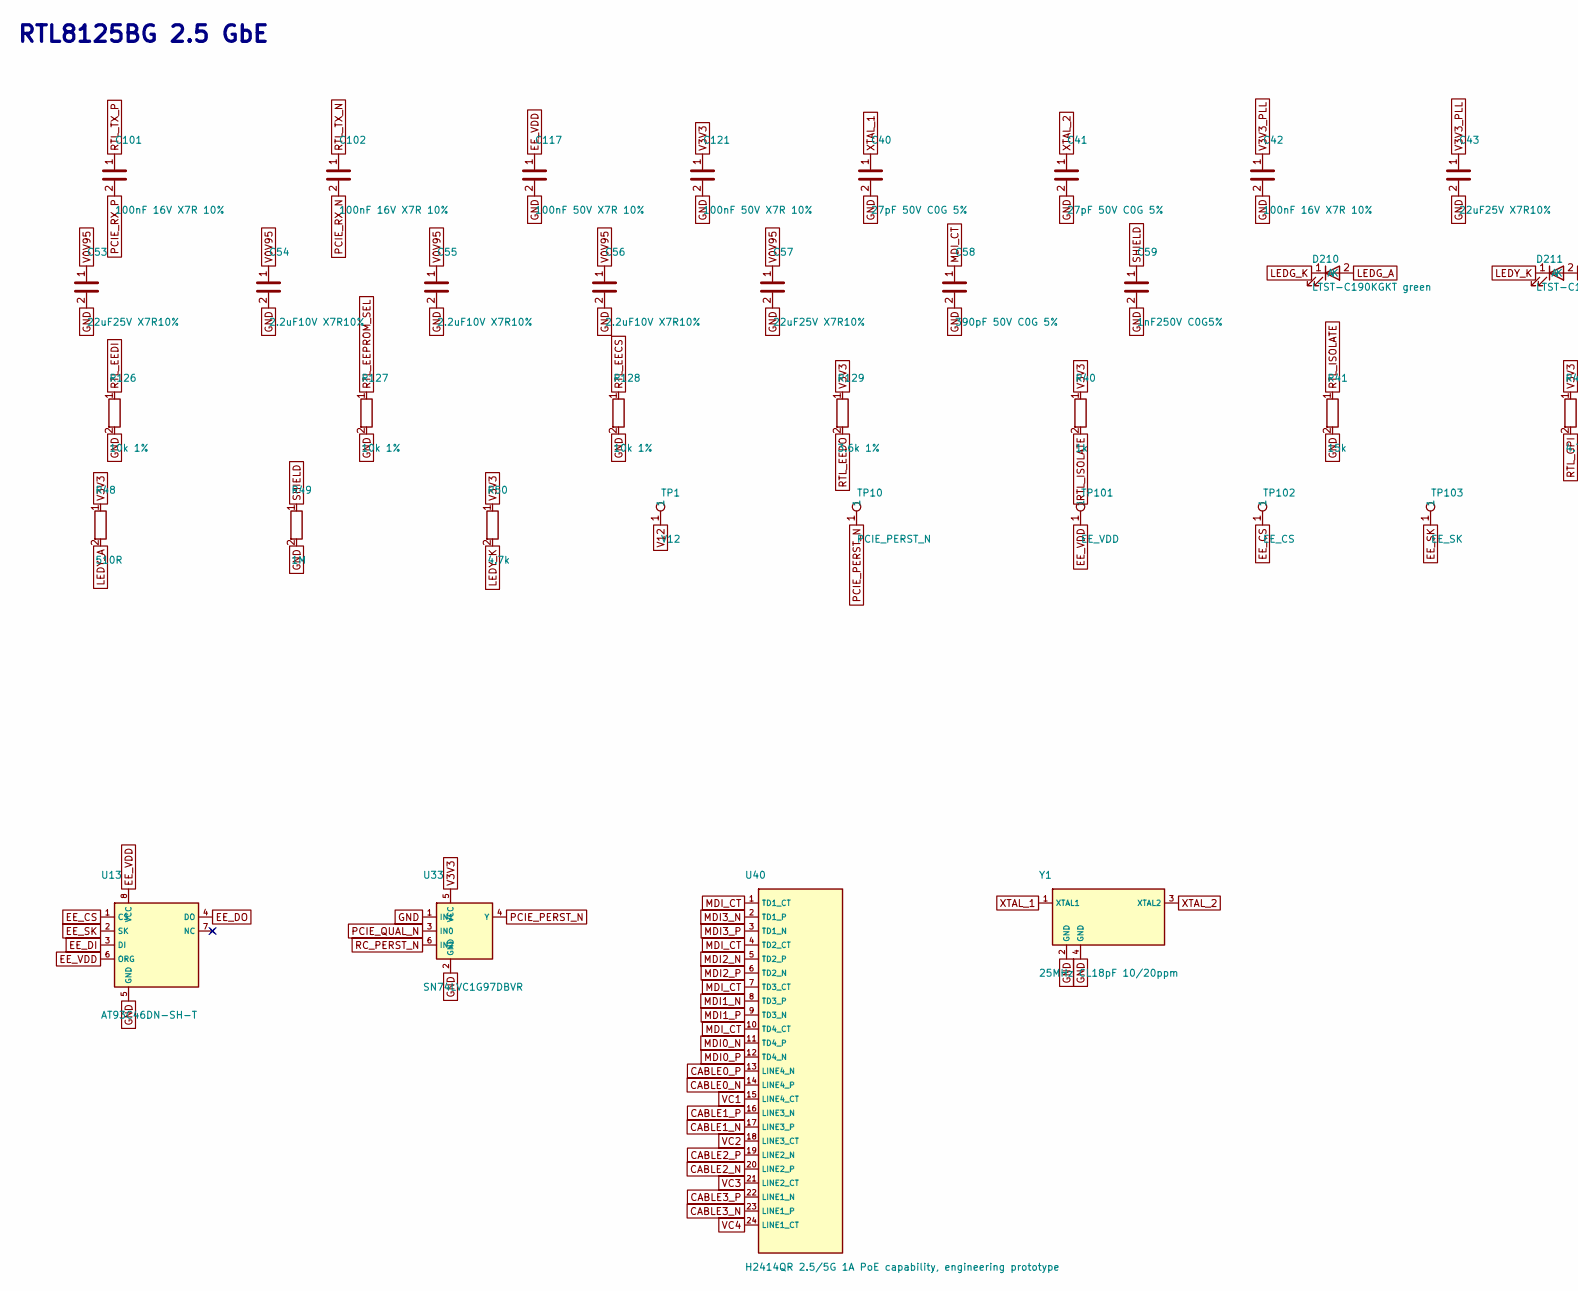
[picture p41: schematic ethernet.kicad_sch, RTL8125BG 2.5 GbE, part in row 1, column 1]

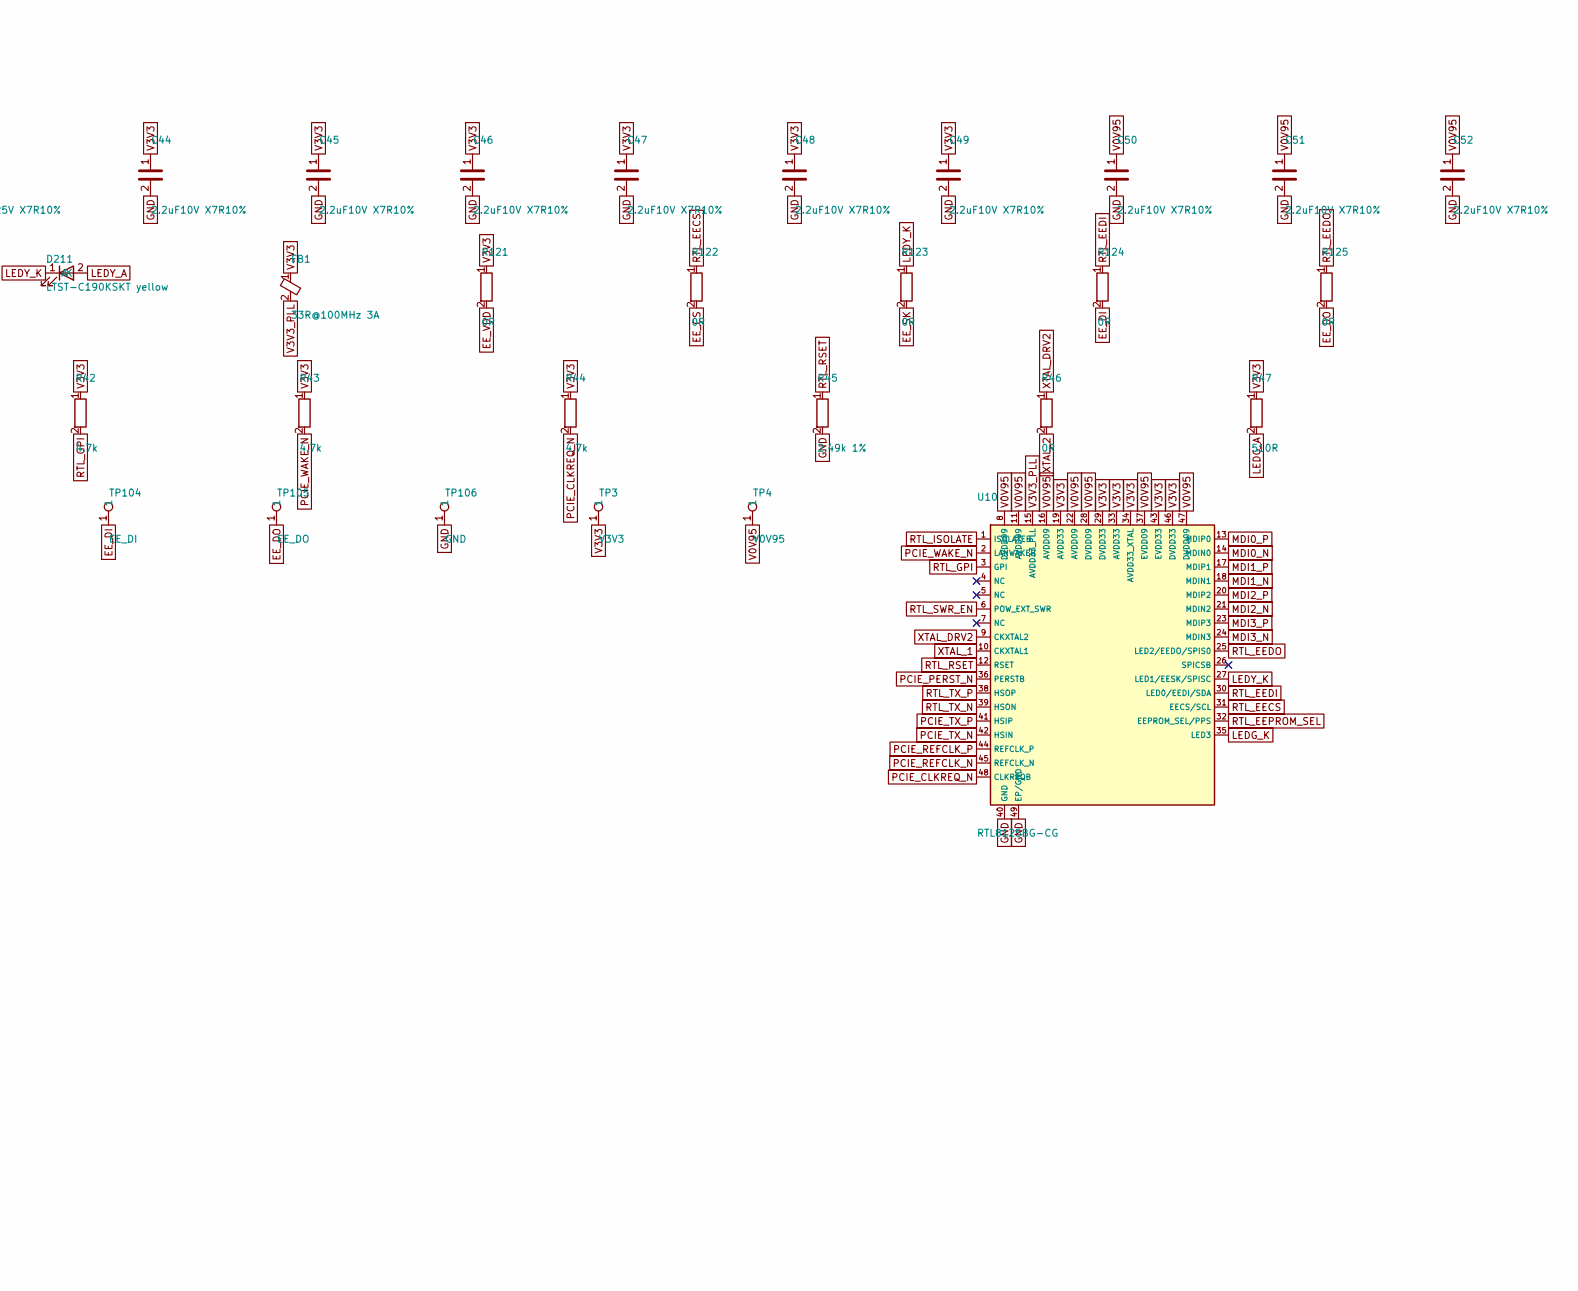
[picture p42: schematic ethernet.kicad_sch, RTL8125BG 2.5 GbE, part in row 1, column 2]

Parts:
C40, C41: 27pF 50V C0G 5%; C_0402_1005Metric; MPN GRM1555C1H270JA01D
C42, C101, C102: 100nF 16V X7R 10%; C_0402_1005Metric; MPN GRM155R71C104KA88D
C43, C53, C57: 22uF25V X7R10%; C_1210_3225Metric; MPN CL32B226KAJNNNE; LCSC C309062
C44, C45, C46, C47, C49, C50, C51, C52, C54, C56: 2.2uF10V X7R10%; C_0603_1608Metric; MPN CL10B225KP8NNNC; LCSC C100082
C48, C55: 2.2uF10V X7R10%; Samsung_CL10_0603_Dense100_50_890; MPN CL10B225KP8NNNC; LCSC C100082
C58: 390pF 50V C0G 5%; C_0402_1005Metric; MPN C0402C391J5GACTU
C59: 1nF250V C0G5%; C_0805_2012Metric; MPN C0805C102JAGACTU
C117, C121: 100nF 50V X7R 10%; C_0402_1005Metric; MPN CL05B104KB5NNNC; LCSC C960916
D210: LTST-C190KGKT green; LED_0603_1608Metric; MPN LTST-C190KGKT
D211: LTST-C190KSKT yellow; LED_0603_1608Metric; MPN LTST-C190KSKT
FB1: 33R@100MHz 3A; L_0603_1608Metric; MPN BLM18PG330SN1D
R40: 1k; R_0402_1005Metric; MPN CRCW04021K00FKED
R41: 15k; R_0402_1005Metric; MPN CRCW040215K0FKED
R42, R43, R44, R50: 4.7k; R_0402_1005Metric; MPN CRCW04024K70FKED
R45: 2.49k 1%; R_0402_1005Metric; MPN CRCW04022K49FKED
R46, R121, R122, R123, R124, R125: 0R; R_0402_1005Metric; MPN CRCW04020000Z0ED
R47, R48: 510R; R_0402_1005Metric; MPN CRCW0402510RFKED
R49: 1M; R_1206_3216Metric; MPN RC1206FR-071ML; LCSC C108083
R126, R127, R128: 10k 1%; R_0402_1005Metric; MPN CRCW040210K0FKED
R129: 3.6k 1%; R_0402_1005Metric; MPN RC0402FR-073K6L; LCSC C137990
TP1: V12; TestPoint_Pad_D1.0mm
TP3: V3V3; TestPoint_Pad_D1.0mm
TP4: V0V95; TestPoint_Pad_D1.0mm
TP10: PCIE_PERST_N; TestPoint_Pad_D1.0mm
TP101: EE_VDD; TestPoint_Pad_D1.0mm
TP102: EE_CS; TestPoint_Pad_D1.0mm
TP103: EE_SK; TestPoint_Pad_D1.0mm
TP104: EE_DI; TestPoint_Pad_D1.0mm
TP105: EE_DO; TestPoint_Pad_D1.0mm
TP106: GND; TestPoint_Pad_D1.0mm
U10: RTL8125BG-CG; TQFN-48_L6.0-W6.0-P0.40-BL-EP4.5_RevA_EP625_890_Heatsink1090; MPN RTL8125BG-CG; LCSC C3013605
U13: AT93C46DN-SH-T; SOIC-8_3.9x4.9mm_P1.27mm; MPN AT93C46DN-SH-T
U33: SN74LVC1G97DBVR; SOT-23-6; MPN SN74LVC1G97DBVR
U40: H2414QR 2.5/5G 1A PoE capability, engineering pro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; ENETTR_H2414QR_24_SMD_Manufacturer; MPN H2414QR; LCSC C4155001
Y1: 25MHz CL18pF 10/20ppm; Crystal_ABM8_Abracon_3.2x2.5; MPN ABM8-25.000MHZ-D1X-T

Connections:
CABLE0_N: U40.14 (LINE4_P); also elsewhere on the board
CABLE0_P: U40.13 (LINE4_N); also elsewhere on the board
CABLE1_N: U40.17 (LINE3_P); also elsewhere on the board
CABLE1_P: U40.16 (LINE3_N); also elsewhere on the board
CABLE2_N: U40.20 (LINE2_P); also elsewhere on the board
CABLE2_P: U40.19 (LINE2_N); also elsewhere on the board
CABLE3_N: U40.23 (LINE1_P); also elsewhere on the board
CABLE3_P: U40.22 (LINE1_N); also elsewhere on the board
EE_CS: R122.2, TP102.1 (1_1), U13.1 (CS)
EE_DI: R124.2, TP104.1 (1_1), U13.3 (DI)
EE_DO: R125.2, TP105.1 (1_1), U13.4 (DO)
EE_SK: R123.2, TP103.1 (1_1), U13.2 (SK)
EE_VDD: C117.1, R121.2, TP101.1 (1_1), U13.6 (ORG), U13.8 (VCC)
GND: C40.2, C41.2, C42.2, C43.2, C44.2, C45.2, C46.2, C47.2, C48.2, C49.2, C50.2, C51.2, C52.2, C53.2, C54.2, C55.2, C56.2, C57.2, C58.2, C59.2, C117.2, C121.2, R41.2, R45.2, R49.2, R126.2, R127.2, R128.2, TP106.1 (1_1), U10.40 (GND), U10.49 (EP/GND), U13.5 (GND), U33.1 (IN1), U33.2 (GND), Y1.2 (GND), Y1.4 (GND); also elsewhere on the board
LEDG_A: D210.2 (A), R47.2
LEDG_K: D210.1 (K), U10.35 (LED3)
LEDY_A: D211.2 (A), R48.2
LEDY_K: D211.1 (K), R50.2, R123.1, U10.27 (LED1/EESK/SPISC)
MDI0_N: U10.14 (MDIN0), U40.11 (TD4_P)
MDI0_P: U10.13 (MDIP0), U40.12 (TD4_N)
MDI1_N: U10.18 (MDIN1), U40.8 (TD3_P)
MDI1_P: U10.17 (MDIP1), U40.9 (TD3_N)
MDI2_N: U10.21 (MDIN2), U40.5 (TD2_P)
MDI2_P: U10.20 (MDIP2), U40.6 (TD2_N)
MDI3_N: U10.24 (MDIN3), U40.2 (TD1_P)
MDI3_P: U10.23 (MDIP3), U40.3 (TD1_N)
MDI_CT: C58.1, U40.1 (TD1_CT), U40.4 (TD2_CT), U40.7 (TD3_CT), U40.10 (TD4_CT)
PCIE_CLKREQ_N: R44.2, U10.48 (CLKREQB); also elsewhere on the board
PCIE_PERST_N: TP10.1 (1_1), U10.36 (PERSTB), U33.4 (Y)
PCIE_QUAL_N: U33.3 (IN0); also elsewhere on the board
PCIE_REFCLK_N: U10.45 (REFCLK_N); also elsewhere on the board
PCIE_REFCLK_P: U10.44 (REFCLK_P); also elsewhere on the board
PCIE_RX_N: C102.2; also elsewhere on the board
PCIE_RX_P: C101.2; also elsewhere on the board
PCIE_TX_N: U10.42 (HSIN); also elsewhere on the board
PCIE_TX_P: U10.41 (HSIP); also elsewhere on the board
PCIE_WAKE_N: R43.2, U10.2 (LANWAKEB); also elsewhere on the board
RC_PERST_N: U33.6 (IN2); also elsewhere on the board
RTL_EECS: R122.1, R128.1, U10.31 (EECS/SCL)
RTL_EEDI: R124.1, R126.1, U10.30 (LED0/EEDI/SDA)
RTL_EEDO: R125.1, R129.2, U10.25 (LED2/EEDO/SPIS0)
RTL_EEPROM_SEL: R127.1, U10.32 (EEPROM_SEL/PPS)
RTL_GPI: R42.2, U10.3 (GPI)
RTL_ISOLATE: R40.2, R41.1, U10.1 (ISOLATEB)
RTL_RSET: R45.1, U10.12 (RSET)
RTL_SWR_EN: U10.6 (POW_EXT_SWR); also elsewhere on the board
RTL_TX_N: C102.1, U10.39 (HSON)
RTL_TX_P: C101.1, U10.38 (HSOP)
SHIELD: C59.1, R49.1; also elsewhere on the board
V0V95: C50.1, C51.1, C52.1, C53.1, C54.1, C55.1, C56.1, C57.1, TP4.1 (1_1), U10.8 (DVDD09), U10.11 (AVDD09), U10.16 (AVDD09), U10.22 (AVDD09), U10.28 (DVDD09), U10.37 (EVDD09), U10.47 (DVDD09); also elsewhere on the board
V3V3: C44.1, C45.1, C46.1, C47.1, C48.1, C49.1, C121.1, FB1.1, R40.1, R42.1, R43.1, R44.1, R47.1, R48.1, R50.1, R121.1, R129.1, TP3.1 (1_1), U10.19 (AVDD33), U10.29 (DVDD33), U10.33 (AVDD33), U10.34 (AVDD33_XTAL), U10.43 (EVDD33), U10.46 (DVDD33), U33.5 (VCC); also elsewhere on the board
V3V3_PLL: C42.1, C43.1, FB1.2, U10.15 (AVDD33_PLL)
V12: TP1.1 (1_1); also elsewhere on the board
VC1: U40.15 (LINE4_CT); also elsewhere on the board
VC2: U40.18 (LINE3_CT); also elsewhere on the board
VC3: U40.21 (LINE2_CT); also elsewhere on the board
VC4: U40.24 (LINE1_CT); also elsewhere on the board
XTAL_1: C40.1, U10.10 (CKXTAL1), Y1.1 (XTAL1)
XTAL_2: C41.1, R46.2, Y1.3 (XTAL2)
XTAL_DRV2: R46.1, U10.9 (CKXTAL2)

Notes on the sheet:
RTL8125BG 2.5 GbE

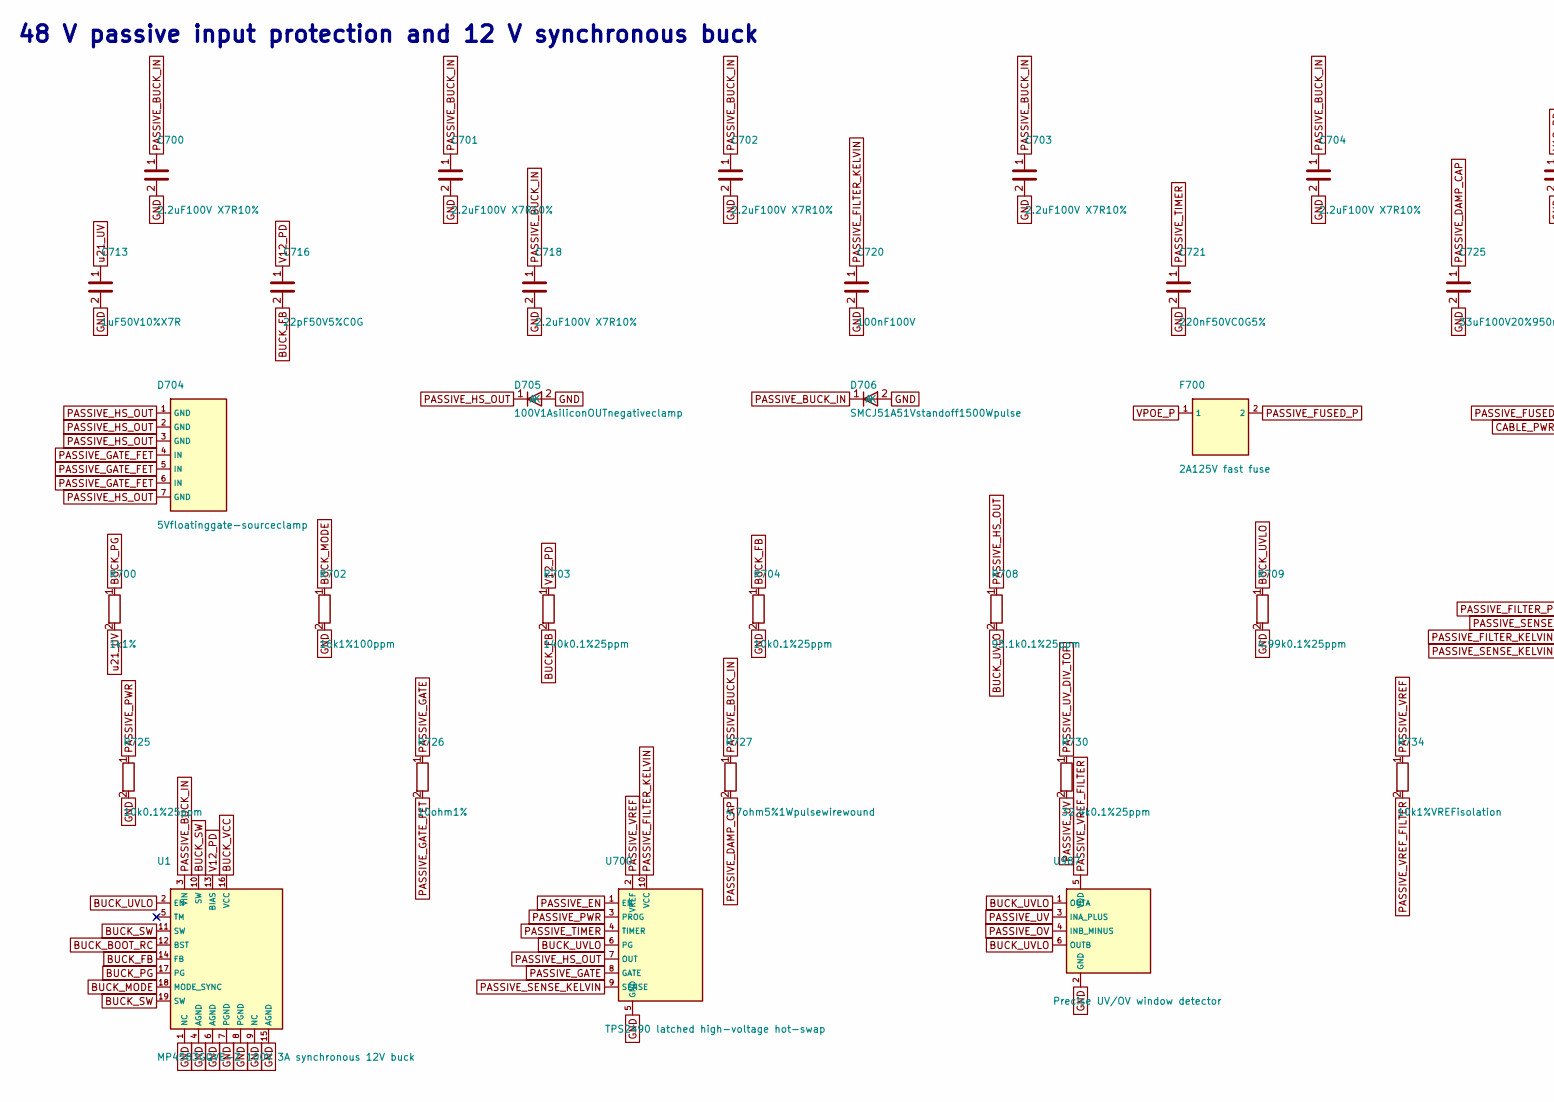
[picture p43: schematic class6-converter.kicad_sch, 48 V passive input protection and 12 V synchronous buck, part in row 1, column 1]

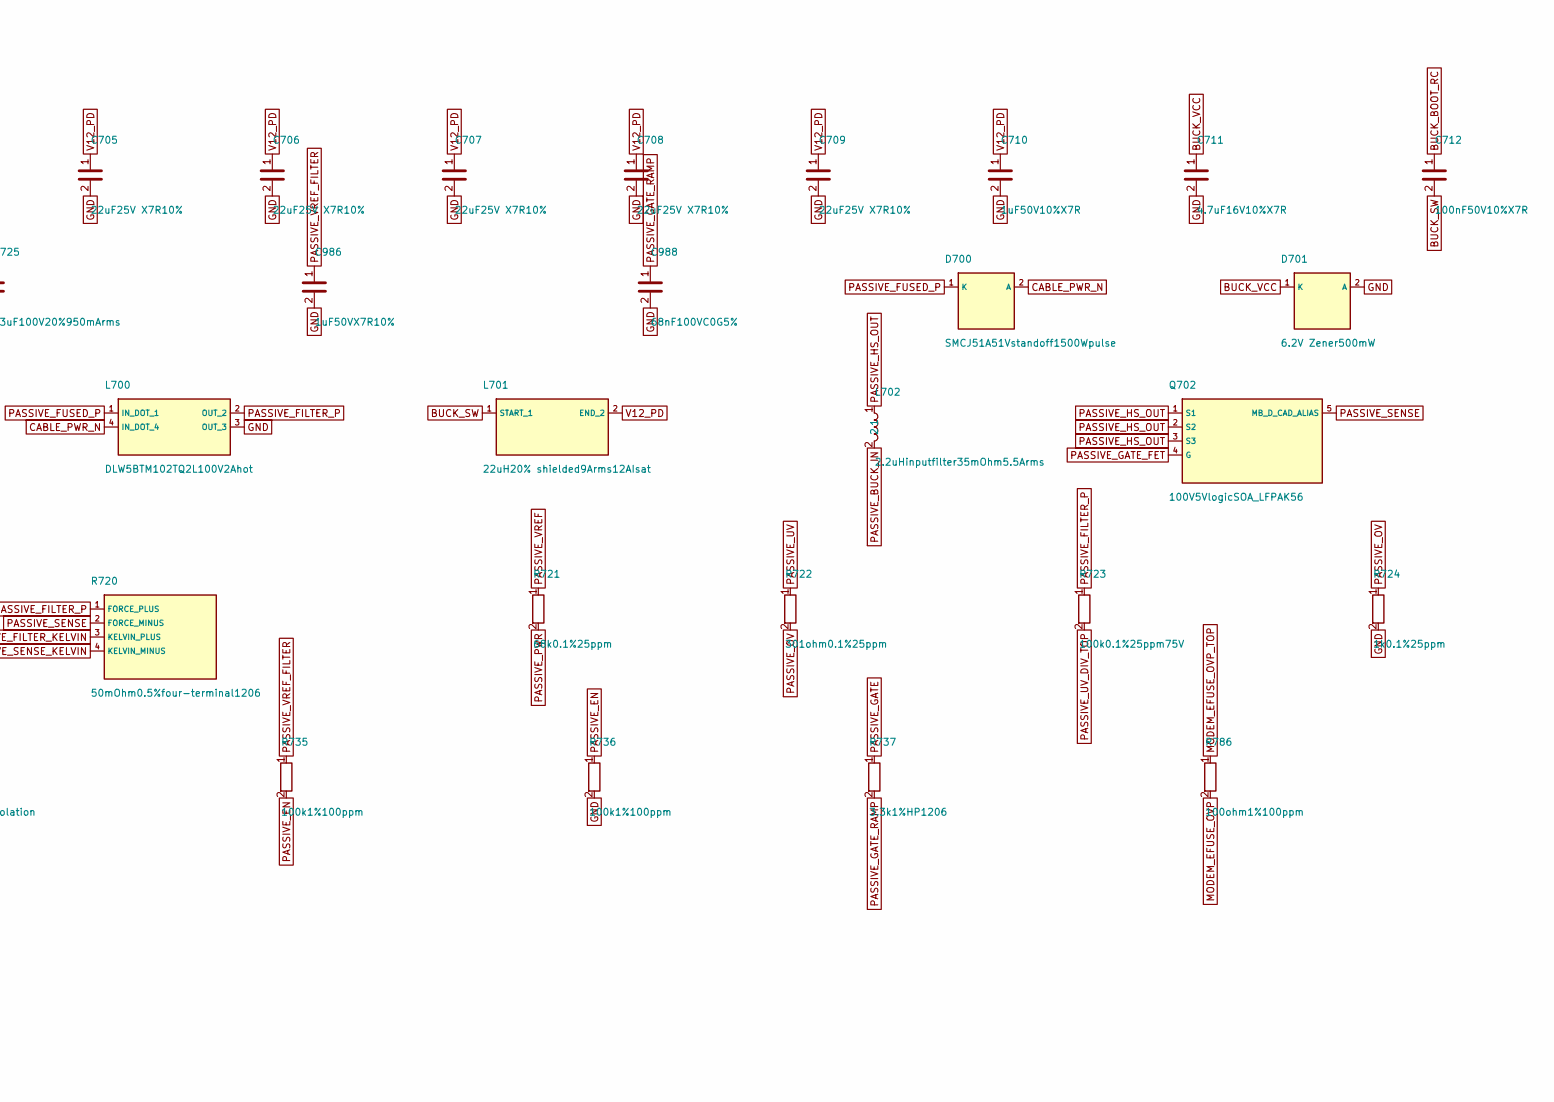
[picture p44: schematic class6-converter.kicad_sch, 48 V passive input protection and 12 V synchronous buck, part in row 1, column 2]

Parts:
C700, C701, C702, C703, C704, C718: 2.2uF100V X7R10%; C_1210_3225Metric; MPN CGA6N3X7R2A225K230AB
C705, C706, C707, C708, C709: 22uF25V X7R10%; C_1210_3225Metric; MPN CL32B226KAJNNNE; LCSC C309062
C710, C713: 1uF50V10%X7R; C_0805_2012Metric; MPN CL21B105KBFNNNF
C711: 4.7uF16V10%X7R; C_0805_2012Metric; MPN C0805C475K4RACTU
C712: 100nF50V10%X7R; C_0402_1005Metric; MPN CL05B104KB5NNNC
C716: 22pF50V5%C0G; C_0402_1005Metric; MPN C0402C220J5GACTU
C720: 100nF100V; C_0603_1608Metric; MPN GRM188R72A104KA35D
C721: 220nF50VC0G5%; C1206; MPN GRM31C5C1H224JE02L
C725: 33uF100V20%950mArms; Nichicon_UHW2A330MPD_Radial_D8_P3.5; MPN UHW2A330MPD
C986: 1uF50VX7R10%; C_0805_2012Metric; MPN CL21B105KBFNNNF; LCSC C16195091
C988: 68nF100VC0G5%; C1206; MPN GRM31C5C2A683JA01L
D700, D706: SMCJ51A51Vstandoff1500Wpulse; D_SMC; MPN SMCJ51A-E3/57T
D701: 6.2V Zener500mW; D_SOD-123; MPN BZT52C6V2-7-F
D704: 5Vfloatinggate-sourceclamp; TI_DRV0006A_TVS0500_PRIMARY; MPN TVS0500DRVR
D705: 100V1AsiliconOUTnegativeclamp; Diodes_S1B_SMA_PRIMARY; MPN S1B-13-F
F700: 2A125V fast fuse; Littelfuse_451_6.1x2.69; MPN 0451002.MRL
L700: DLW5BTM102TQ2L100V2Ahot; Murata_DLW5BTM102TQ2L_4_SMD; MPN DLW5BTM102TQ2L
L701: 22uH20% shielded9Arms12AIsat; BOURNS_SRP1265A_LEAD_FRAME; MPN SRP1265A-220M
L702: 2.2uHinputfilter35mOhm5.5Arms; L_Bourns_SRP5030T; MPN SRP5030TA-2R2M
Q702: 100V5VlogicSOA_LFPAK56; NEXPERIA_LFPAK56_PRIMARY_AUDITED; MPN PSMN015-100YLX
R700: 1k1%; R_0603_1608Metric; MPN RC0603FR-071KL
R702: 16k1%100ppm; R_0603_1608Metric; MPN RC0603FR-0716KL
R703: 140k0.1%25ppm; R_0603_1608Metric; MPN RT0603BRD07140KL
R704, R725: 10k0.1%25ppm; R_0603_1608Metric; MPN RT0603BRD0710KL
R708: 93.1k0.1%25ppm; R_0603_1608Metric; MPN RT0603BRD0793K1L
R709: 4.99k0.1%25ppm; R_0603_1608Metric; MPN RT0603BRD074K99L
R720: 50mOhm0.5%four-terminal1206; Littelfuse_L4CL1206_A_PRIMARY; MPN L4CL1206LR050DNR-A
R721: 68k0.1%25ppm; R_0603_1608Metric; MPN RT0603BRD0768KL
R722: 301ohm0.1%25ppm; R_0402_1005Metric; MPN RT0402BRD07301RL
R723: 100k0.1%25ppm75V; R_0603_1608Metric; MPN TNPW0603100KBEEA
R724: 1k0.1%25ppm; R_0402_1005Metric; MPN RT0402BRD071KL
R726: 10ohm1%; R_0603_1608Metric; MPN RC0603FR-0710RL
R727: 4.7ohm5%1Wpulsewirewound; Vishay_AC01_P17_8_PRIMARY; MPN AC01000004708JA100
R730: 32.4k0.1%25ppm; R_0603_1608Metric; MPN RT0603BRD0732K4L
R734: 10k1%VREFisolation; R_0603_1608Metric; MPN RC0603FR-0710KL
R735, R736: 100k1%100ppm; R_0402_1005Metric; MPN CRCW0402100KFKED
R737: 3.3k1%HP1206; R1206; MPN CRCW12063K30FKEAHP
R786: 100ohm1%100ppm; RevA_Dense100_50_R786; MPN CRCW0402100RFKED
U1: MP4583GQVE-Z 100V 3A synchronous 12V buck; MPS_MP4583_QFN19_3x5_PRIMARY; MPN MP4583GQVE-Z
U700: TPS2490 latched high-voltage hot-swap; TI_DGS0010A_TPS2490_PRIMARY; MPN TPS2490DGSR
U987: Precise UV/OV window detector; TI_DDC0006A_PRIMARY; MPN TPS3700DDCR; LCSC C33002

Connections:
BUCK_BOOT_RC: C712.1, U1.12 (BST)
BUCK_FB: C716.2, R703.2, R704.1, U1.14 (FB)
BUCK_MODE: R702.1, U1.18 (MODE_SYNC)
BUCK_PG: R700.1, U1.17 (PG)
BUCK_SW: C712.2, L701.1 (START_1), U1.10 (SW), U1.11 (SW), U1.19 (SW)
BUCK_UVLO: R708.2, R709.1, U1.2 (EN), U700.6 (PG), U987.1 (OUTA), U987.6 (OUTB)
BUCK_VCC: C711.1, D701.1 (K), U1.16 (VCC)
CABLE_PWR_N: D700.2 (A), L700.4 (IN_DOT_4); also elsewhere on the board
GND: C700.2, C701.2, C702.2, C703.2, C704.2, C705.2, C706.2, C707.2, C708.2, C709.2, C710.2, C711.2, C713.2, C718.2, C720.2, C721.2, C725.2, C986.2, C988.2, D701.2 (A), D705.2 (A), D706.2 (A), L700.3 (OUT_3), R702.2, R704.2, R709.2, R724.2, R725.2, R736.2, U1.1 (NC), U1.4 (AGND), U1.6 (AGND), U1.7 (PGND), U1.8 (PGND), U1.9 (NC), U1.15 (AGND), U700.5 (GND), U987.2 (GND); also elsewhere on the board
MODEM_EFUSE_OVP: R786.2; also elsewhere on the board
MODEM_EFUSE_OVP_TOP: R786.1; also elsewhere on the board
PASSIVE_BUCK_IN: C700.1, C701.1, C702.1, C703.1, C704.1, C718.1, D706.1 (K), L702.2, R727.1, U1.3 (VIN)
PASSIVE_DAMP_CAP: C725.1, R727.2
PASSIVE_EN: R735.2, R736.1, U700.1 (EN)
PASSIVE_FILTER_KELVIN: C720.1, R720.3 (KELVIN_PLUS), U700.10 (VCC)
PASSIVE_FILTER_P: L700.2 (OUT_2), R720.1 (FORCE_PLUS), R723.1
PASSIVE_FUSED_P: D700.1 (K), F700.2, L700.1 (IN_DOT_1)
PASSIVE_GATE: R726.1, R737.1, U700.8 (GATE)
PASSIVE_GATE_FET: D704.4 (IN), D704.5 (IN), D704.6 (IN), Q702.4 (G), R726.2
PASSIVE_GATE_RAMP: C988.1, R737.2
PASSIVE_HS_OUT: D704.1 (GND), D704.2 (GND), D704.3 (GND), D704.7 (GND), D705.1 (K), L702.1, Q702.1 (S1), Q702.2 (S2), Q702.3 (S3), R708.1, U700.7 (OUT)
PASSIVE_OV: R722.2, R724.1, U987.4 (INB_MINUS)
PASSIVE_PWR: R721.2, R725.1, U700.3 (PROG)
PASSIVE_SENSE: Q702.5 (MB_D_CAD_ALIAS), R720.2 (FORCE_MINUS)
PASSIVE_SENSE_KELVIN: R720.4 (KELVIN_MINUS), U700.9 (SENSE)
PASSIVE_TIMER: C721.1, U700.4 (TIMER)
PASSIVE_UV: R722.1, R730.2, U987.3 (INA_PLUS)
PASSIVE_UV_DIV_TOP: R723.2, R730.1
PASSIVE_VREF: R721.1, R734.1, U700.2 (VREF)
PASSIVE_VREF_FILTER: C986.1, R734.2, R735.1, U987.5 (VDD)
V12_PD: C705.1, C706.1, C707.1, C708.1, C709.1, C710.1, C716.1, L701.2 (END_2), R703.1, U1.13 (BIAS); also elsewhere on the board
VPOE_P: F700.1; also elsewhere on the board
u21_UV: C713.1, R700.2; also elsewhere on the board

Notes on the sheet:
48 V passive input protection and 12 V synchronous buck

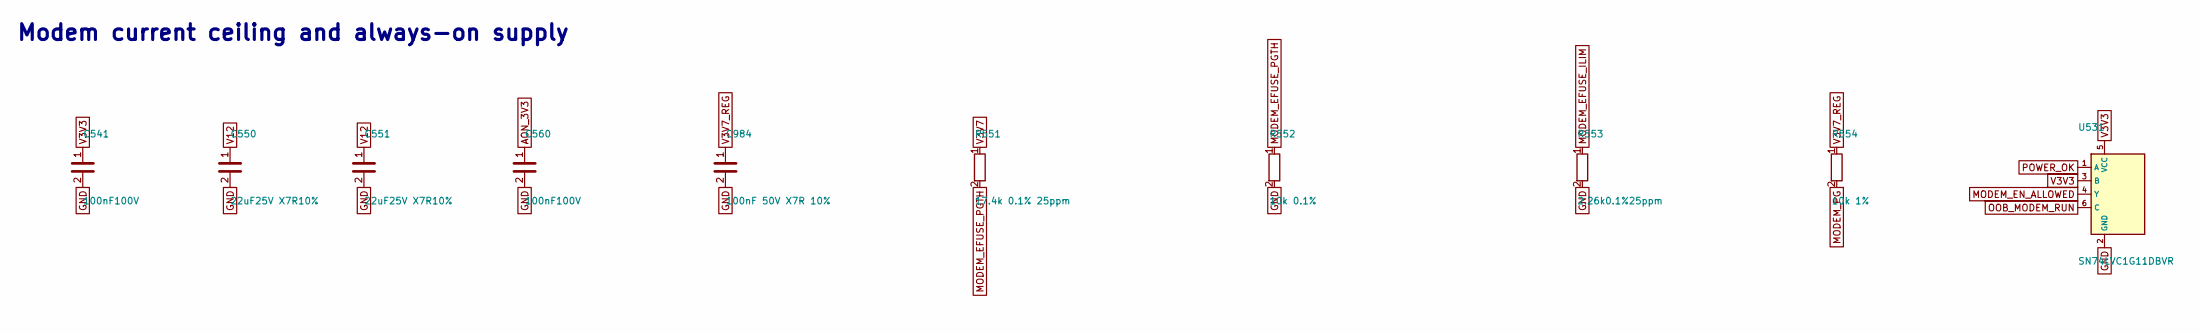
[picture p45: schematic class6-grants.kicad_sch, Modem current ceiling and always-on supply]

Parts:
C541, C560: 100nF100V; C_0603_1608Metric; MPN GRM188R72A104KA35D
C550, C551: 22uF25V X7R10%; C_1210_3225Metric; MPN CL32B226KAJNNNE; LCSC C309062
C984: 100nF 50V X7R 10%; C_0402_1005Metric; MPN CL05B104KB5NNNC; LCSC C960916
R551: 17.4k 0.1% 25ppm; R_0402_1005Metric; MPN RT0402BRD0717K4L
R552: 10k 0.1%; R_0402_1005Metric; MPN TNPW040210K0BEED
R553: 2.26k0.1%25ppm; R_0603_1608Metric; MPN RT0603BRD072K26L
R554: 10k 1%; R_0603_1608Metric; MPN RC0603FR-0710KL
U531: SN74LVC1G11DBVR; SOT-23-6; MPN SN74LVC1G11DBVR

Connections:
AON_3V3: C560.1; also elsewhere on the board
GND: C541.2, C550.2, C551.2, C560.2, C984.2, R552.2, R553.2, U531.2 (GND); also elsewhere on the board
MODEM_EFUSE_ILIM: R553.1; also elsewhere on the board
MODEM_EFUSE_PGTH: R551.2, R552.1; also elsewhere on the board
MODEM_EN_ALLOWED: U531.4 (Y); also elsewhere on the board
MODEM_PG: R554.2; also elsewhere on the board
OOB_MODEM_RUN: U531.6 (C); also elsewhere on the board
POWER_OK: U531.1 (A); also elsewhere on the board
V3V3: C541.1, U531.3 (B), U531.5 (VCC); also elsewhere on the board
V3V7: R551.1; also elsewhere on the board
V3V7_REG: C984.1, R554.1; also elsewhere on the board
V12: C550.1, C551.1; also elsewhere on the board

Notes on the sheet:
Modem current ceiling and always-on supply
