ripclap/rm520n-carrier/hardware/rev-a/carrier.kicad_pcb

## KiCad design hardware/rev-a/carrier.kicad_pcb (continued)

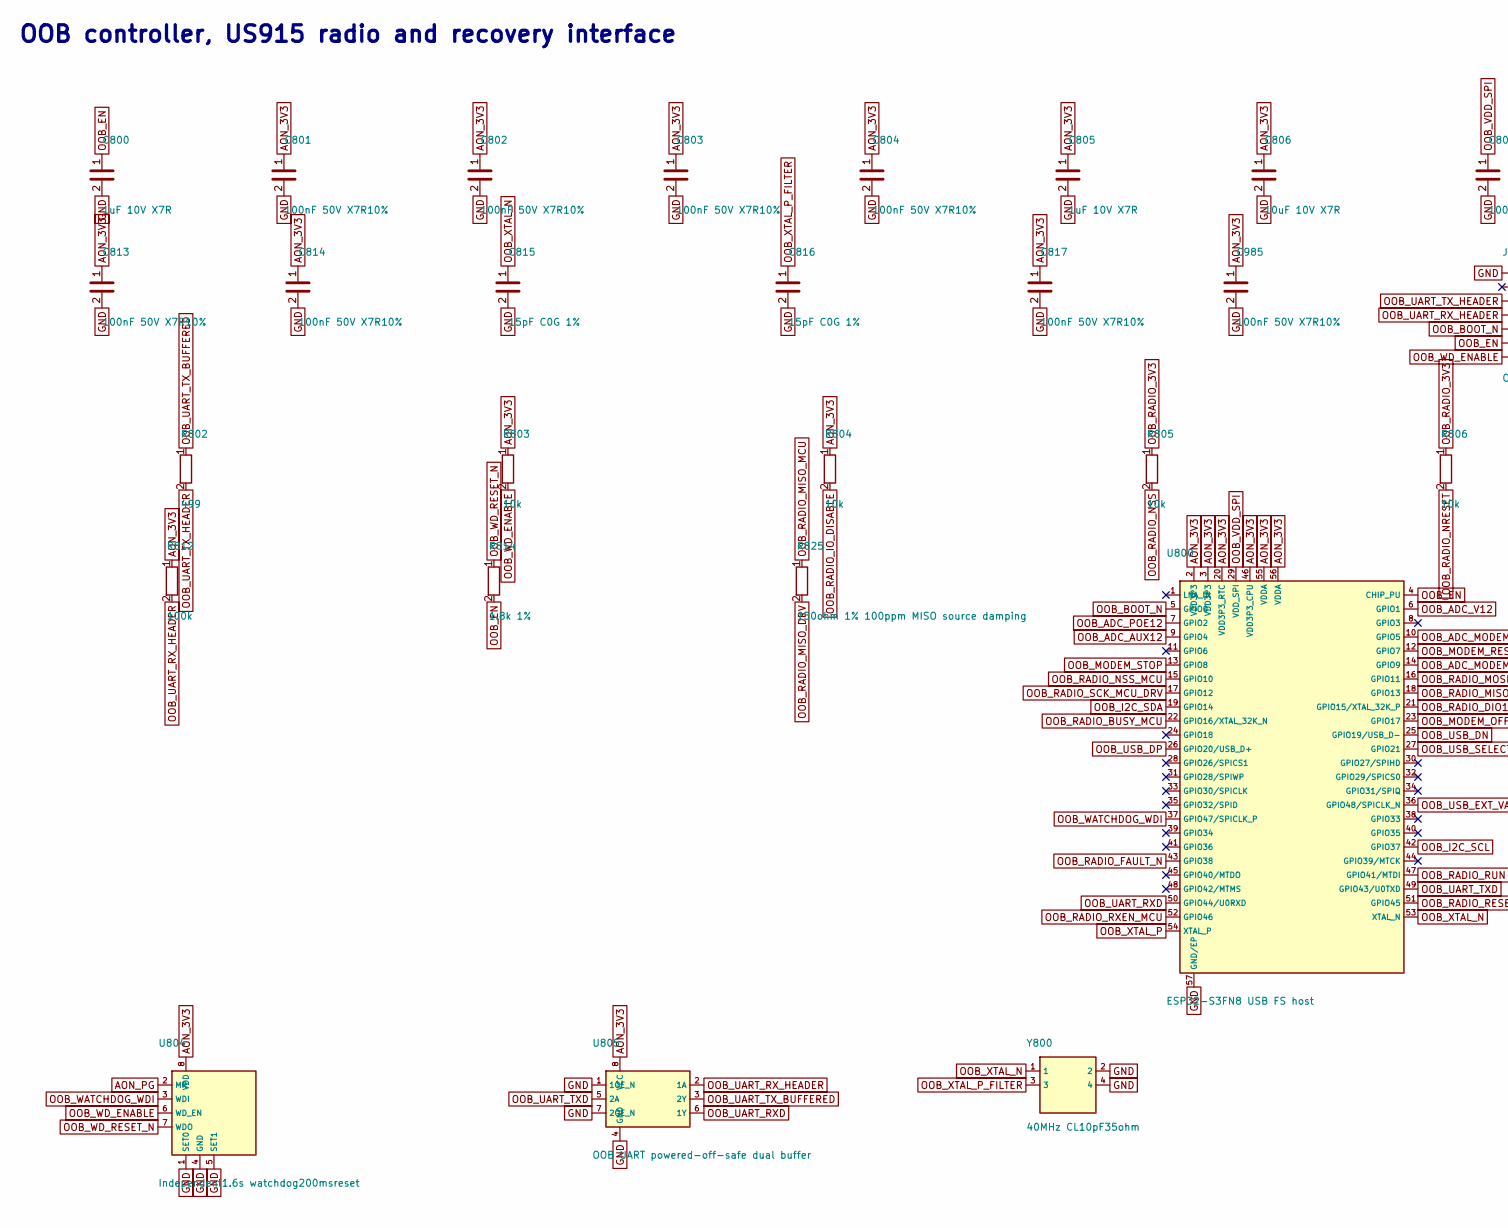
[picture p46: schematic oob-controller-radio.kicad_sch, OOB controller, US915 radio and recovery interface, part in row 1, column 1]

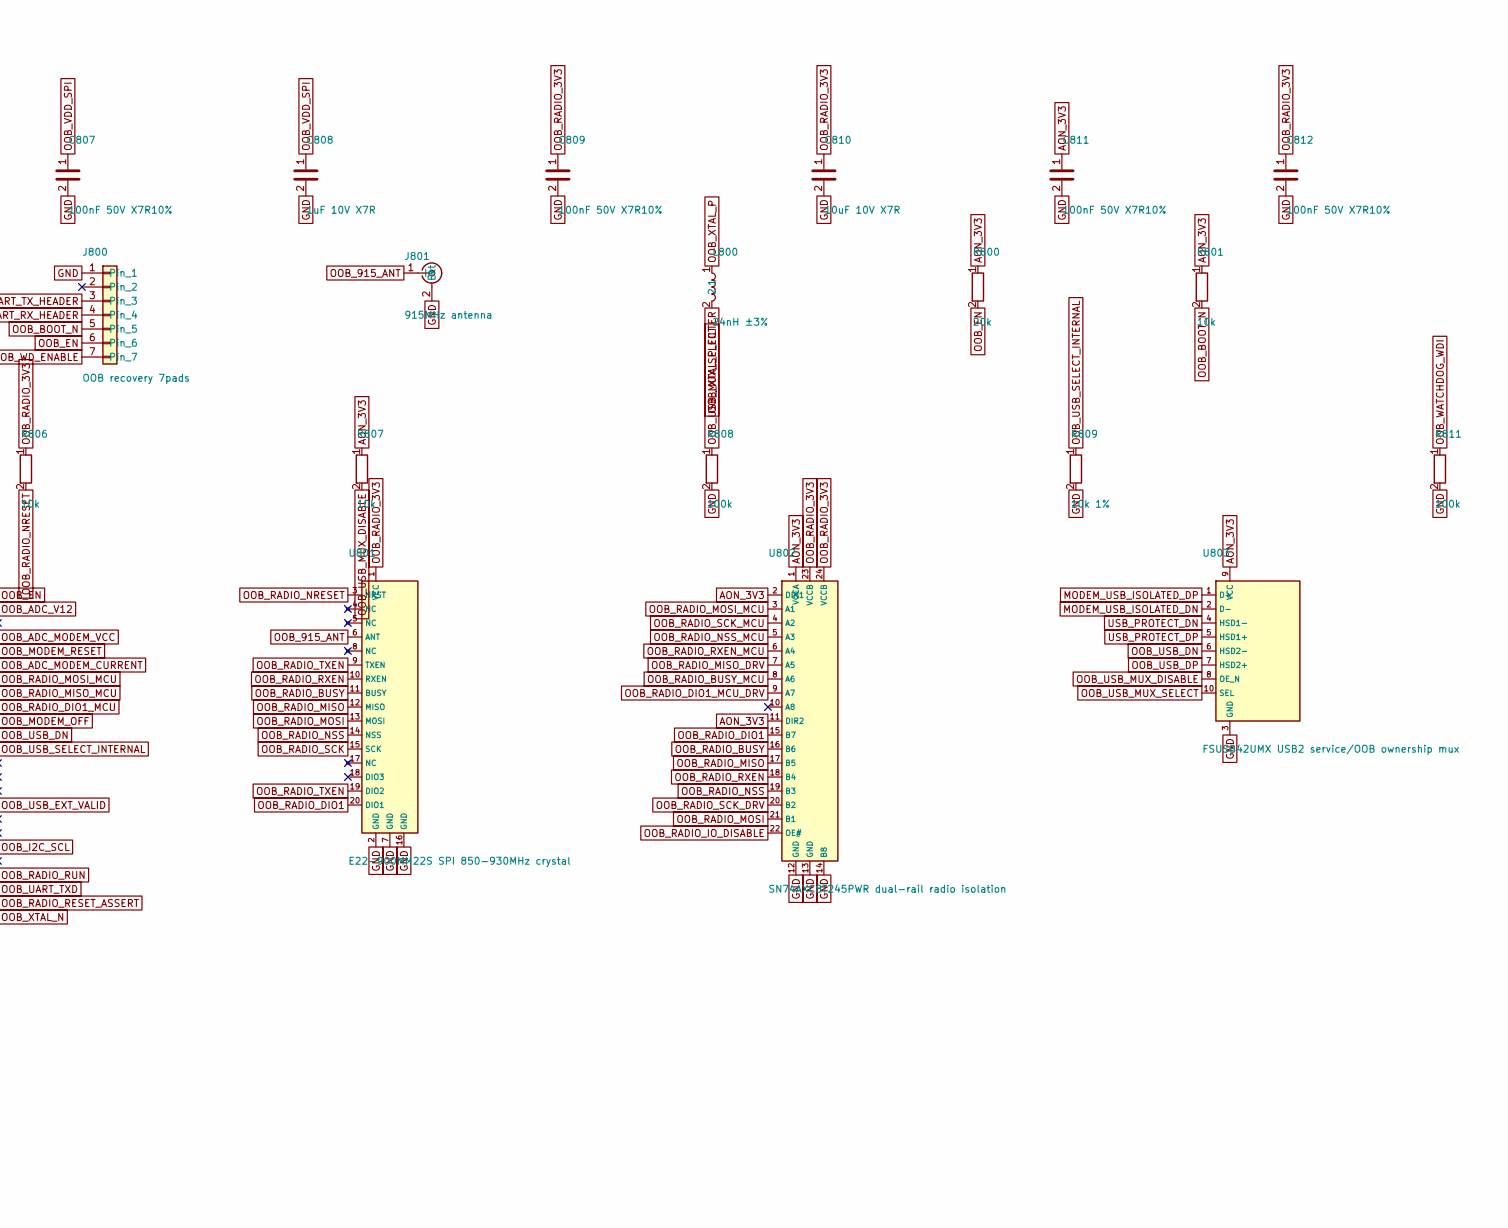
[picture p47: schematic oob-controller-radio.kicad_sch, OOB controller, US915 radio and recovery interface, part in row 1, column 2]

Parts:
C800, C805, C808: 1uF 10V X7R; C_0603_1608Metric; MPN 885012206026
C801, C802, C803, C804, C807, C811, C812, C813, C814, C817, C985: 100nF 50V X7R10%; C_0402_1005Metric; MPN CL05B104KB5NNNC; LCSC C960916
C806, C810: 10uF 10V X7R; C_0805_2012Metric; MPN 885012207026
C809: 100nF 50V X7R10%; C_0402_1005Metric_DenseRevA_C809; MPN CL05B104KB5NNNC; LCSC C960916
C815, C816: 15pF C0G 1%; C_0402_1005Metric; MPN KGM05ACG1H150FH
J800: OOB recovery 7pads; OOB_SERVICE_7PAD; MPN PCB service pads
J801: 915MHz antenna; UFL_HIROSE_DenseRevA_J801; MPN U.FL-R-SMT-1(80)
L800: 24nH ±3%; Murata_LQW15AN_0402_Manufacturer_DenseRevA_L800; MPN LQW15AN24NH00D
R800: 20k; R_0402_1005Metric; MPN CRCW040220K0FKED
R801, R803, R804, R805, R806, R807: 10k; R_0402_1005Metric; MPN CRCW040210K0FKED
R802: 499; R_0402_1005Metric; MPN CRCW0402499RFKED
R808, R811, R812: 100k; R_0402_1005Metric; MPN CRCW0402100KFKED
R809: 10k 1%; R_0402_1005Metric; MPN CRCW040210K0FKED
R814: 1.8k 1%; R_0402_1005Metric; MPN RC0402FR-071K8L; LCSC C163481
R825: 150ohm 1% 100ppm MISO source damping; R_0402_1005Metric; MPN CRCW0402150RFKED
U800: ESP32-S3FN8 USB FS host; ESP32_S3FN8_QFN56; MPN ESP32-S3FN8
U801: E22-900MM22S SPI 850-930MHz crystal; Ebyte_E22_900MM22S_10x10_20Pad_DenseRevA_U801; MPN E22-900MM22S; LCSC C5333985
U802: SN74AXC8T245PWR dual-rail radio isolation; RevA_DensePrimary100_PIN50_Flash_U802; MPN SN74AXC8T245PWR; LCSC C882718
U803: FSUSB42UMX USB2 service/OOB ownership mux; FSUSB42_UQFN10_1p4x1p8; MPN FSUSB42UMX; LCSC C11145
U804: Independent1.6s watchdog200msreset; TI_DDF8_TPS3435; MPN TPS3435CAKAGDDFR; LCSC C6339182
U805: OOB UART powered-off-safe dual buffer; TI_DCU8_LVC2G125; MPN SN74LVC2G125DCUR
Y800: 40MHz CL10pF35ohm; Abracon_ABM8_3225_DenseRevA_Y800; MPN ABM8-40.000MHZ-10-D1G-T; LCSC C1986736

Connections:
AON_3V3: C801.1, C802.1, C803.1, C804.1, C805.1, C806.1, C811.1, C813.1, C814.1, C817.1, C985.1, R800.1, R801.1, R803.1, R804.1, R807.1, R812.1, U800.2 (VDD3P3), U800.3 (VDD3P3), U800.20 (VDD3P3_RTC), U800.46 (VDD3P3_CPU), U800.55 (VDDA), U800.56 (VDDA), U802.1 (VCCA), U802.2 (DIR1), U802.11 (DIR2), U803.9 (VCC), U804.8 (VDD), U805.8 (VCC); also elsewhere on the board
AON_PG: U804.2 (MR); also elsewhere on the board
GND: C800.2, C801.2, C802.2, C803.2, C804.2, C805.2, C806.2, C807.2, C808.2, C809.2, C810.2, C811.2, C812.2, C813.2, C814.2, C815.2, C816.2, C817.2, C985.2, J800.1, J801.2 (Ext), R808.2, R809.2, R811.2, U800.57 (GND/EP), U801.2 (GND), U801.7 (GND), U801.16 (GND), U802.12 (GND), U802.13 (GND), U802.14 (B8), U803.3 (GND), U804.1 (SET0), U804.4 (GND), U804.5 (SET1), U805.1 (1OE_N), U805.4 (GND), U805.7 (2OE_N), Y800.2, Y800.4; also elsewhere on the board
MODEM_USB_ISOLATED_DN: U803.2 (D-); also elsewhere on the board
MODEM_USB_ISOLATED_DP: U803.1 (D+); also elsewhere on the board
OOB_915_ANT: J801.1 (In), U801.6 (ANT)
OOB_ADC_AUX12: U800.9 (GPIO4); also elsewhere on the board
OOB_ADC_MODEM_CURRENT: U800.14 (GPIO9); also elsewhere on the board
OOB_ADC_MODEM_VCC: U800.10 (GPIO5); also elsewhere on the board
OOB_ADC_POE12: U800.7 (GPIO2); also elsewhere on the board
OOB_ADC_V12: U800.6 (GPIO1); also elsewhere on the board
OOB_BOOT_N: J800.5, R801.2, U800.5 (GPIO0)
OOB_EN: C800.1, J800.6, R800.2, R814.2, U800.4 (CHIP_PU); also elsewhere on the board
OOB_I2C_SCL: U800.42 (GPIO37); also elsewhere on the board
OOB_I2C_SDA: U800.19 (GPIO14); also elsewhere on the board
OOB_MODEM_OFF: U800.23 (GPIO17); also elsewhere on the board
OOB_MODEM_RESET: U800.12 (GPIO7); also elsewhere on the board
OOB_MODEM_STOP: U800.13 (GPIO8); also elsewhere on the board
OOB_RADIO_3V3: C809.1, C810.1, C812.1, R805.1, R806.1, U801.1 (VCC), U802.23 (VCCB), U802.24 (VCCB); also elsewhere on the board
OOB_RADIO_BUSY: U801.11 (BUSY), U802.16 (B6)
OOB_RADIO_BUSY_MCU: U800.22 (GPIO16/XTAL_32K_N), U802.8 (A6)
OOB_RADIO_DIO1: U801.20 (DIO1), U802.15 (B7)
OOB_RADIO_DIO1_MCU: U800.21 (GPIO15/XTAL_32K_P); also elsewhere on the board
OOB_RADIO_DIO1_MCU_DRV: U802.9 (A7); also elsewhere on the board
OOB_RADIO_FAULT_N: U800.43 (GPIO38); also elsewhere on the board
OOB_RADIO_IO_DISABLE: R804.2, U802.22 (OE#); also elsewhere on the board
OOB_RADIO_MISO: U801.12 (MISO), U802.17 (B5)
OOB_RADIO_MISO_DRV: R825.2, U802.7 (A5)
OOB_RADIO_MISO_MCU: R825.1, U800.18 (GPIO13)
OOB_RADIO_MOSI: U801.13 (MOSI), U802.21 (B1)
OOB_RADIO_MOSI_MCU: U800.16 (GPIO11), U802.3 (A1)
OOB_RADIO_NRESET: R806.2, U801.3 (NRST); also elsewhere on the board
OOB_RADIO_NSS: R805.2, U801.14 (NSS), U802.19 (B3)
OOB_RADIO_NSS_MCU: U800.15 (GPIO10), U802.5 (A3)
OOB_RADIO_RESET_ASSERT: U800.51 (GPIO45); also elsewhere on the board
OOB_RADIO_RUN: U800.47 (GPIO41/MTDI); also elsewhere on the board
OOB_RADIO_RXEN: U801.10 (RXEN), U802.18 (B4)
OOB_RADIO_RXEN_MCU: U800.52 (GPIO46), U802.6 (A4); also elsewhere on the board
OOB_RADIO_SCK: U801.15 (SCK); also elsewhere on the board
OOB_RADIO_SCK_DRV: U802.20 (B2); also elsewhere on the board
OOB_RADIO_SCK_MCU: U802.4 (A2); also elsewhere on the board
OOB_RADIO_SCK_MCU_DRV: U800.17 (GPIO12); also elsewhere on the board
OOB_RADIO_TXEN: U801.9 (TXEN), U801.19 (DIO2)
OOB_UART_RXD: U800.50 (GPIO44/U0RXD), U805.6 (1Y)
OOB_UART_RX_HEADER: J800.4, R812.2, U805.2 (1A)
OOB_UART_TXD: U800.49 (GPIO43/U0TXD), U805.5 (2A)
OOB_UART_TX_BUFFERED: R802.1, U805.3 (2Y)
OOB_UART_TX_HEADER: J800.3, R802.2
OOB_USB_DN: U800.25 (GPIO19/USB_D-), U803.6 (HSD2-)
OOB_USB_DP: U800.26 (GPIO20/USB_D+), U803.7 (HSD2+)
OOB_USB_EXT_VALID: U800.36 (GPIO48/SPICLK_N); also elsewhere on the board
OOB_USB_MUX_DISABLE: R807.2, U803.8 (OE_N); also elsewhere on the board
OOB_USB_MUX_SELECT: R808.1, U803.10 (SEL); also elsewhere on the board
OOB_USB_SELECT_INTERNAL: R809.1, U800.27 (GPIO21); also elsewhere on the board
OOB_VDD_SPI: C807.1, C808.1, U800.29 (VDD_SPI)
OOB_WATCHDOG_WDI: R811.1, U800.37 (GPIO47/SPICLK_P), U804.3 (WDI)
OOB_WD_ENABLE: J800.7, R803.2, U804.6 (WD_EN)
OOB_WD_RESET_N: R814.1, U804.7 (WDO)
OOB_XTAL_N: C815.1, U800.53 (XTAL_N), Y800.1
OOB_XTAL_P: L800.1, U800.54 (XTAL_P)
OOB_XTAL_P_FILTER: C816.1, L800.2, Y800.3
USB_PROTECT_DN: U803.4 (HSD1-); also elsewhere on the board
USB_PROTECT_DP: U803.5 (HSD1+); also elsewhere on the board

Notes on the sheet:
OOB controller, US915 radio and recovery interface

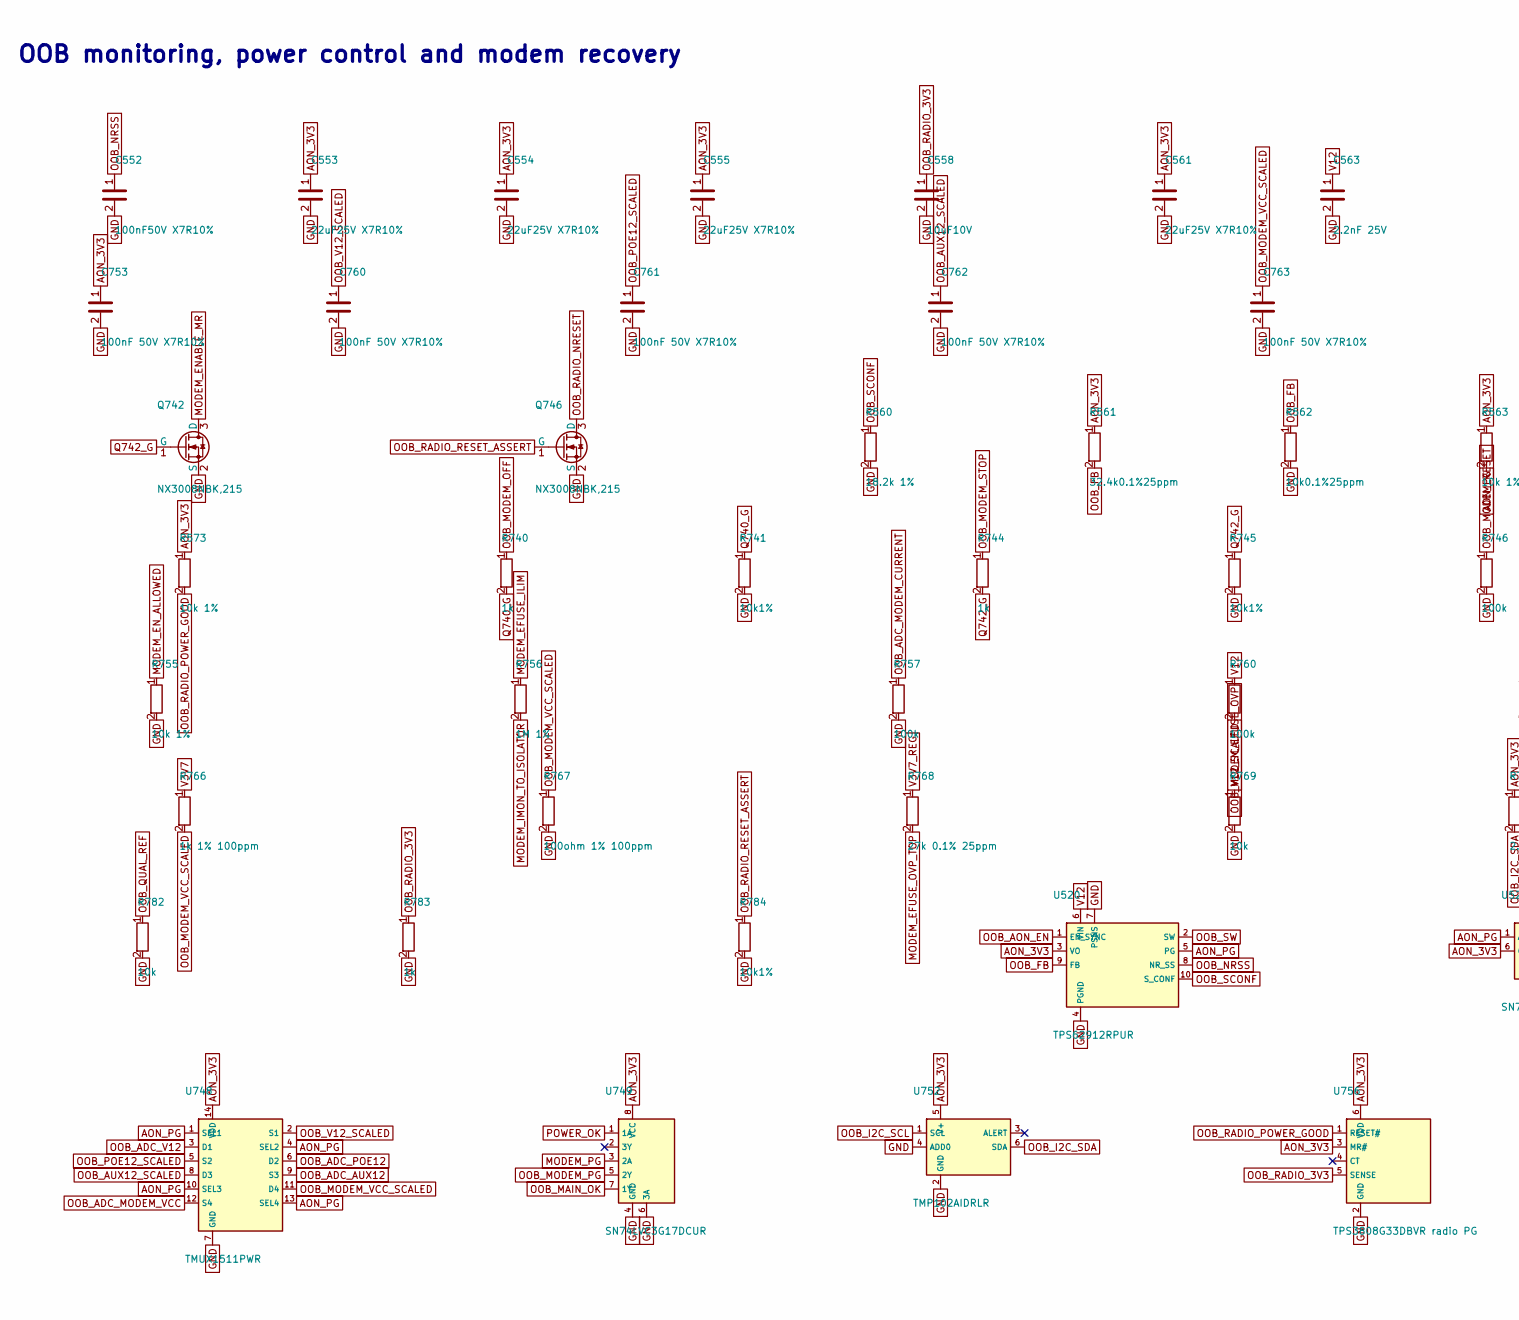
[picture p48: schematic oob-management.kicad_sch, OOB monitoring, power control and modem recovery, part in row 1, column 1]

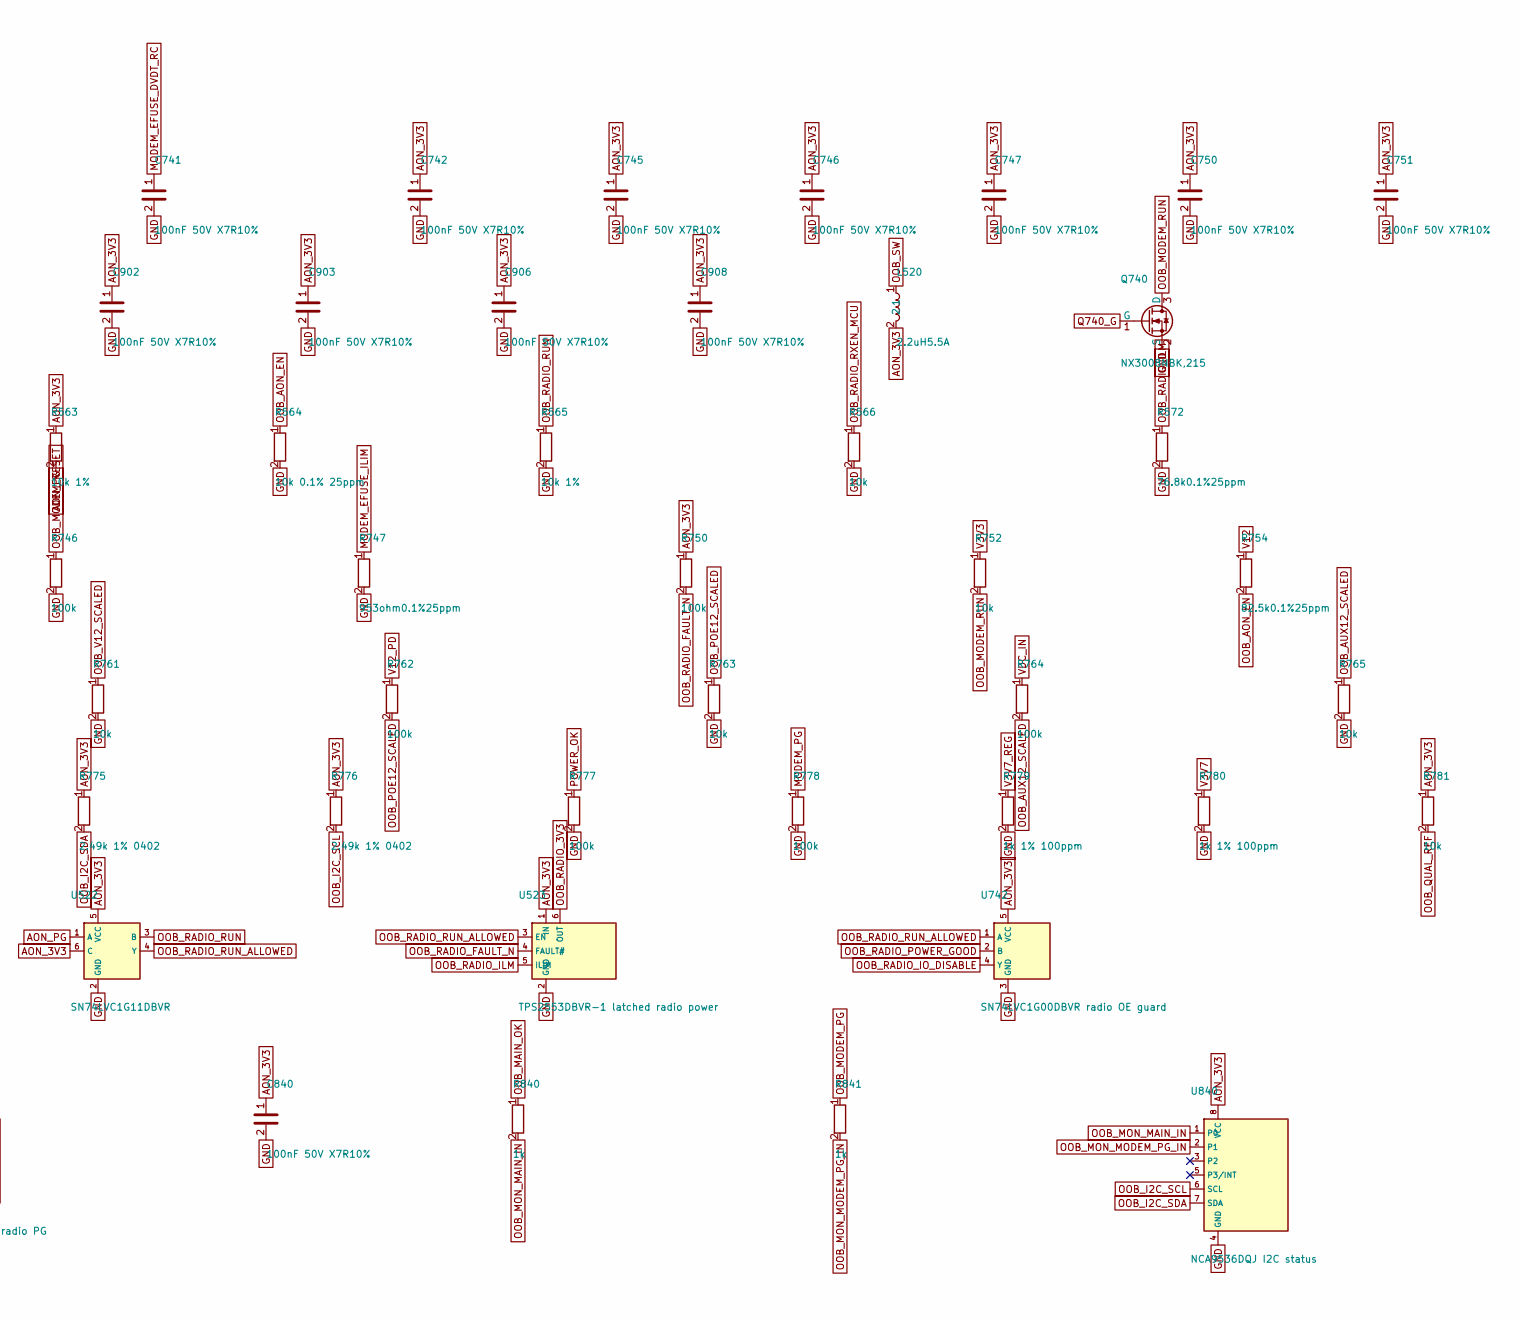
[picture p49: schematic oob-management.kicad_sch, OOB monitoring, power control and modem recovery, part in row 1, column 2]

Parts:
C552: 100nF50V X7R10%; C_0402_1005Metric; MPN CL05B104KB5NNNC; LCSC C960916
C553, C554, C555, C561: 22uF25V X7R10%; C_1210_3225Metric; MPN CL32B226KAJNNNE; LCSC C309062
C558: 10uF10V; C_0805_2012Metric; MPN 885012207026
C563: 2.2nF 25V; C_0402_1005Metric; MPN GRM155R71E222KA01D
C741, C742, C745, C746, C747, C750, C751, C753, C760, C761, C762, C763, C840, C902, C903, C906, C908: 100nF 50V X7R10%; C_0402_1005Metric; MPN CL05B104KB5NNNC; LCSC C960916
L520: 2.2uH5.5A; L_Bourns_SRP5030T; MPN SRP5030TA-2R2M
Q740, Q742: NX3008NBK,215; SOT-23; MPN NX3008NBK,215
Q746: NX3008NBK,215; SOT-23_DenseRevA_Q746; MPN NX3008NBK,215
R560: 18.2k 1%; R_0603_1608Metric; MPN RC0603FR-0718K2L
R561: 32.4k0.1%25ppm; R_0603_1608Metric; MPN RT0603BRD0732K4L; LCSC C861323
R562: 10k0.1%25ppm; R_0603_1608Metric; MPN RT0603BRD0710KL
R563, R573: 10k 1%; R_0603_1608Metric; MPN RC0603FR-0710KL
R564: 10k 0.1% 25ppm; R_0402_1005Metric; MPN TNPW040210K0BEED
R565, R755: 10k 1%; R_0402_1005Metric; MPN CRCW040210K0FKED
R566, R752: 10k; R_0402_1005Metric; MPN CRCW040210K0FKED
R572: 76.8k0.1%25ppm; R_0402_1005Metric; MPN RT0402BRD0776K8L; LCSC C852913
R740, R744, R783, R840, R841: 1k; R_0402_1005Metric; MPN CRCW04021K00FKED
R741, R745: 10k1%; R_0402_1005Metric; MPN CRCW040210K0FKED
R746, R750, R757, R777, R778: 100k; R_0402_1005Metric; MPN CRCW0402100KFKED
R747: 953ohm0.1%25ppm; RevA_Dense100_50_R747; MPN RT0603BRD07953RL
R754: 82.5k0.1%25ppm; R_0402_1005Metric; MPN RT0402BRD0782K5L
R756: 1M 1%; R_0402_1005Metric; MPN CRCW04021M00FKED
R760, R762, R764: 100k; R_0402_1005Metric; MPN TNPW0402100KBEED
R761, R763, R765, R781, R782: 10k; R_0402_1005Metric; MPN TNPW040210K0BEED
R766, R780: 1k 1% 100ppm; R_0402_1005Metric; MPN CRCW04021K00FKED
R767: 100ohm 1% 100ppm; R_0402_1005Metric; MPN CRCW0402100RFKED
R768: 27k 0.1% 25ppm; RevA_Dense100_50_R768; MPN RT0603BRD0727KL
R769: 10k; RevA_Dense100_50_R769; MPN TNPW040210K0BEED
R775, R776: 2.49k 1% 0402; R_0402_1005Metric; MPN CRCW04022K49FKED
R779: 1k 1% 100ppm; RevA_Dense100_50_R779; MPN CRCW04021K00FKED
R784: 10k1%; R_0402_1005Metric_DenseRevA_R784; MPN CRCW040210K0FKED
U520: TPS62912RPUR; TI_RPU0010A_TPS62912; MPN TPS62912RPUR
U522: SN74LVC1G11DBVR; SOT-23-6; MPN SN74LVC1G11DBVR
U523: TPS2553DBVR-1 latched radio power; SOT-23-6; MPN TPS2553DBVR-1; LCSC C111738
U742: SN74LVC1G00DBVR radio OE guard; SOT-23-5; MPN SN74LVC1G00DBVR
U748: TMUX1511PWR; TSSOP-14_4.4x5mm_P0.65mm; MPN TMUX1511PWR
U749: SN74LVC3G17DCUR; TI_DCU8_LVC3G17; MPN SN74LVC3G17DCUR
U752: TMP102AIDRLR; SOT563_TMP102; MPN TMP102AIDRLR
U756: TPS3808G33DBVR radio PG; SOT-23-6; MPN TPS3808G33DBVR; LCSC C43698
U840: NCA9536DQJ I2C status; Nexperia_SOT505_3_Primary; MPN NCA9536DQJ

Connections:
AON_3V3: C553.1, C554.1, C555.1, C561.1, C742.1, C745.1, C746.1, C747.1, C750.1, C751.1, C753.1, C840.1, C902.1, C903.1, C906.1, C908.1, L520.2, R561.1, R563.1, R573.1, R750.1, R775.1, R776.1, R781.1, U520.3 (VO), U522.5 (VCC), U522.6 (C), U523.1 (IN), U742.5 (VCC), U748.14 (VDD), U749.8 (VCC), U752.5 (V+), U756.3 (MR#), U756.6 (VDD), U840.8 (VCC); also elsewhere on the board
AON_PG: R563.2, U520.5 (PG), U522.1 (A), U748.1 (SEL1), U748.4 (SEL2), U748.10 (SEL3), U748.13 (SEL4); also elsewhere on the board
GND: C552.2, C553.2, C554.2, C555.2, C558.2, C561.2, C563.2, C741.2, C742.2, C745.2, C746.2, C747.2, C750.2, C751.2, C753.2, C760.2, C761.2, C762.2, C763.2, C840.2, C902.2, C903.2, C906.2, C908.2, Q740.2 (S), Q742.2 (S), Q746.2 (S), R560.2, R562.2, R564.2, R565.2, R566.2, R572.2, R741.2, R745.2, R746.2, R747.2, R755.2, R757.2, R761.2, R763.2, R765.2, R767.2, R769.2, R777.2, R778.2, R779.2, R780.2, R782.2, R783.2, R784.2, U520.4 (PGND), U520.7 (PSNS), U522.2 (GND), U523.2 (GND), U742.3 (GND), U748.7 (GND), U749.4 (GND), U749.6 (3A), U752.2 (GND), U752.4 (ADD0), U756.2 (GND), U840.4 (GND); also elsewhere on the board
MODEM_EFUSE_DVDT_RC: C741.1; also elsewhere on the board
MODEM_EFUSE_ILIM: R747.1, R756.1; also elsewhere on the board
MODEM_EFUSE_OVP: R769.1; also elsewhere on the board
MODEM_EFUSE_OVP_TOP: R768.2; also elsewhere on the board
MODEM_ENABLE_MR: Q742.3 (D); also elsewhere on the board
MODEM_EN_ALLOWED: R755.1; also elsewhere on the board
MODEM_IMON_TO_ISOLATOR: R756.2; also elsewhere on the board
MODEM_PG: R778.1, U749.3 (2A); also elsewhere on the board
OOB_ADC_AUX12: U748.9 (S3); also elsewhere on the board
OOB_ADC_MODEM_CURRENT: R757.1; also elsewhere on the board
OOB_ADC_MODEM_VCC: U748.12 (S4); also elsewhere on the board
OOB_ADC_POE12: U748.6 (D2); also elsewhere on the board
OOB_ADC_V12: U748.3 (D1); also elsewhere on the board
OOB_AON_EN: R564.1, R754.2, U520.1 (EN_SYNC)
OOB_AUX12_SCALED: C762.1, R764.2, R765.1, U748.8 (D3)
OOB_FB: R561.2, R562.1, U520.9 (FB)
OOB_I2C_SCL: R776.2, U752.1 (SCL), U840.6 (SCL); also elsewhere on the board
OOB_I2C_SDA: R775.2, U752.6 (SDA), U840.7 (SDA); also elsewhere on the board
OOB_MAIN_OK: R840.1, U749.7 (1Y)
OOB_MODEM_OFF: R740.1; also elsewhere on the board
OOB_MODEM_PG: R841.1, U749.5 (2Y)
OOB_MODEM_RESET: R746.1; also elsewhere on the board
OOB_MODEM_RUN: Q740.3 (D), R752.2; also elsewhere on the board
OOB_MODEM_STOP: R744.1; also elsewhere on the board
OOB_MODEM_VCC_SCALED: C763.1, R766.2, R767.1, U748.11 (D4)
OOB_MON_MAIN_IN: R840.2, U840.1 (P0)
OOB_MON_MODEM_PG_IN: R841.2, U840.2 (P1)
OOB_NRSS: C552.1, U520.8 (NR_SS)
OOB_POE12_SCALED: C761.1, R762.2, R763.1, U748.5 (S2)
OOB_QUAL_REF: R781.2, R782.1; also elsewhere on the board
OOB_RADIO_3V3: C558.1, R783.1, U523.6 (OUT), U756.5 (SENSE); also elsewhere on the board
OOB_RADIO_FAULT_N: R750.2, U523.4 (FAULT#); also elsewhere on the board
OOB_RADIO_ILM: R572.1, U523.5 (ILIM)
OOB_RADIO_IO_DISABLE: U742.4 (Y); also elsewhere on the board
OOB_RADIO_NRESET: Q746.3 (D); also elsewhere on the board
OOB_RADIO_POWER_GOOD: R573.2, U742.2 (B), U756.1 (RESET#)
OOB_RADIO_RESET_ASSERT: Q746.1 (G), R784.1; also elsewhere on the board
OOB_RADIO_RUN: R565.1, U522.3 (B); also elsewhere on the board
OOB_RADIO_RUN_ALLOWED: U522.4 (Y), U523.3 (EN), U742.1 (A)
OOB_RADIO_RXEN_MCU: R566.1; also elsewhere on the board
OOB_SCONF: R560.1, U520.10 (S_CONF)
OOB_SW: L520.1, U520.2 (SW)
OOB_V12_SCALED: C760.1, R760.2, R761.1, U748.2 (S1)
POWER_OK: R777.1, U749.1 (1A); also elsewhere on the board
Q740_G: Q740.1 (G), R740.2, R741.1
Q742_G: Q742.1 (G), R744.2, R745.1
V3V3: R752.1; also elsewhere on the board
V3V7: R766.1, R780.1; also elsewhere on the board
V3V7_REG: R768.1, R779.1; also elsewhere on the board
V12: C563.1, R754.1, R760.1, U520.6 (VIN); also elsewhere on the board
V12_PD: R762.1; also elsewhere on the board
VDC_IN: R764.1; also elsewhere on the board

Notes on the sheet:
OOB monitoring, power control and modem recovery

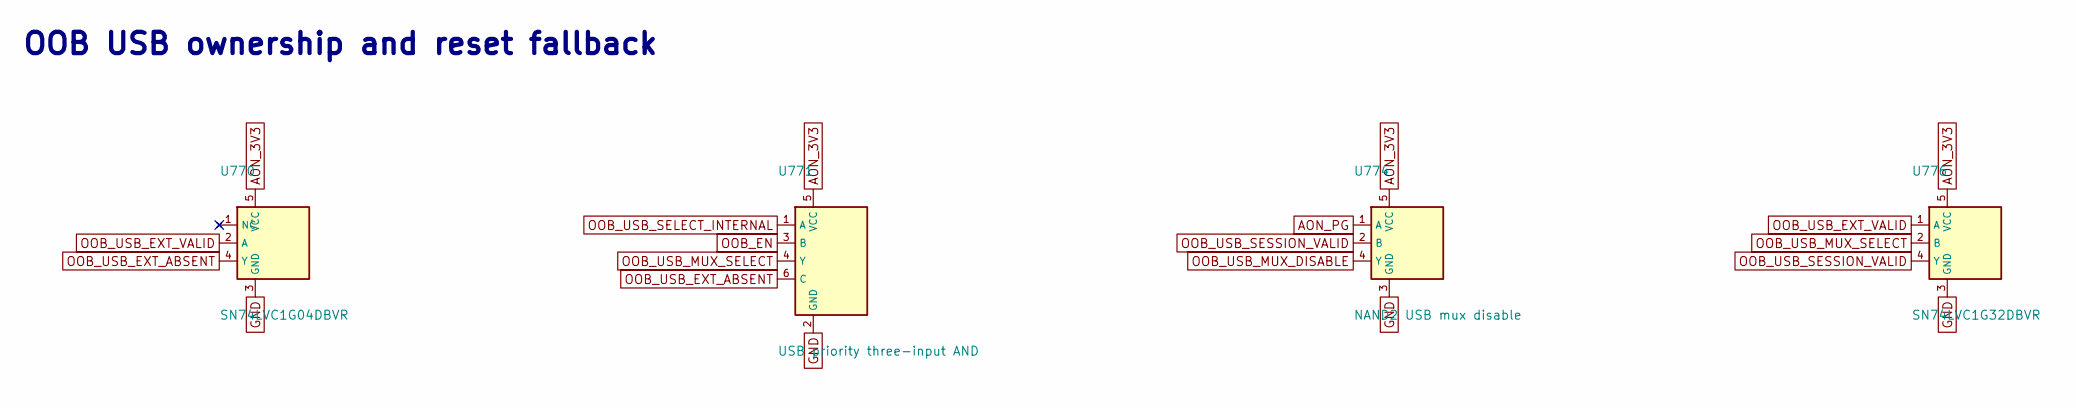
[picture p50: schematic oob-usb-ownership.kicad_sch, OOB USB ownership and reset fallback]

Parts:
U770: SN74LVC1G04DBVR; SOT-23-5; MPN SN74LVC1G04DBVR
U771: USB priority three-input AND; SOT-23-6; MPN SN74LVC1G11DBVR
U774: NAND2 USB mux disable; SOT-23-5; MPN SN74LVC1G00DBVR; LCSC C7826
U776: SN74LVC1G32DBVR; SOT-23-5; MPN SN74LVC1G32DBVR

Connections:
AON_3V3: U770.5 (VCC), U771.5 (VCC), U774.5 (VCC), U776.5 (VCC); also elsewhere on the board
AON_PG: U774.1 (A); also elsewhere on the board
GND: U770.3 (GND), U771.2 (GND), U774.3 (GND), U776.3 (GND); also elsewhere on the board
OOB_EN: U771.3 (B); also elsewhere on the board
OOB_USB_EXT_ABSENT: U770.4 (Y), U771.6 (C)
OOB_USB_EXT_VALID: U770.2 (A), U776.1 (A); also elsewhere on the board
OOB_USB_MUX_DISABLE: U774.4 (Y); also elsewhere on the board
OOB_USB_MUX_SELECT: U771.4 (Y), U776.2 (B); also elsewhere on the board
OOB_USB_SELECT_INTERNAL: U771.1 (A); also elsewhere on the board
OOB_USB_SESSION_VALID: U774.2 (B), U776.4 (Y); also elsewhere on the board

Notes on the sheet:
OOB USB ownership and reset fallback

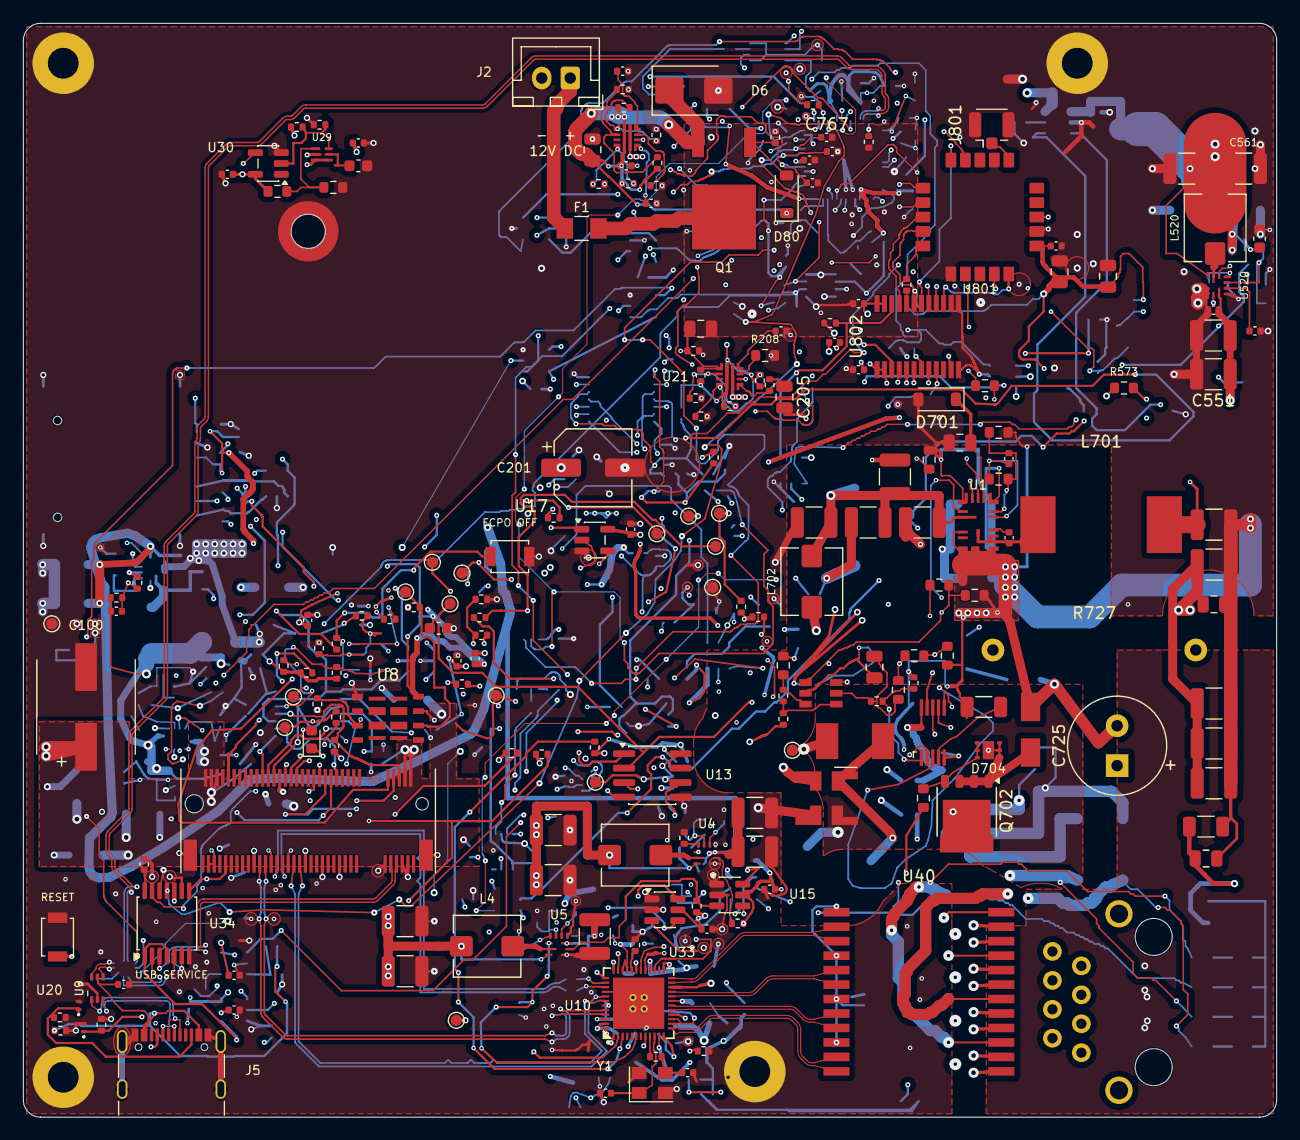
[picture p51: board carrier.kicad_pcb from above]

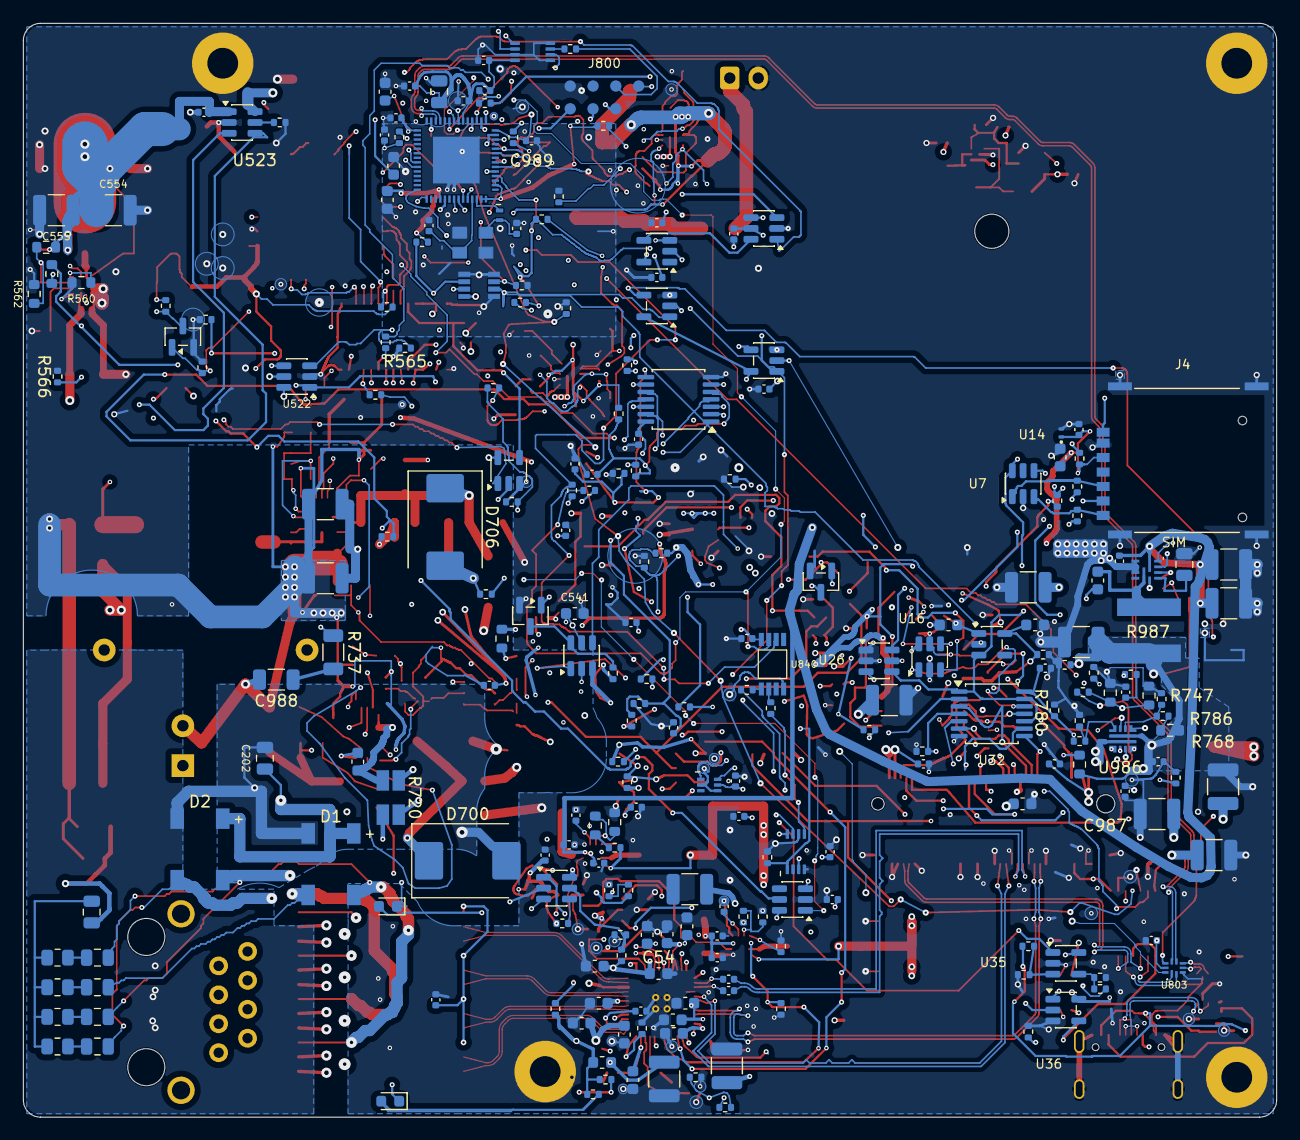
[picture p52: board carrier.kicad_pcb from below]

Board: 6 copper layers, 110.0 x 96.0 mm, 444 parts (234 on the bottom side), 269 nets.
