ripclap/rm520n-carrier/(notices)

Notices in the files:
hardware/assembly-preview/models/ded342cdb394fb45-ded342cdb394fb45-ded342cdb394fb45-ded342cdb394fb45-ded342cdb394fb45-ded342cdb394fb45-ded342cdb394fb45-R_0805_2012Metric.step:
Copyright (C) 2018, kicad StepUp
This work is licensed under the [Creative Commons CC-BY-SA 4.0 License](https://creativecommons.org/licenses/by-sa/4.0/legalcode),
with the following exception:
To the extent that the creation of electronic designs that use 'Licensed Material' can be considered to be 'Adapted Material',
You are free to use the library data in your own projects without the obligation to share your project files under this or any other license agreement.
hardware/assembly-preview/models/03e44c4b2b727b8d-03e44c4b2b727b8d-03e44c4b2b727b8d-03e44c4b2b727b8d-03e44c4b2b727b8d-03e44c4b2b727b8d-03e44c4b2b727b8d-C_0402_1005Metric.step:
Copyright (C) 2017, kicad StepUp
hardware/assembly-preview/models/30dab4c2e22239b7-30dab4c2e22239b7-30dab4c2e22239b7-30dab4c2e22239b7-30dab4c2e22239b7-30dab4c2e22239b7-30dab4c2e22239b7-D_SMC.step:
This program is free software: you can redistribute it and/or modify
it under the terms of the GNU General Public License as published by
the Free Software Foundation, either version 3 of the License, or
any later version.
itself might be covered by the GNU General Public License.
hardware/assembly-preview/models/c9fe686b4d1b5692-c9fe686b4d1b5692-c9fe686b4d1b5692-c9fe686b4d1b5692-c9fe686b4d1b5692-c9fe686b4d1b5692-c9fe686b4d1b5692-SOT-23-6.step:
Copyright (C) 2025, KiCAD
This work is licensed under the
[Creative Commons CC-BY-SA 4.0 License](https://creativecommons.org/licenses/by-sa/4.0/legalcode),
project files under this or any other license agreement. However, if you wish to distribute
hardware/assembly-preview/models/37b74fdce2fc6bc4-37b74fdce2fc6bc4-LFPAK56.step:
Copyright (C) 2023, Ray Benitez
